acrux-yueyao/Mycelium/design/portfolio/photos/p8-gallery.webp

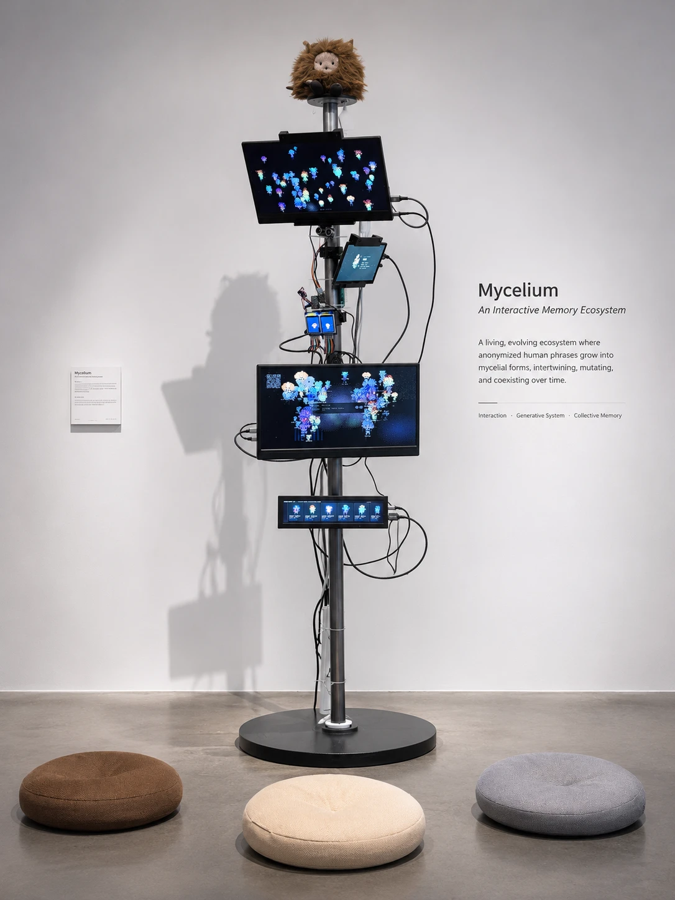
design/portfolio/photos/p8-gallery.webp
