acrux-yueyao/Mycelium/design/portfolio/photos/p7-board.jpg

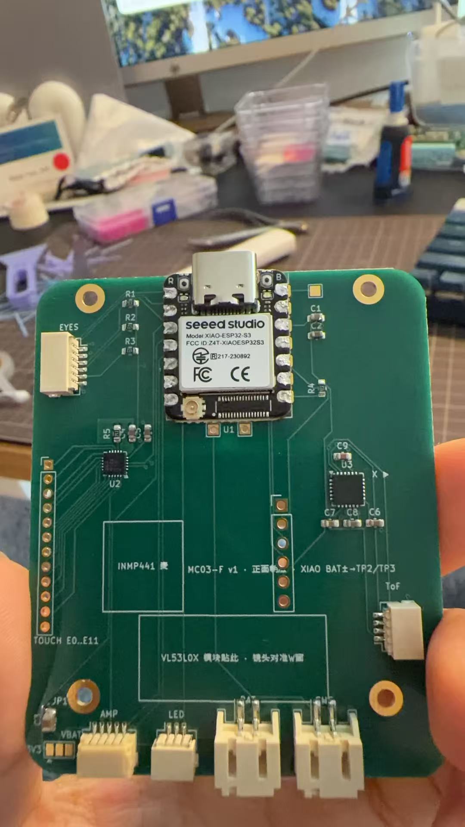
design/portfolio/photos/p7-board.jpg
