acrux-yueyao/Mycelium/hardware/TOUCH.md

# 触摸方块 · 怎么做、怎么装

> **实物是网页孢子的镜像。** 方块模型的轴是(x, 前, 上)左手系,打印出来的每颗方块把“前”朝你、“上”朝上时,刻 S 的面在你**左手**边。
> 所以**拼装时站在机器人背后**(脸朝远处),这时刻 S 的面朝你的右手/远处/上,刻 N 朝左手/近处/下,和逐层图一致。
> 从收纳盘拿方块:抬起远离你的那一边,把它向你翻 90° 立起来,左右不变。
> 麦克风孔 M 因此取在舱区第 4 列(网页坐标),实物落在面对机器人时的左边,正对脸板上 x=−12 的麦克风框。

触摸点由 `touch_plan.py` 按身体部位自动选格、自动找隐藏走线;`touch_cubes.py` 把走线经过的
每颗方块出成**两件式**零件。所有零件的磁铁袋、销钉、刻字与原方块相同,拼好后和普通方块一样,
拼装序号也不变——**拿到同序号的位置替换即可**。

## 1 · 三种零件

| 件 | 长什么样 | 做什么 |
|---|---|---|
| **Tlid 触摸盖** | 12×12×1.2 的薄片,外面是触摸面(光面) | 内侧贴铜箔,铜箔就是电极 |
| **Tbody 触摸身** | 10.8 高,中间 6.6×6.6 的腔朝盖那面开口;腔到出线面有 1 mm 宽的槽(侧面出线)或 Ø1.2 的孔(背面出线) | 腔里走线,盖合上后线从槽里出去 |
| **LA / LB 线槽半块** | 一颗方块从中间剖成两半,LA 的剖面上刻一圈 1 mm 槽,槽到每个进出线面有支槽;走剖面方向的线用角上的 Ø1.2 孔 | 线放进槽,两半合上 |

线用 **0.3 mm 漆包线**(QA 自粘漆包线更好,烙铁一烫就通),一条槽能并排放三根。

## 2 · 装一颗触摸块

1. 剪一块约 6×6 mm 的铜箔(自带胶的),贴在**盖的内侧**正中。
2. 漆包线一头烫掉漆皮,焊在铜箔上(或用导电胶/压在铜箔胶下),留 2 mm 焊点别凸起。
3. 线从腔里顺着槽走出出线面;出线面在 `fix_manifest.txt` 每行都写了(例:`出线-z/后`)。
4. 盖的四边涂一圈薄 CA 胶,合到身上,对齐边缘按 10 秒。盖是哪一面:`fix_manifest.txt` 写了“盖=触摸面 +z/前”这种。
5. 磁铁按盘面图照常装(盖上没有磁铁袋,袋都在身上)。

## 3 · 装一颗线槽块

1. 看 `fix_manifest.txt`:`线进出 -x/左/+x/右` = 线从左面进、右面出;`剖面垂直于上轴` = 两半是上下叠。
2. 线沿着 LA 剖面上的槽从进线面走到出线面;要经过角上的孔时,从孔穿到另一面。
3. 剖面涂 CA 胶(避开槽),LB 合上,对齐四边。
4. 侧面的磁铁袋是被剖成两个半圆的,**合上以后再装磁铁**。极性照盘面图,两个半块的图上都标了同一颗袋。

## 4 · 走线顺序(moony)

`touch_plan.png` 是全图,`fix_manifest.txt` 是清单。要点:
- 拼身体时按正常序号拼,遇到线槽块/触摸块先把线穿好、胶合、装磁铁,再放到位。
- 线的另一头一路走到机身空腔,接到脸板 J7 的对应焊盘(E0–E11 = 触摸点编号顺序,见 `touch_plan.json`)。
- 头部的线(头顶、伞盖左右缘、额头)共用一条主干进空腔,线上贴个纸标签写编号。
- 背后(触摸点 10)不用方块:铜箔贴在背板内侧上半部,线直接到 J7。

## 5 · 重打清单(moony v6)

`fix_manifest.txt` 列了全部 38 件,按耗材分盘:9 颗触摸块(18 件)、8 颗线槽块(16 件)、
4 颗 ToF/麦克风换位置的方块。盘面图 `fix_<色号>_<色名>_1_sheet.png` 和以前一样读:粗体序号、
右上件名、圆和边块是**这一件上**的磁铁袋极性。

打印:全部平放,剖面/盖面朝下,不需要支撑。槽和孔都在贴床那一面,象腿补偿照旧 0.1。

## 6 · 固件侧

MPR121 的 12 路在脸板 J7 上;IRQ 没接,固件按 50 Hz 轮询 `0x00/0x01` 触摸状态寄存器。
每个电极隔着 1.2 mm PLA,灵敏度用寄存器 `0x41–0x5A` 的触发/释放阈值调(先试 12/6)。
