acrux-yueyao/Mycelium/design/portfolio/Mycelium_Portfolio_EN.pdf

M Y C E L I U M · P O R T F O L I O · 2 0 2 4 — ∞

Try it | Research ▸ (https://mycelium.yueyao.design/research) | Case study ▸ (https://mycelium.yueyao.design/case) | Design system ▸ (https://mycelium.yueyao.design/board)

A L I V I N G A R C H I V E O F A N O N Y M O U S F E E L I N G · 低 语 菌 网

# Mycelium

## whisper a sentence — a creature grows from how it feels

An anonymous whisper is read by a language model and grown
into a one-of-a-kind pixel spore, then let loose in a shared colony where everyone's feelings meet and slowly rub off on each other. The same sentence always grows the same spore.

ember drift
TENDER

calm bell
CALM

sunny crumb
CURIOUS

moony moth
DREAMY

mint pip
COMPANION

quiet wisp
LONELY

P R O B L E M
Young adults in
transition are easy to
reach online but often
feel disconnected.
Platforms surface
content, not how a
group actually feels.

A P P R O A C H
Turn anonymous
disclosure into a
living ecology: input →
AI reading → morphology
→ social simulation →
shared field.

C O N T R I B U T I O N
A way to feel present
with others without
talking — connection
shown as colour
exchange, care built in
as an ecological rule,
identity fixed as
deterministic form.

R O L E & S T A T U S
Concept, design & full-stack build · deployed
web prototype ·
formative evaluation in
progress.

# ✳ Why “Mycelium”

The whole thing borrows from mycorrhizal networks — the underground web of fungal threads (the mycelium) that links the trees of a forest, sometimes called the “wood-wide web.” Through it, trees quietly trade sugar and nutrients, pass chemical signals, and older mother trees keep seedlings alive. It's connection that is slow, shared, and out of sight — the opposite of a feed. Below is the real network it's named after — every claim cited:

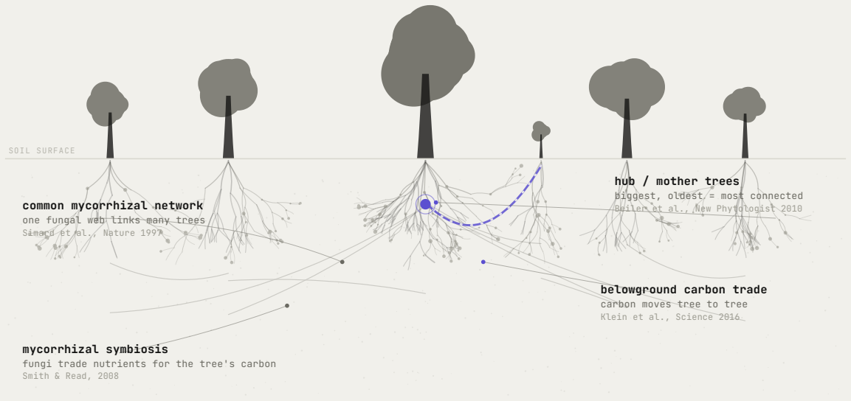
[picture p10: figure]
SOIL SURFACE; common mycorrhizal network one fungal web links many trees Simard et al., Nature 1997; hub / mother trees biggest, oldest = most connected Beiler et al., New Phytologist 2010; belowground carbon trade carbon moves tree to tree Klein et al., Science 2016; mycorrhizal symbiosis; Smith & Read, 2008

fungi trade nutrients for the tree's carbon

Real mycorrhizal science, cited: Simard et al., Nature 388:579 (1997) (https://www.nature.com/articles/41557) · Klein, Siegwolf & Körner, Science 352:342 (2016) (https://www.science.org/doi/10.1126/science.aad6188) · Beiler et al., New Phytologist 185:543 (2010) (https://nph.onlinelibrary.wiley.com/doi/10.1111/j.1469-8137.2009.03069.x) · Smith & Read, Mycorrhizal Symbiosis (2008).

MYCELIUM The Whisper Network · Portfolio · Yue Yao | 1 / 7

Read the forest as a community and the biology stops being about trees. A community is a place where what you have is quietly shared — the surplus of one becomes another's survival, the oldest hold up the youngest, and none of it has to be announced to count.

I N A F O R E S T | I N A C O M M U N I T Y
fungi trade nutrients for the tree's carbon | members sustain each other — no score kept
carbon flows from surplus to deficit | the ones who have more carry the ones who don't
mother trees keep the seedlings alive | you're held by the ones who came before
slow, shared, out of sight | belonging is felt, never performed

That feeling — being quietly held by a group you never had to perform for — is exactly what loneliness is the absence of. It's what Mycelium tries to hand back: a place to be present with others without a single word of explanation.

01 Try it — grow a spore right here | 02 What it is
| It isn't a mood diary, an AI companion, or a feed. It's a small shared world where private feelings stick around as living creatures. Everything here is procedural — no drawn sprites, no image model. The reading of a sentence seeds a deterministic random stream, and that stream decides the creature's outline, palette, sharpness and behaviour. So an anonymous feeling turns into something you can name, claim, share and come back to, without ever attaching who you are. whisper one sentence anonymous · text or voice

read

AI interprets

emotion labels ·
intensity ·
morphology

grow

a pixel spore

deterministic ·
unique

meet

the colony

bonds shown as
colour exchange

stay

it accumulates

a cross-visitor
emotional ecology

M Y C E L I U M · T R E E H O L E 树 洞 — T Y P E A N Y T H I N G , I N A N Y L A N G U A G E

today, my heart feels like a quiet lake after rain grow ▸

# Misty Pudding

S P E C I M E N

emotion | calm · 平静
intensity | 0.79
hue | H 220°
determinism | same sentence → same spore

This preview reads your sentence into one of the six families with a lightweight offline heuristic (keyword + hash) and shows that family's real specimen — the same pixels the live colony grows. In the deployed product, Claude reads the sentence into 18 emotion labels, intensity and six morphology parameters, and grows the exact, unique creature. Grow your own on the live site ▸ (https://yueyao.design/)

# 03 The deployed experience

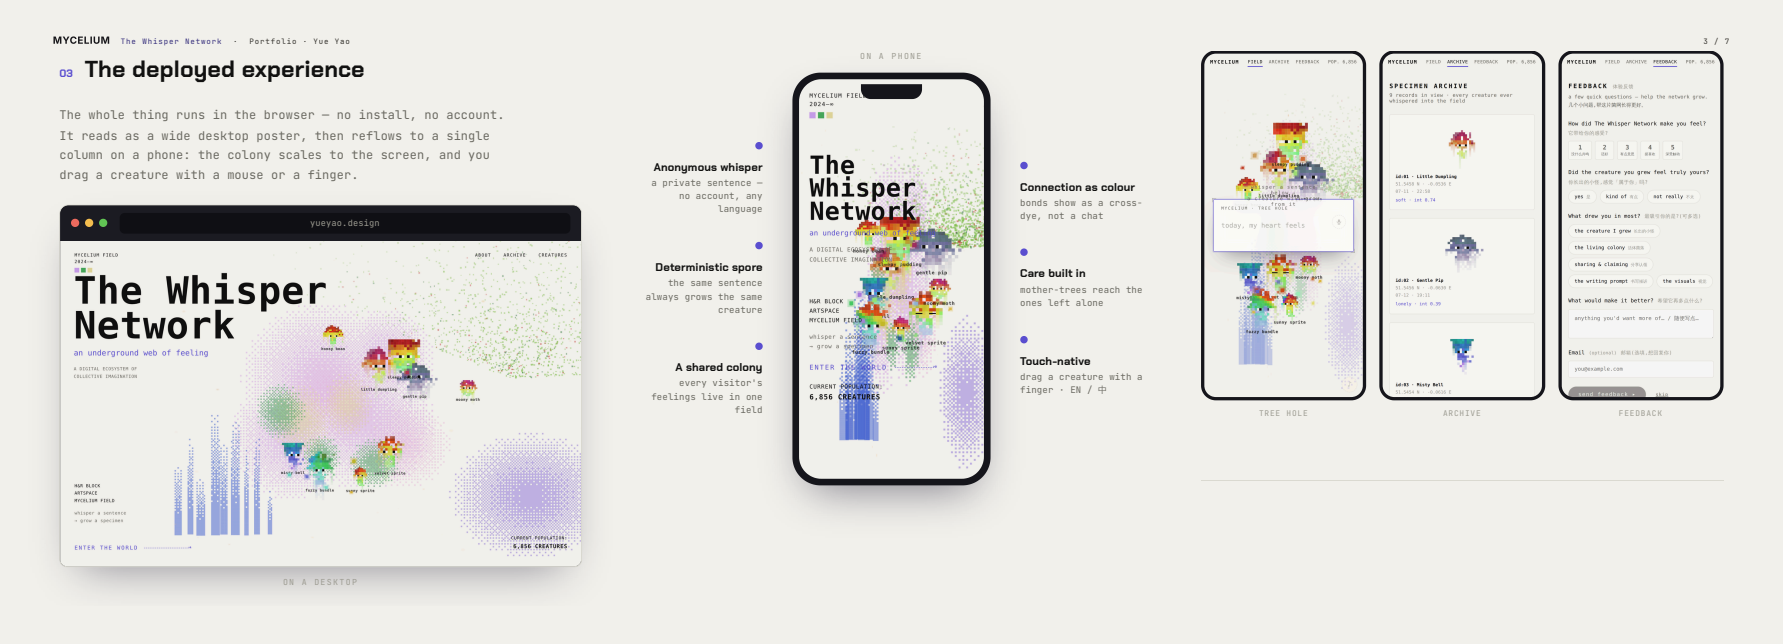
[picture p11: page 3]
yueyao.design; Anonymous whisper; a private sentence —; no account,; any; language; creature; A shared colony; every visitor's; feelings live in; one; field; TREE HOLE; ARCHIVE; FEEDBACK

The whole thing runs in the browser — no install, no account.
It reads as a wide desktop poster, then reflows to a single
column on a phone: the colony scales to the screen, and you
drag a creature with a mouse or a finger.

Connection as colour
bonds show as a cross-
dye, not a chat

Deterministic spore
the same sentence
always grows the same

Care built in
mother-trees reach the
ones left alone

Touch-native
drag a creature with a
finger · EN / 中

# 04 Emotion becomes form

Every whisper is read into one of six emotion families, each with its own base hue. Then the reading bends the form: intensity widens the palette from near-monochrome to rainbow, density sets how solid it is, agitation sets the jitter, and a second emotion blends in one accent. Same sentence, same creature — but no two feelings land the same.

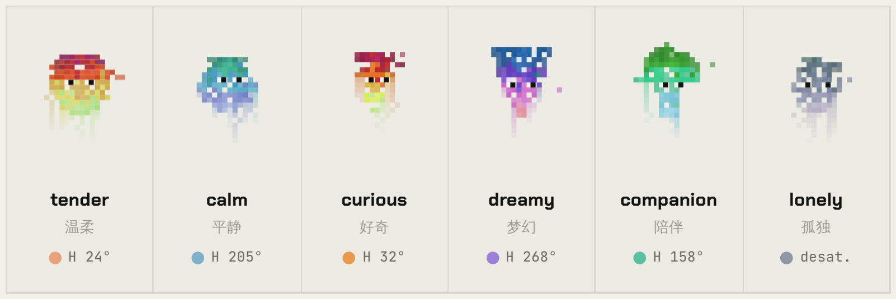
[picture p12: figure]
tender; calm; curious; dreamy; companion; lonely; desat.
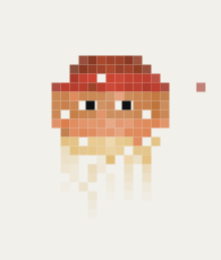
[picture p13: figure]

low
near-monochrome

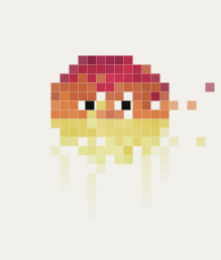
[picture p14: figure]

mid
a few accents

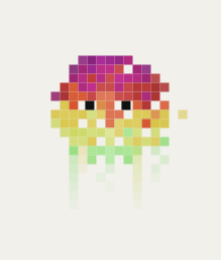
[picture p15: figure]

high
full rainbow
intensity → palette width | density → solid vs. wispy | agitation → jitter & drift

2nd emotion → one accent hue

# 05 How the creatures evolved

They didn't start as pixels. The first build shipped six illustrated species — soft watercolour fungi — plus fifteen hand-drawn hybrid forms. It was lovely, and it read wrong: with a fixed image library, two very different sentences could wear the same body. Emotion had become a label that picks a sticker.

radial
v1 ·
illustration

fixed sprite

bubble
v1 ·
illustration

fixed sprite

mushroom
v1 ·
illustration

fixed sprite

glitter
v1 ·
illustration

fixed sprite

cups
v1 ·
illustration

fixed sprite

shrub
v1 ·
illustration

fixed sprite

hybrid A×B
one of 15, drawn by
hand

hybrid C×E
every pair pre-decided

hybrid D×F
finite by construction

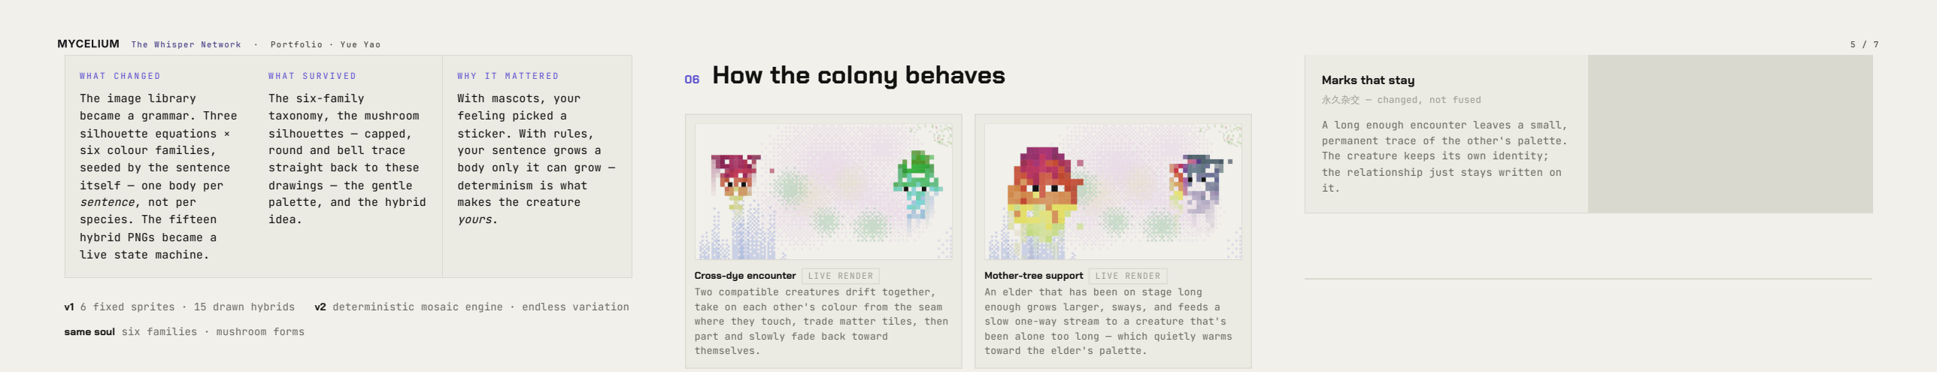
[picture p16: figure]
The image library became a grammar. Three silhouette equations × six colour families, seeded by the sentence itself — one body per sentence, not per species. The fifteen hybrid PNGs became a live state machine.; The six-family taxonomy, the mushroom silhouettes — capped, round and bell trace straight back to these drawings — the gentle palette, and the hybrid idea.; With mascots, your feeling picked a sticker. With rules, your sentence grows a body only it can grow — determinism is what makes the creature yours.; same soul six families · mushroom forms; 06 How the colony behaves; Cross-dye encounter; LIVE RENDER; part and slowly fade back toward themselves.; Mother-tree support; An elder that has been on stage long enough grows larger, sways, and feeds a; toward the elder's palette.; Marks that stay; 永久杂交 — changed, not fused; A long enough encounter leaves a small, permanent trace of the other's palette. The creature keeps its own identity; the relationship just stays written on it.

v1 6 fixed sprites · 15 drawn hybrids v2 deterministic mosaic engine · endless variation

Two compatible creatures drift together, take on each other's colour from the seam where they touch, trade matter tiles, then

slow one-way stream to a creature that's been alone too long — which quietly warms

Connection as colour

逐格染色 — a tendril in colour, not a line

When two compatible creatures meet, they dye each other starting from where they touch — strongest at the contact seam — and pass small matter tiles back and forth while bonded, breathing in sync.

Mother trees

母树 — care as an ecological rule

A creature that has been around long enough starts supporting an isolated one: it grows visibly larger, sways, flickers, and feeds it a slow one-way stream of matter. Nothing you press sets this off.

# 07 The research behind it

RQ·main — how might anonymous emotional input become a perceivable, evolving collective emotional environment?

RQ2 — expression without public performance

RQ3 — AI as rule generator, not companion

RQ4 — emotion mapped to form, behaviour, relation

It draws on loneliness research (U.S. Surgeon General 2023; Baek et al. 2023), a critique of affective computing, and care-oriented design research (Hirsch). The full framing, methods, ethics and the sourced data sit in the research essay and case study — linked below.

# 08 From screen to substrate

The whisper doesn't have to stop at the screen. In the gallery installation, the colony's pooled emotion drives a living fungus, so the same anonymous sentence sets the growing conditions for a real culture. The software bridge is built
and live; the physical cultivation is specced and staged.
whisper feeds the culture each sentence → one visible feeding pulse: mist + a light pulse in its emotion's hue | /api/pulse aggregate climate dominant mood → grow-light hue · intensity → mist · growth → cadence | chamber a living fungus sealed, HEPA-filtered · food-safe low-spore species | /api/bio the loop closes the fungus's biosignal feeds back — the projected colony breathes with it
D A T A , N O T D E C O R A T I O N population, intensity, dominant family, agitation, loneliness — real aggregates from the live colony set real environment targets. (https://mycelium.yueyao.design/mycelium-poster.pdf) | | H O N E S T & S A F E the projection shows only the emotion reading, never the sentence; biosafety is designed in for a weeks-long gallery run. (https://mycelium.yueyao.design/mycelium-poster.pdf)

# 09 Read the full record

This page is the short version. The deeper documents carry the rest — the research it grew from, the full design-research write-up, the visual system that holds it together, and two printable artifacts.

01 · RESEARCH

### Research & background

前期调研 · 背景故事
The loneliness
research, the platform
critique, and the
sourced data behind the
project — as a
scrollable visual
essay.

open the essay ▸ (https://mycelium.yueyao.design/research)

02 · CASE STUDY

### Design-research case study

完整案例研究 · EN / 中
The full framing,
method, decisions,
ethics, and evaluation
— the long-form account
of how it was made and
why.

open the case study ▸ (https://mycelium.yueyao.design/case)

03 · DESIGN SYSTEM

### The visual language

设计系统板
Colour families, type,
the deterministic spore
grammar, and the motion
rules — the board that
keeps every screen
consistent.

open the board ▸ (https://mycelium.yueyao.design/board)

04 · POSTER

### Research poster, 7 sheets

横版研究海报 · PDF
The whole project on
seven 2160×780
landscape sheets —
background, evidence, (https://mycelium.yueyao.design/mycelium-poster.pdf)

05 · INSTALLATION

### Installation design manuscript

装置设计手稿 · PDF
Five drawing sheets for
the gallery build —
site plan, elevations,
axon cutaway, and the (https://mycelium.yueyao.design/installation-manuscript.pdf)

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
▸ (https://mycelium.yueyao.design/mycelium-poster.pdf)

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
▸ (https://mycelium.yueyao.design/installation-manuscript.pdf)

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
o (https://mycelium.yueyao.design/mycelium-poster.pdf)

r

k (https://mycelium.yueyao.design/installation-manuscript.pdf)

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
b (https://mycelium.yueyao.design/mycelium-poster.pdf)

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
u (https://mycelium.yueyao.design/installation-manuscript.pdf)

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
s (https://mycelium.yueyao.design/mycelium-poster.pdf)

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
. (https://mycelium.yueyao.design/installation-manuscript.pdf)
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
