acrux-yueyao/Mycelium/design/portfolio/Mycelium_Portfolio_ZH.pdf

# ✳ 为什么叫「Mycelium」

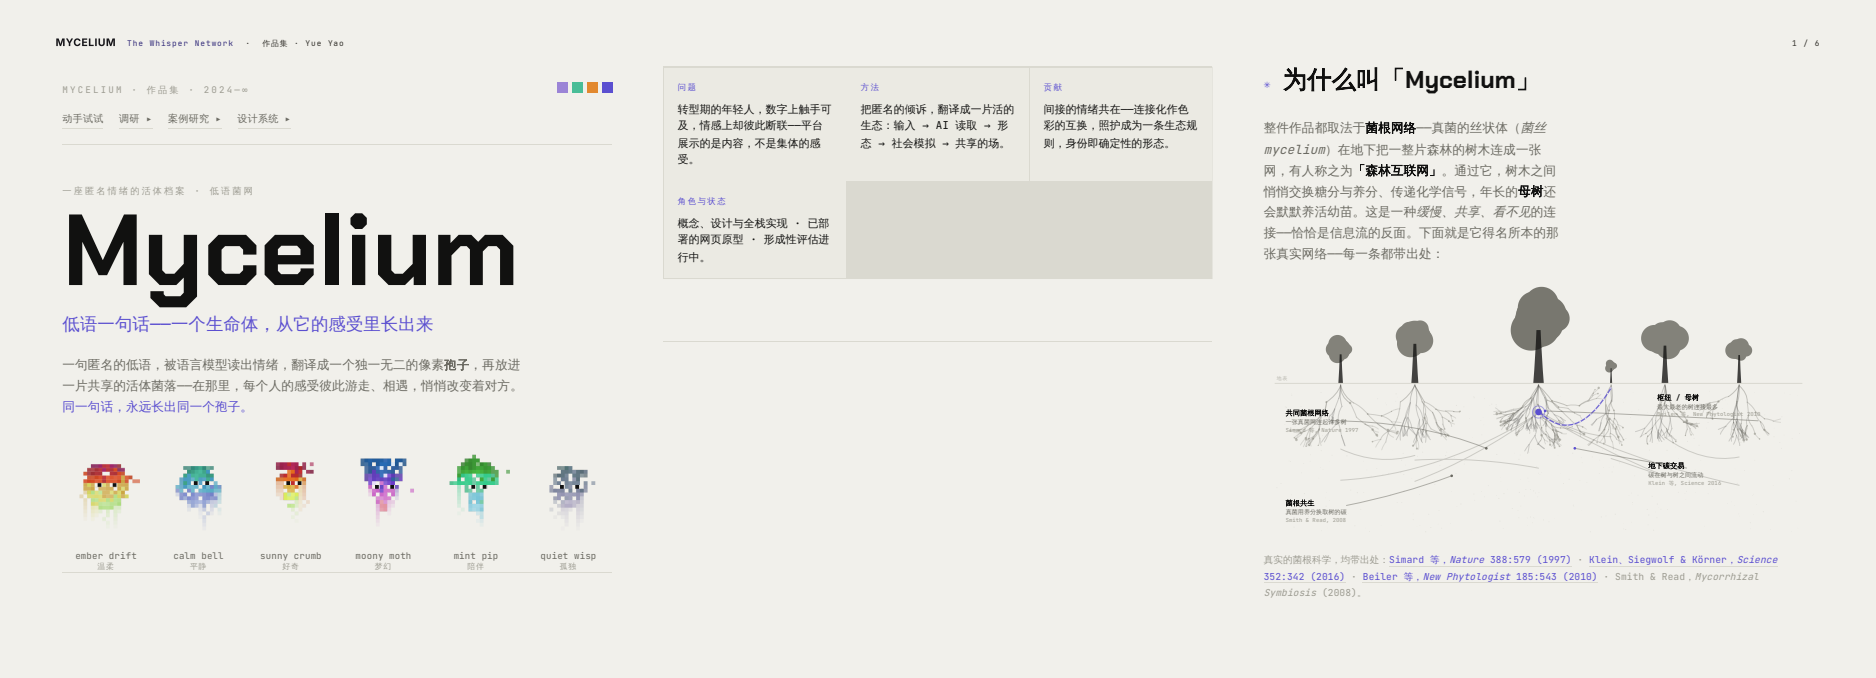
[picture p17: page 1]
动手试试; 案例研究 ▸; 设计系统 ▸; 一 座 匿 名 情 绪 的 活 体 档 案 · 低 语 菌 网 Mycelium; ember drift 温柔; calm bell 平静; sunny crumb 好奇; moony moth 梦幻; mint pip 陪伴; quiet wisp 孤独; 问 题 转型期的年轻人，数字上触手可 及，情感上却彼此断联——平台 展示的是内容，不是集体的感 受。; 贡 献 间接的情绪共在——连接化作色 彩的互换，照护成为一条生态规 则，身份即确定性的形态。; 共同菌根网络 一张真菌网连起许多树 Simard 等, Nature 1997; 地下碳交易 碳在树与树之间流动 Klein 等, Science 2016; 菌根共生 真菌用养分换取树的碳 Smith & Read, 2008; MYCELIUM The Whisper Network · 作品集 · Yue Yao

把匿名的倾诉，翻译成一片活的
态 → 社会模拟 → 共享的场。

整件作品都取法于菌根网络——真菌的丝状体（菌丝
mycelium）在地下把一整片森林的树木连成一张
网，有人称之为「森林互联网」。通过它，树木之间
悄悄交换糖分与养分、传递化学信号，年长的母树还
会默默养活幼苗。这是一种缓慢、共享、看不见的连
接——恰恰是信息流的反面。下面就是它得名所本的那
张真实网络——每一条都带出处：

概念、设计与全栈实现 · 已部
署的网页原型 · 形成性评估进

低语一句话——一个生命体，从它的感受里长出来

一句匿名的低语，被语言模型读出情绪，翻译成一个独一无二的像素孢子，再放进
一片共享的活体菌落——在那里，每个人的感受彼此游走、相遇，悄悄改变着对方。
同一句话，永远长出同一个孢子。

最大最老的树连接最多
Beiler 等, New Phytologist 2010

真实的菌根科学，均带出处：Simard 等，Nature 388:579 (1997) (https://www.nature.com/articles/41557) · Klein、Siegwolf & Körner，Science
352:342 (2016) (https://www.science.org/doi/10.1126/science.aad6188) · Beiler 等，New Phytologist 185:543 (2010) (https://nph.onlinelibrary.wiley.com/doi/10.1111/j.1469-8137.2009.03069.x) · Smith & Read，Mycorrhizal
Symbiosis (2008)。

把森林当作一个共同体来读，这套生物学就不再只是
关于树。共同体，是一个你所拥有的会被悄悄分出去
的地方——一个的盈余，成为另一个的存活；最年长
的，托住最年幼的；而这一切都不必被宣告，才算
数。
在森林里 | 在一个共同体里
真菌用养分交换树的碳 | 成员彼此供养——不计得失
碳从盈余流向匮乏 | 有余的人，托住匮乏的人
母树养活幼苗 | 你被先来的人托住
缓慢、共享、看不见 | 归属是被感到的，从不表演

这种感觉——被一个你从不需要表演的群体悄悄托住——
恰恰是孤独所缺席的。这也正是 Mycelium 想还给 人的：一个不必解释一句，也能与他人同在的地方。
01 试试——在这里长出一个孢子 | 02 它是什么
| 不是心情日记，不是 AI 陪伴，也不是信息流——是一个小小的共享世 界，私人的感受在这里以活的生命体留存下来。
| 你看到的一切都是程序生成的：没有手绘素材，没有图像模型。一句话的读数，播下一 条确定性的随机流，长出轮廓、配色、清晰度和行为——于是一份匿名的感受，变成你 可以命名、认领、分享、回访的东西，却从不需要附上你是谁。

低语
一句话

匿名 · 文字或语音

读取
AI 解读

情绪标签 · 强度 · 形
态

生长
一个像素孢子

确定性 · 独一无二

相遇
遇见菌落

结伴以色彩互换呈现

留存
不断累积

一片跨访客的情绪生态

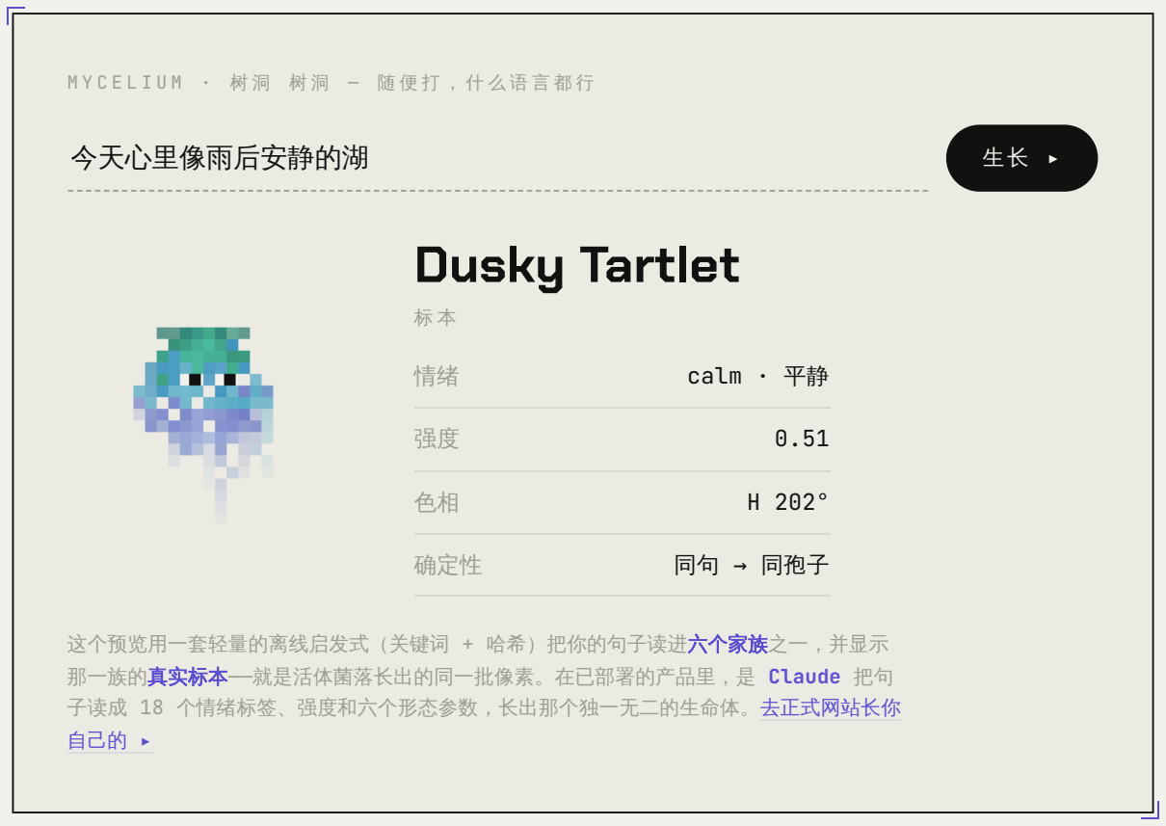
[picture p18: figure]
今天心里像雨后安静的湖; Dusky Tartlet; calm · 平静; 确定性; 同句 → 同孢子; 这个预览用一套轻量的离线启发式（关键词 + 哈希）把你的句子读进六个家族之一，并显示 那一族的真实标本——就是活体菌落长出的同一批像素。在已部署的产品里，是 Claude 把句 子读成 18 个情绪标签、强度和六个形态参数，长出那个独一无二的生命体。去正式网站长你 自己的 ▸

M Y C E L I U M · 树 洞 树 洞 — 随 便 打 ， 什 么 语 言 都 行

## 03 已部署的体验

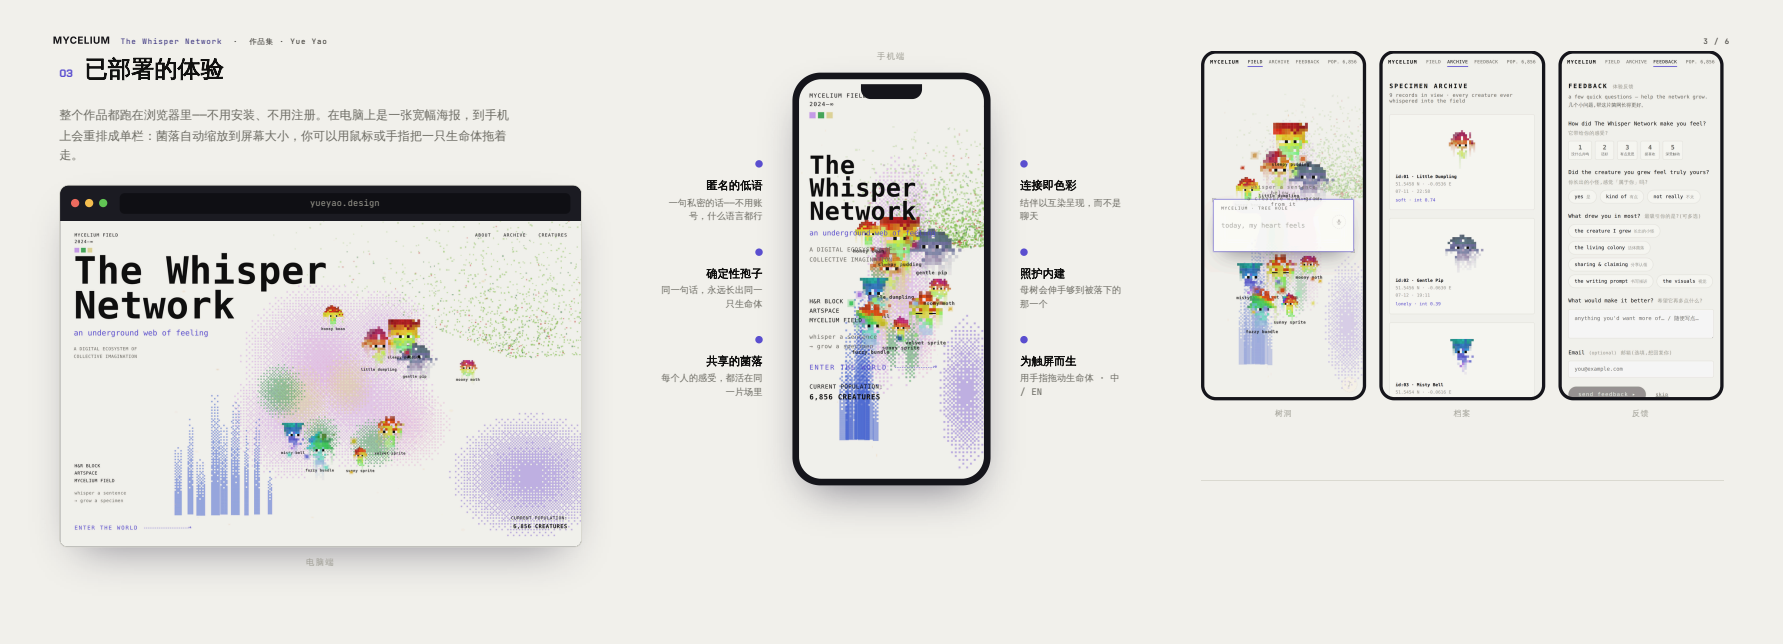
[picture p19: page 3]
yueyao.design; 电脑端; 手机端; 匿名的低语 一句私密的话——不用账 号，什么语言都行; 确定性孢子 同一句话，永远长出同一 只生命体; 共享的菌落; 每个人的感受，都活在同 一片场里; 连接即色彩; 结伴以互染呈现，而不是 聊天; 照护内建 母树会伸手够到被落下的 那一个; 为触屏而生 用手指拖动生命体 · 中 / EN

整个作品都跑在浏览器里——不用安装、不用注册。在电脑上是一张宽幅海报，到手机
上会重排成单栏：菌落自动缩放到屏幕大小，你可以用鼠标或手指把一只生命体拖着

## 04 情绪化作形态

每一句低语，都被读进六个情绪家族之一，各有自己
的基准色相。随后读数再去掰弯形态：强度把配色从
近乎单色拉宽到彩虹，密度决定它有多实，躁动决定

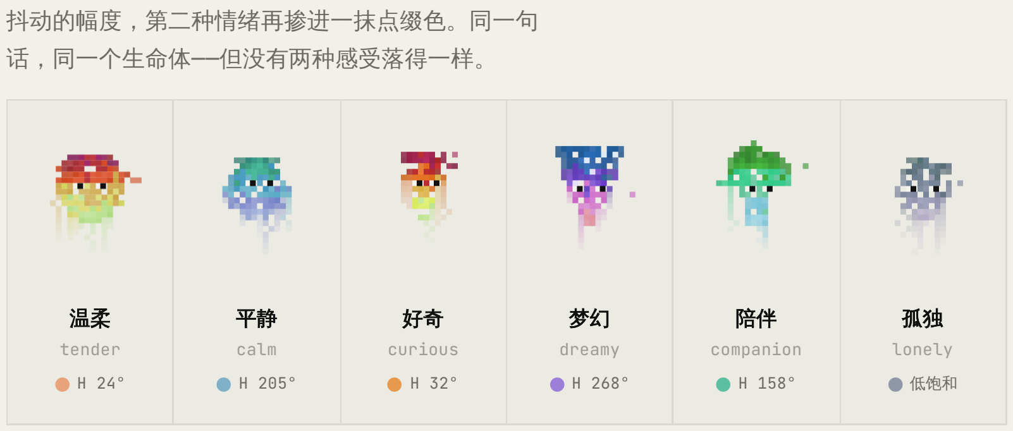
[picture p20: figure]
抖动的幅度，第二种情绪再掺进一抹点缀色。同一句 话，同一个生命体——但没有两种感受落得一样。; tender; calm; curious; dreamy; companion; lonely; 低饱和
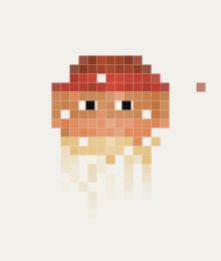
[picture p21: figure]

低
近乎单色

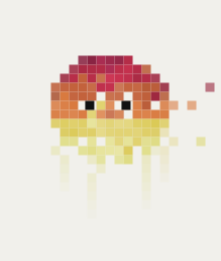
[picture p22: figure]

中
几笔点缀

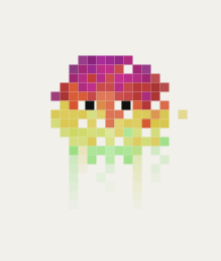
[picture p23: figure]

高
整片彩虹
强度 → 配色宽度 | 密度 → 实心 / 稀薄 | 躁动 → 抖动与游走 | 第二情绪 → 一抹点缀色

### 05 生命体的演化

它们并不是一开始就长成像素的。第一版上线的是六
个手绘物种——柔软的水彩真菌——外加十五张预先画好
的杂交形态。它很好看，但读起来是错的：素材库是
固定的，两句完全不同的话可能穿着同一副身体。情
绪变成了一个用来挑贴纸的标签。

radial
v1 · 手绘
固定素材

bubble
v1 · 手绘
固定素材

mushroom
v1 · 手绘
固定素材

glitter
v1 · 手绘
固定素材

cups
v1 · 手绘
固定素材

shrub
v1 · 手绘
固定素材

杂交 A×B
十五张之一，逐张手绘

杂交 C×E
每一对都预先决定

杂交 D×F
数量天生有限

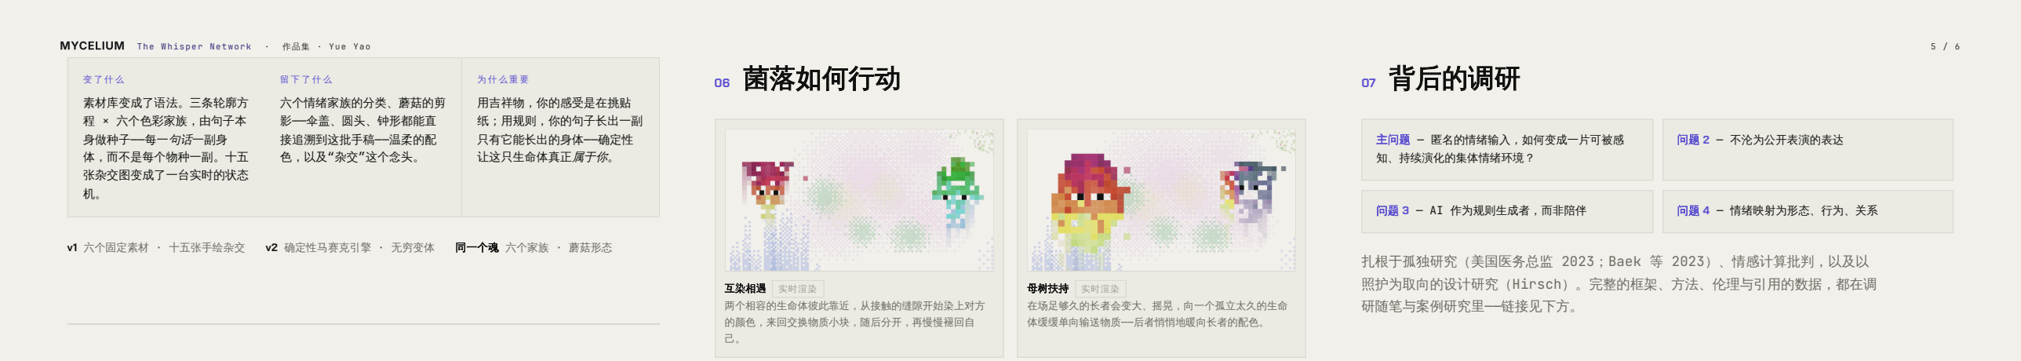
[picture p24: figure]
变 了 什 么 素材库变成了语法。三条轮廓方 程 × 六个色彩家族，由句子本 身做种子——每一句话一副身 体，而不是每个物种一副。十五 张杂交图变成了一台实时的状态 机。; 留 下 了 什 么 六个情绪家族的分类、蘑菇的剪 影——伞盖、圆头、钟形都能直 接追溯到这批手稿——温柔的配 色，以及“杂交”这个念头。; 为 什 么 重 要 用吉祥物，你的感受是在挑贴 纸；用规则，你的句子长出一副 只有它能长出的身体——确定性 让这只生命体真正属于你。; 06 菌落如何行动; 互染相遇; 实时渲染; 两个相容的生命体彼此靠近，从接触的缝隙开始染上对方 的颜色，来回交换物质小块，随后分开，再慢慢褪回自 己。; 母树扶持; 在场足够久的长者会变大、摇晃，向一个孤立太久的生命 体缓缓单向输送物质——后者悄悄地暖向长者的配色。; 07 背后的调研; 主问题 — 匿名的情绪输入，如何变成一片可被感 知、持续演化的集体情绪环境？; 问题 2 — 不沦为公开表演的表达; 研随笔与案例研究里——链接见下方。

v1 六个固定素材 · 十五张手绘杂交 | v2 确定性马赛克引擎 · 无穷变体 | 同一个魂 六个家族 · 蘑菇形态
连接即色彩 逐格染色 ——用颜色长出的触手，不是一根线 相容的生命体相遇，从接触缝开始彼此染色——触点处 最浓——结伴时来回交换小块物质，还同步呼吸。 | 母树 母树 ——照护作为一条生态规则 一个正在扶持孤立者的长者，会明显变大、摇晃、闪 烁——并向它单向地缓缓输送物质。没有哪个按钮能触 发照护。

留下的痕迹 永久杂交 ——被改变，而非被融合 一场长久的相遇，留下对方配色的一小块永久痕迹。 身份始终存续；关系被记在身上。

问题 3 — AI 作为规则生成者，而非陪伴 | 问题 4 — 情绪映射为形态、行为、关系

扎根于孤独研究（美国医务总监 2023；Baek 等 2023）、情感计算批判，以及以 照护为取向的设计研究（Hirsch）。完整的框架、方法、伦理与引用的数据，都在调

## 08 从屏幕，到基质

低语不必止于屏幕。在画廊装置里，菌落聚合出的情绪，驱动一团活的真菌——同一句 匿名的话，成为一团真实培养的生长条件。软件桥已构建并上线；实体培养已规格化、 分阶段推进。

低语 喂养培养 每句话 → 一次可见的投 喂脉冲：一口雾 + 一道 该情绪色相的灯光 | /api/pulse 聚合气候 主导情绪 → 生长灯色相 · 强度 → 雾化 · 增长 → 节律 | 培养舱 一团活真菌 密封、HEPA 过滤 · 食 品级低孢子菌种 | /api/bio 回路闭合 真菌的生物信号回传——投 影的菌落随它一起呼吸
是 数 据 ， 不 是 装 饰 人口、强度、主导家族、躁动、孤独——来自活体菌 落的真实聚合，设定真实的环境目标。 | | 诚 实 且 安 全 投影只显示情绪读数，绝不显示原句；生物安全为 数周展期从头设计。

## 09 读完整的记录

这一页是精简版。剩下的都在更深的文档里——它生长自的调研、完整的设计研究记 述、把一切串起来的视觉系统，以及两份可打印的成品。

01 · 调研
前期调研与背景

Research & background
孤独研究、平台批判，以及项
目背后引用的真实数据——做成
一篇可滚动的视觉随笔。

打开随笔 ▸ (https://mycelium.yueyao.design/research-zh)

02 · 案例研究
设计研究案例
完整案例 · EN / 中
完整的框架、方法、决策、伦
理与评估——它如何被做出来、
为什么这样做的长篇记述。

打开案例研究 ▸ (https://mycelium.yueyao.design/case-zh)

03 · 设计系统
视觉语言
设计系统板
配色家族、字体、确定性的孢
子语法，以及动效规则——让每
一屏都保持一致的那块板。

打开设计板 ▸ (https://mycelium.yueyao.design/board-zh)

04 · 海报
横版研究海报 · 七页

Research poster · PDF
整个项目排在七张 2160×780
的横版页上——背景、数据、系
统、生命体、评估——用的就是
网站自己的视觉语言。

下载 PDF ▸ (https://mycelium.yueyao.design/mycelium-poster.pdf)

05 · 装置
装置设计手稿

Installation manuscript ·
PDF
画给展场搭建的五张图纸——平
面、立面、轴测剖切，以及那
间与菌落一同呼吸的活体培养
舱。

下载 PDF ▸ (https://mycelium.yueyao.design/installation-manuscript.pdf)

MYCELIUM · 低语菌网

概念 · 设计 · 全栈实现 — React · canvas 2D · Claude · Edge · Redis。 同一句话，永远长出同一个孢子。
本页每一个标本，都由产品自己的引擎渲染——就是活体菌落长出的同一批像素。
