acrux-yueyao/Mycelium/design/market/Mycelium_纸质问卷.pdf

留下这段经历 LEAVE AN ACCOUNT | 表号 No.

如果你此刻很难受——这张问卷不是求助渠道。请联系你所在地的心理支持热线或校园咨询服务；有紧急危险请拨打当地急救电话。 你写下的内容不会被用来判断你。 美国：拨打或短信 988（危机热线）· 紧急情况：911 · 其他地区：findahelpline.com
If you are struggling right now — this form is not a help channel. Please contact a local support line or campus counseling service; in an emergency, call your local emergency number. Nothing you write here will be used to judge you. In the US: call or text 988 · emergency: 911 · elsewhere: findahelpline.com

这件作品，在你身上留下了什么？ What did this work leave with you?

不用总结好不好——写下它让你想起什么、感到什么、动摇了什么，或者你带走了什么。慢慢写，写一半也没关系。
No need to judge whether it was good. Write what it brought to mind, what you felt, what it unsettled, or what you took away. Take your time; a half-written entry is fine.

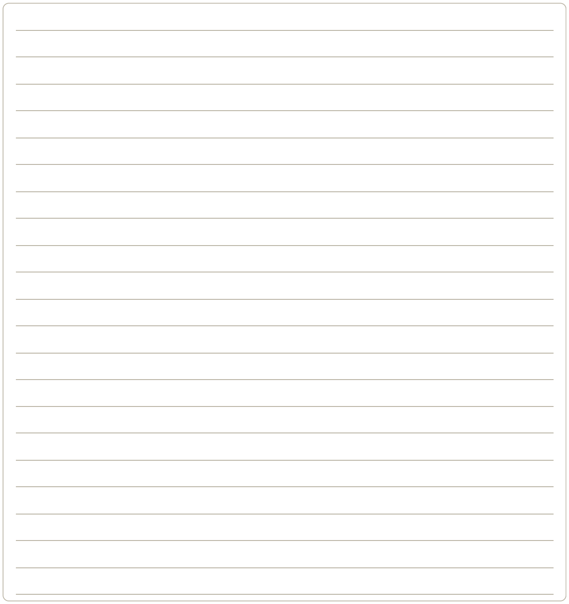
[picture p27: figure]

背面还有几个小问题 · please turn over ▸

写完这一刻，感觉怎么样？ How do you feel right now? 表号 No.

不是评价作品——是此刻你自己的状态。凭直觉圈一个数字。
Not a rating of the work — your own state at this moment. Go with your first instinct: circle one number.

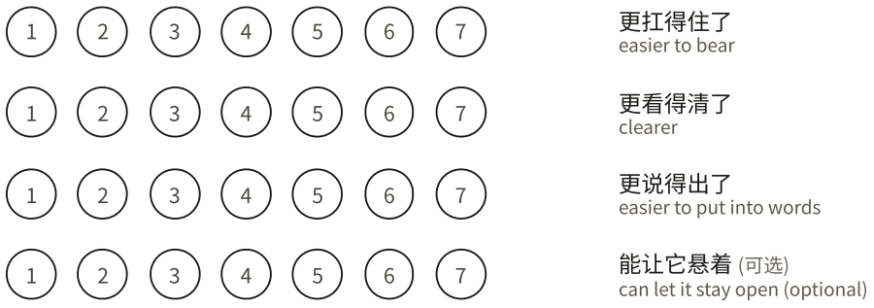
[picture p28: figure]
更扛得住了; easier to bear; 更看得清了; clearer; 更说得出了; easier to put into words; 能让它悬着 (可选); can let it stay open (optional)

更难受了
harder to bear

更糊涂了
more confused

更说不出
harder to put into words

想把它推开
want to push it away

昵称（可选） Nickname (optional)

年龄段（可选） Your age (optional) | 18–29 | 30 及以上 30+ | 不想说 prefer not to say
你正处在一段人生过渡中吗？（可选） In a life transition? (optional) | 是 yes | 否 no | 说不清 hard to say

我已年满 18 岁。
I am 18 or older.

我同意把这段经历作为匿名研究语料使用。纸质问卷不需要写名字；我可以凭下面剪下的小票上的表号，随时写信至 nikkiyao814@gmail.com 要求删除这份记录。参与完全自愿，且须年满 18 岁。这段文字可能被研究者阅读与编码，用于 理解交互作品如何承接观众。
I agree that this account may be used as anonymous research material. No name is needed on this paper form; I can ask for it to be deleted at any time by writing to nikkiyao814@gmail.com with the form number on the slip below. Participation is voluntary and open to those 18 or over. The text may be read and coded by researchers to understand how interactive works accompany their audiences.

两个方框都勾上，这份问卷才会被收录。写完请交给摊位的工作人员，或投进问卷箱。
Both boxes need a tick for the form to be kept. Hand it to the booth or drop it in the box.

### 你的小票 · keep this slip

想删除这份问卷，写信到 nikkiyao814@gmail.com，附上右边的表号就行。
To have your form deleted, write to nikkiyao814@gmail.com with the number on the right.

工作人员：发问卷前在两页的「表号」和小票上写同一个编号。· staff: write the same number on both pages and here.

表号 No.

✂
