acrux-yueyao/Mycelium/design/market/ACRUX-Intermedia-Brochure.pdf

S E R V I C E S — C O N C E P T T O O P E N I N G N I G H T

# Commissions

We take on a small number of commissions at a time and build them end-to-end. If it needs to exist and doesn't yet, that's our department.

A Interactive Installation — sensors, screens, projection, sound, custom software, built to survive an exhibition run.

B Exhibition Design — layout, wayfinding, lighting logic, and the interactive layer that ties a room together.

C Generative & Real-time Visuals — particle systems, simulations, data-driven scenes at 60fps.

D Creative Technology Consulting — feasibility studies, prototyping sprints, honest answers about what can be built.

01 — INQUIRY
The occasion, space,
timeline, budget. A
paragraph is enough.

02 — SCOPING
A call, then a concept +
feasibility doc with a
fixed quote.

03 — BUILD
Prototype first, always.
You see it running early
and often.

04 — INSTALL
On-site install,
calibration,
documentation. We stay
through opening night.

S I G N A L — W E A N S W E R

# Contact

For commissions, exhibitions, press, or anything between media —

## hello@acruxintermedia.com

WORKS · STUDIO
acruxintermedia.com

ELSEWHERE
principal yueyao.design
instagram @acrux.yue
github github.com/acrux-yueyao

ACRUX INTERMEDIA STUDIO LLC BOSTON, MASSACHUSETTS — EST. 2026 α CRUCIS — RA 12h 26m 35s · DEC −63° 05′ 56″

# ACRUX

# INTERMEDIA

### A studio for works that fall between

media.

We build strange, functional artifacts — deities you can summon, bureaucracies run by machines, rooms that whisper — and navigate by them.

EST. 2026 — BOSTON, MA
