acrux-yueyao/Mycelium/design/market/Hyphal-Column-Poster-EN.pdf

BU ART MARKET
YUE YAO · 2026
SKY | MICRO | FIELD | ARCHIVE

# Hyphal

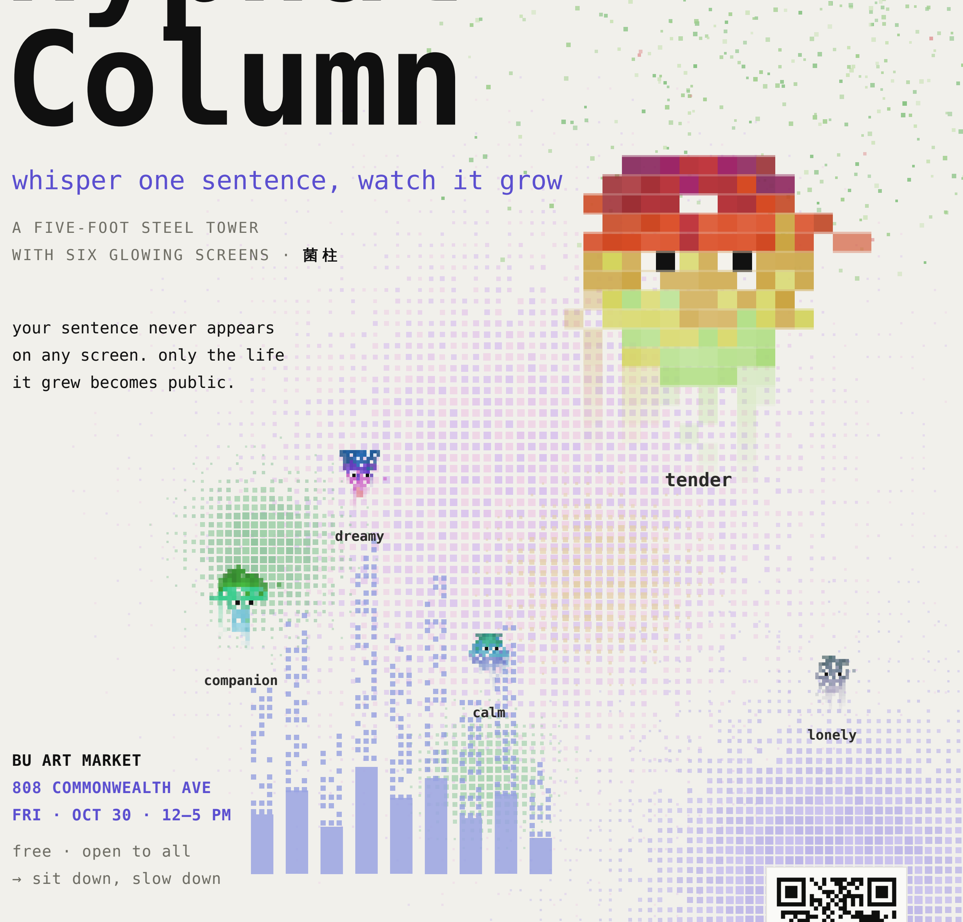
[picture p29: figure]
Column; whisper one sentence, watch it grow; A FIVE-FOOT STEEL TOWER; WITH SIX GLOWING SCREENS · 菌 柱; tender; your sentence never appears on any screen. only the life it grew becomes public.; companion; dreamy; calm; lonely; BU ART MARKET; 808 COMMONWEALTH AVE; FRI · OCT 30 · 12–5 PM; free · open to all; → sit down, slow down

S C A N T O E N T E R T H E W O R L D | →

GROW ONE NOW:
mycelium.yueyao.design
