acrux-yueyao/Mycelium/design/portfolio/source/feedback-2026-10-30.csv

no | time_boston | language | nickname | text | bearable | comprehensible | expressible | acceptance | age | transition | participant | research
1 | 2026/09/09 19:27 |  |  |  |  |  |  |  |  |  |  | no
2 | 2026/10/30 13:11 | en | Dr Kabil | I liked the way you can create a character based on how you feel and it can interact with other mycelium. I would like to see other ways to interact with mycelium. It’s a very creative idea and I love the software super easy to use and very beautiful. | 7 | 7 | 7 | 7 | 18-29 | no |  | no
3 | 2026/10/30 15:29 | en |  | The colors and animations drew me in. I thought that this was such a such a cool concept and the idea of people influencing each other being depicted as "exchanging colors" is very sweet and touching. | 3 | 3 | 4 | 3 | 18-29 | yes |  | no
4 | 2026/10/30 17:04 | en | bogus | 人们之间的互动，but why things get so digitalized nowadays | 5 | 4 | 3 | 6 | 18-29 | yes |  | no
