acrux-yueyao/Mycelium/design/market/halloween/field_candy.png

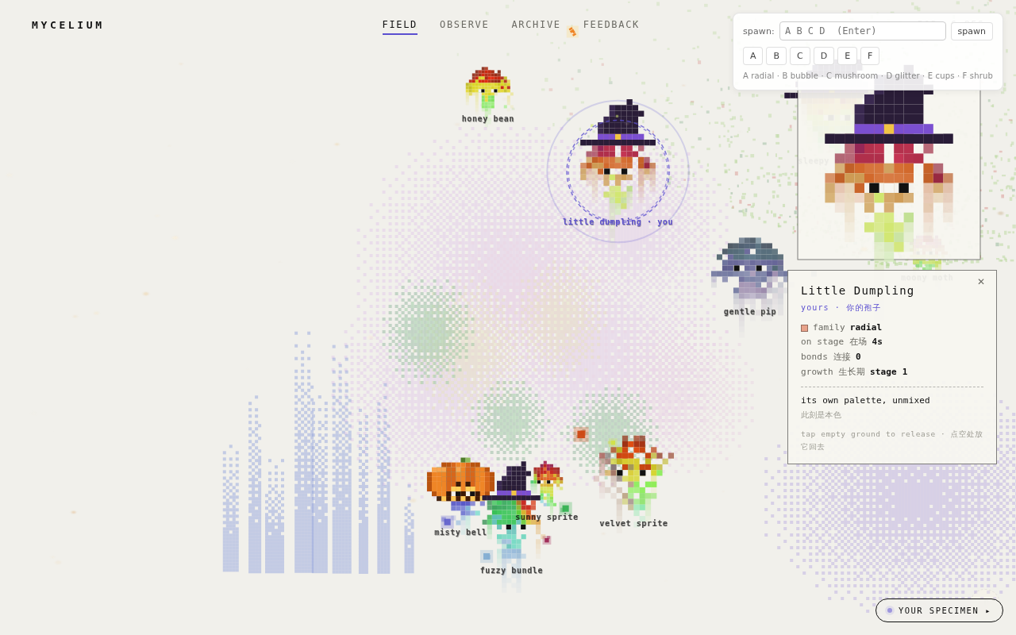
design/market/halloween/field_candy.png
