acrux-yueyao/Mycelium/design/market/halloween/landing.png

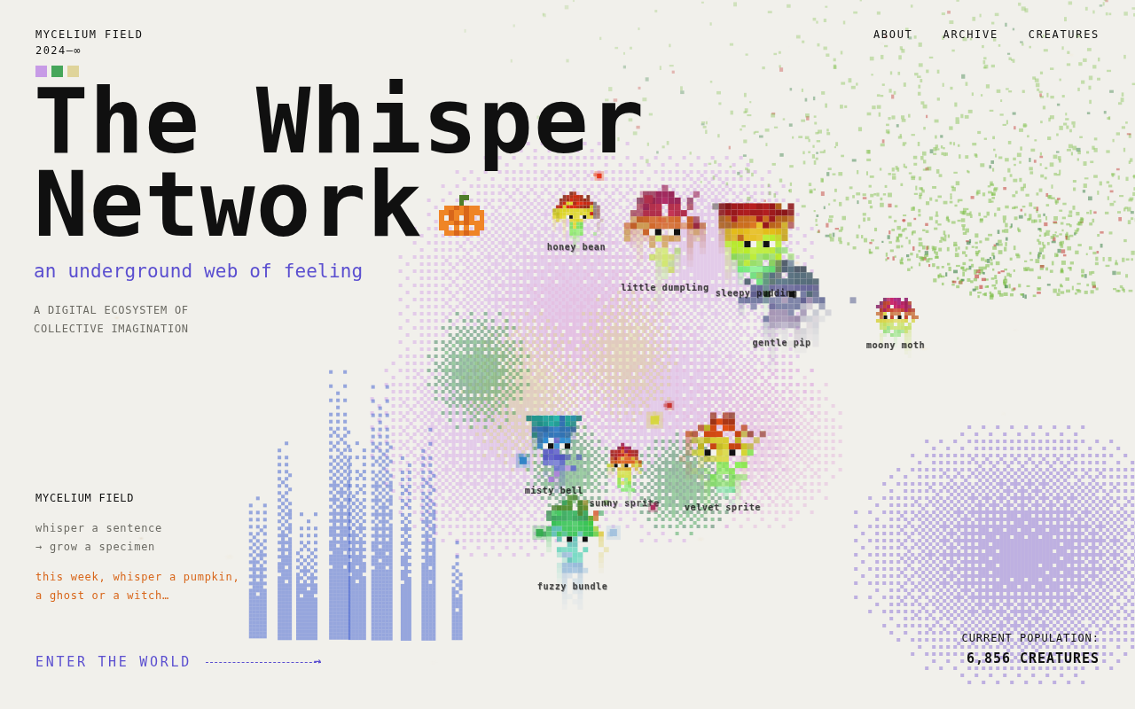
design/market/halloween/landing.png
