acrux-yueyao/Mycelium/design/market/halloween/share_card.png

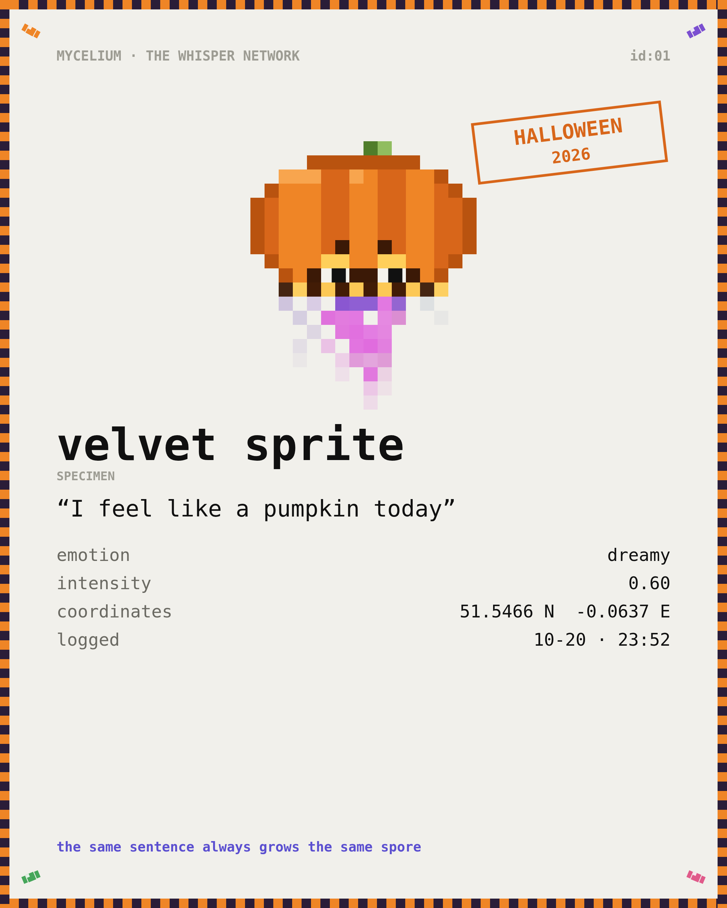
design/market/halloween/share_card.png
