acrux-yueyao/Mycelium/design/market/halloween_costumes.png

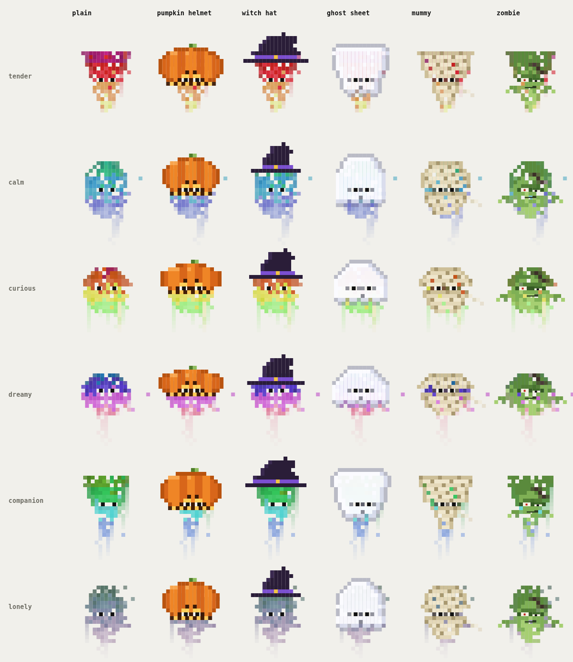
design/market/halloween_costumes.png
