acrux-yueyao/Mycelium/design/market/halloween_field_density.png

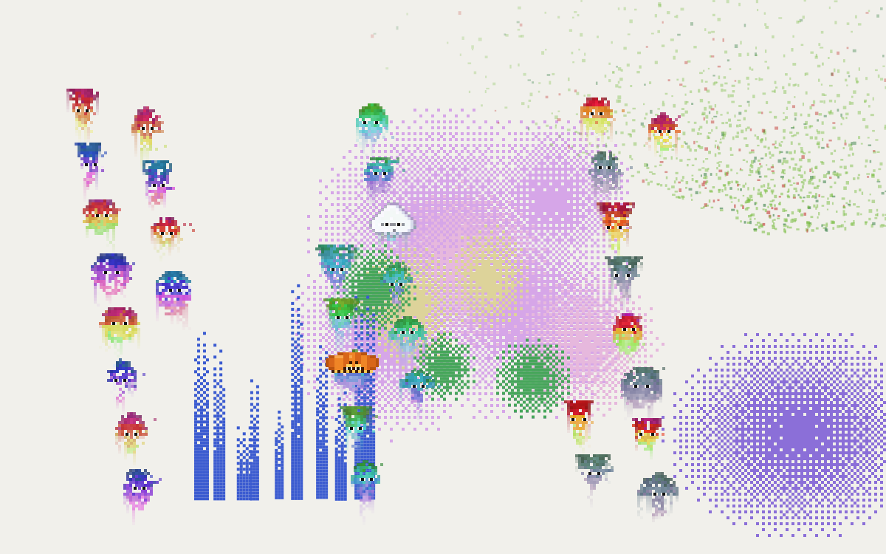
design/market/halloween_field_density.png
