acrux-yueyao/Mycelium/design/portfolio/photos/p3-charms.jpg

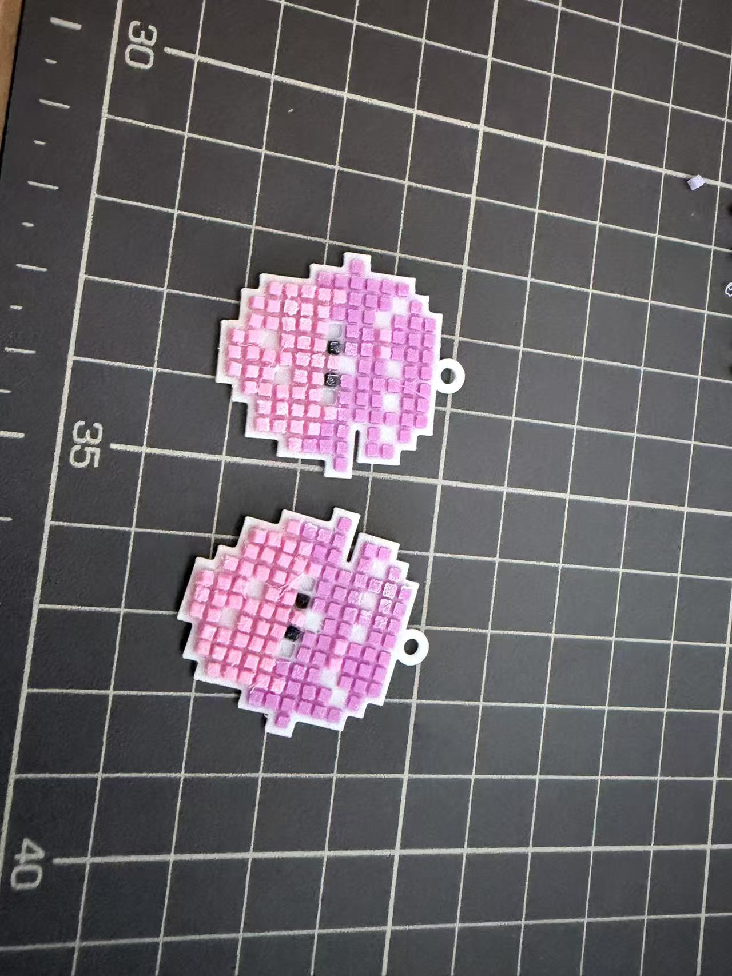
design/portfolio/photos/p3-charms.jpg
