acrux-yueyao/Mycelium/design/portfolio/photos/p4-figure.jpg

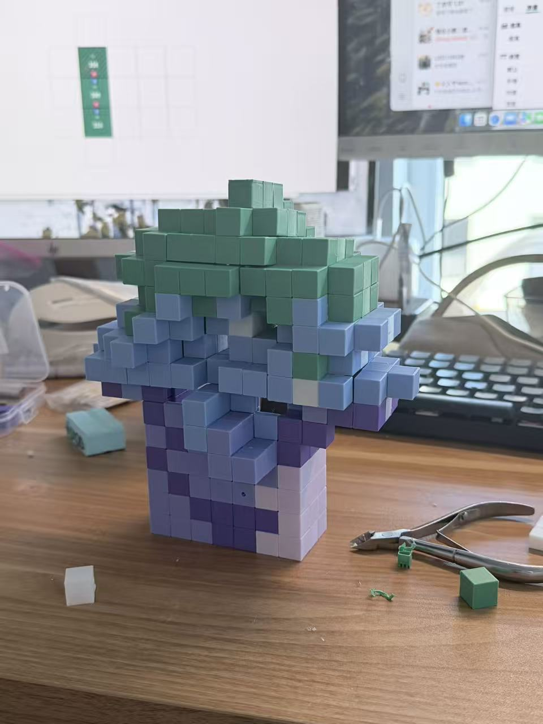
design/portfolio/photos/p4-figure.jpg
