acrux-yueyao/Mycelium/design/portfolio/photos/p5-tray.jpg

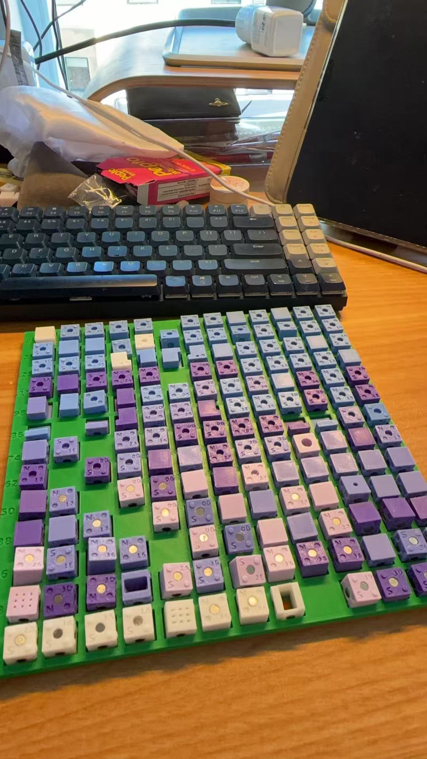
design/portfolio/photos/p5-tray.jpg
