acrux-yueyao/Mycelium/design/portfolio/photos/p6-chart.png

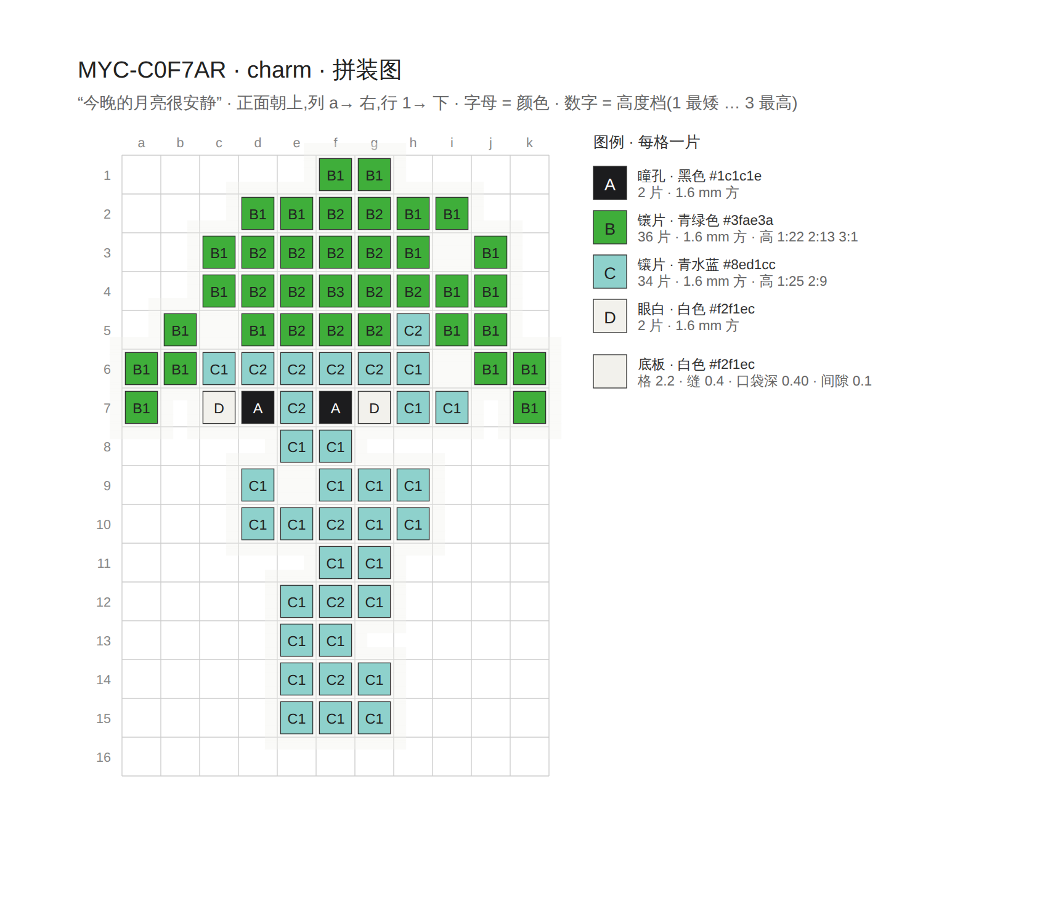
design/portfolio/photos/p6-chart.png
