acrux-yueyao/Mycelium/design/portfolio/photos/p9-details.webp

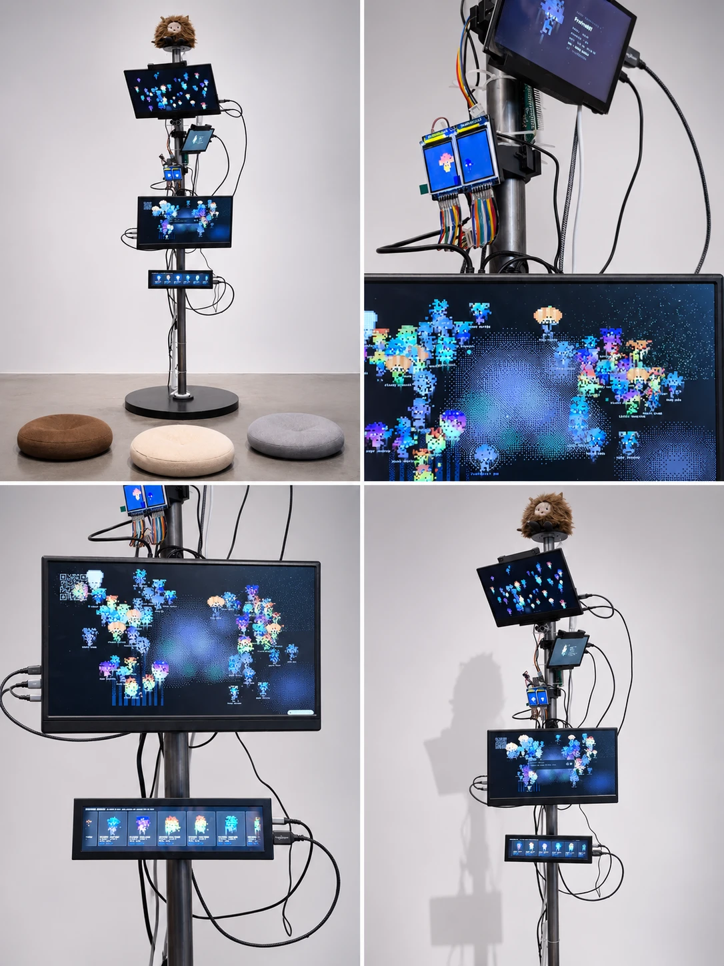
design/portfolio/photos/p9-details.webp
