acrux-yueyao/Mycelium/hardware/bench_circuit.png

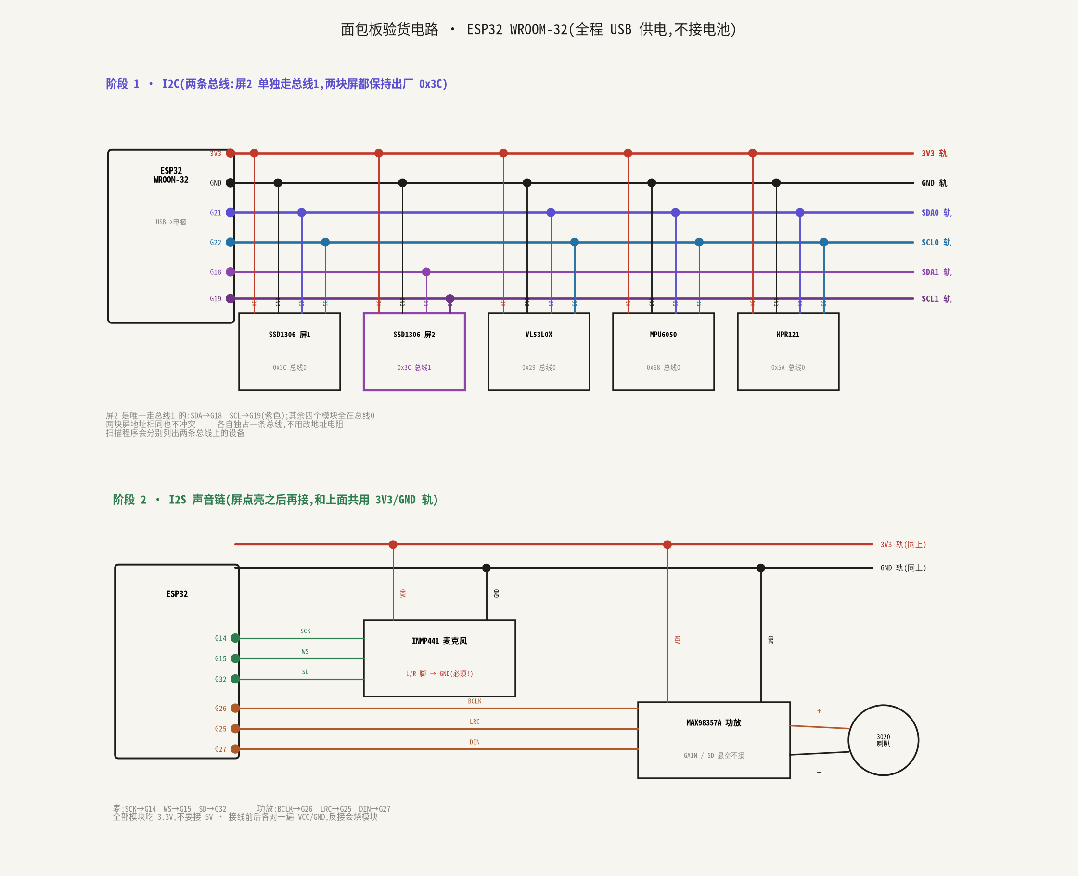
hardware/bench_circuit.png
