acrux-yueyao/Mycelium/hardware/pcb/out/facebrd_bottom.png

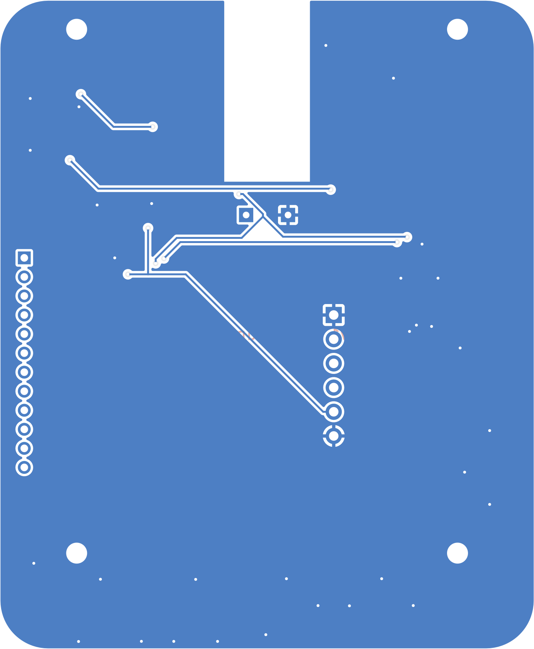
hardware/pcb/out/facebrd_bottom.png
