acrux-yueyao/Mycelium/hardware/pcb/out/facebrd_top.png

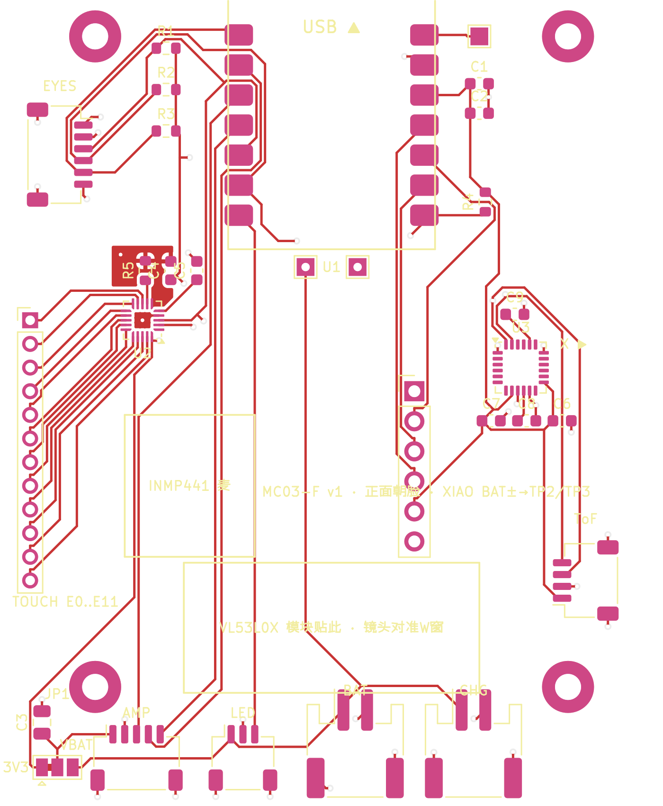
hardware/pcb/out/facebrd_top.png
