acrux-yueyao/Mycelium/hardware/ports_55_62.png

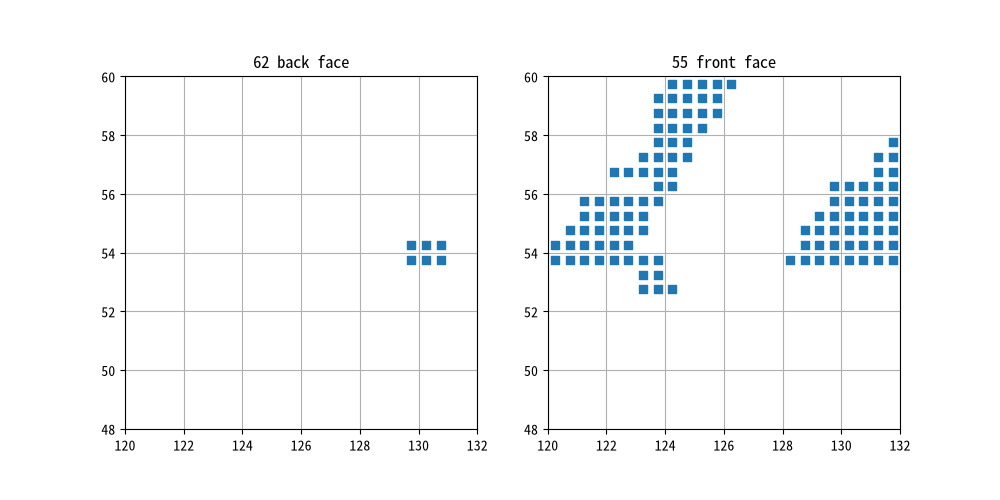
hardware/ports_55_62.png
