acrux-yueyao/Mycelium/hardware/schematic_v1.png

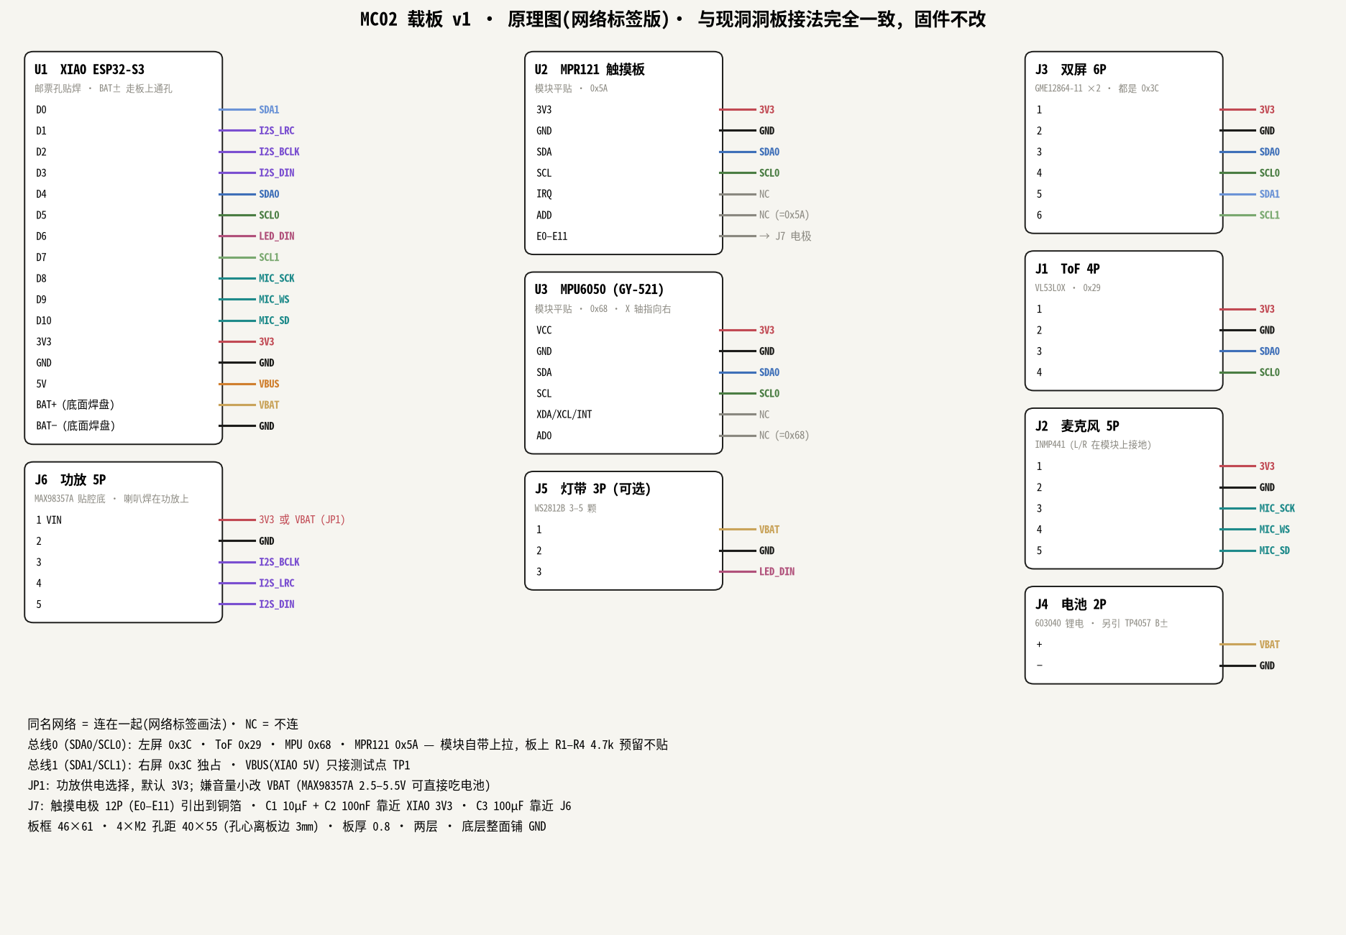
hardware/schematic_v1.png
