acrux-yueyao/Mycelium/public/case-anatomy.png

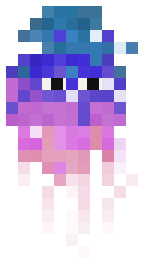
public/case-anatomy.png
