acrux-yueyao/Mycelium/public/case-arch-bell.png

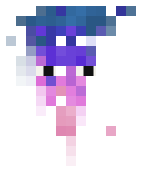
public/case-arch-bell.png
