acrux-yueyao/Mycelium/public/case-arch-round.png

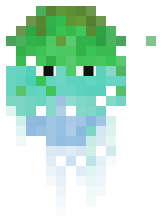
public/case-arch-round.png
