acrux-yueyao/Mycelium/public/case-arch-wide.png

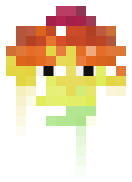
public/case-arch-wide.png
