acrux-yueyao/Mycelium/public/desktop-field.png

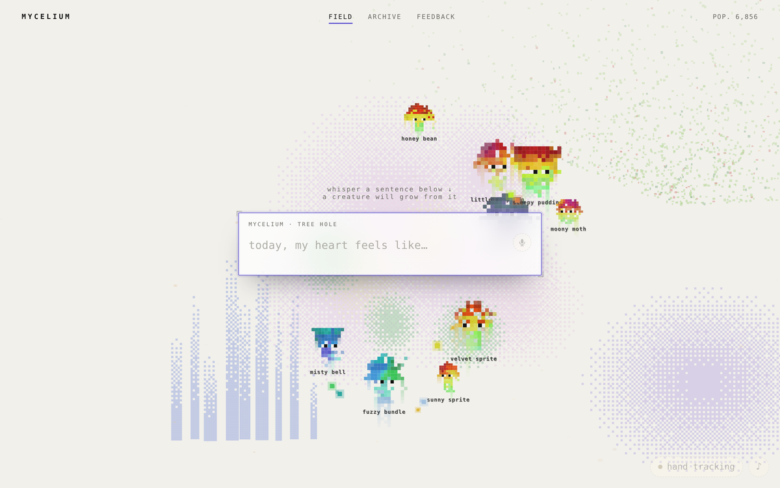
public/desktop-field.png
