acrux-yueyao/Mycelium/public/desktop-landing.png

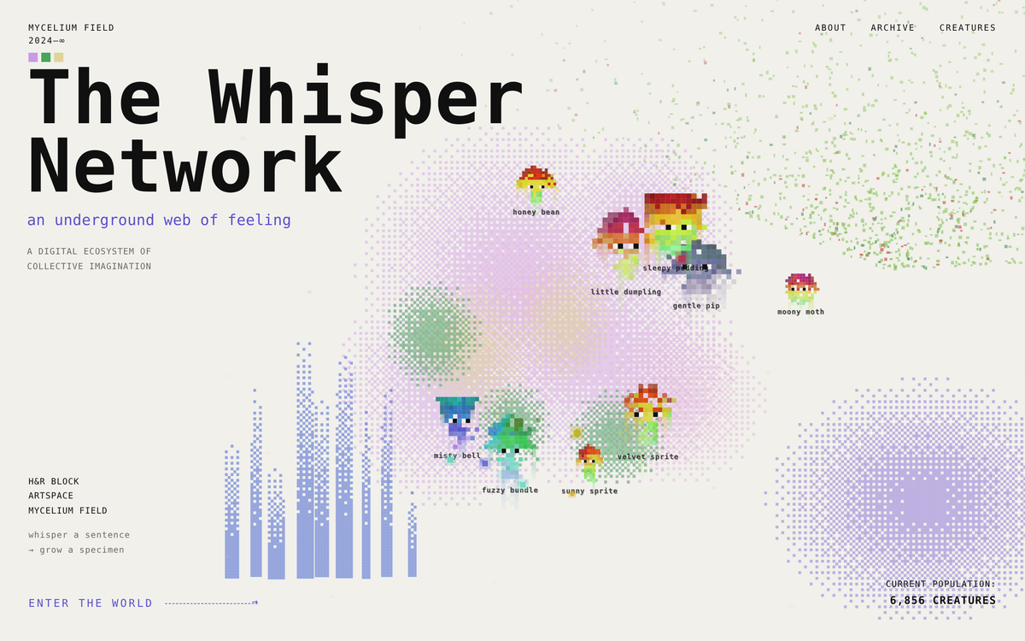
public/desktop-landing.png
