acrux-yueyao/Mycelium/public/mech-bond.gif

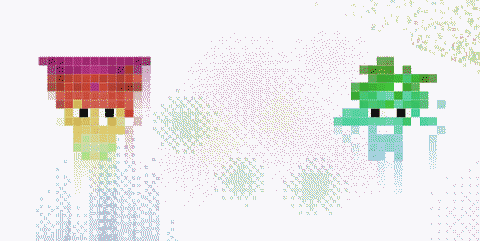
public/mech-bond.gif
