acrux-yueyao/Mycelium/public/mech-dye.gif

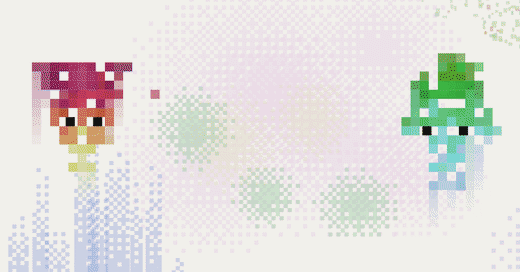
public/mech-dye.gif
