acrux-yueyao/Mycelium/public/mech-dye.jpg

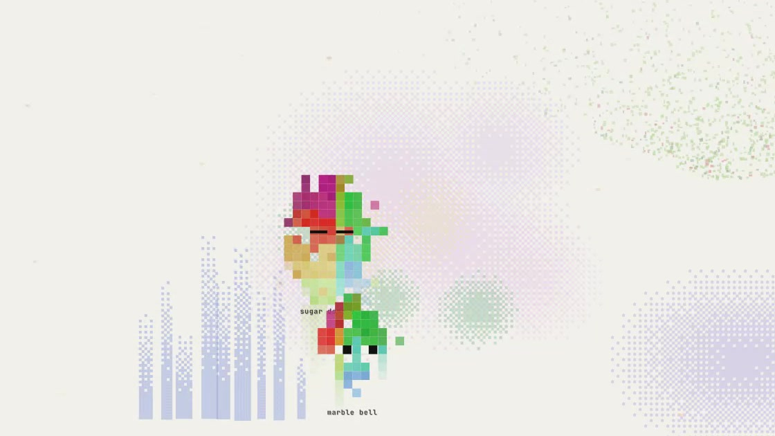
public/mech-dye.jpg
