acrux-yueyao/Mycelium/public/mech-elders.jpg

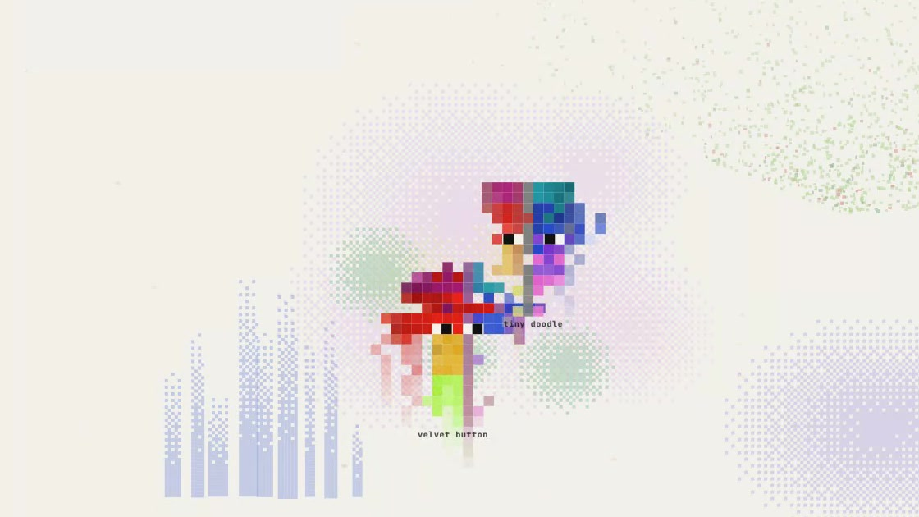
public/mech-elders.jpg
