acrux-yueyao/Mycelium/public/mech-gaze.gif

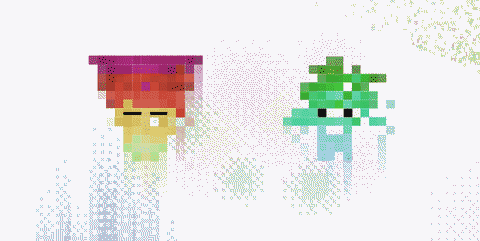
public/mech-gaze.gif
