acrux-yueyao/Mycelium/public/mech-mother.gif

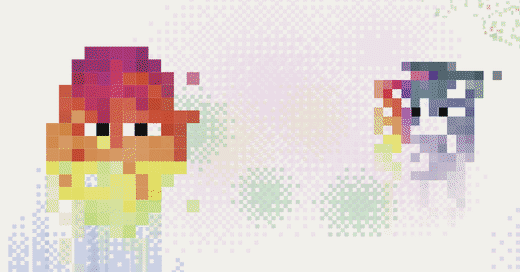
public/mech-mother.gif
