acrux-yueyao/Mycelium/public/mob-field.png

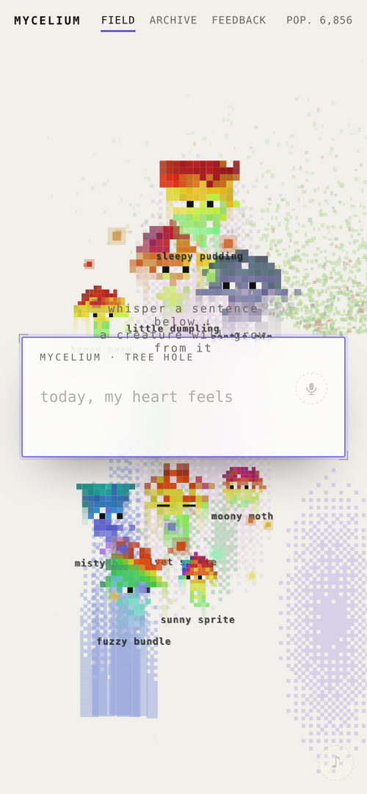
public/mob-field.png
