acrux-yueyao/Mycelium/public/mob-landing.png

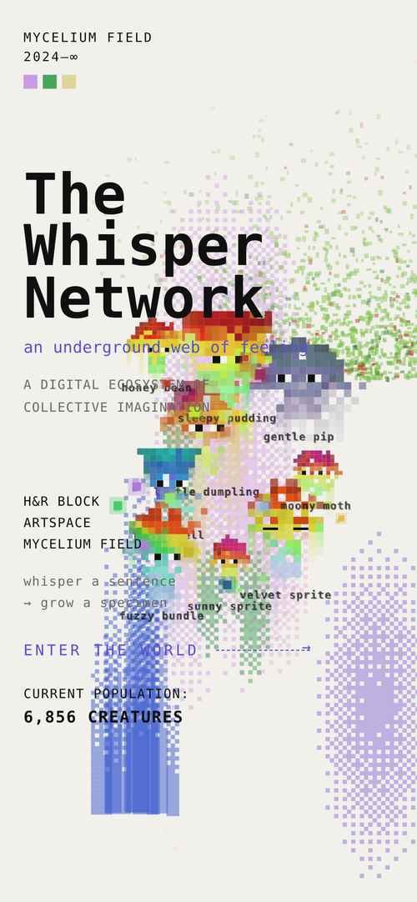
public/mob-landing.png
