acrux-yueyao/Mycelium/public/mob-survey.png

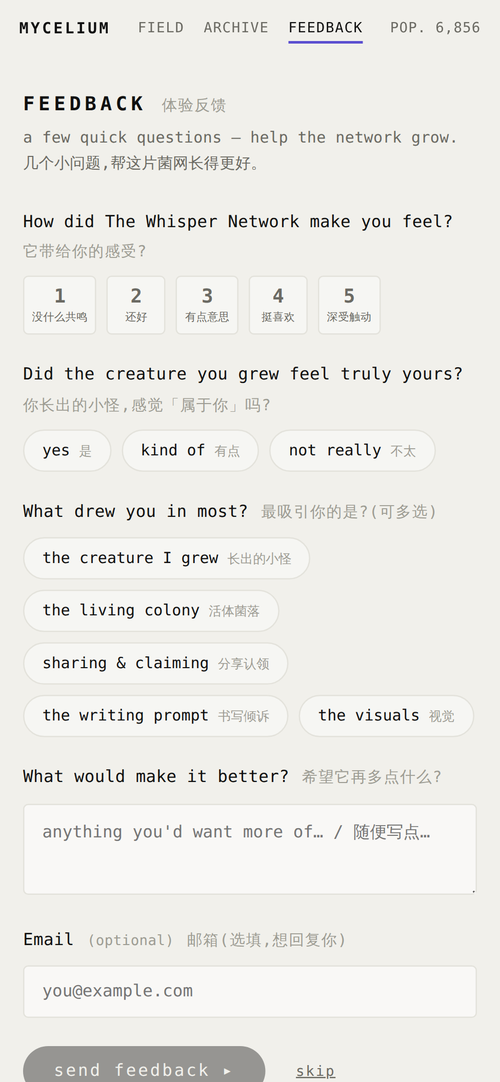
public/mob-survey.png
