acrux-yueyao/Mycelium/public/spore-fam-calm.png

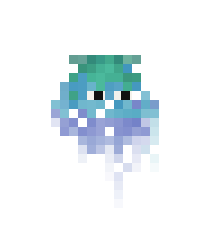
public/spore-fam-calm.png
