acrux-yueyao/Mycelium/public/spore-fam-companion.png

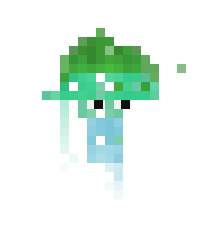
public/spore-fam-companion.png
