acrux-yueyao/Mycelium/public/spore-fam-curious.png

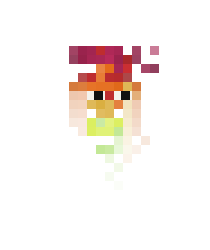
public/spore-fam-curious.png
