acrux-yueyao/Mycelium/public/spore-fam-dreamy.png

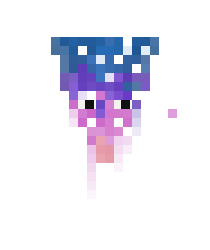
public/spore-fam-dreamy.png
