acrux-yueyao/Mycelium/public/spore-fam-lonely.png

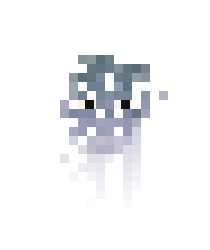
public/spore-fam-lonely.png
