acrux-yueyao/Mycelium/public/spore-fam-tender.png

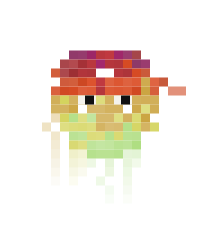
public/spore-fam-tender.png
