acrux-yueyao/Mycelium/hardware/ORDER_LOG.md

# 下单记录

## JLCPCB
- 账号 **13732724A**
- 2026-10-05 · MC03-F 脸板 v1 · 裸板 5 片(0.8 mm 沉金,绿)· 贴片 4 片(顶面,Standard)
  - 自焊:U1 XIAO ESP32-S3
  - U3 MPU-6050 用闲置料(My Parts),共买 4 颗
  - 运输 UPS Express Saver(DDP)
  - **已付款 2026-10-05 13:10** · 订单号 **W2026100601092804**(裸板 Y2-13732724A · 贴片 SMT026100563712)
  - 实付 213.43 美元 = 货 113.65 + 运费 31.65 + 关税 58.48 + 销售税 9.65(闲置料另付约 40)
  - **审核未过,订单取消(2026-10-05 18:50)**:Gerber 里缺板框层(导出脚本图层名写错 Edge_Cuts→Edge.Cuts,已修)。款项退回嘉立创账户余额,闲置料 4 颗 MPU-6050 仍在 My Parts
- 2026-10-05 19:16 · **重新下单 W2026100607165253**(修正版 Gerber,含板框)· 裸板 5(0.8 沉金)· 贴片 4
  - 实付 213.18 = 货 113.48 + 运费 31.64 + 关税 58.42 + 销售税 9.64 · UPS DDP
  - J4/J8 换成 PH2.0mm-2P-WT(C53055418);U3 用 My Parts 闲置料;U1 XIAO 自焊
  - **2026-10-06 审核:U2 封装与料不符**(我选了 Silicon Labs 角脚版 QFN-20)。回复 C 取消重下
  - 复查时又发现并改正:U2 引脚接法(7 REXT / 8–19 ELE / 20 VDD)、U3 的 22 脚改悬空、U2 中间焊盘不印锡膏
- 待第三次下单:facebrd_gerber.zip(2026-10-06 版)

- 2026-10-07 发现打印件为网页镜像(方块轴左手系)。方块不改;拼装图改为“站在背后”视角;M 格改到 (tx+4, ty+3) 以配合脸板(板子不改)。重打包 v7。
- 2026-10-07 背板 MC02-P 作废,改门板 MC04-D(door_gen.py)。重打包 v8:46 件 + 门板本体 1 + 嵌片 3 色。
- 2026-10-07 第三单 U2 仍不匹配:MPR121 实为 0.4 mm 间距 UQFN、无中间焊盘(我用了 0.5 mm)。改用 KiCad 官方封装,线宽 0.2/间距 0.13 重布。待取消重下(第四单)。
