acrux-yueyao/Mycelium/hardware/pcb/out/facebrd_bom.csv

Comment | Designator | Footprint | LCSC Part #
MPR121QR2 | U2 | UQFN-20_3x3mm_P0.4mm | C91322
MPU-6050 | U3 | InvenSense_QFN-24_4x4mm_P0.5mm | C24112
10uF | C1 | C_0603_1608Metric | C19702
100nF | C2,C4,C5,C6,C8 | C_0603_1608Metric | C14663
22uF | C3 | C_0805_2012Metric | C45783
75k | R5 | R_0603_1608Metric | C18671
10nF | C7 | C_0603_1608Metric | C57112
2.2nF | C9 | C_0603_1608Metric | C1604
4.7k | R1,R2,R3,R4 | R_0603_1608Metric | C23162
ToF 4P | J1 | JST_SH_SM04B-SRSS-TB_1x04-1MP_P1.00mm_Horizontal | C51940130
EYES 6P | J3 | JST_SH_SM06B-SRSS-TB_1x06-1MP_P1.00mm_Horizontal | C56123098
AMP 5P | J6 | JST_SH_SM05B-SRSS-TB_1x05-1MP_P1.00mm_Horizontal | C136657
LED 3P | J5 | JST_SH_SM03B-SRSS-TB_1x03-1MP_P1.00mm_Horizontal | C53055319
BAT | J4 | JST_PH_S2B-PH-SM4-TB_1x02-1MP_P2.00mm_Horizontal | C54582899
CHG | J8 | JST_PH_S2B-PH-SM4-TB_1x02-1MP_P2.00mm_Horizontal | C54582899
