acrux-yueyao/Mycelium/hardware/COST.md

# 单只桌面机器人 · 配件成本

样本机型:示例句子生成的 **284 颗方块**(13×14×3 格,约 156×168×36 mm)+ MC-01 核心舱。
方块数随句子长度浮动,成本按每颗方块折算即可。

价格分两栏:**已知**=购物记录上的实价;**估**=同类多件装的常见价,下单后替换成实价。

---

## 一、打印耗材(算出来的,不是估的)

用 trimesh 量实际网格体积,PLA 密度 1.24 g/cm³,按 3 层壁近实心(92%)折算:

| 件 | 单重 | 数量 | 小计 |
|---|---|---|---|
| 标准方块 | 1.75 g | 275 | 481 g |
| 眼部拼件(9 件套) | 9.15 g | 1 套 | 9 g |
| 核心舱 框+盖 | 47.8 g | 1 | 48 g |
| **合计** | | | **538 g** |

PLA 按 $22/kg → **$11.8**。($18/kg 时 $9.7,$26/kg 时 $14.0)

---

## 二、磁铁(最大的单项,容易低估)

双磁铁方案 = 每条相邻缝**两颗**,不是一颗。

| 缝的方向 | 对数 | 磁铁 |
|---|---|---|
| 左右 | 210 | 420 |
| 上下 | 206 | 412 |
| 前后 | 119 | 238 |
| **合计** | **535** | **1070 颗** |

Ø4×2 按 400 颗 $9.99 折算 → **$26.7**,眼部内缝 24 颗 Ø2×1 → $0.5。

**可省的地方**:身体只有 3 格厚,前后缝受力最小,只靠榫卯定位、不装磁铁,
省 238 颗(**$5.9**),手感几乎无差别。是否省等第一只拼出来再定。

⚠️ 深层内部对只有 6 对(占 1%)——身体太薄,"只给外壳装磁铁"这条路省不到钱。

---

## 三、电子件(按多件装折算到单只)

| 件 | 包装 | 包价 | 单只用 | 折算 |
|---|---|---|---|---|
| XIAO ESP32-S3 主控 | 单件 | ~$9 估 | 1 | $9.0 |
| SSD1306 0.96" 屏 | 2 片装 | ~$11 估 | 2 | $11.0 |
| VL53L0X 测距 | 2 片装 | ~$10 估 | 1 | $5.0 |
| MPU6050 姿态 | 3 片装 | ~$7.5 估 | 1 | $2.5 |
| MPR121 触摸 | 2 片装 | ~$8 估 | 1 | $4.0 |
| INMP441 麦 | 5 片装 | ~$11 估 | 1 | $2.2 |
| MAX98357A 功放 | 2 片装 | ~$10 估 | 1 | $5.0 |
| JESSINIE 3020 喇叭 | 3 只装 | ~$8 估 | 1 | $2.7 |
| TP4057 充电板 | 6 片装 | ~$8 估 | 1 | $1.3 |
| 603040 800mAh 电池 | 2 只装 | ~$9 估 | 1 | $4.5 |
| WS2812B 灯带 | 整条 | ~$10 估 | 约 1/10 | $1.0 |
| 洞洞板 55×48 | 多片装 | ~$8 估 | 2 | $1.0 |
| 排针/JST/线材 | 套装 | ~$25 估 | 少量 | $3.0 |
| **小计** | | | | **≈ $52** |

---

## 四、耗材(整包买、单只用一点点)

| 件 | 包价 | 单只折算 |
|---|---|---|
| M2 螺丝 1000 颗 | $9.99 已知 | ~$0.15 |
| Loctite 啫喱胶 | $3.82 已知 | ~$0.60 |
| EVA 泡棉 2mm 卷 | $8.69 已知 | ~$0.30 |
| Art3d 魔术贴 16 组 | $4.19 已知 | ~$0.30 |
| **小计** | | **≈ $1.4** |

---

## 五、汇总

| 分类 | 单只成本 | 占比 |
|---|---|---|
| 电子件 | $52 | 55% |
| 磁铁 | $27 | 29% |
| 打印耗材 | $12 | 13% |
| 耗材 | $1.4 | 2% |
| **单只合计** | **≈ $93** | |

**省法版**(前后缝不装磁铁 + PLA 按 $18/kg):**≈ $85**

### 首台 vs 第二台

第一台的实际掏钱数远高于 $93 —— 磁铁、螺丝、胶、泡棉、传感器全是整包买的。
但那些包能覆盖好几台:

- 螺丝 1000 颗、胶、泡棉、魔术贴:够 5-10 台
- 传感器多件装:够 2-5 台
- 磁铁:一台就吃掉 2.7 包,**这项每台都要重新买**

所以**第二台起的边际成本约 $70-75**(主要是主控、屏、磁铁、耗材),
再往后趋近 $93 这个稳态值 —— 因为磁铁和主控没法摊薄。

### 如果要压成本

1. **磁铁是最肥的一刀**:前后缝改纯榫卯 −$6;若改成"磁铁+铁片"(铁片比磁铁便宜一半)
   还能再省 $8-10,代价是要保证磁极方向、装配更繁琐。
2. **屏幕**:两块 0.96" 换成一块 1.3" 双眼共屏,省约 $5 且少一条 I2C 总线。
3. **方块数**:成本几乎线性跟着方块数走(耗材 + 磁铁 ≈ $0.14/颗)。
   短句子生成的小体型天然更便宜。
4. **传感器可选**:MPR121 触摸和 WS2812 灯带都是加分项不是必需,砍掉省 $5。

---

*数据来源:打印重量由 hardware/brick_lib.py 的实际网格体积算出;磁铁数由
kit_cubes.py 的邻接统计得出;标"估"的价格待实际下单后更新。*
