acrux-yueyao/Mycelium/hardware/COST_SCALE.md

# 铺开大货 · 成本测算

接 COST.md(单只 $93)。大货不是"单只 × N"——结构会变三次:
模块换贴片板、磁铁走批发、外壳从打印转注塑。每一次都有门槛和代价。

样本仍是 284 颗方块的机型。

---

## 一、四个量级的落地价

| 量级 | 电子 | 磁铁 | 外壳 | 耗材 | **单只** |
|---|---|---|---|---|---|
| 10 只(现在这样做) | $52 | $26.7 | $29.4 | $1.4 | **$110** |
| 100 只 | $29 | $12.8 | $29.4 | $1.0 | **$72** |
| 1,000 只 | $21.5 | $9.6 | $17.5 | $0.7 | **$49** |
| 10,000 只 | $18.7 | $6.4 | $9.4 | $0.5 | **$35** |

注意 10 只那行的 $110 比 COST.md 的 $93 高——因为那里按"包价折算"算料,
这里把打印工时和分拣人工也算进去了。**自己做不发工资时看 $93,要卖就看 $110。**

---

## 二、电子件:$52 → $18.7

现在每个功能买一块现成模块,模块商赚的是"把芯片焊到小板上"的钱。
量起来之后自己出一块 PCB,芯片直接贴上去:

| 件 | 1k 单价 |
|---|---|
| ESP32-S3-WROOM-1 模组 | $2.80 |
| 0.96" OLED 裸屏 ×2 | $3.60 |
| VL53L0X | $2.20 |
| MPU6050 / MPR121 / MAX98357A / INMP441 | $3.60 |
| 3020 喇叭 + TP4057 + 800mAh 电芯 | $2.55 |
| PCB 双层 ×2 + SMT 贴装 + 连接器 | $3.90 |
| **合计** | **$18.7** |

门槛:一次性 NRE(打样、钢网、调试)约 **$1,500-3,000**,300 只以上才划算。

---

## 三、磁铁:$26.7 → $6.4

1070 颗/只这个量,零售和批发差 4 倍:

| 渠道 | 单价 | 单只 |
|---|---|---|
| 亚马逊 400 颗装 | $0.025 | $26.7 |
| 批发 1 万颗 | $0.009 | $9.6 |
| 批发 10 万颗 | $0.006 | $6.4 |

一只吃 1070 颗,所以 **100 只就要 10 万颗**——直接够到最低档价。
这是所有项目里最容易降的一刀,只要肯一次性压货。

---

## 四、外壳:这里有个结构性矛盾

### 打印农场

| | |
|---|---|
| 料(538g,大宗 PLA $16/kg) | $8.6 |
| 机时(约 28h × $0.26 折旧电耗) | $7.3 |
| **人工(分拣 284 颗 + 装袋质检 ~45min)** | **$13.5** |
| **合计** | **$29.4** |

**料只占三成,人工才是大头。** 284 颗小方块要分色、清废料、点数装袋,
这个动作没法靠加机器解决。

> 28 小时是估的。你有打印机,**切一版满盘方块看真实时间**,
> 这个数一确认,整张表就落地了。

### 注塑

| 量 | 件费 | 摊模具($9k) | 合计 |
|---|---|---|---|
| 500 | $8.5 | $18.0 | $26.5 |
| 1,000 | $8.5 | $9.0 | $17.5 |
| 5,000 | $8.5 | $1.8 | $10.3 |
| 20,000 | $8.5 | $0.45 | $9.0 |

**打印 vs 注塑的交叉点在 800-1000 只左右。**

### ⚠️ 但注塑和这个产品的内核冲突

方块是**按句子生成**的:每句话的方块朝向组合都不一样,40 种变体的配比每只都不同。
开模开的是"变体",可变体本身不固定 —— **没法为一个生成式外形开模。**

三条出路:

1. **通用方块 + 盲塞**(推荐):方块六面全带耦合特征,只开**一副方块模 + 一副小盲塞模**。
   拼装时朝外的面塞一颗盲塞(平的小圆片),外表面照样是平的。
   一套模具通吃所有句子,而且"塞盲塞"这个动作本身可以变成拼装仪式的一部分。
   代价:多一个零件、用户多一道工序。
2. **接受外露特征**:六面通用、不塞盲塞,把榫卯点当成表面纹理(乐高的凸点就是这么变成标志的)。
   零成本,但违反你定的"朝外不能有凹凸"。
3. **只注塑核心舱,方块继续打印**:核心舱本来就是冻结件、一个 SKU、天生适合开模
   (模具约 $3-5k,省 48g 打印和 2 小时机时)。方块保持打印,保住生成式的纯粹。
   **这是 500 只以下最合理的选择。**

---

## 五、表里没算的钱(卖之前必须过一遍)

| 项 | 量级 | 说明 |
|---|---|---|
| **无线认证 FCC/CE** | $3,000-8,000 一次性 | 用预认证的 WROOM 模组能省一大截,但整机仍要测非预期辐射。**跑不掉。** |
| **锂电池 UN38.3 + MSDS** | $1,500-3,000 一次性 | 带电池发货的硬门槛,空运尤其严 |
| 包装 + 说明书 | $3-6/只 | 284 颗方块要分格盒,不是塑料袋能糊弄的 |
| 不良与返修 | 售价 3-5% | 屏幕和电池是重灾区 |
| 物流 | $8-15/只 | 整机约 1.2kg,带电池运费溢价 |
| 客服/退货 | 售价 5-8% | 用户自己拼装 = 拼错求助率高 |

**一次性投入合计约 $6k-14k**(NRE + 认证 + 模具),这笔钱决定了最小起订规模。

---

## 六、结论

- **50 只以内**:维持现状,单只 $110,不用改任何设计。适合小批量发售或展览。
- **100-500 只**:先做两件事——磁铁走批发(省 $14)、核心舱开模(省几小时机时)。
  外壳继续打印,单只落到 **$60-70**。这是最舒服的区间:不用改设计,不用碰认证以外的大钱。
- **1,000 只以上**:必须出 PCB、必须解决外壳的生成式矛盾(通用方块+盲塞),
  单只 **$49**,但要先掏 $6k-14k 一次性,并且**要重新设计一次方块**。
- **定价参考**:硬件类众筹通常按落地成本 2.5-3.5 倍定零售价。
  $49 的成本对应 **$130-170** 零售——考虑到这是个"一句话生成一只、全世界只有一只"的产品,
  这个价位站得住。

**最大的单点风险不是成本,是那 28 小时打印工时。** 先把它测准,别的都好说。
