acrux-yueyao/Mycelium/hardware/cartridge_lid.stl

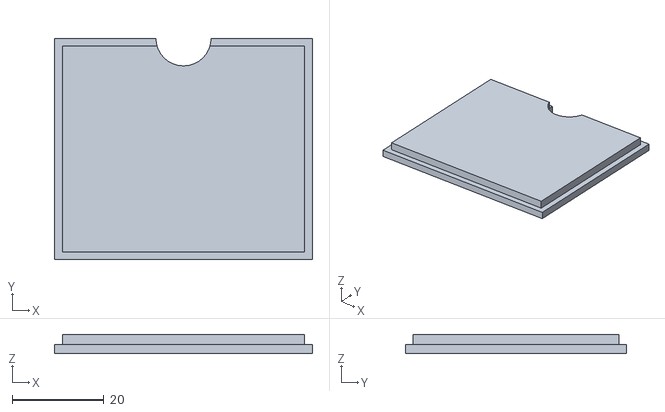
[picture p66: CAD file, 2026-08-14]
hardware/cartridge_lid.stl
56.2 x 48.2 x 4.20
