acrux-yueyao/Mycelium/hardware/print/door/门板_无柱打孔_薰衣草紫.stl

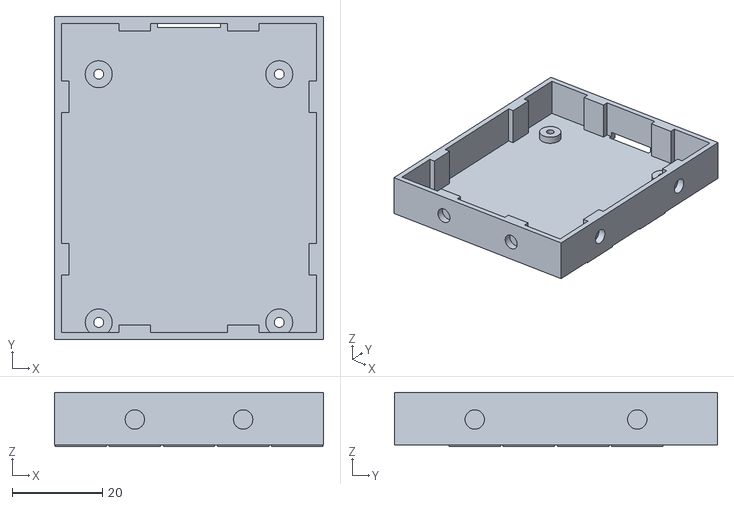
[picture p67: CAD file, 2026-10-28]
hardware/print/door/门板_无柱打孔_薰衣草紫.stl
59.6 x 71.6 x 12.0
