acrux-yueyao/Mycelium/hardware/print/moony_touch_v9/补打_深绿_11.stl

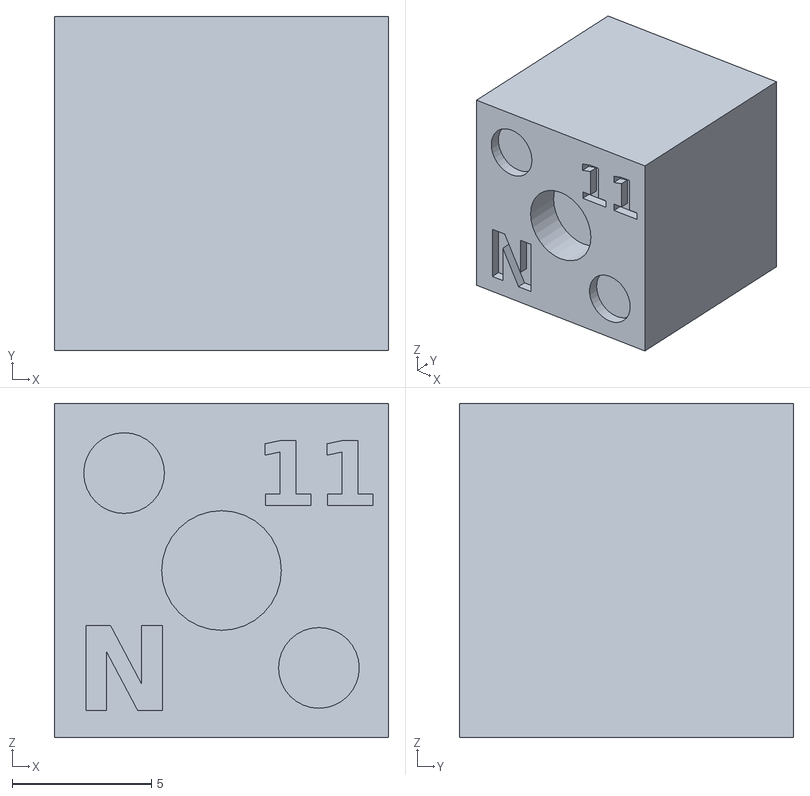
[picture p68: CAD file, 2026-10-29]
hardware/print/moony_touch_v9/补打_深绿_11.stl
12.0 x 12.0 x 12.0
