acrux-yueyao/Mycelium/hardware/print/pod/背仓+底座_一体_薰衣草紫.stl

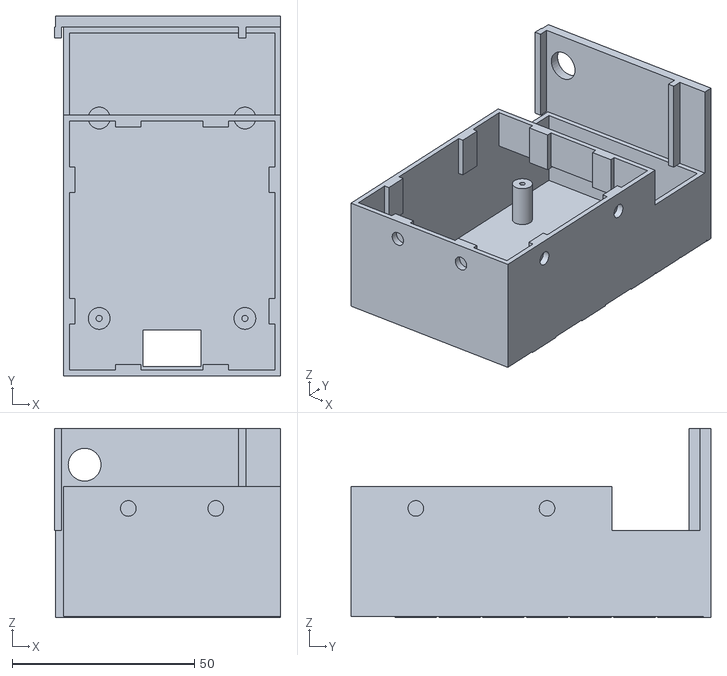
[picture p69: CAD file, 2026-10-28]
hardware/print/pod/背仓+底座_一体_薰衣草紫.stl
62.1 x 98.8 x 52.0
