acrux-yueyao/Mycelium/hardware/print/station/休息站_背板_珍珠白.stl

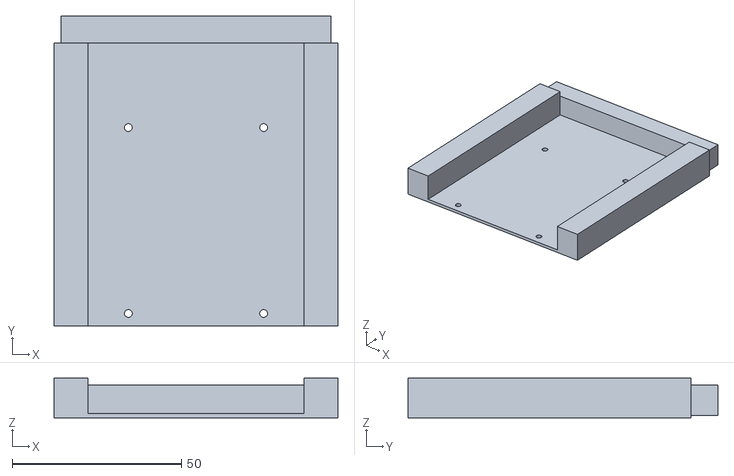
[picture p70: CAD file, 2026-10-29]
hardware/print/station/休息站_背板_珍珠白.stl
84.0 x 91.7 x 11.7
