acrux-yueyao/Mycelium/hardware/cartridge_frame.stl

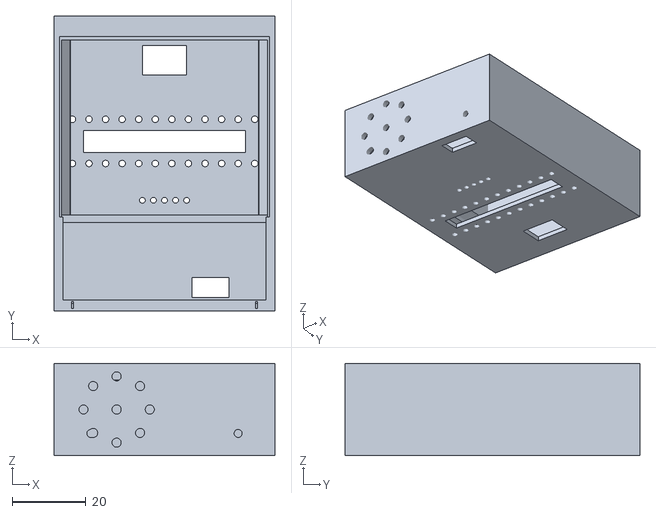
[picture p71: CAD file, 2026-08-14]
hardware/cartridge_frame.stl
60.0 x 80.0 x 25.0
