acrux-yueyao/Mycelium/hardware/print/door/门板嵌片_rouge-snow.stl

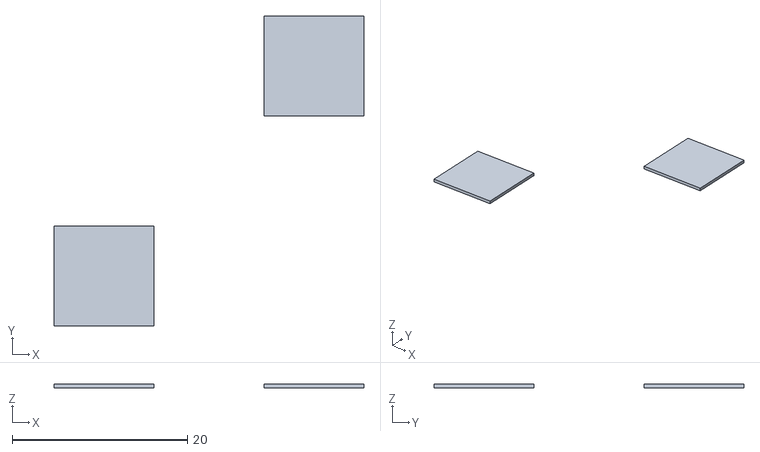
[picture p72: CAD file, 2026-10-28]
hardware/print/door/门板嵌片_rouge-snow.stl
35.4 x 35.4 x 0.5
