acrux-yueyao/Mycelium/hardware/print/pod/底座.stl

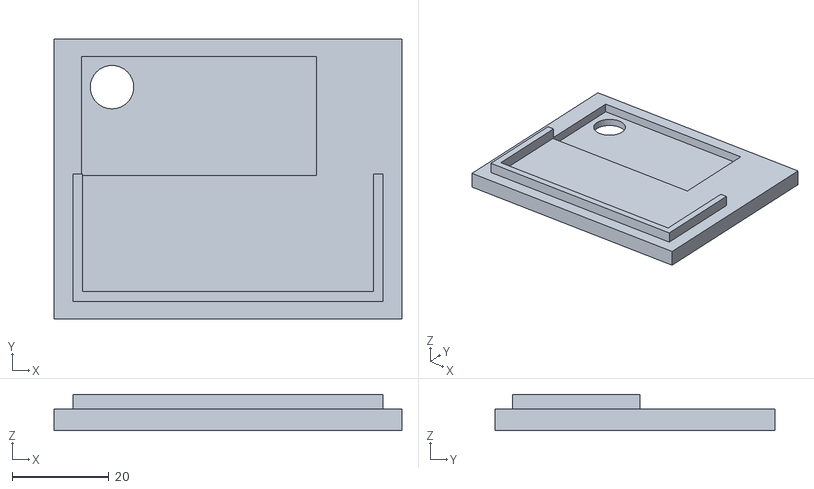
[picture p74: CAD file, 2026-10-28]
hardware/print/pod/底座.stl
72.0 x 58.0 x 7.50
