acrux-yueyao/Mycelium/hardware/print/station/休息站_底座_珍珠白.stl

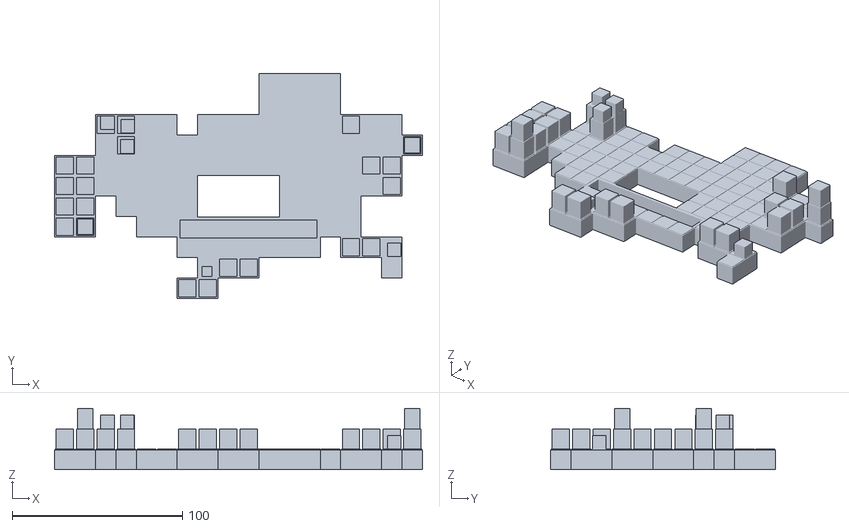
[picture p75: CAD file, 2026-10-29]
hardware/print/station/休息站_底座_珍珠白.stl
216.0 x 132.0 x 36.0
