acrux-yueyao/Mycelium/hardware/print/door/门板嵌片_薰衣草紫_盖螺丝3片.stl

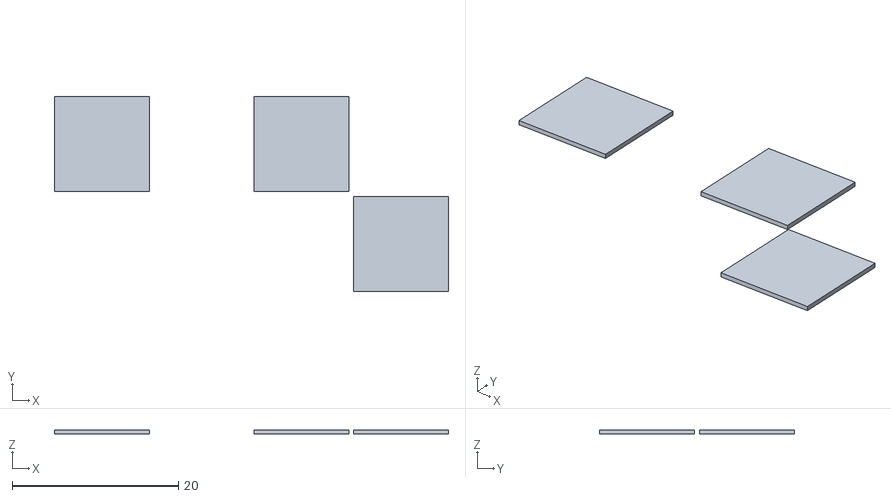
[picture p76: CAD file, 2026-10-28]
hardware/print/door/门板嵌片_薰衣草紫_盖螺丝3片.stl
47.4 x 23.4 x 0.5
