acrux-yueyao/Mycelium/hardware/print/moony_touch_v9/补打_深绿_14.stl

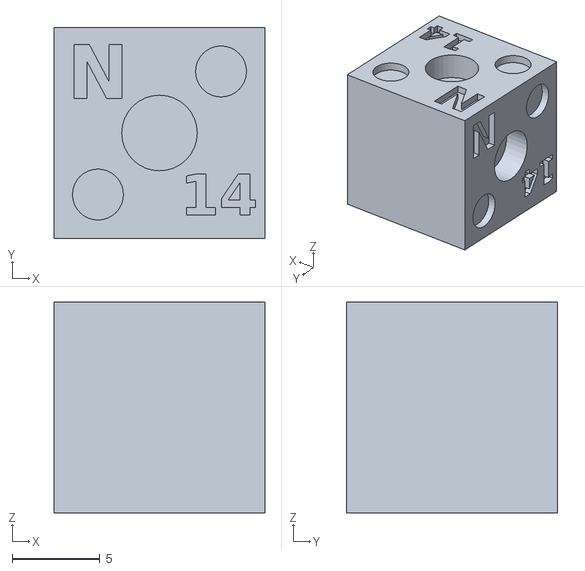
[picture p77: CAD file, 2026-10-29]
hardware/print/moony_touch_v9/补打_深绿_14.stl
12.0 x 12.0 x 12.0
