acrux-yueyao/Mycelium/hardware/print/pod/背仓嵌片_serene.stl

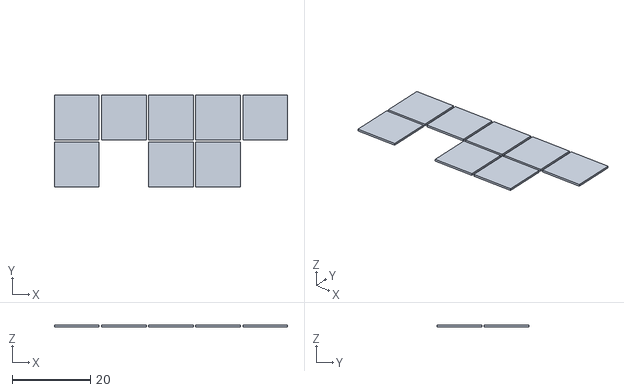
[picture p78: CAD file, 2026-10-28]
hardware/print/pod/背仓嵌片_serene.stl
59.4 x 23.4 x 0.5
