acrux-yueyao/Mycelium/hardware/print/station/休息站_珍珠白.stl

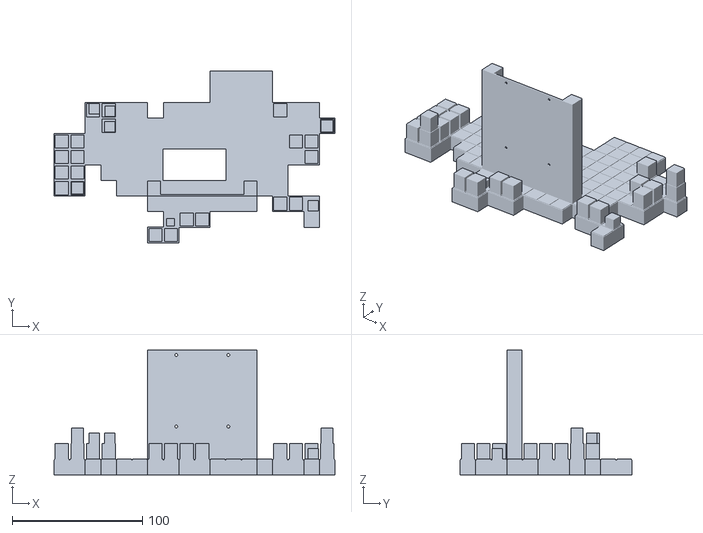
[picture p79: CAD file, 2026-10-29]
hardware/print/station/休息站_珍珠白.stl
216.0 x 132.0 x 95.7
