acrux-yueyao/Mycelium/hardware/print/moony_touch_v9/补打_深绿_31.stl

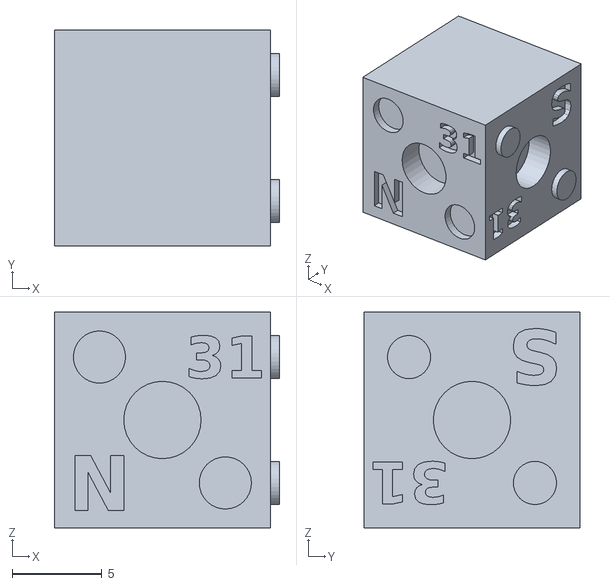
[picture p81: CAD file, 2026-10-29]
hardware/print/moony_touch_v9/补打_深绿_31.stl
12.5 x 12.0 x 12.0
