acrux-yueyao/Mycelium/hardware/print/pod/背仓_薰衣草紫.stl

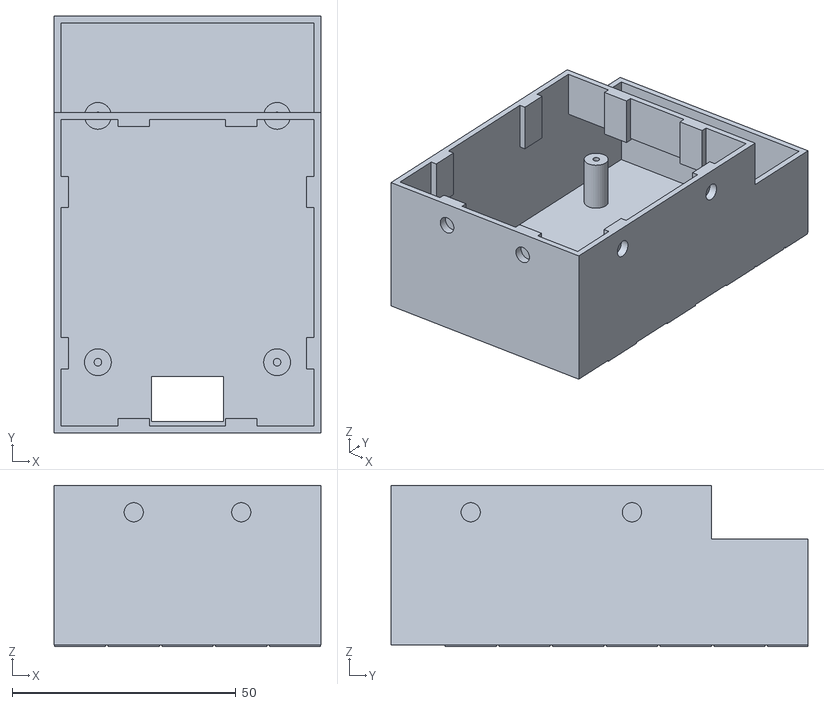
[picture p82: CAD file, 2026-10-28]
hardware/print/pod/背仓_薰衣草紫.stl
59.6 x 93.1 x 36.0
