acrux-yueyao/Mycelium/hardware/print/door/门板_柱子短5mm_薰衣草紫.stl

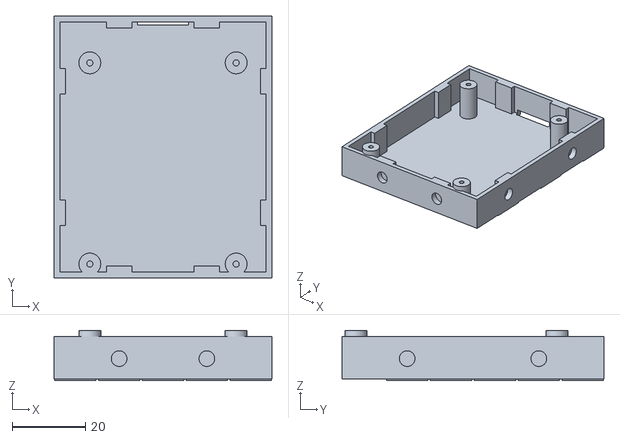
[picture p83: CAD file, 2026-10-28]
hardware/print/door/门板_柱子短5mm_薰衣草紫.stl
59.6 x 71.6 x 13.7
