acrux-yueyao/Mycelium/hardware/print/pod/背仓嵌片_purple.stl

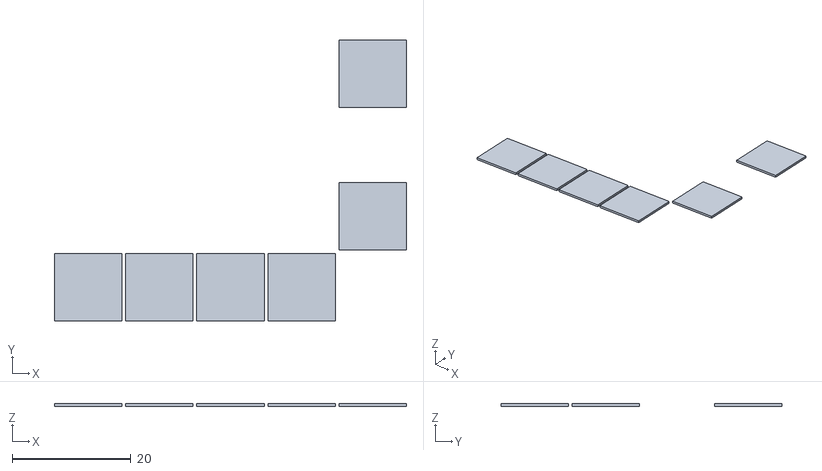
[picture p84: CAD file, 2026-10-28]
hardware/print/pod/背仓嵌片_purple.stl
59.4 x 47.4 x 0.5
