acrux-yueyao/Mycelium/hardware/print/moony_touch_v9/补打_宁静蓝_L31.stl

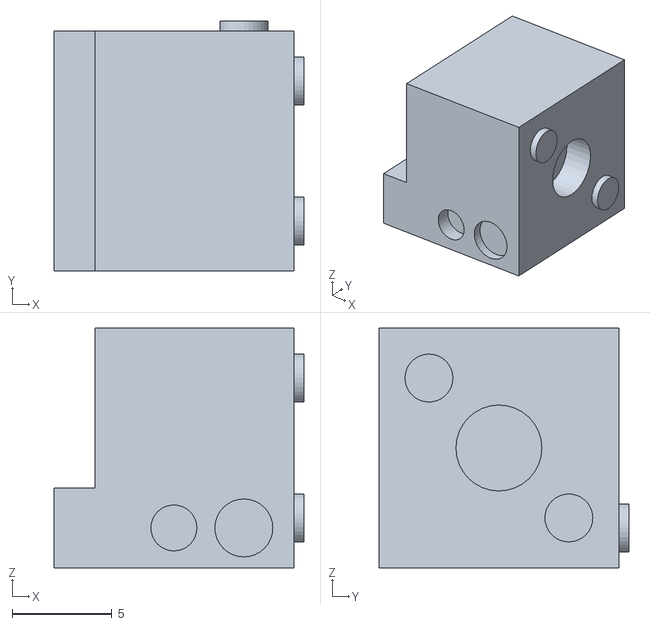
[picture p85: CAD file, 2026-10-28]
hardware/print/moony_touch_v9/补打_宁静蓝_L31.stl
12.5 x 12.5 x 12.0
