acrux-yueyao/Mycelium/hardware/print/moony_touch_v9/补打_宁静蓝_R00.stl

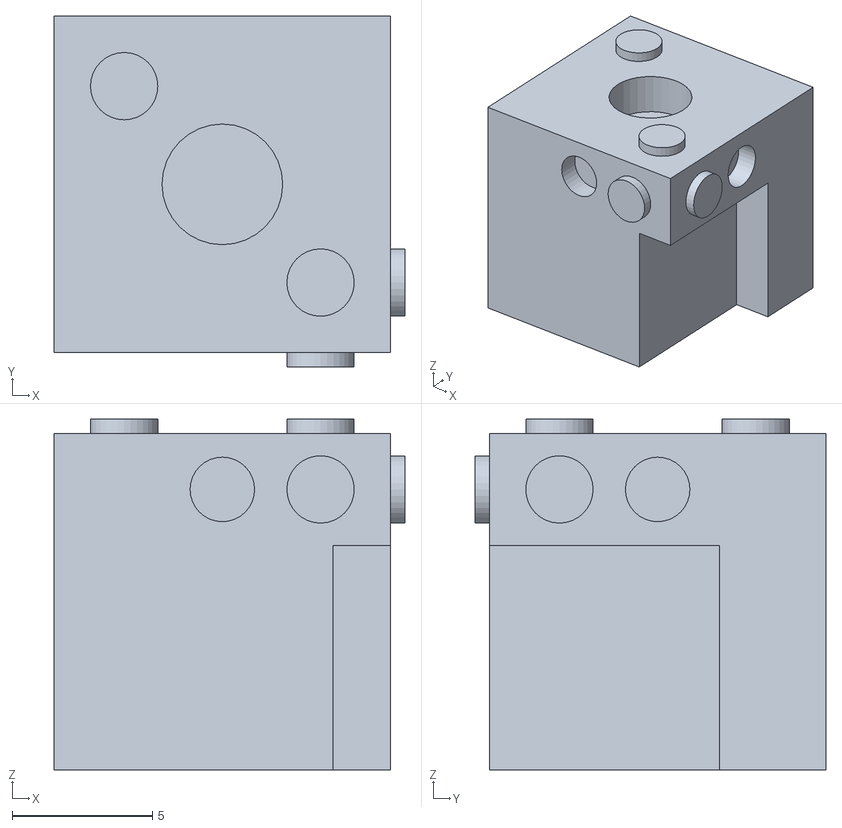
[picture p87: CAD file, 2026-10-28]
hardware/print/moony_touch_v9/补打_宁静蓝_R00.stl
12.5 x 12.5 x 12.5
