acrux-yueyao/Mycelium/hardware/print/moony_touch_v9/补打_宁静蓝_18.stl

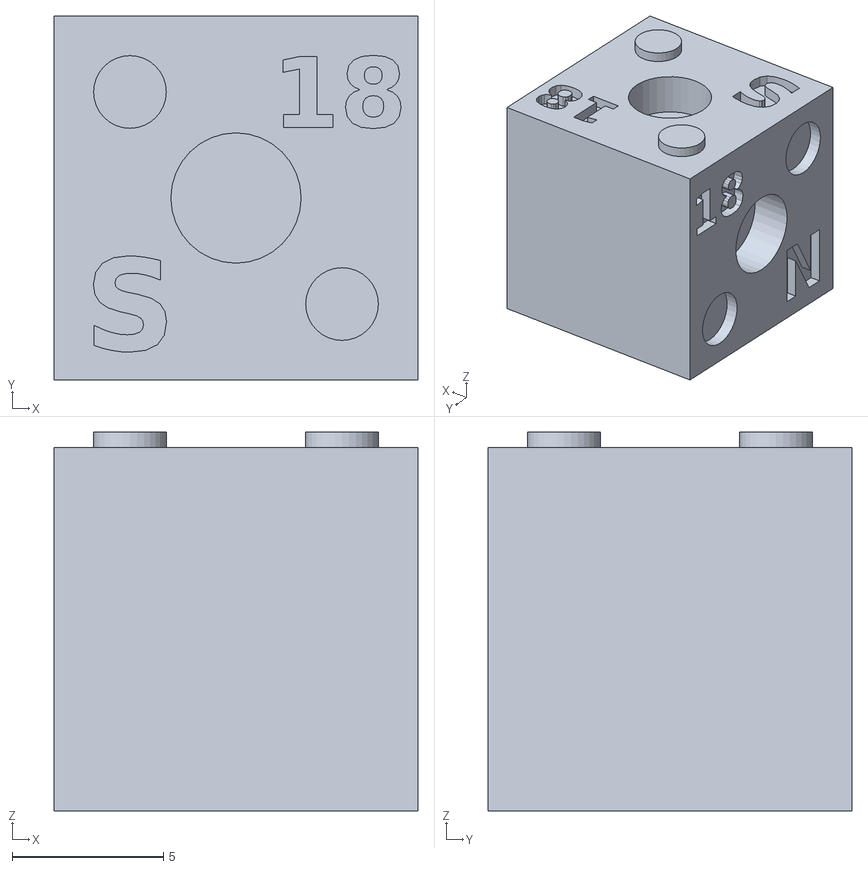
[picture p89: CAD file, 2026-10-28]
hardware/print/moony_touch_v9/补打_宁静蓝_18.stl
12.0 x 12.0 x 12.5
