acrux-yueyao/Mycelium/hardware/print/moony_touch_v9/重打_深绿_308.stl

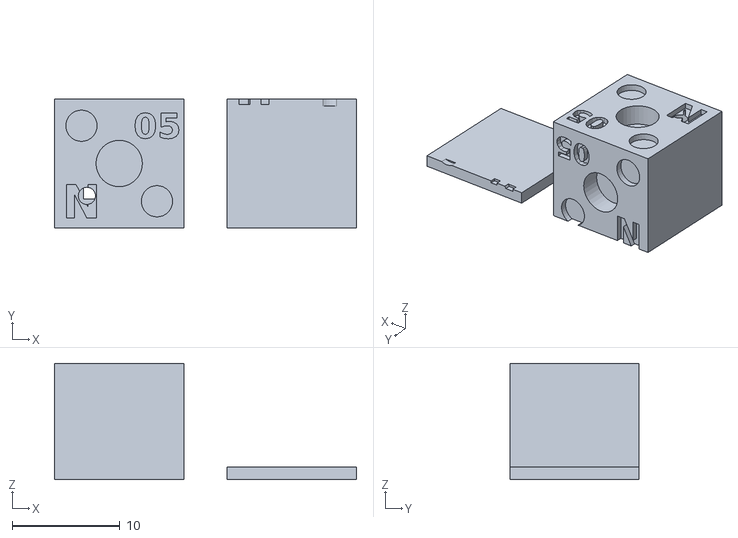
[picture p90: CAD file, 2026-10-27]
hardware/print/moony_touch_v9/重打_深绿_308.stl
28.0 x 12.0 x 10.8
