acrux-yueyao/Mycelium/hardware/print/moony_touch_v9/重打_胭脂雪_触摸_56+70.stl

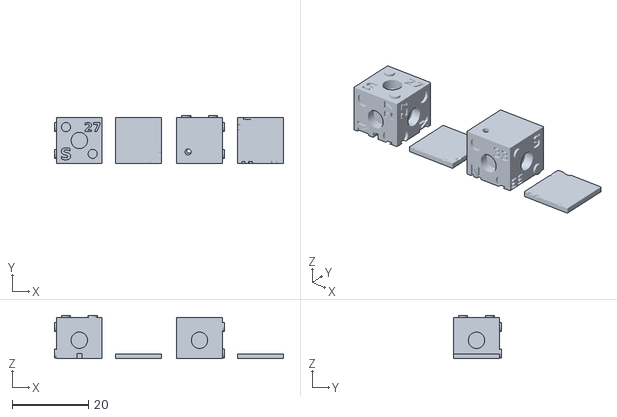
[picture p91: CAD file, 2026-10-27]
hardware/print/moony_touch_v9/重打_胭脂雪_触摸_56+70.stl
60.0 x 12.5 x 11.3
