acrux-yueyao/Mycelium/hardware/print/moony_touch_v9/重做_E6_54+56_rouge-snow.stl

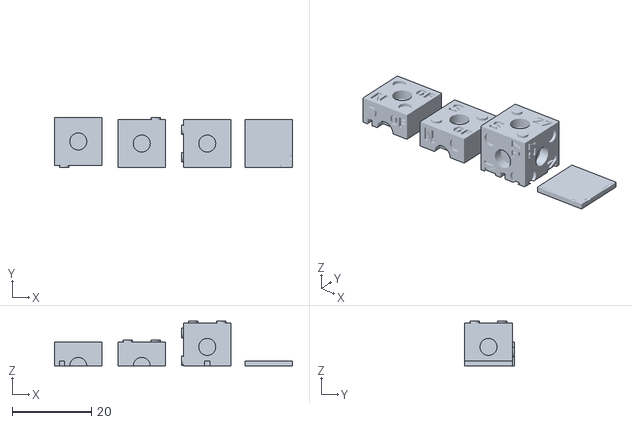
[picture p92: CAD file, 2026-10-27]
hardware/print/moony_touch_v9/重做_E6_54+56_rouge-snow.stl
60.0 x 12.5 x 11.3
