acrux-yueyao/Mycelium/hardware/print/moony_touch_v9/重打_非触摸_12_lavender.stl

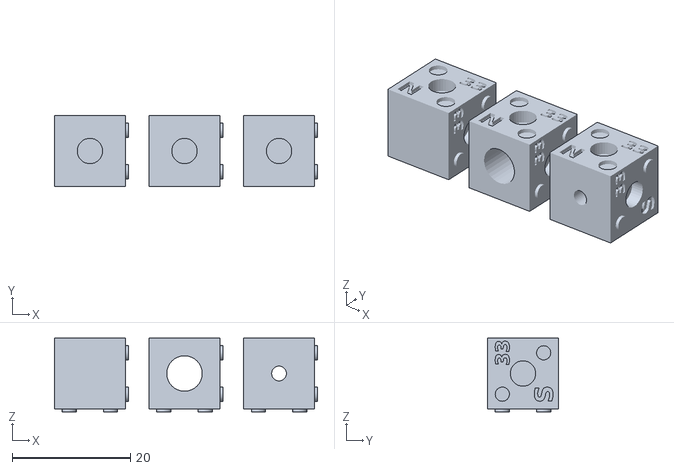
[picture p93: CAD file, 2026-10-26]
hardware/print/moony_touch_v9/重打_非触摸_12_lavender.stl
44.5 x 12.0 x 12.5
