acrux-yueyao/Mycelium/hardware/print/moony_touch_v9/重打_非触摸_13_purple.stl

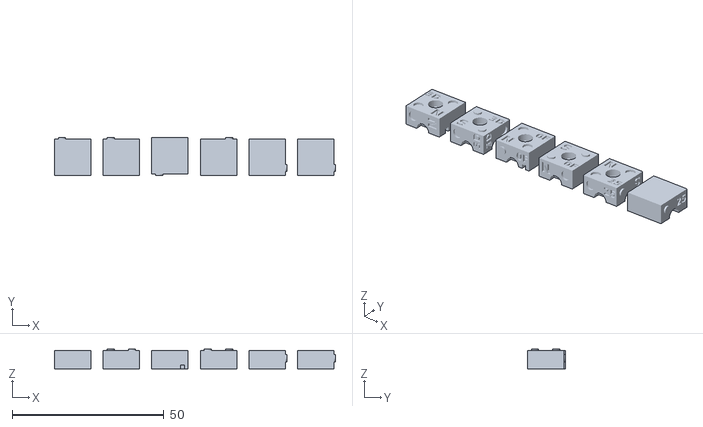
[picture p94: CAD file, 2026-10-26]
hardware/print/moony_touch_v9/重打_非触摸_13_purple.stl
92.5 x 12.5 x 6.51
