acrux-yueyao/Mycelium/hardware/print/moony_touch_v9/重打_非触摸_09_serene-blue.stl

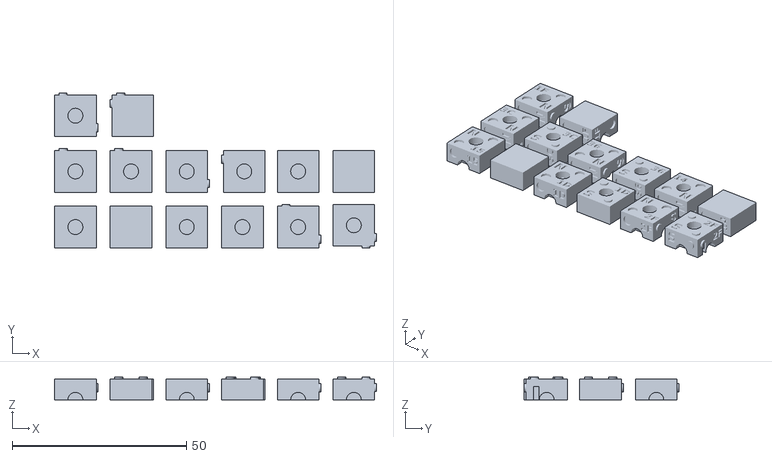
[picture p95: CAD file, 2026-10-26]
hardware/print/moony_touch_v9/重打_非触摸_09_serene-blue.stl
92.5 x 44.5 x 6.51
