acrux-yueyao/Mycelium/hardware/print/moony_touch_v9/重打_非触摸_06_deep-green.stl

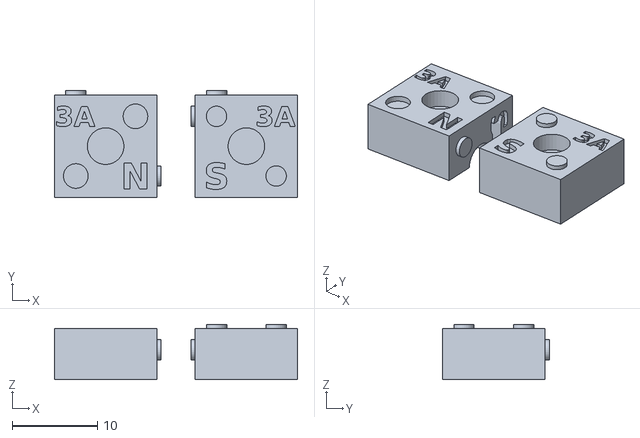
[picture p96: CAD file, 2026-10-26]
hardware/print/moony_touch_v9/重打_非触摸_06_deep-green.stl
28.5 x 12.5 x 6.51
