acrux-yueyao/Mycelium/hardware/print/moony_touch_v9/补打_对齐_13_purple.stl

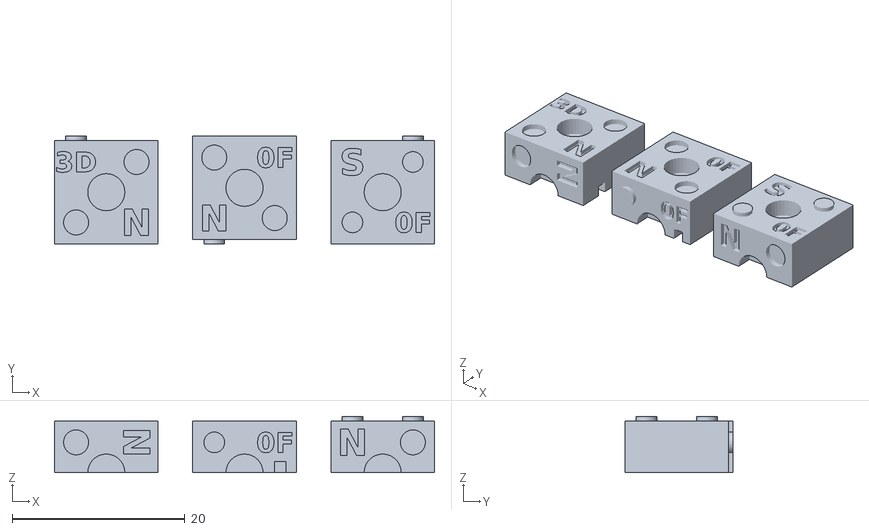
[picture p97: CAD file, 2026-10-26]
hardware/print/moony_touch_v9/补打_对齐_13_purple.stl
44.0 x 12.5 x 6.51
