acrux-yueyao/Mycelium/hardware/print/moony_touch_v9/补打_对齐_09_serene-blue.stl

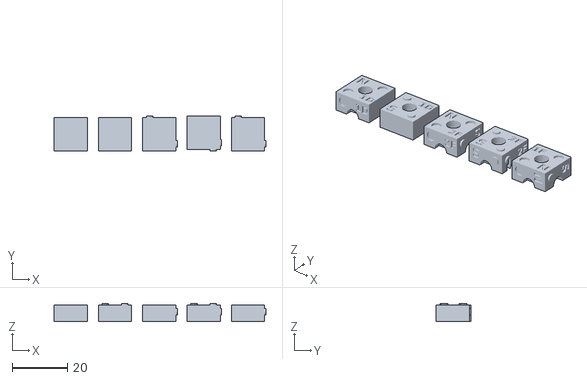
[picture p98: CAD file, 2026-10-26]
hardware/print/moony_touch_v9/补打_对齐_09_serene-blue.stl
76.5 x 12.5 x 6.51
