acrux-yueyao/Mycelium/hardware/print/moony_touch_v9/补打_对齐_06_deep-green.stl

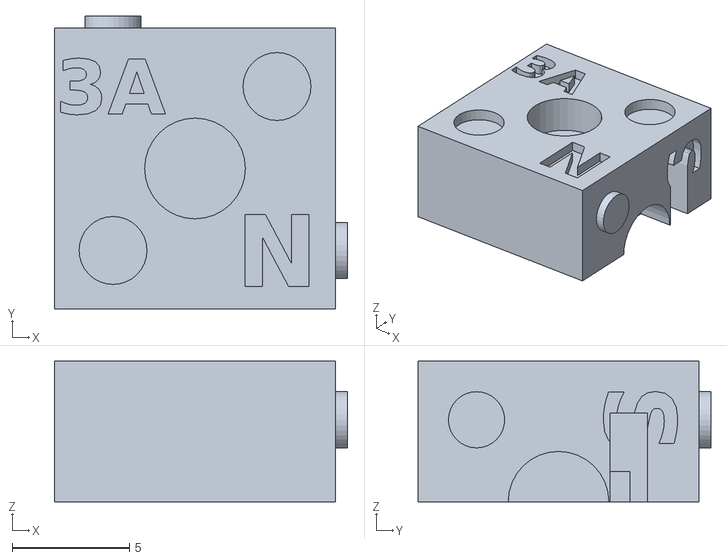
[picture p99: CAD file, 2026-10-26]
hardware/print/moony_touch_v9/补打_对齐_06_deep-green.stl
12.5 x 12.5 x 6.00
