acrux-yueyao/Mycelium/hardware/print/moony_touch_v9/fix_11_rouge-snow_1.stl

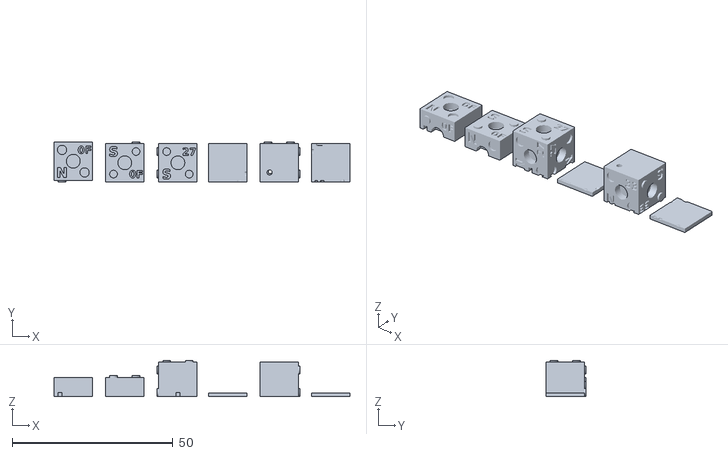
[picture p100: CAD file, 2026-10-26]
hardware/print/moony_touch_v9/fix_11_rouge-snow_1.stl
92.0 x 12.5 x 11.3
