acrux-yueyao/Mycelium/hardware/print/moony_touch_v9/fix_09_serene-blue_1.stl

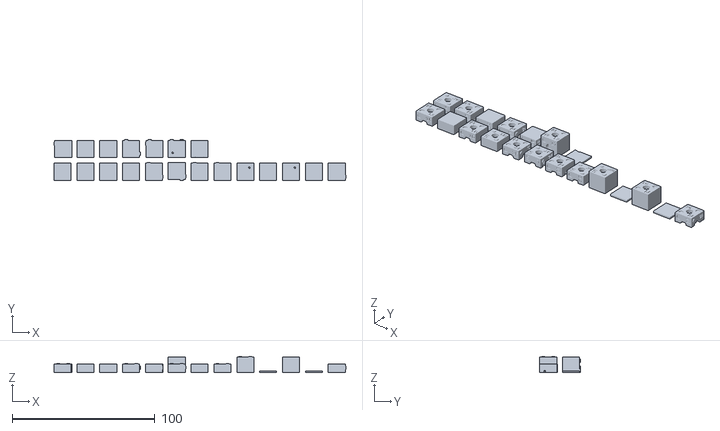
[picture p101: CAD file, 2026-10-26]
hardware/print/moony_touch_v9/fix_09_serene-blue_1.stl
204.5 x 28.5 x 11.3
