acrux-yueyao/Mycelium/hardware/print/moony_touch_v9/补打_对齐_11_rouge-snow.stl

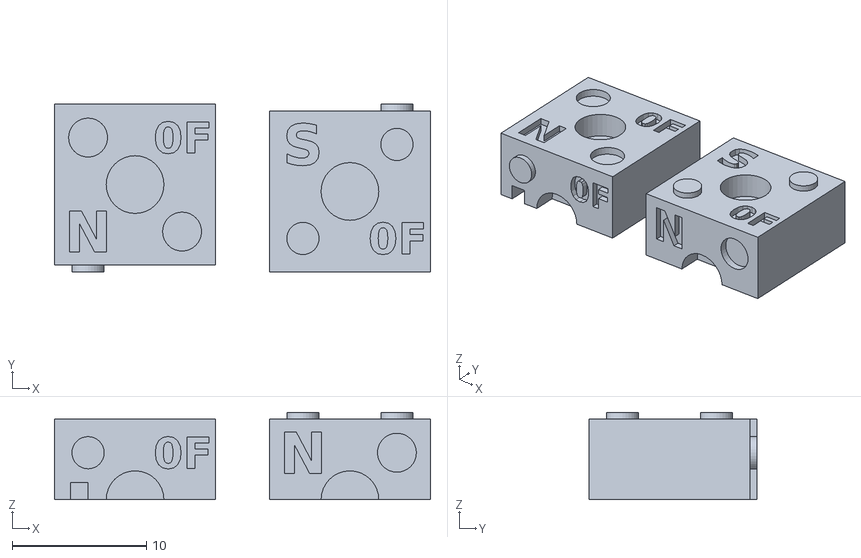
[picture p102: CAD file, 2026-10-26]
hardware/print/moony_touch_v9/补打_对齐_11_rouge-snow.stl
28.0 x 12.5 x 6.51
