acrux-yueyao/Mycelium/hardware/print/moony_touch_v9/fix_13_purple_1.stl

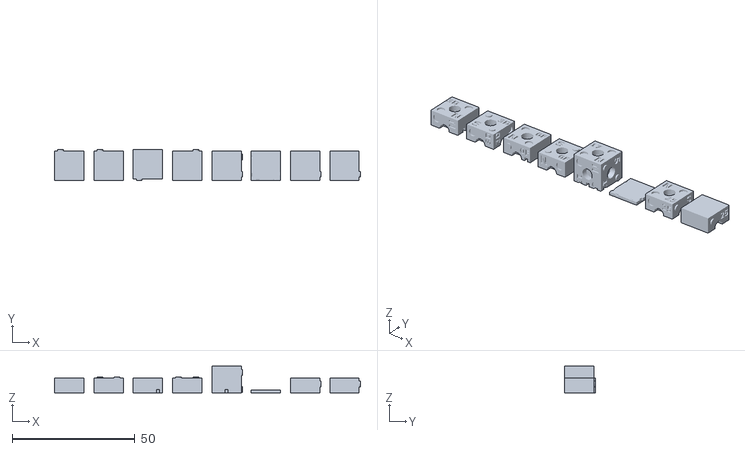
[picture p103: CAD file, 2026-10-26]
hardware/print/moony_touch_v9/fix_13_purple_1.stl
124.5 x 12.5 x 10.8
