acrux-yueyao/Mycelium/hardware/print/moony_touch_v9/fix_06_deep-green_1.stl

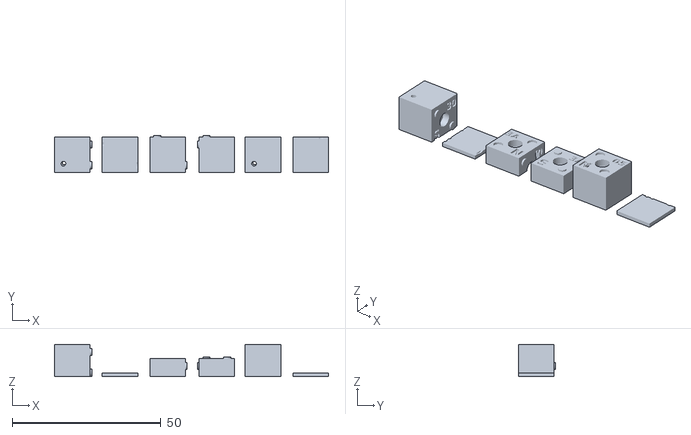
[picture p104: CAD file, 2026-10-26]
hardware/print/moony_touch_v9/fix_06_deep-green_1.stl
92.0 x 12.5 x 10.8
