acrux-yueyao/Mycelium/hardware/print/moony_touch_v9/fix_12_lavender_1.stl

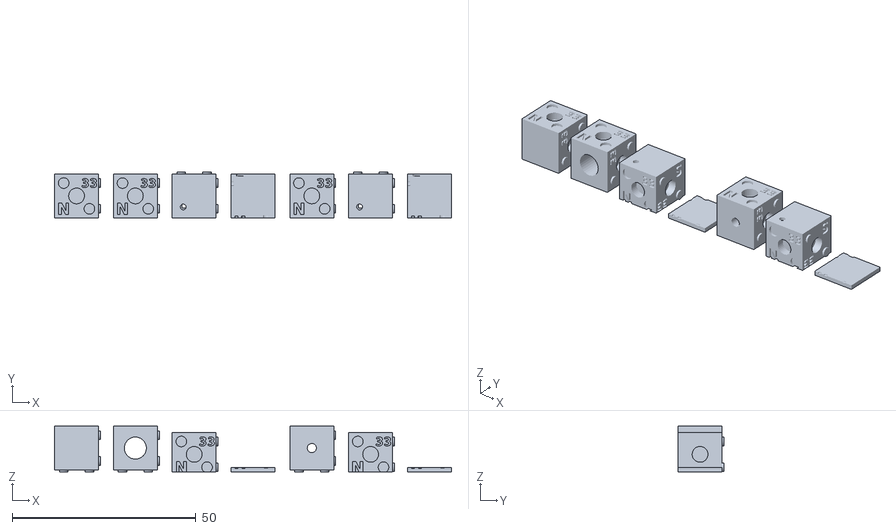
[picture p105: CAD file, 2026-10-22]
hardware/print/moony_touch_v9/fix_12_lavender_1.stl
108.0 x 12.5 x 12.5
