acrux-yueyao/Mycelium/hardware/print/moony_touch_v9/fix_white_1.stl

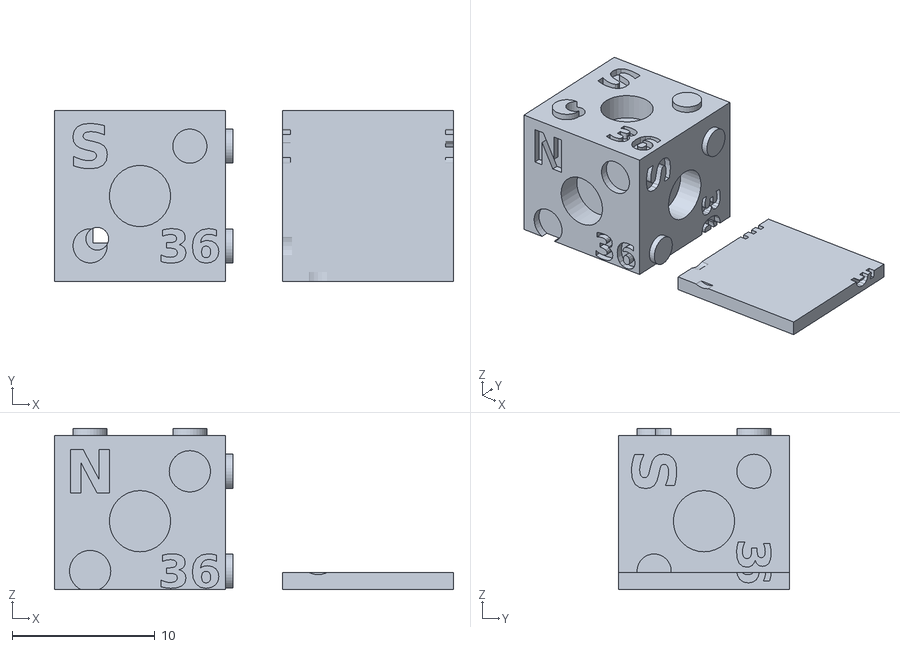
[picture p106: CAD file, 2026-10-22]
hardware/print/moony_touch_v9/fix_white_1.stl
28.0 x 12.0 x 11.3
