acrux-yueyao/Mycelium/(list of files, cad)

Other CAD files:
hardware/print/moony_touch_v9/补打_深绿_25.stl
hardware/print/moony_touch_v9/补打_薰衣草紫_34.stl
hardware/print/moony_touch_v9/add_06_deep-green_236.stl
