acrux-yueyao/Mycelium/hardware/print/moony_touch_v9/穿线步骤.md

# 触摸线 · 一路一路穿线步骤

主板（带 12 根线）放在机身旁边。每一路都**从主板那头往外**：先线槽块，最后触摸块。
方向（上/下/左/右/前/后）= 方块自己的方向，和 `fix_manifest.txt`、盘面图一致。

## 两个通用动作

**【合线槽块】**
1. 线放进 LA 半块剖面上的槽，从「进」那面的口走到「出」那面的口；路上遇到角上的小孔就从孔穿过去。
2. 剖面涂薄薄一层 CA 胶，**避开槽**（线要还能前后滑）。
3. 合上 LB，四边对齐，按 10 秒。
4. 被剖成两半的磁铁袋合好了，再装磁铁（极性看盘面图）。

**【做触摸块】**
1. 线从 Tbody 的出线口（槽或孔）穿进腔里，从腔口拉出 2–3 cm。
2. 线头剥 2 mm，在瓷砖上焊到 6×6 mm 铜箔的小尾巴上。
3. 铜箔贴在 Tlid（薄盖）内侧正中。
4. 插 USB，串口按 `t`，隔着盖子摸一下，对应的 E 要跳。记下数字，拔 USB。
5. 把多余的线推回腔里，Tlid 四边涂一圈薄胶，合到 Tbody 上，按 10 秒。

## 顺序：先短的，后长的

| 步 | 线 | 依次做 | 颜色 |
|---|---|---|---|
| 1 | E3 绿 · 左脸颊 | 触摸块 **57**（出线口在后，盖在前） | 薰衣草紫 |
| 2 | E4 红 · 右脸颊 | 触摸块 **61**（出线口在后，盖在前） | 薰衣草紫 |
| 3 | E10 白+2道 · 鼻尖 | 触摸块 **70**（出线口在后，盖在前） | 胭脂雪 |
| 4 | E6 蓝+1道 · 左侧身 | 线槽块 **54**（右进 → 前出）→ 触摸块 **56**（出线口在后，盖在左） | 胭脂雪 → 胭脂雪 |
| 5 | E7 黄+1道 · 右侧身 | 线槽块 **55**（左进 → 前出）→ 触摸块 **62**（出线口在后，盖在右） | 紫 → 紫 |
| 6 | E9 绿+1道 · 底座边缘 | 线槽块 **15**（上进 → 下出）→ 触摸块 **7**（出线口在上，盖在下） | 紫 → 白 |
| 7 | E5 黑 · 额头 | 线槽块 **143**（下进 → 上出）→ 线槽块 **180**（下进 → 前出）→ 触摸块 **184**（出线口在后，盖在前） | 宁静蓝 ×3 |
| 8 | E1 蓝 · 伞盖左缘 | 线槽块 **96**（右进 → 上出）→ 线槽块 **123**（右进 → 左出）→ 触摸块 **137**（出线口在右，盖在左） | 宁静蓝 ×3 |
| 9 | E2 黄 · 伞盖右缘 | 线槽块 **97**（左进 → 上出）→ 线槽块 **124**（左进 → 右出）→ 触摸块 **138**（出线口在左，盖在右） | 紫 → 宁静蓝 → 宁静蓝 |
| 10 | E0 白 · 头顶 | 线槽块 **154**（下进 → 上出）→〔头里空腔，留够线〕→ 线槽块 **296**（下进 → 上出）→ 触摸块 **308**（出线口在下，盖在上） | 宁静蓝 → 深绿 → 深绿 |
| 11 | E11 红+1道 · 后脑勺 | 线槽块 **134**（下进 → 上出）→〔头里空腔，留够线〕→ 触摸块 **236**（出线口在前，盖在后） | 宁静蓝 → 深绿 |
| 12 | E8 白+1道 · 背后 | 不经过方块：铜箔卡片 + 魔术贴，贴门板内侧 | — |

另外 3 颗薰衣草紫 **47、48、60** 没有线，拼到时直接换掉旧的同序号方块。

## 注意

- 两颗方块之间别把线拉紧，每段留 1–2 cm 松量。拼身体时方块要能放进自己的位置，多余的线最后从主板那头收回去。
- 第 10、11 步中间那段线要穿过头里的空腔。两颗方块之间先多留 5 cm，拼到头部时再调整。
- 每做完一路，就在 `touch_routes.png` 上把那一格打个勾。
