acrux-yueyao/Mycelium/hardware/print/moony_touch_v9/J7_wiring.txt

J7 接线表(E 编号 = 触摸点顺序,12 路全用)
线:SCHDRA 30AWG PVC(外径 1.1 mm),每颗线槽块只走 1 根
长度已含拉出门板的约 10 cm 余量;颜色重复的线两头缠纸胶带,并写上 E 编号

E0   ← 触摸点  1 头顶      方块 C-05 @ (6, 15, 7)   白            30 cm
E1   ← 触摸点  2 伞盖左缘  方块 C-20 @ (0, 8, 6)    蓝            30 cm
E2   ← 触摸点  3 伞盖右缘  方块 C-10 @ (13, 8, 6)   黄            25 cm
E3   ← 触摸点  4 左脸颊    方块 C-33 @ (5, 4, 7)    绿            20 cm
E4   ← 触摸点  5 右脸颊    方块 C-33 @ (9, 4, 7)    红            15 cm
E5   ← 触摸点  6 额头      方块 C-17 @ (6, 9, 7)    黑            25 cm
E6   ← 触摸点  8 左侧身    方块 C-27 @ (4, 4, 7)    蓝 + 1 道胶带  20 cm
E7   ← 触摸点  9 右侧身    方块 C-17 @ (10, 4, 7)   黄 + 1 道胶带  15 cm
E8   ← 触摸点 10 背后      门板内侧铜箔(可拆卡片)  白 + 1 道胶带  20 cm
E9   ← 触摸点 11 底座边缘  方块 C-36 @ (7, 0, 6)    绿 + 1 道胶带  20 cm
E10  ← 触摸点  7 鼻尖      方块 C-33 @ (7, 5, 7)    白 + 2 道胶带  20 cm
E11  ← 触摸点 12 后脑勺    方块 C-30 @ (7, 11, 4)   红 + 1 道胶带  30 cm

注意:154 号原来是"可拆外饰",现在有线穿过,拼的时候要和骨架一起粘死。
注意:70 号(鼻尖)原来是改型块,现在改成两件式触摸块,用这套里的 70Tbody/70Tlid。
