acrux-yueyao/Mycelium/public/installation-manuscript.pdf

M Y C E L I U M · T H E W H I S P E R N E T W O R K

# The Living Installation 活体装置 — design manuscript

### Concept sheets for the gallery build, where the digital

colony's aggregated emotion drives a real fungal culture.

### Plan, elevations, a cutaway, and a coloured perspective —

marker-concept drawings, not photographs.

tender · h24 | calm · h205 | curious · h32 | dreamy · h268 | companion · h158 | lonely · h222

Leader labels · dimension lines in metres · N.T.S. · six family hues double as the chamber's grow-light colour.

# MYCELIUM

# The Living Installation

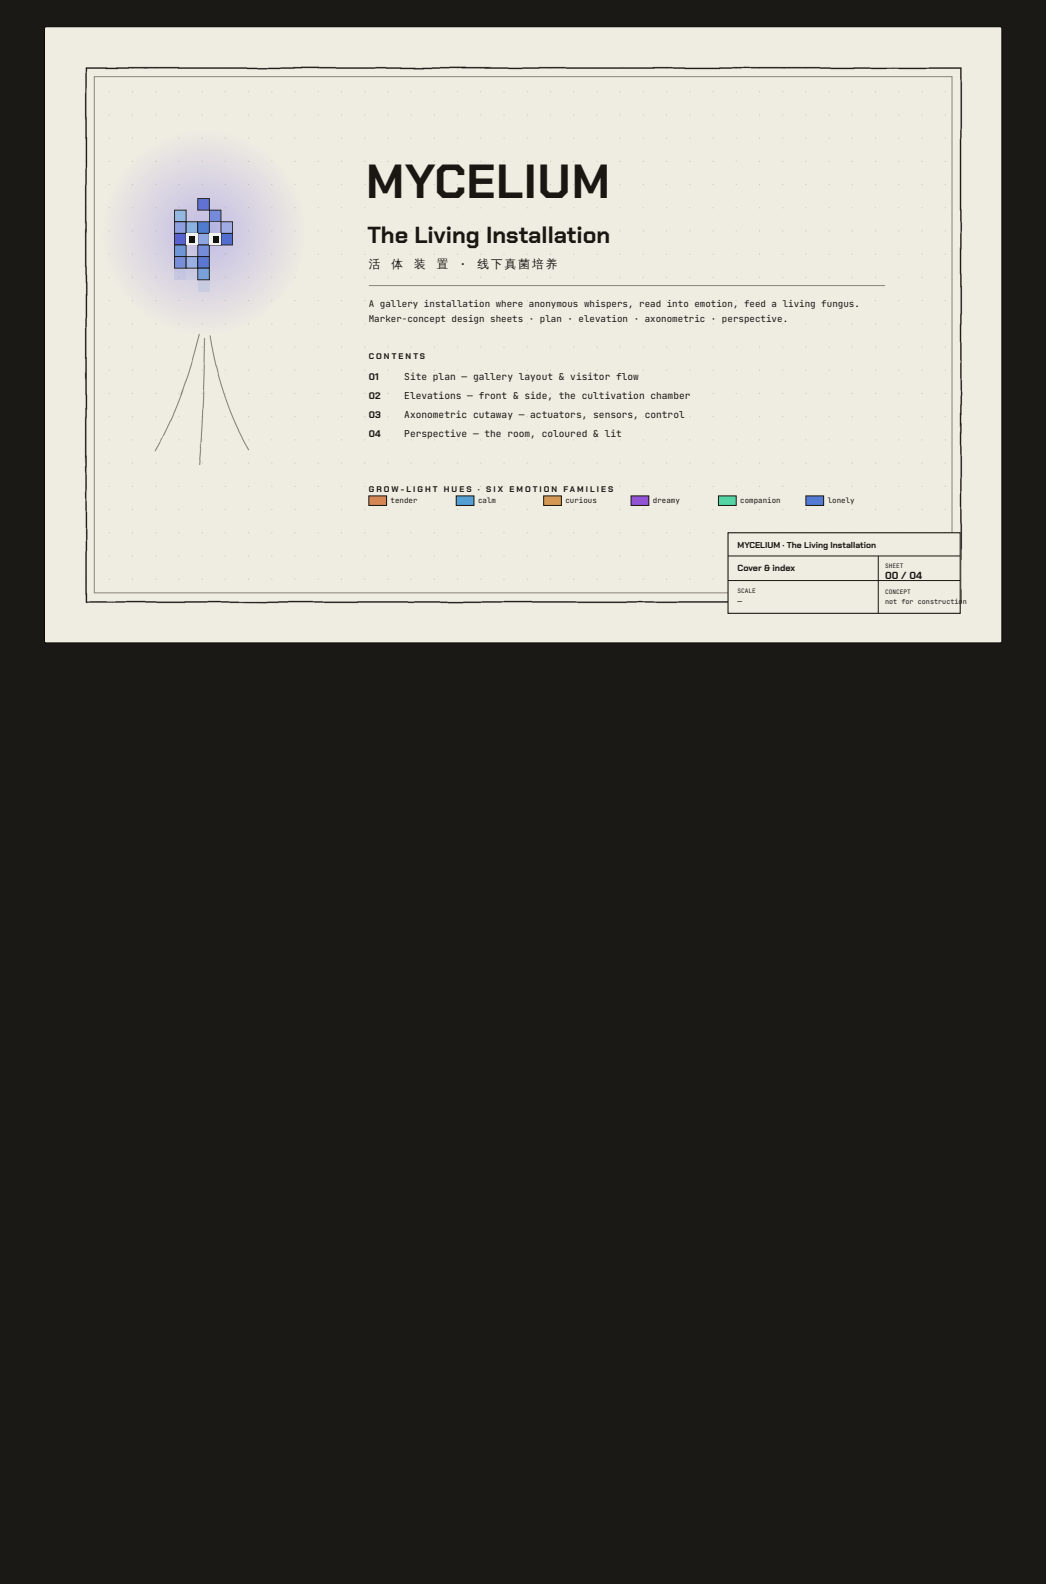
[picture p107: page 2]
tender; calm; curious; dreamy; companion; lonely

A gallery installation where anonymous whispers, read into emotion, feed a living fungus.
Marker-concept design sheets · plan · elevation · axonometric · perspective.

01 Site plan — gallery layout & visitor flow
02 Elevations — front & side, the cultivation chamber
03 Axonometric cutaway — actuators, sensors, control
04 Perspective — the room, coloured & lit

MYCELIUM · The Living Installation

Cover & index | SHEET 00 / 04

SCALE

CONCEPT
not for construction

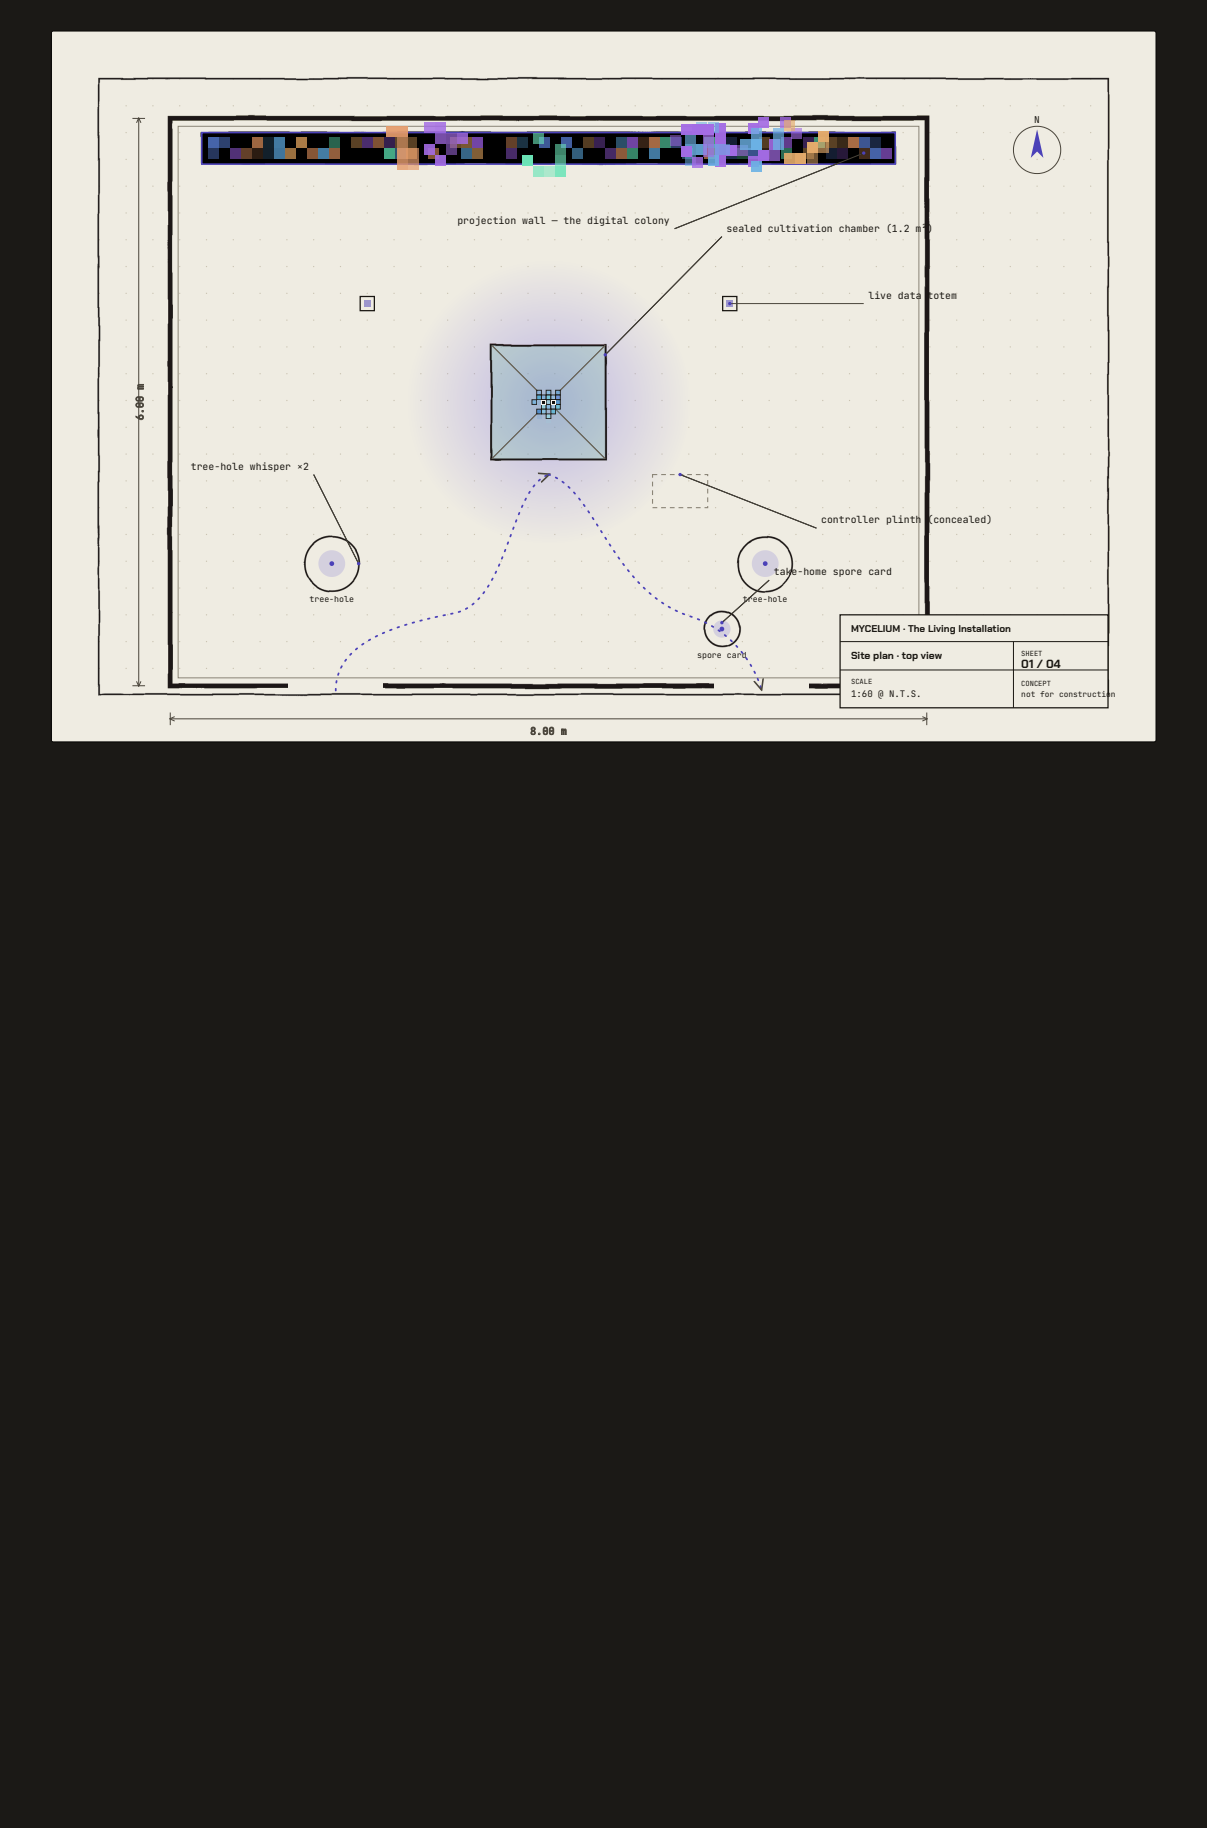
[picture p108: page 3]
tree-hole; spore card; SCALE 1:60 @ N.T.S.

projection wall — the digital colony

sealed cultivation chamber (1.2 m²)

live data totem

tree-hole whisper ×2

controller plinth (concealed)

take-home spore card

MYCELIUM · The Living Installation

Site plan · top view | SHEET 01 / 04

CONCEPT not for construction

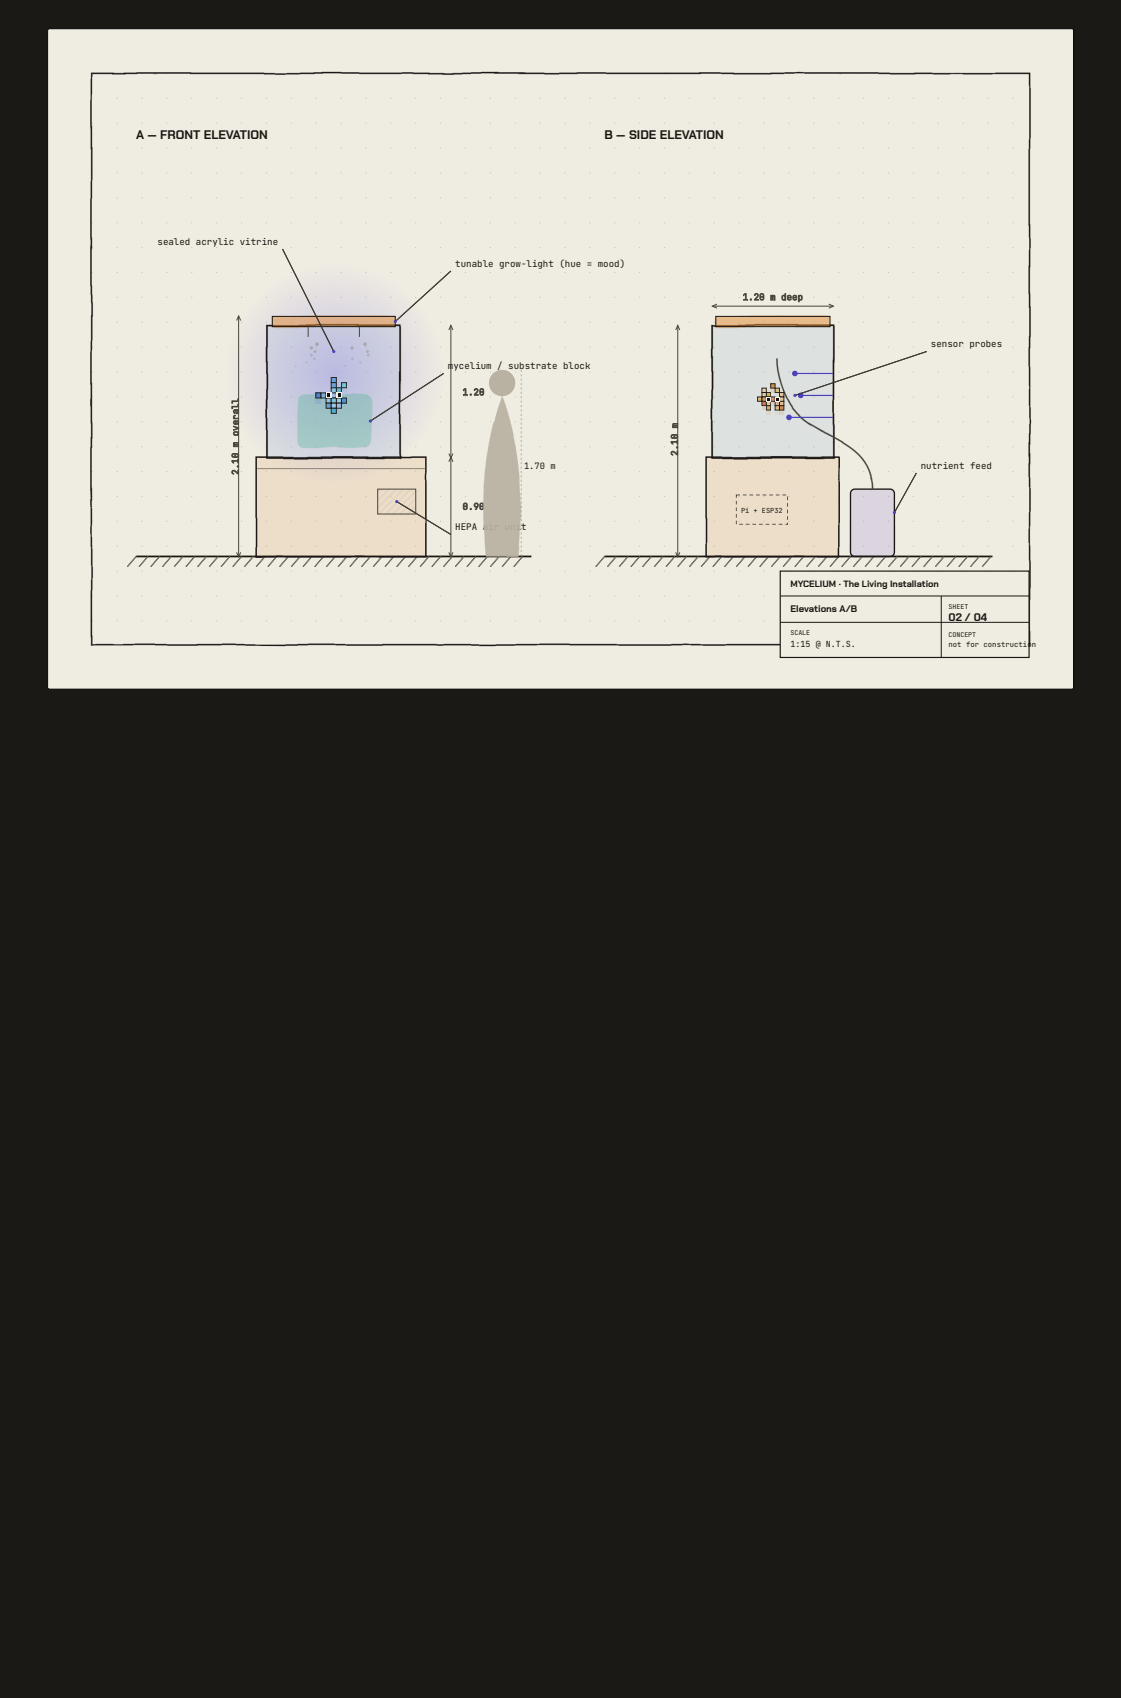
[picture p109: page 4]
A — FRONT ELEVATION; 2.10 m overall 2.10 m overall; B — SIDE ELEVATION; Pi + ESP32; 11..2200 mm ddeeeepp; nutrient feed; sensor probes; Elevations A/B; SCALE 1:15 @ N.T.S.; SHEET 02 / 04

sealed acrylic vitrine

tunable grow-light (hue = mood)

mycelium / substrate block

HEPA air unit

MYCELIUM · The Living Installation

CONCEPT
not for construction

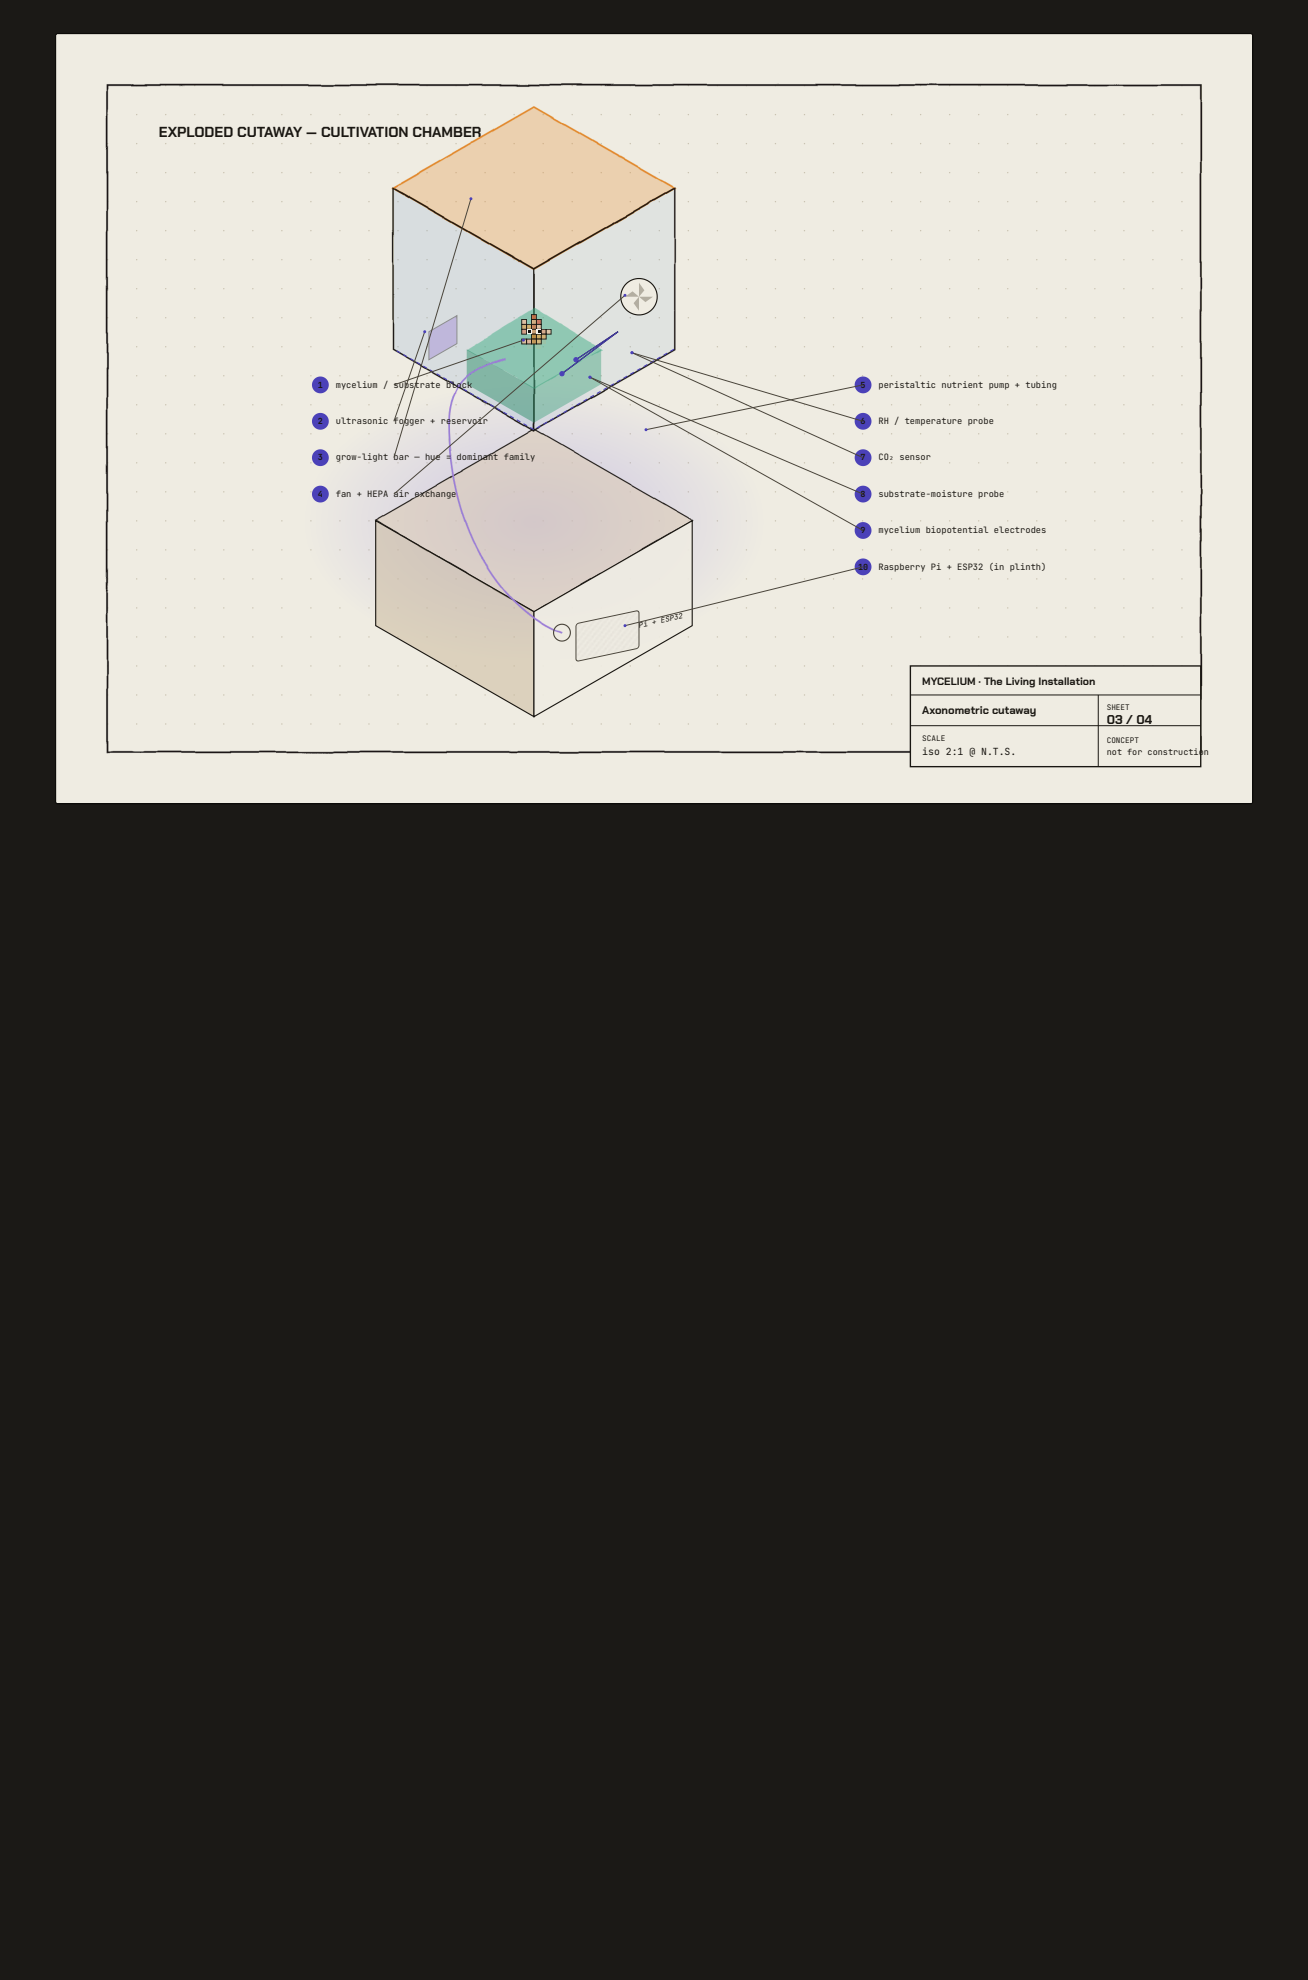
[picture p110: page 5]
Pi + ESP32; 7 CO₂ sensor

EXPLODED CUTAWAY — CULTIVATION CHAMBER

1 mycelium / substrate block

5 peristaltic nutrient pump + tubing

2 ultrasonic fogger + reservoir

6 RH / temperature probe

3 grow-light bar — hue = dominant family

4 fan + HEPA air exchange

8 substrate-moisture probe

9 mycelium biopotential electrodes

10 Raspberry Pi + ESP32 (in plinth)

MYCELIUM · The Living Installation

Axonometric cutaway | SHEET 03 / 04

SCALE iso 2:1 @ N.T.S. | CONCEPT not for construction

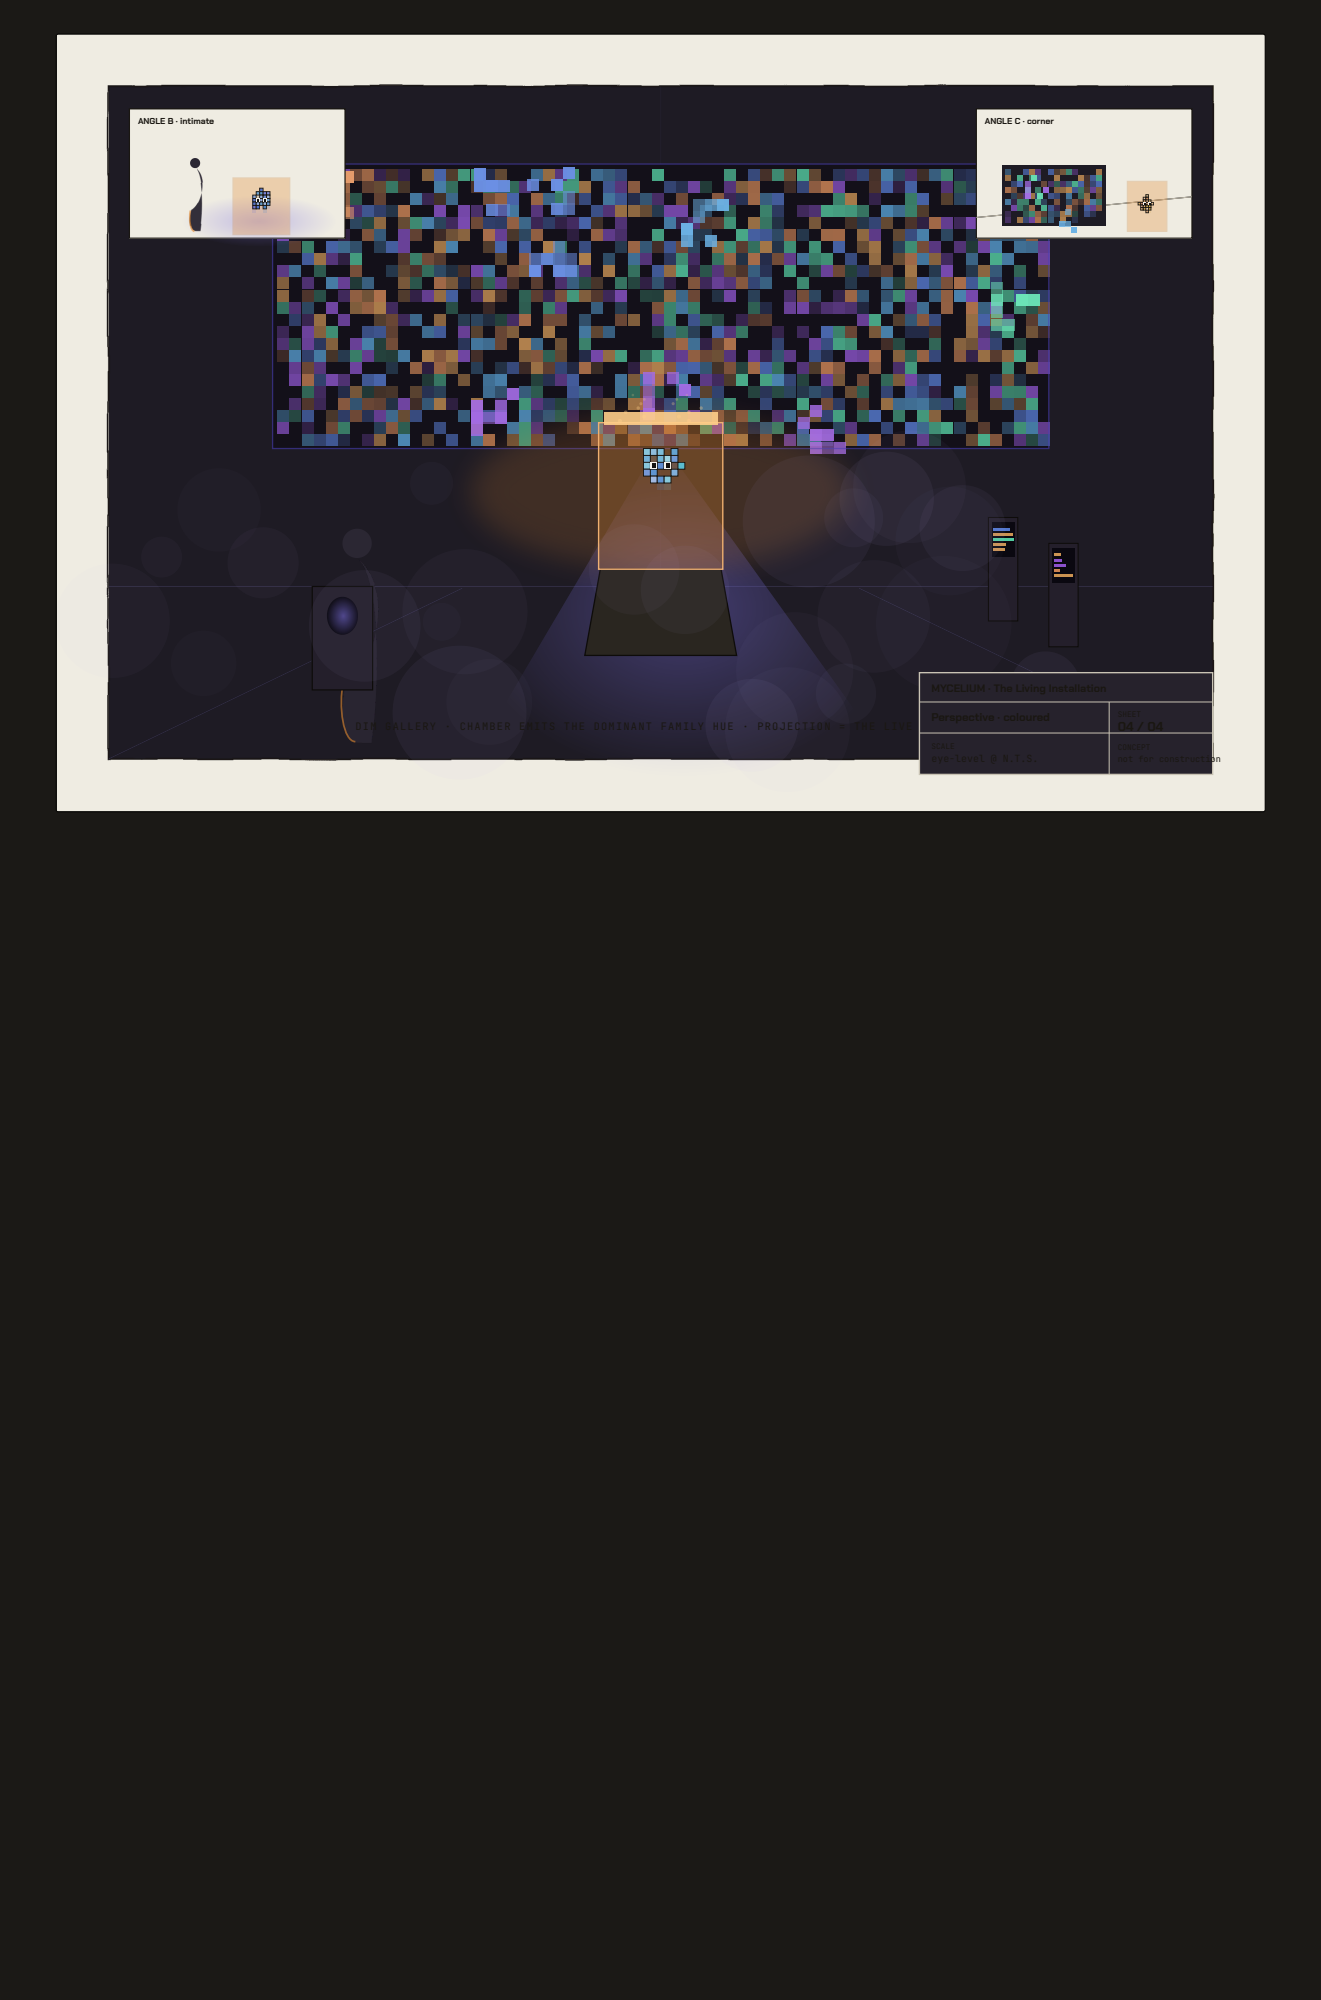
[picture p111: page 6]
ANGLE B · intimate; ANGLE C · corner; DIM GALLERY · CHAMBER EMITS THE DOMINANT FAMILY HUE · PROJECTION = THE LIVE; COLONY

MYCELIUM · The Living Installation

Perspective · coloured | SHEET 04 / 04

SCALE eye-level @ N.T.S. | CONCEPT not for construction

Marker-concept design manuscript — not photographs and not construction drawings. Dimensions are indicative; the software data bridge (/api/pulse, /api/bio) is built, the physical build is staged. Biosafety (sealed HEPA chamber, autoclaved substrate, food-safe low-spore species) and privacy (projection shows only the emotion reading, never the sentence) are designed in.
