acrux-yueyao/Mycelium/hardware/print/moony_touch_v9/线路卡/拼装图_每条线.pdf

76 | 77
74 | 75
67 | 68 | 69 | 70 | 71 | 72 | 73
65 | →主板 主板空腔 ▼ 背面(靠近你) | | | | | 66
63 | | | | | | 64

## 70:触摸块(Tbody+Tlid),线从【后】进腔,盖子朝【前】

← 你的左手 | ▲ 正面(远离你) | 你的右手 →

# 第 6 层(从下往上)

# E10 · 鼻尖 · 线 白 + 2 道胶带 · 20 cm

## 从主板往外:70。按拼装顺序从下往上,每张是这条线经过的一层;粗框 = 这条线的方块,粗线 = 走线,↑↓ = 线在这里竖着去上/下一层。站在机器人背后拼。

# 第 5 层(从下往上)

# E6 · 左侧身 · 线 蓝 + 1 道胶带 · 20 cm

## 从主板往外:54 → 56。按拼装顺序从下往上,每张是这条线经过的一层;粗框 = 这条线的方块,粗线 = 走线,↑↓ = 线在这里竖着去上/下一层。站在机器人背后拼。

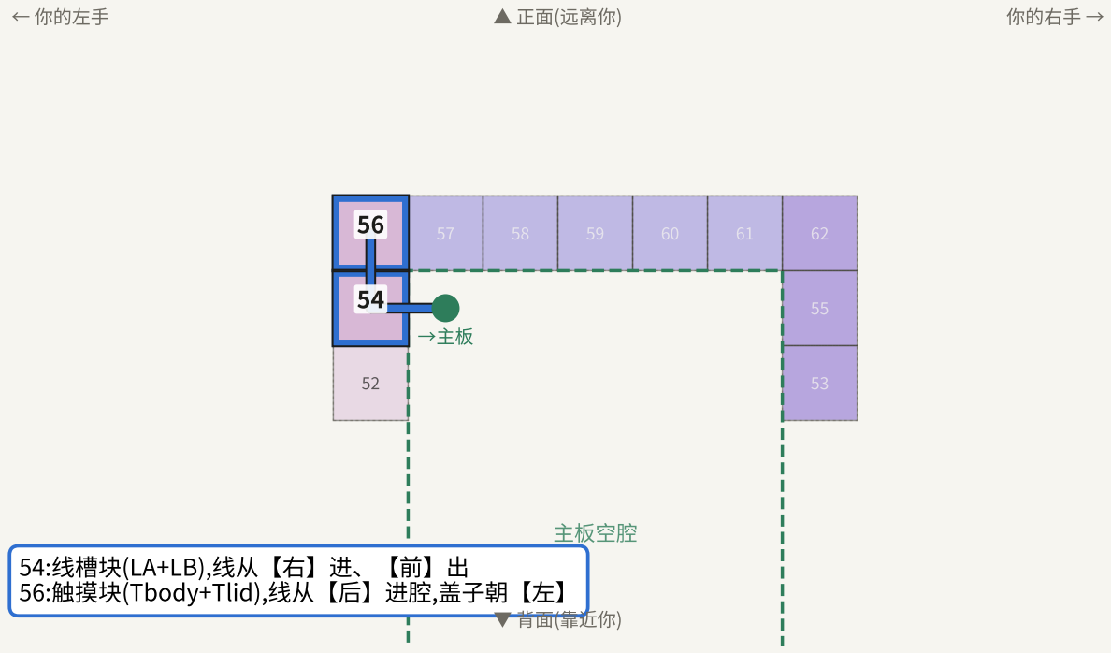
[picture p112: figure]
→主板 主板空腔 ▼ 背面(靠近你); 54:线槽块(LA+LB),线从【右】进、【前】出 56:触摸块(Tbody+Tlid),线从【后】进腔,盖子朝【左】; ← 你的左手; ▲ 正面(远离你); 你的右手 →

# 第 5 层(从下往上)

# E7 · 右侧身 · 线 黄 + 1 道胶带 · 15 cm

## 从主板往外:55 → 62。按拼装顺序从下往上,每张是这条线经过的一层;粗框 = 这条线的方块,粗线 = 走线,↑↓ = 线在这里竖着去上/下一层。站在机器人背后拼。

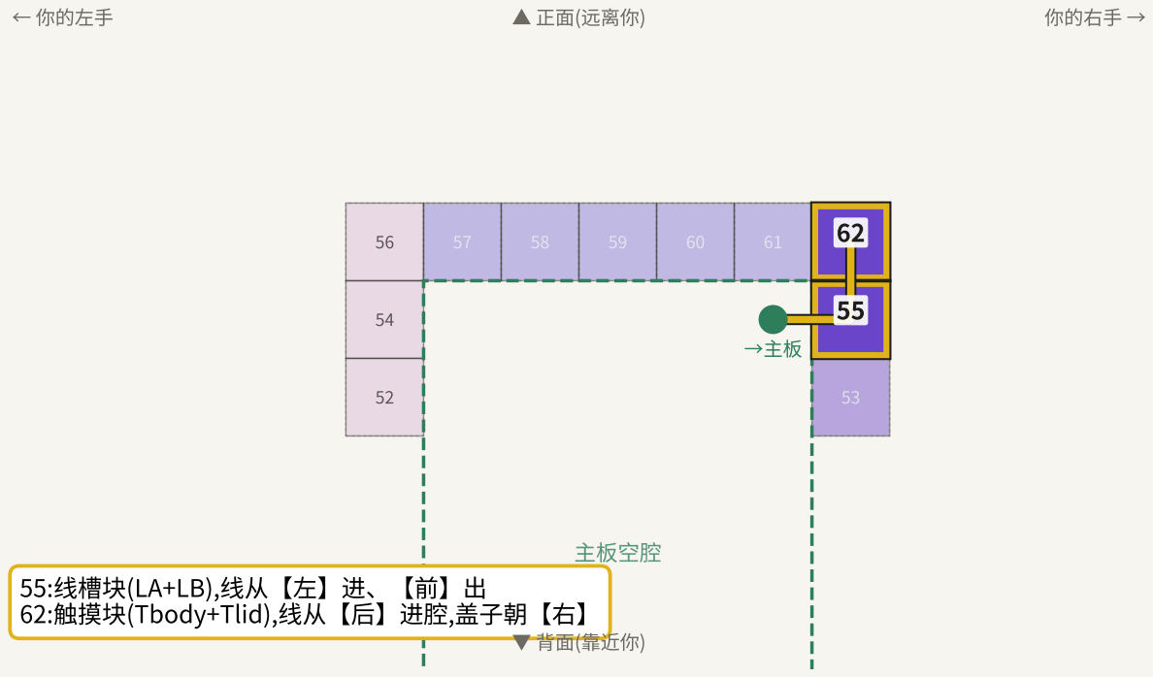
[picture p113: figure]
主板空腔 ▼ 背面(靠近你); 55:线槽块(LA+LB),线从【左】进、【前】出 62:触摸块(Tbody+Tlid),线从【后】进腔,盖子朝【右】; ← 你的左手; ▲ 正面(远离你); 你的右手 →

# 第 1 层(从下往上)

# 第 2 层(从下往上)

# E9 · 底座边缘 · 线 绿 + 1 道胶带 · 20 cm

## 从主板往外:15 → 7。按拼装顺序从下往上,每张是这条线经过的一层;粗框 = 这条线的方块,粗线 = 走线,↑↓ = 线在这里竖着去上/下一层。站在机器人背后拼。

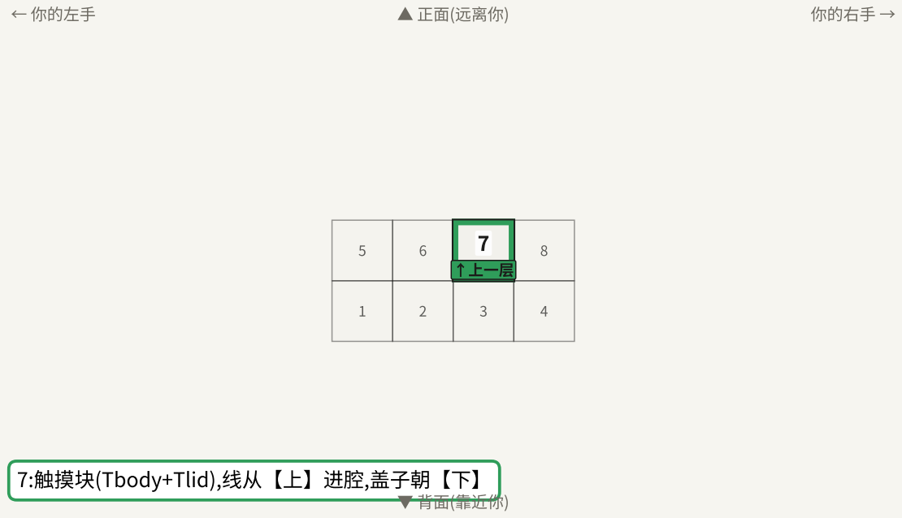
[picture p114: figure]
7:触摸块(Tbody+Tlid),线从【上】进腔,盖子朝【下】; ← 你的左手; ▲ 正面(远离你); 你的右手 →; ▼ 背面(靠近你); 7 ↑上一层
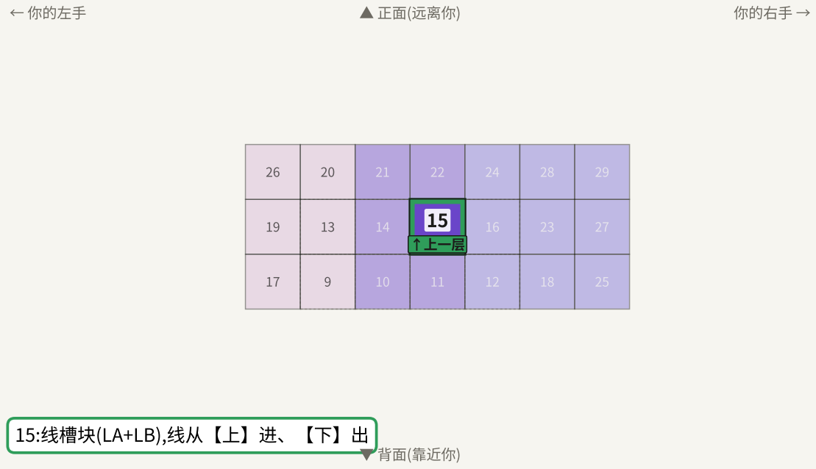
[picture p115: figure]
15:线槽块(LA+LB),线从【上】进、【下】出; ← 你的左手; ▲ 正面(远离你); 你的右手 →; ▼ 背面(靠近你); 15 ↓下一层 ↑上

# 第 9 层(从下往上)

# 第 10 层(从下往上)

# E5 · 额头 · 线 黑 · 25 cm

从主板往外:143 → 180 → 184。按拼装顺序从下往上,每张是这条线经过的一层;粗框 = 这条线的方块,粗线 = 走线,↑↓ = 线在这里竖着去上/下一层。站在机器人背后拼。

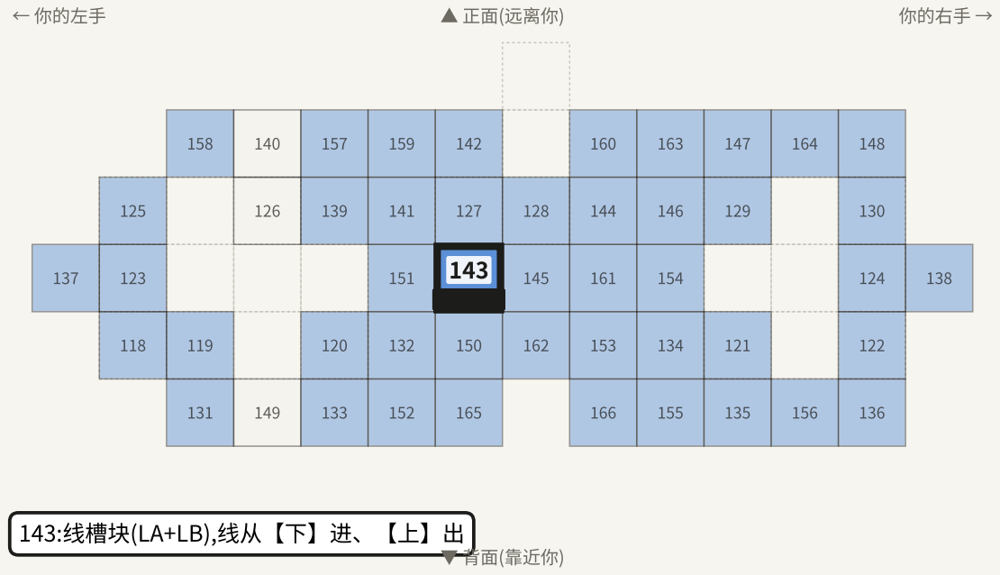
[picture p116: figure]
143:线槽块(LA+LB),线从【下】进、【上】出; ← 你的左手; ▲ 正面(远离你); 你的右手 →; ▼ 背面(靠近你); 143 ↑上一层 ↓下
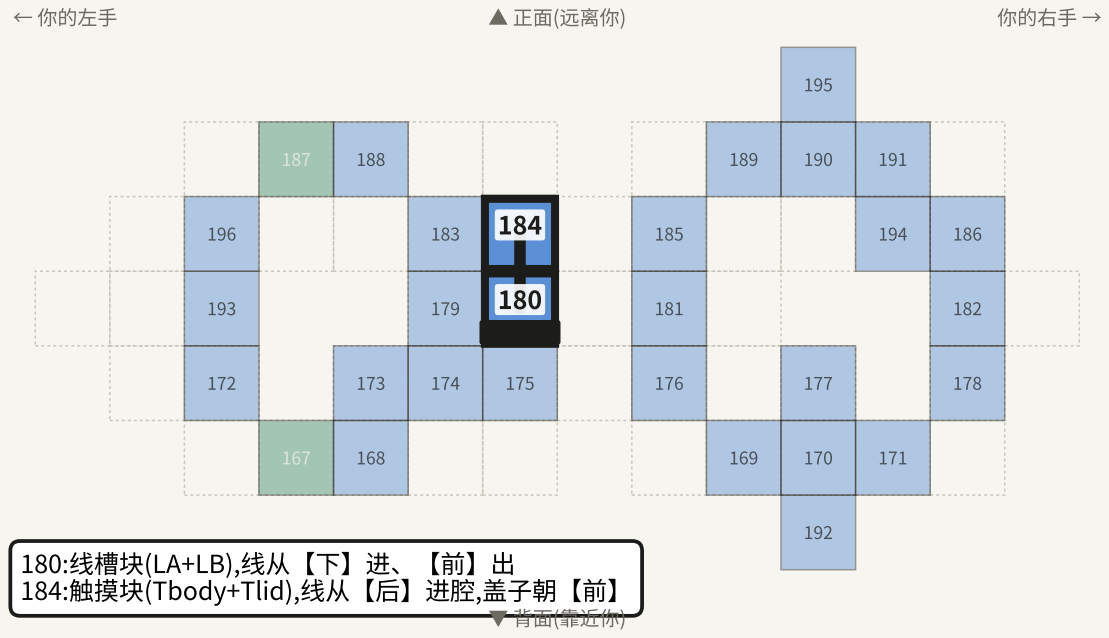
[picture p117: figure]
180:线槽块(LA+LB),线从【下】进、【前】出 184:触摸块(Tbody+Tlid),线从【后】进腔,盖子朝【前】; ← 你的左手; ▲ 正面(远离你); 你的右手 →; ▼ 背面(靠近你); ↓下一层

# 第 8 层(从下往上)

# 第 9 层(从下往上)

# E1 · 伞盖左缘 · 线 蓝 · 30 cm

从主板往外:96 → 123 → 137。按拼装顺序从下往上,每张是这条线经过的一层;粗框 = 这条线的方块,粗线 = 走线,↑↓ = 线在这里竖着去上/下一层。站在机器人背后拼。

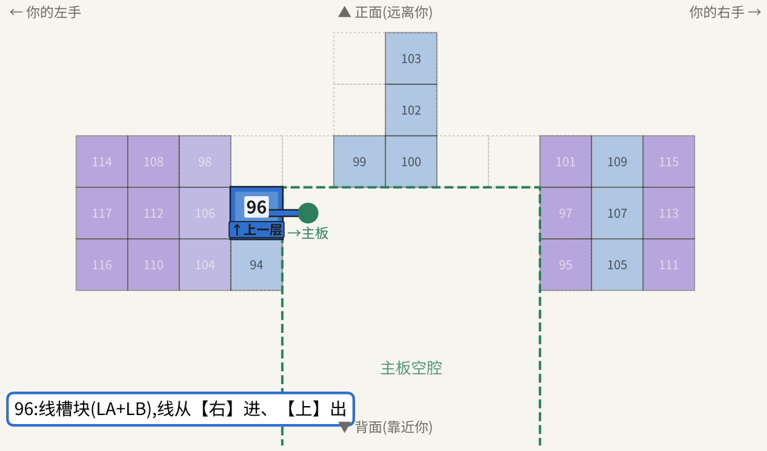
[picture p118: figure]
主板空腔; 96:线槽块(LA+LB),线从【右】进、【上】出; ← 你的左手; ▲ 正面(远离你); 你的右手 →; ▼ 背面(靠近你); 96 ↑上一层
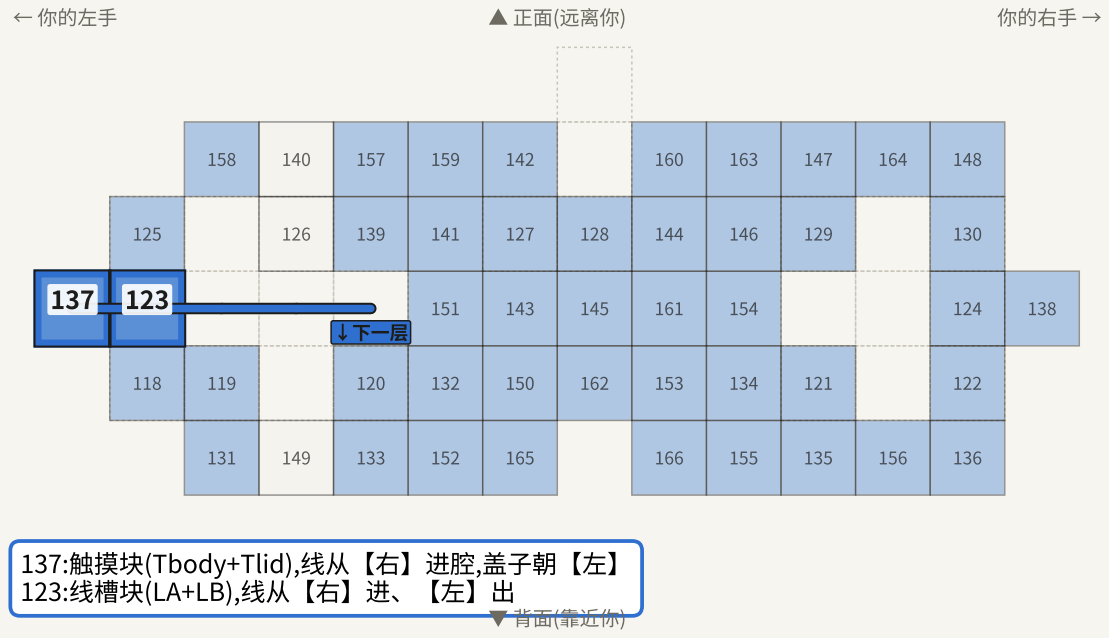
[picture p119: figure]
137:触摸块(Tbody+Tlid),线从【右】进腔,盖子朝【左】 123:线槽块(LA+LB),线从【右】进、【左】出; ← 你的左手; ▲ 正面(远离你); 你的右手 →; ▼ 背面(靠近你); ↓下一层

# 第 8 层(从下往上)

# 第 9 层(从下往上)

# E2 · 伞盖右缘 · 线 黄 · 25 cm

从主板往外:97 → 124 → 138。按拼装顺序从下往上,每张是这条线经过的一层;粗框 = 这条线的方块,粗线 = 走线,↑↓ = 线在这里竖着去上/下一层。站在机器人背后拼。

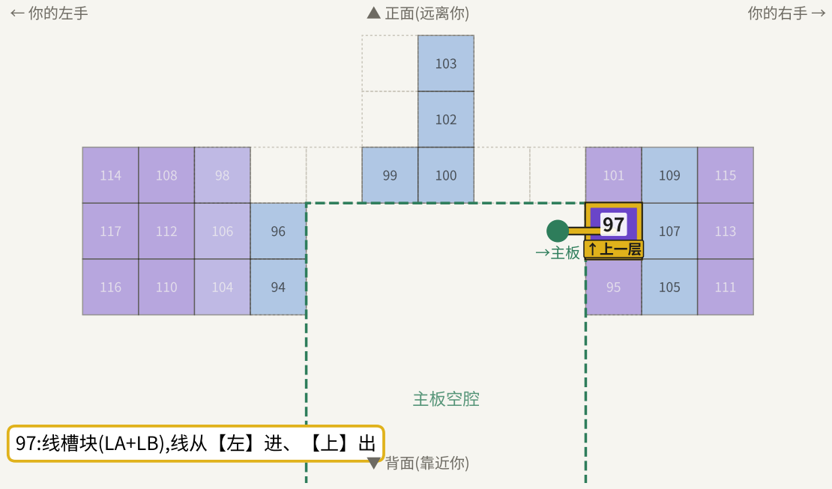
[picture p120: figure]
主板空腔; 97:线槽块(LA+LB),线从【左】进、【上】出; ← 你的左手; ▲ 正面(远离你); 你的右手 →; ▼ 背面(靠近你); 97 ↑上一层
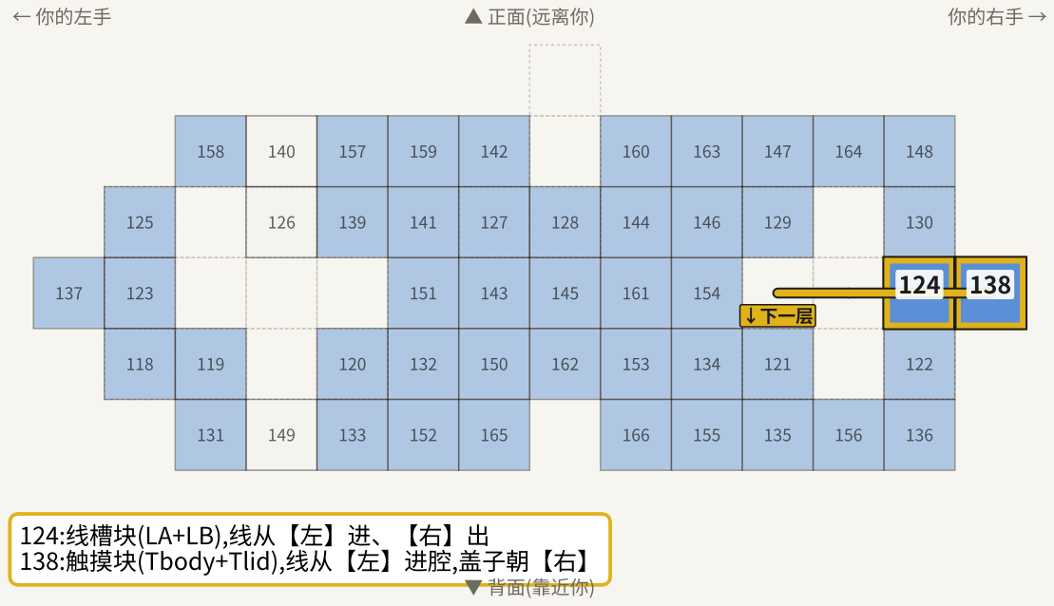
[picture p121: figure]
124:线槽块(LA+LB),线从【左】进、【右】出 138:触摸块(Tbody+Tlid),线从【左】进腔,盖子朝【右】; ← 你的左手; ▲ 正面(远离你); 你的右手 →; ▼ 背面(靠近你); ↓下一层

# 第 9 层(从下往上)

# 第 15 层(从下往上)

# 第 16 层(从下往上)

# E0 · 头顶 · 线 白 · 30 cm

从主板往外:154 → 296 → 308。按拼装顺序从下往上,每张是这条线经过的一层;粗框 = 这条线的方块,粗线 = 走线,↑↓ = 线在这里竖着去上/下一层。站在机器人背后拼。

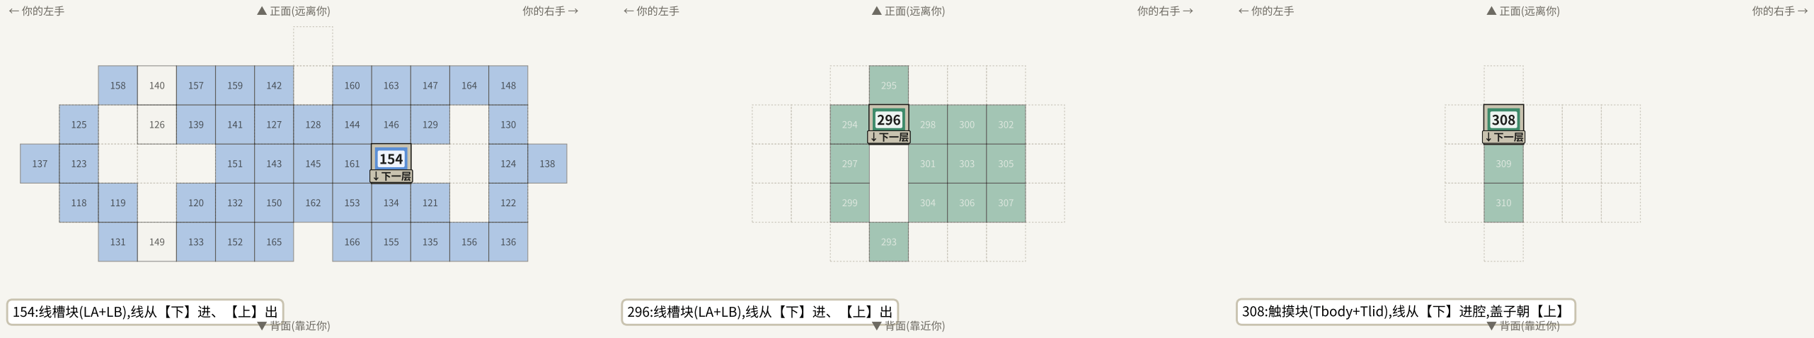
[picture p122: figure]
154:线槽块(LA+LB),线从【下】进、【上】出; ← 你的左手; ▲ 正面(远离你); 你的右手 →; ▼ 背面(靠近你); 154 ↑上一层 ↓下; 296:线槽块(LA+LB),线从【下】进、【上】出; 296 ↑上一层 ↓下; 308:触摸块(Tbody+Tlid),线从【下】进腔,盖子朝【上】; 308 ↓下一层

# 第 9 层(从下往上)

# 第 12 层(从下往上)

# E11 · 后脑勺 · 线 红 + 1 道胶带 · 30 cm

## 从主板往外:134 → 236。按拼装顺序从下往上,每张是这条线经过的一层;粗框 = 这条线的方块,粗线 = 走线,↑↓ = 线在这里竖着去上/下一层。站在机器人背后拼。

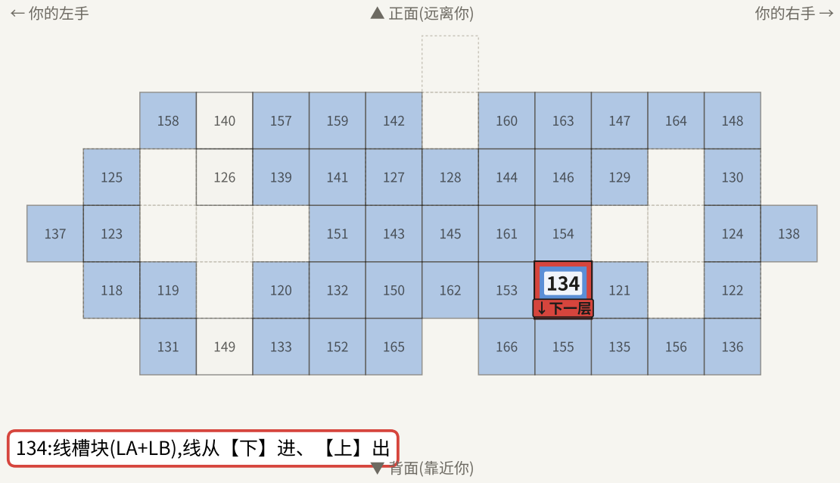
[picture p123: figure]
134:线槽块(LA+LB),线从【下】进、【上】出; ← 你的左手; ▲ 正面(远离你); 你的右手 →; ▼ 背面(靠近你); 134 ↑上一层 ↓下
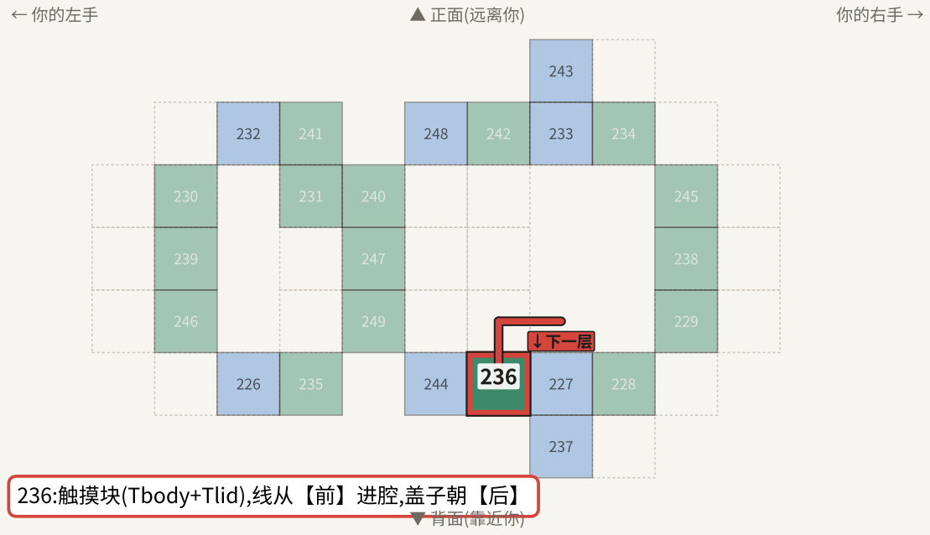
[picture p124: figure]
236:触摸块(Tbody+Tlid),线从【前】进腔,盖子朝【后】; ← 你的左手; ▲ 正面(远离你); 你的右手 →; ▼ 背面(靠近你); ↓下一层
