acrux-yueyao/Mycelium/hardware/print/moony_touch_v9/线路卡/线路卡_全部.pdf

# 主板 J7

# E10 孔(从上往下第 11 个)

### 70 胭脂雪

# 触摸块 · 2 件 70Tbody + 70Tlid

刻字 33 · 线从【后】进腔 · 盖子(摸的面)在【前】

Tbody 方腔那面

## Tlid 薄盖 1.2 mm

铜箔贴在这面

70

在身体上的位置(正面投影,以序号为准)

# E10 · 鼻尖

线:白 + 2 道胶带 · 剪 20 cm · 从主板往外穿,最后一站是触摸块

→

步骤(先把线从主板这头往外穿,一站一站来)

1. 70(触摸块,胭脂雪):线从【后】的出线口进腔,拉出 2–3 cm 焊铜箔,铜箔贴在 70Tlid 内侧,按 e 测过再粘盖。
2. 插 USB,按 e 选到 E10,隔着盖子按住:信号 10 以上、显示「摸到」→ 粘盖。

站与站之间的线别拉紧,留 1–2 cm;拼身体时多余的线从主板那头收回去。

# 主板 J7

E6 孔(从上往下第 7 个)

### 54 胭脂雪

# 线槽块 · 2 件 54LA + 54LB

刻字 0F · 主板那头从【右】进,从【前】出

LA 剖面(有槽,线放这里) LB 剖面(平的,盖上去)

### 56 胭脂雪

# 触摸块 · 2 件 56Tbody + 56Tlid

刻字 27 · 线从【后】进腔 · 盖子(摸的面)在【左】

Tbody 方腔那面

## Tlid 薄盖 1.2 mm

铜箔贴在这面

564

在身体上的位置(正面投影,以序号为准)

# E6 · 左侧身

线:蓝 + 1 道胶带 · 剪 20 cm · 从主板往外穿,最后一站是触摸块

→ | →

步骤(先把线从主板这头往外穿,一站一站来)

1. 54(线槽块,胭脂雪):线放进 54LA 的槽,从【右】面进、【前】面出;剖面涂胶避开槽,合上 54LB,装磁铁。
2. 56(触摸块,胭脂雪):线从【后】的出线口进腔,拉出 2–3 cm 焊铜箔,铜箔贴在 56Tlid 内侧,按 e 测过再粘盖。
3. 插 USB,按 e 选到 E6,隔着盖子按住:信号 10 以上、显示「摸到」→ 粘盖。

站与站之间的线别拉紧,留 1–2 cm;拼身体时多余的线从主板那头收回去。

# 主板 J7

E7 孔(从上往下第 8 个)

# 55 紫

# 线槽块 · 2 件 55LA + 55LB

刻字 0F · 主板那头从【左】进,从【前】出

LA 剖面(有槽,线放这里) LB 剖面(平的,盖上去)

# 62 紫

# 触摸块 · 2 件 62Tbody + 62Tlid

刻字 17 · 线从【后】进腔 · 盖子(摸的面)在【右】

Tbody 方腔那面

## Tlid 薄盖 1.2 mm

铜箔贴在这面

6255

在身体上的位置(正面投影,以序号为准)

# E7 · 右侧身

线:黄 + 1 道胶带 · 剪 15 cm · 从主板往外穿,最后一站是触摸块

→ | →

步骤(先把线从主板这头往外穿,一站一站来)

1. 55(线槽块,紫):线放进 55LA 的槽,从【左】面进、【前】面出;剖面涂胶避开槽,合上 55LB,装磁铁。
2. 62(触摸块,紫):线从【后】的出线口进腔,拉出 2–3 cm 焊铜箔,铜箔贴在 62Tlid 内侧,按 e 测过再粘盖。
3. 插 USB,按 e 选到 E7,隔着盖子按住:信号 10 以上、显示「摸到」→ 粘盖。

站与站之间的线别拉紧,留 1–2 cm;拼身体时多余的线从主板那头收回去。

# 主板 J7

E9 孔(从上往下第 10 个)

# 15 紫

# 线槽块 · 2 件 15LA + 15LB

刻字 3D · 主板那头从【上】进,从【下】出

LA 剖面(有槽,线放这里) LB 剖面(平的,盖上去)

# 7 白

# 触摸块 · 2 件 7Tbody + 7Tlid

刻字 36 · 线从【上】进腔 · 盖子(摸的面)在【下】

Tbody 方腔那面

## Tlid 薄盖 1.2 mm

铜箔贴在这面

15
| 7

在身体上的位置(正面投影,以序号为准)

# E9 · 底座边缘

线:绿 + 1 道胶带 · 剪 20 cm · 从主板往外穿,最后一站是触摸块

→ | →

步骤(先把线从主板这头往外穿,一站一站来)

1. 15(线槽块,紫):线放进 15LA 的槽,从【上】面进、【下】面出;剖面涂胶避开槽,合上 15LB,装磁铁。
2. 7(触摸块,白):线从【上】的出线口进腔,拉出 2–3 cm 焊铜箔,铜箔贴在 7Tlid 内侧,按 e 测过再粘盖。
3. 插 USB,按 e 选到 E9,隔着盖子按住:信号 10 以上、显示「摸到」→ 粘盖。

站与站之间的线别拉紧,留 1–2 cm;拼身体时多余的线从主板那头收回去。

# 主板 J7

E5 孔(从上往下第 6 个)

# 143 宁静蓝

# 线槽块 · 2 件 143LA + 143LB

刻字 36 · 主板那头从【下】进,从【上】出

LA 剖面(有槽,线放这里) LB 剖面(平的,盖上去)

# 180 宁静蓝

# 线槽块 · 2 件 180LA + 180LB

刻字 1F · 主板那头从【下】进,从【前】出

LA 剖面(有槽,线放这里) LB 剖面(平的,盖上去)

# 184 宁静蓝

# 触摸块 · 2 件 184Tbody + 184Tlid

刻字 17 · 线从【后】进腔 · 盖子(摸的面)在【前】

Tbody 方腔那面

## Tlid 薄盖 1.2 mm

铜箔贴在这面

184 180
143

在身体上的位置(正面投影,以序号为准)

# E5 · 额头

线:黑 · 剪 25 cm · 从主板往外穿,最后一站是触摸块

→ | → | →

步骤(先把线从主板这头往外穿,一站一站来)

1. 143(线槽块,宁静蓝):线放进 143LA 的槽,从【下】面进、【上】面出;剖面涂胶避开槽,合上 143LB,装磁铁。
2. 180(线槽块,宁静蓝):线放进 180LA 的槽,从【下】面进、【前】面出;剖面涂胶避开槽,合上 180LB,装磁铁。
3. 184(触摸块,宁静蓝):线从【后】的出线口进腔,拉出 2–3 cm 焊铜箔,铜箔贴在 184Tlid 内侧,按 e 测过再粘盖。
4. 插 USB,按 e 选到 E5,隔着盖子按住:信号 10 以上、显示「摸到」→ 粘盖。

站与站之间的线别拉紧,留 1–2 cm;拼身体时多余的线从主板那头收回去。

# 主板 J7

E1 孔(从上往下第 2 个)

### 96 宁静蓝

# 线槽块 · 2 件 96LA + 96LB

刻字 15 · 主板那头从【右】进,从【上】出

LA 剖面(有槽,线放这里) LB 剖面(平的,盖上去)

# 123 宁静蓝

# 线槽块 · 2 件 123LA + 123LB

刻字 1D · 主板那头从【右】进,从【左】出

LA 剖面(有槽,线放这里) LB 剖面(平的,盖上去)

# 137 宁静蓝

# 触摸块 · 2 件 137Tbody + 137Tlid

刻字 20 · 线从【右】进腔 · 盖子(摸的面)在【左】

Tbody 方腔那面

## Tlid 薄盖 1.2 mm

铜箔贴在这面

123
96

137

在身体上的位置(正面投影,以序号为准)

# E1 · 伞盖左缘

线:蓝 · 剪 30 cm · 从主板往外穿,最后一站是触摸块

→ | → | →

步骤(先把线从主板这头往外穿,一站一站来)

1. 96(线槽块,宁静蓝):线放进 96LA 的槽,从【右】面进、【上】面出;剖面涂胶避开槽,合上 96LB,装磁铁。
2. 123(线槽块,宁静蓝):线放进 123LA 的槽,从【右】面进、【左】面出;剖面涂胶避开槽,合上 123LB,装磁铁。
3. 137(触摸块,宁静蓝):线从【右】的出线口进腔,拉出 2–3 cm 焊铜箔,铜箔贴在 137Tlid 内侧,按 e 测过再粘盖。
4. 插 USB,按 e 选到 E1,隔着盖子按住:信号 10 以上、显示「摸到」→ 粘盖。

站与站之间的线别拉紧,留 1–2 cm;拼身体时多余的线从主板那头收回去。

# 主板 J7

E2 孔(从上往下第 3 个)

# 97 紫

# 线槽块 · 2 件 97LA + 97LB

刻字 25 · 主板那头从【左】进,从【上】出

LA 剖面(有槽,线放这里) LB 剖面(平的,盖上去)

# 124 宁静蓝

# 线槽块 · 2 件 124LA + 124LB

刻字 2F · 主板那头从【左】进,从【右】出

LA 剖面(有槽,线放这里) LB 剖面(平的,盖上去)

# 138 宁静蓝

# 触摸块 · 2 件 138Tbody + 138Tlid

刻字 10 · 线从【左】进腔 · 盖子(摸的面)在【右】

Tbody 方腔那面

## Tlid 薄盖 1.2 mm

铜箔贴在这面

124
97

138

在身体上的位置(正面投影,以序号为准)

# E2 · 伞盖右缘

线:黄 · 剪 25 cm · 从主板往外穿,最后一站是触摸块

→ | → | →

步骤(先把线从主板这头往外穿,一站一站来)

1. 97(线槽块,紫):线放进 97LA 的槽,从【左】面进、【上】面出;剖面涂胶避开槽,合上 97LB,装磁铁。
2. 124(线槽块,宁静蓝):线放进 124LA 的槽,从【左】面进、【右】面出;剖面涂胶避开槽,合上 124LB,装磁铁。
3. 138(触摸块,宁静蓝):线从【左】的出线口进腔,拉出 2–3 cm 焊铜箔,铜箔贴在 138Tlid 内侧,按 e 测过再粘盖。
4. 插 USB,按 e 选到 E2,隔着盖子按住:信号 10 以上、显示「摸到」→ 粘盖。

站与站之间的线别拉紧,留 1–2 cm;拼身体时多余的线从主板那头收回去。

# 主板 J7

E0 孔(从上往下第 1 个)

# 154 宁静蓝

# 线槽块 · 2 件 154LA + 154LB

刻字 14 · 主板那头从【下】进,从【上】出

LA 剖面(有槽,线放这里) LB 剖面(平的,盖上去)

头里的空腔
线自由穿过,多留 5 cm

296 深绿

# 线槽块 · 2 件 296LA + 296LB

刻字 3A · 主板那头从【下】进,从【上】出

LA 剖面(有槽,线放这里) LB 剖面(平的,盖上去)

308 深绿

# 触摸块 · 2 件 308Tbody + 308Tlid

刻字 05 · 线从【下】进腔 · 盖子(摸的面)在【上】

Tbody 方腔那面

## Tlid 薄盖 1.2 mm

铜箔贴在这面

296

154

308

在身体上的位置(正面投影,以序号为准)

# E0 · 头顶

线:白 · 剪 30 cm · 从主板往外穿,最后一站是触摸块

→ | → | → | →

步骤(先把线从主板这头往外穿,一站一站来)

1. 154(线槽块,宁静蓝):线放进 154LA 的槽,从【下】面进、【上】面出;剖面涂胶避开槽,合上 154LB,装磁铁。
2. 线穿过头里的空腔(不经过方块),这一段先多留 5 cm。
3. 296(线槽块,深绿):线放进 296LA 的槽,从【下】面进、【上】面出;剖面涂胶避开槽,合上 296LB,装磁铁。
4. 308(触摸块,深绿):线从【下】的出线口进腔,拉出 2–3 cm 焊铜箔,铜箔贴在 308Tlid 内侧,按 e 测过再粘盖。
5. 插 USB,按 e 选到 E0,隔着盖子按住:信号 10 以上、显示「摸到」→ 粘盖。

站与站之间的线别拉紧,留 1–2 cm;拼身体时多余的线从主板那头收回去。

# 主板 J7

# E11 孔(从上往下第 12 个)

# 134 宁静蓝

# 线槽块 · 2 件 134LA + 134LB

刻字 3C · 主板那头从【下】进,从【上】出

LA 剖面(有槽,线放这里) LB 剖面(平的,盖上去)

头里的空腔
线自由穿过,多留 5 cm

236 深绿

# 触摸块 · 2 件 236Tbody + 236Tlid

刻字 30 · 线从【前】进腔 · 盖子(摸的面)在【后】

Tbody 方腔那面

## Tlid 薄盖 1.2 mm

铜箔贴在这面

134

236

在身体上的位置(正面投影,以序号为准)

# E11 · 后脑勺

线:红 + 1 道胶带 · 剪 30 cm · 从主板往外穿,最后一站是触摸块

→ | → | →

步骤(先把线从主板这头往外穿,一站一站来)

1. 134(线槽块,宁静蓝):线放进 134LA 的槽,从【下】面进、【上】面出;剖面涂胶避开槽,合上 134LB,装磁铁。
2. 线穿过头里的空腔(不经过方块),这一段先多留 5 cm。
3. 236(触摸块,深绿):线从【前】的出线口进腔,拉出 2–3 cm 焊铜箔,铜箔贴在 236Tlid 内侧,按 e 测过再粘盖。
4. 插 USB,按 e 选到 E11,隔着盖子按住:信号 10 以上、显示「摸到」→ 粘盖。

站与站之间的线别拉紧,留 1–2 cm;拼身体时多余的线从主板那头收回去。
