acrux-yueyao/Mycelium/design/market/booth-guide-ipad.html

Mycelium

# The Whisper Network

an underground web of feeling一张地下的情绪之网

Scan to plant a spore扫码,种下一颗孢子mycelium.yueyao.design

1. 1
  Have a seat.请坐。
  Take a breath. There is no right way to do this.深呼吸一下。这里没有标准答案。
2. 2
  Type a whisper — or scan the code.输入一句悄悄话,或扫码。
  A few words about how you feel right now. A spore is born from it.写几句此刻的感受,它会长成一颗孢子。
3. 3
  Watch your spore meet the others.看你的孢子和别人相遇。
  It drifts into the field, finds kindred feelings, and grows with them.它漂进田野,找到相似的情绪,一起生长。
4. 4
  Notice what shifts inside you.感受一下内心的变化。
  Lighter? Heavier? Clearer? Leave a few words if you like.轻了?重了?清楚了一点?愿意的话留几句。
5. 5
  Take a small gift with you.带走一份小礼物。
  Thank you for sharing a moment. · Moony likes gentle pats on the head.谢谢你分享这一刻。小蘑菇 Moony 喜欢被轻轻摸头。
