acrux-yueyao/Mycelium/hardware/print/moony_touch_v9/Moony_搭建穿线说明书.pdf

# 12 路线一览

E0 头顶 | 154 → 296 → 308 | 第 9、15、16 层
E1 伞盖左缘 | 96 → 123 → 137 | 第 8、9 层
E2 伞盖右缘 | 97 → 124 → 138 | 第 8、9 层
E3 左脸颊 | 57 | 第 5 层
E4 右脸颊 | 61 | 第 5 层
E5 额头 | 143 → 180 → 184 | 第 9、10 层
E6 左侧身 | 54 → 56 | 第 5 层
E7 右侧身 | 55 → 62 | 第 5 层
E8 背后 | 门板铜箔卡片 | 最后装
E9 底座边缘 | 15 → 7 | 第 1、2 层
E10 鼻尖 | 70 | 第 6 层
E11 后脑勺 | 134 → 236 | 第 9、12 层

# Moony 搭建 + 穿线说明书

16 层,从下往上,一层一页 · 共 310 颗方块 · 12 路触摸线

【开始前】

1. 主板放在机器人背后的桌上,插着 USB。12 根触摸线从主板 J7 伸出来:背面焊点打热熔胶,线束扎在板柱上。
2. 带线的方块已经挂在各自的线上(触摸块在线的末端)。拼到它们时,把方块放进位置,多的线往主板方向收。
3. 主板空腔(第 2–7 层中间那个空的大方框)先空着,所有线都从这里往后、从背面的门洞拉出去接主板。

【方向规则 · 每一页都一样】

- 站在机器人背后拼。页面上方 = 机器人正面(离你远),左右 = 你的左右手。
- 磁铁:刻 S 的面朝 右手 / 远处 / 上;刻 N 的面朝 左手 / 近处 / 下。方块吸不住、往外推 = 转错了。
- 每格的大字 = 方块上刻的两个字符(刻字),小字 #数字 = 拼装序号。颜色 + 刻字对上就是这一颗,同颜色同刻字的可以互换。灰色虚线 = 下面一层的轮廓。

【线的画法】

- 粗彩线 = 这一层里走的线(颜色 = 线的颜色);彩色粗框 = 这条线的方块;↑↓ = 线在这里竖着去上 / 下一层。
- 线槽块(LA+LB 两半):线放进 LA 剖面的槽,从「进」面进、「出」面出;剖面涂胶避开槽,合 LB,再装磁铁。
- 触摸块(Tbody+Tlid):铜箔贴在薄盖内侧,薄盖(光面朝外)就是被摸的那一面。
- 线不能夹在两颗方块中间:磁铁面要贴平。悬空穿过头里的线拉直,别绷紧。

【每层拼完】

- 这一层有触摸块的,马上测:串口按 e 选到那一路(按 e 的次数 = E 编号 + 1),隔着盖子摸,显示「摸到」再往上拼。

【这一层要拿的方块(颜色:刻字×数量)】

白色:14(充电槽) 1A 24(喇叭网) 2A
36 3A×2

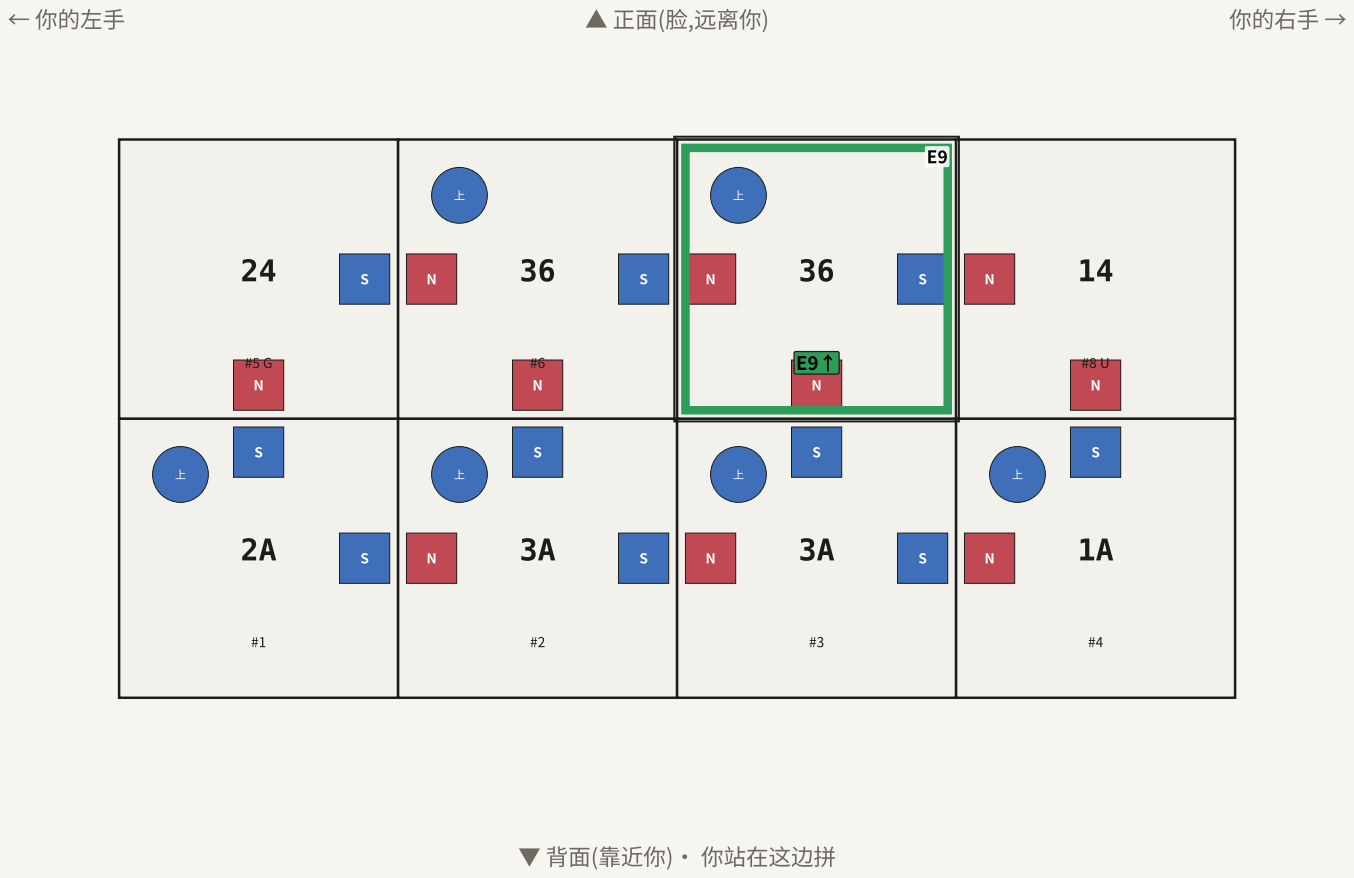
[picture p125: figure]
← 你的左手; ▲ 正面(脸,远离你); 你的右手 →; ▼ 背面(靠近你)· 你站在这边拼

① 每格大字 = 方块上的刻字,小字
#序号。按序号从小到大放(#1 → #8),颜色和刻字对 上就行,同颜色同刻字的可以互换。每颗对准下面一层,磁铁吸 住、面贴平。

② 序号 7 = E9 绿+1道·底座边缘
的触摸块:线从【上】进腔,薄盖(摸的面)朝【下】

③ 带线的方块放好后,把多出来的线往主板空腔收,从门洞拉 出去。

【这层拼完先测】

E9:按 e 10 次,摸底座边缘 → 显示「摸到」

第 1 / 16 层 本层 8 颗 · 序号 1–8 · 号白色

【这一层要拿的方块(颜色:刻字×数量)】

薰衣草紫:16 1A 1E 36×2 38
3B 3C 3C(充电槽)

# 紫色:36×2 39 3B 3D

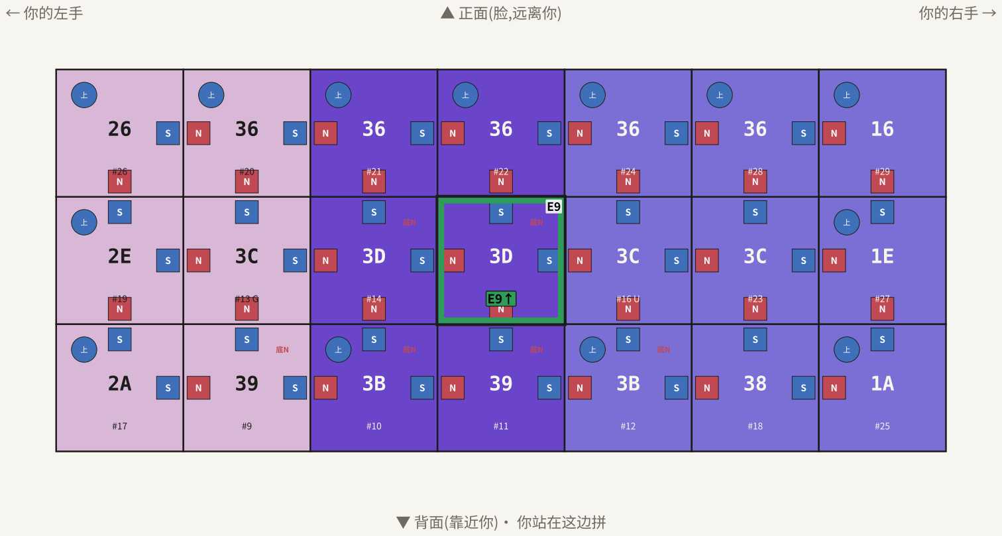
[picture p126: figure]
← 你的左手; ▲ 正面(脸,远离你); 你的右手 →; ▼ 背面(靠近你)· 你站在这边拼

胭脂雪:26 2A 2E 36 39
3C(喇叭网)

① 每格大字 = 方块上的刻字,小字
#序号。按序号从小到大放(#9 → #29),颜色和刻字 对上就行,同颜色同刻字的可以互换。每颗对准下面一层,磁铁 吸住、面贴平。

② 序号 15 = E9 绿+1道·底座边缘
的线槽块:线从【上】进、【下】出;两半合好、磁铁装好再放

③ 带线的方块放好后,把多出来的线往主板空腔收,从门洞拉 出去。

第 2 / 16 层 本层 21 颗 · 序号 9–29 · 12号薰衣草紫 · 13号紫色 · 11号胭脂雪

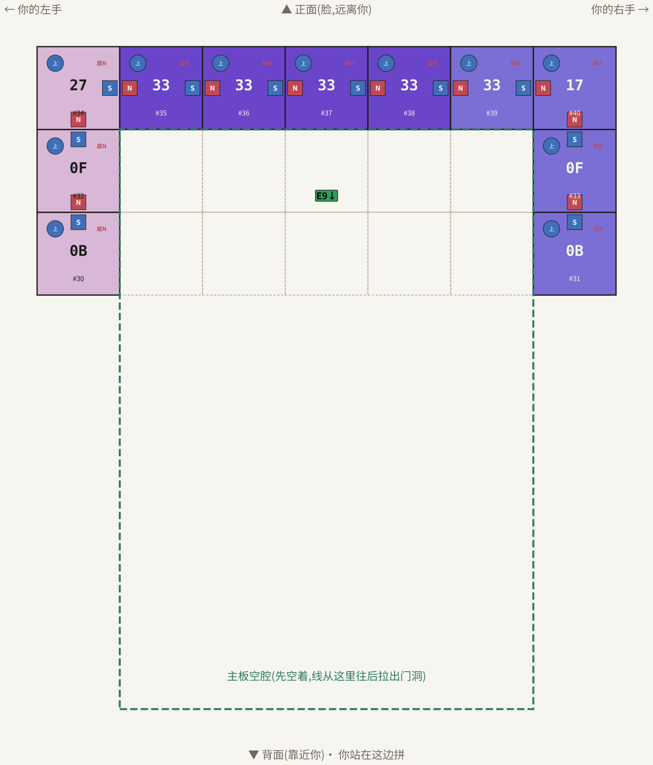
[picture p127: figure]
← 你的左手; ▲ 正面(脸,远离你); 你的右手 →; ▼ 背面(靠近你)· 你站在这边拼; 主板空腔(先空着,线从这里往后拉出门洞)

【这一层要拿的方块(颜色:刻字×数量)】

薰衣草紫:0B 0F 17 33
紫色:33×4

胭脂雪:0B 0F 27

① 每格大字 = 方块上的刻字,小字
#序号。按序号从小到大放(#30 → #40),颜色和刻 字对上就行,同颜色同刻字的可以互换。每颗对准下面一层,磁 铁吸住、面贴平。

② E9(底座边缘)的线竖着/悬空穿过这一层,拉直别绷紧

第 3 / 16 层 本层 11 颗 · 序号 30–40 · 12号薰衣草紫 · 13号紫色 · 11号胭脂雪

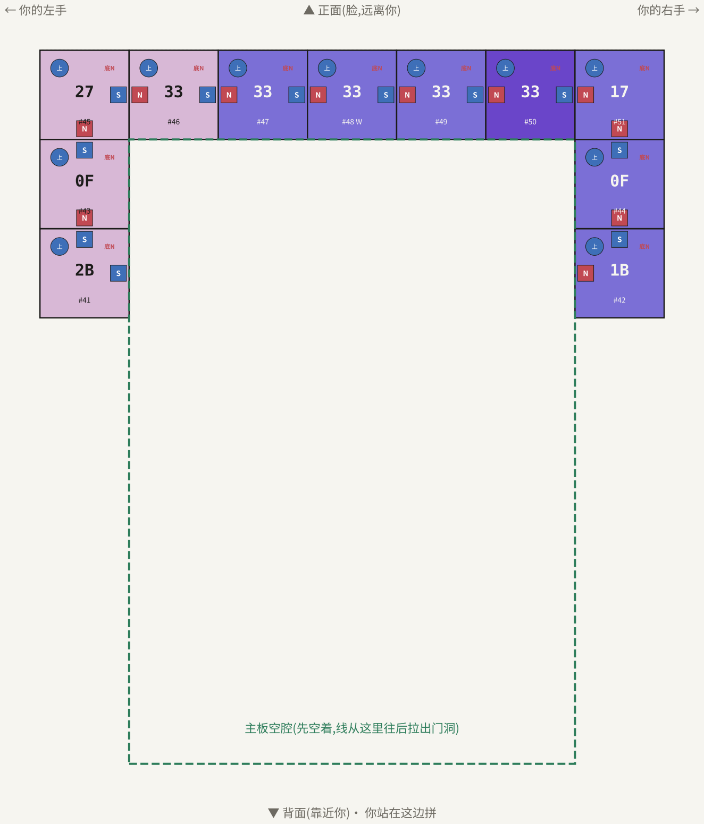
[picture p128: figure]
← 你的左手; ▲ 正面(脸,远离你); 你的右手 →; ▼ 背面(靠近你)· 你站在这边拼; 主板空腔(先空着,线从这里往后拉出门洞)

【这一层要拿的方块(颜色:刻字×数量)】

薰衣草紫:0F 17 1B 33×2
33(ToF窗)
紫色:33

胭脂雪:0F 27 2B 33

① 每格大字 = 方块上的刻字,小字
#序号。按序号从小到大放(#41 → #51),颜色和刻 字对上就行,同颜色同刻字的可以互换。每颗对准下面一层,磁 铁吸住、面贴平。

这一层没有线,正常拼。

第 4 / 16 层 本层 11 颗 · 序号 41–51 · 12号薰衣草紫 · 13号紫色 · 11号胭脂雪

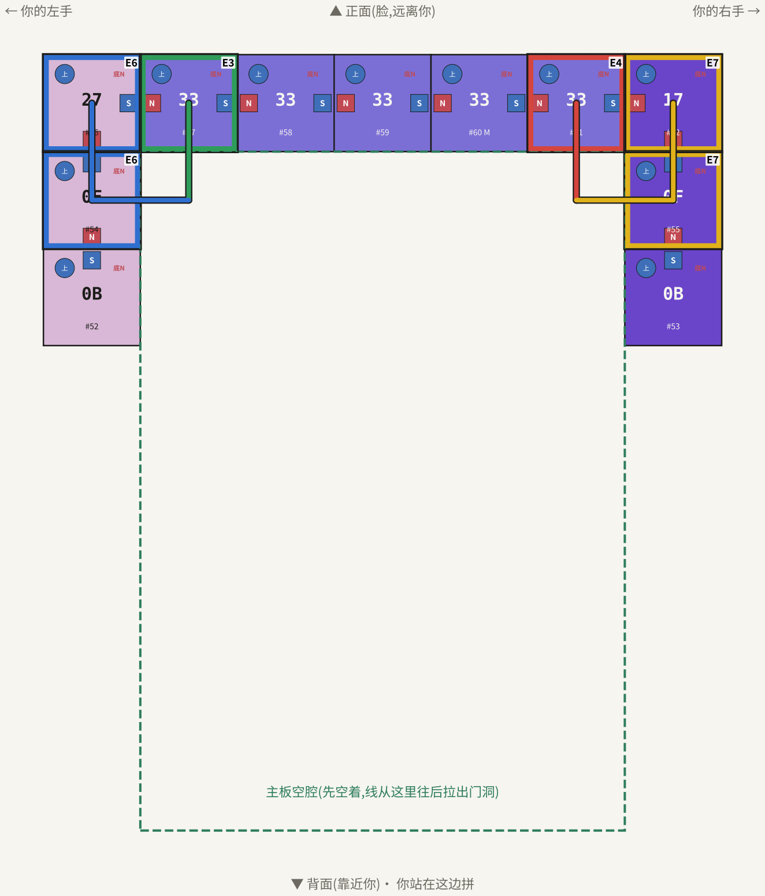
[picture p129: figure]
← 你的左手; ▲ 正面(脸,远离你); 你的右手 →; ▼ 背面(靠近你)· 你站在这边拼; 主板空腔(先空着,线从这里往后拉出门洞)

【这一层要拿的方块(颜色:刻字×数量)】

薰衣草紫:33×2 33(麦克风孔)

# 紫色:0B

胭脂雪:0B

① 每格大字 = 方块上的刻字,小字
#序号。按序号从小到大放(#52 → #62),颜色和刻 字对上就行,同颜色同刻字的可以互换。每颗对准下面一层,磁 铁吸住、面贴平。

② 序号 54 = E6 蓝+1道·左侧身
的线槽块:线从【右】进、【前】出;两半合好、磁铁装好再放

③ 序号 55 = E7 黄+1道·右侧身
的线槽块:线从【左】进、【前】出;两半合好、磁铁装好再放

④ 序号 56 = E6 蓝+1道·左侧身
的触摸块:线从【后】进腔,薄盖(摸的面)朝【左】

⑤ 序号 57 = E3 绿·左脸颊
的触摸块:线从【后】进腔,薄盖(摸的面)朝【前】

⑥ 序号 61 = E4 红·右脸颊
的触摸块:线从【后】进腔,薄盖(摸的面)朝【前】

⑦ 序号 62 = E7 黄+1道·右侧身
的触摸块:线从【后】进腔,薄盖(摸的面)朝【右】

⑧ 带线的方块放好后,把多出来的线往主板空腔收,从门洞拉 出去。

【这层拼完先测】

E6:按 e 7 次,摸左侧身 → 显示「摸到」

E3:按 e 4 次,摸左脸颊 → 显示「摸到」

第 5 / 16 层 本层 11 颗 · 序号 52–62 · 12号薰衣草紫 · 13号紫色 · 11号胭脂雪

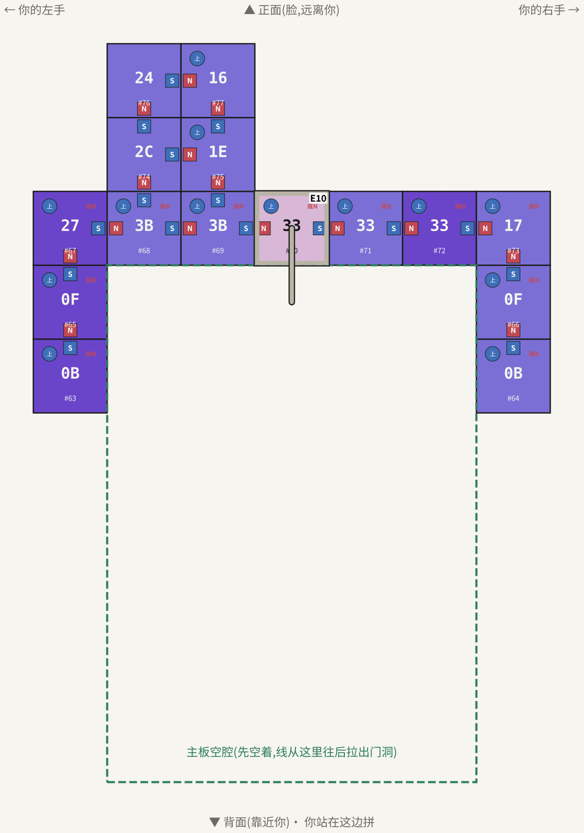
[picture p130: figure]
← 你的左手; ▲ 正面(脸,远离你); 你的右手 →; ▼ 背面(靠近你)· 你站在这边拼; 主板空腔(先空着,线从这里往后拉出门洞)

【这一层要拿的方块(颜色:刻字×数量)】

薰衣草紫:0B 0F 16 17 1E 24
2C 33 3B×2

紫色:0B 0F 27 33

① 每格大字 = 方块上的刻字,小字
#序号。按序号从小到大放(#63 → #77),颜色和刻 字对上就行,同颜色同刻字的可以互换。每颗对准下面一层,磁 铁吸住、面贴平。

② 序号 70 = E10 白+2道·鼻尖

的触摸块:线从【后】进腔,薄盖(摸的面)朝【前】

③ 带线的方块放好后,把多出来的线往主板空腔收,从门洞拉 出去。

【这层拼完先测】

E10:按 e 11 次,摸鼻尖 → 显示「摸到」

第 6 / 16 层 本层 15 颗 · 序号 63–77 · 12号薰衣草紫 · 13号紫色 · 11号胭脂雪

N

S | N

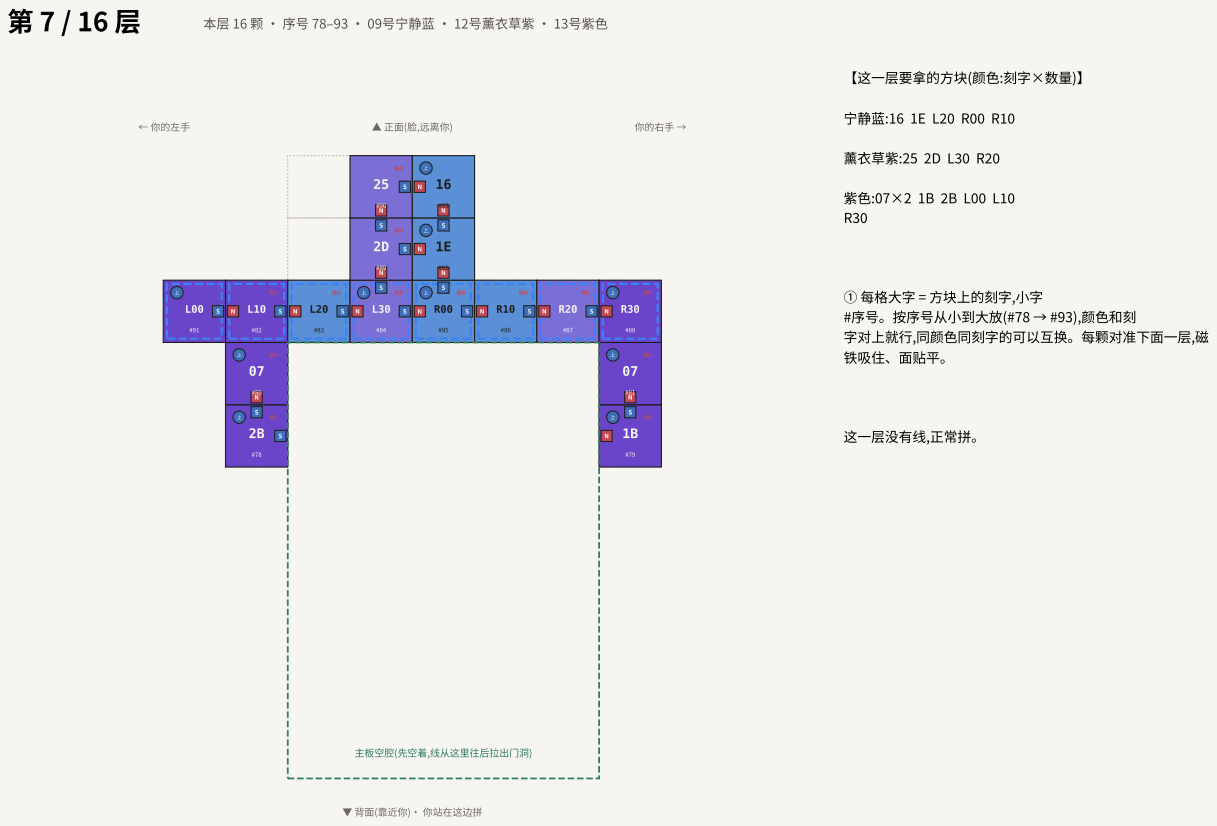
[picture p131: page 8]

【这一层要拿的方块(颜色:刻字×数量)】
宁静蓝:16 1E L20 R00 R10

# 紫色:16 1A 1E 26 2A 2B

# 第 8 / 16 层 本层 24 颗 · 序号 94–117 · 09号宁静蓝 · 12号薰衣草紫 · 13号紫色

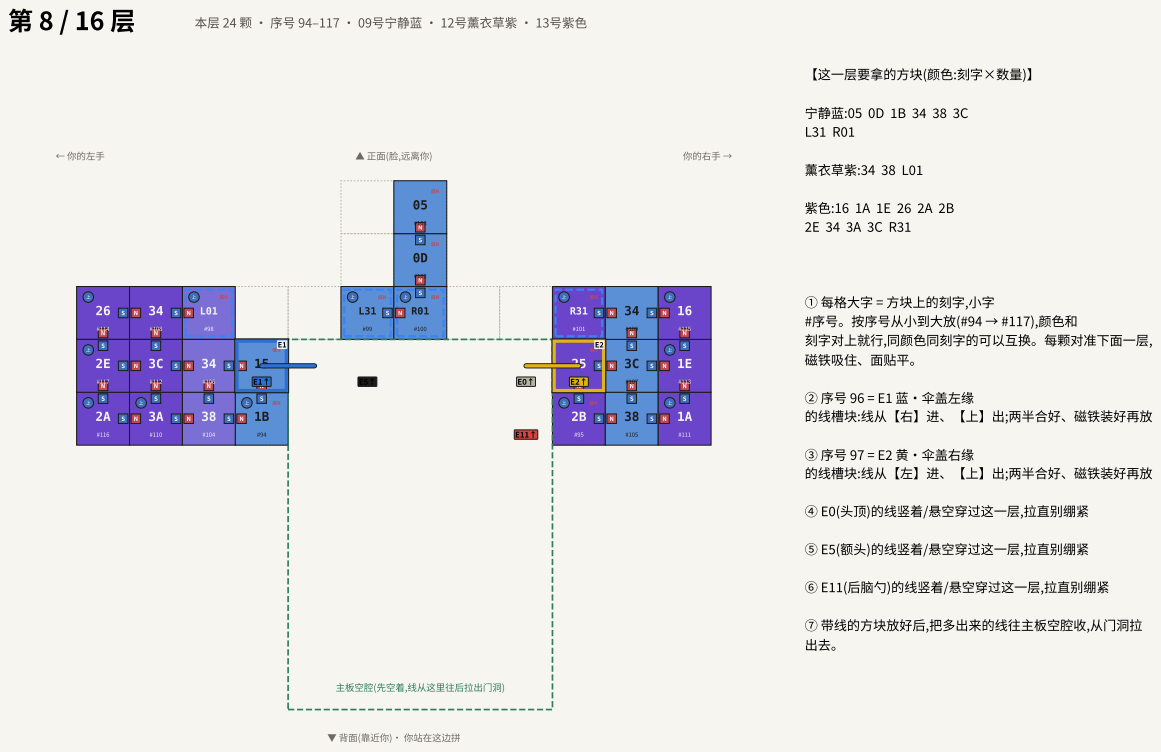
[picture p132: page 9]
← 你的左手; ▲ 正面(脸,远离你); 你的右手 →; 宁静蓝:05 0D 1B 34 38 3C; 薰衣草紫:34 38 L01; ② 序号 96 = E1 蓝·伞盖左缘; ③ 序号 97 = E2 黄·伞盖右缘

【这一层要拿的方块(颜色:刻字×数量)】

① 每格大字 = 方块上的刻字,小字
#序号。按序号从小到大放(#94 → #117),颜色和
刻字对上就行,同颜色同刻字的可以互换。每颗对准下面一层,
磁铁吸住、面贴平。

的线槽块:线从【右】进、【上】出;两半合好、磁铁装好再放

的线槽块:线从【左】进、【上】出;两半合好、磁铁装好再放

④ E0(头顶)的线竖着/悬空穿过这一层,拉直别绷紧

⑤ E5(额头)的线竖着/悬空穿过这一层,拉直别绷紧

⑥ E11(后脑勺)的线竖着/悬空穿过这一层,拉直别绷紧

⑦ 带线的方块放好后,把多出来的线往主板空腔收,从门洞拉

主板空腔(先空着,线从这里往后拉出门洞)

▼ 背面(靠近你)· 你站在这边拼

18×2 20 24 26 27 28×2
29 32×2 34×2 36×4 38×2

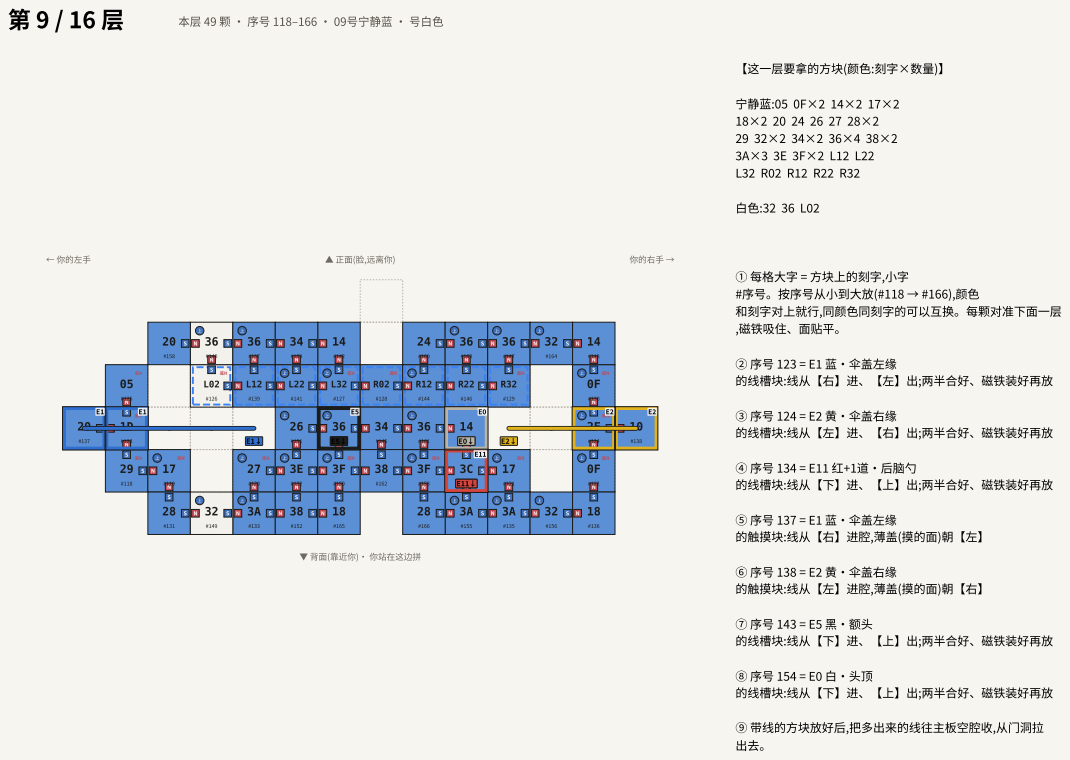
[picture p133: page 10]

【这一层要拿的方块(颜色:刻字×数量)】

的线槽块:线从【右】进、【左】出;两半合好、磁铁装好再放

的线槽块:线从【左】进、【右】出;两半合好、磁铁装好再放

的线槽块:线从【下】进、【上】出;两半合好、磁铁装好再放

的触摸块:线从【右】进腔,薄盖(摸的面)朝【左】

的触摸块:线从【左】进腔,薄盖(摸的面)朝【右】

# 宁静蓝:04 05 06 07 08 09×3

# 深绿色:23×2

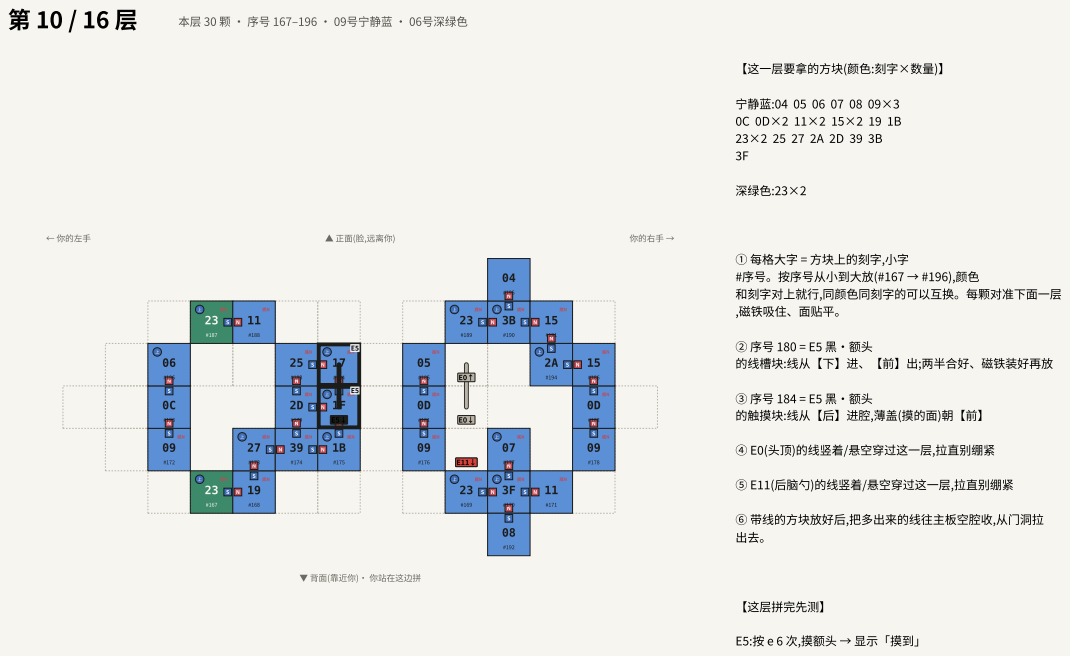
[picture p134: page 11]
← 你的左手; ▲ 正面(脸,远离你); 你的右手 →; 【这层拼完先测】; 第 10 / 16 层 本层 30 颗 · 序号 167–196 · 09号宁静蓝 · 06号深绿色

【这一层要拿的方块(颜色:刻字×数量)】

① 每格大字 = 方块上的刻字,小字
#序号。按序号从小到大放(#167 → #196),颜色
和刻字对上就行,同颜色同刻字的可以互换。每颗对准下面一层
,磁铁吸住、面贴平。

的线槽块:线从【下】进、【前】出;两半合好、磁铁装好再放

的触摸块:线从【后】进腔,薄盖(摸的面)朝【前】

④ E0(头顶)的线竖着/悬空穿过这一层,拉直别绷紧

⑤ E11(后脑勺)的线竖着/悬空穿过这一层,拉直别绷紧

⑥ 带线的方块放好后,把多出来的线往主板空腔收,从门洞拉

▼ 背面(靠近你)· 你站在这边拼

E5:按 e 6 次,摸额头 → 显示「摸到」

【这一层要拿的方块(颜色:刻字×数量)】

# 宁静蓝:04 05 06 08×2 09

0C×3 13×2 14 18×2 1B 1C
20 22×2 24×2 37 3B

# 深绿色:11 19 27

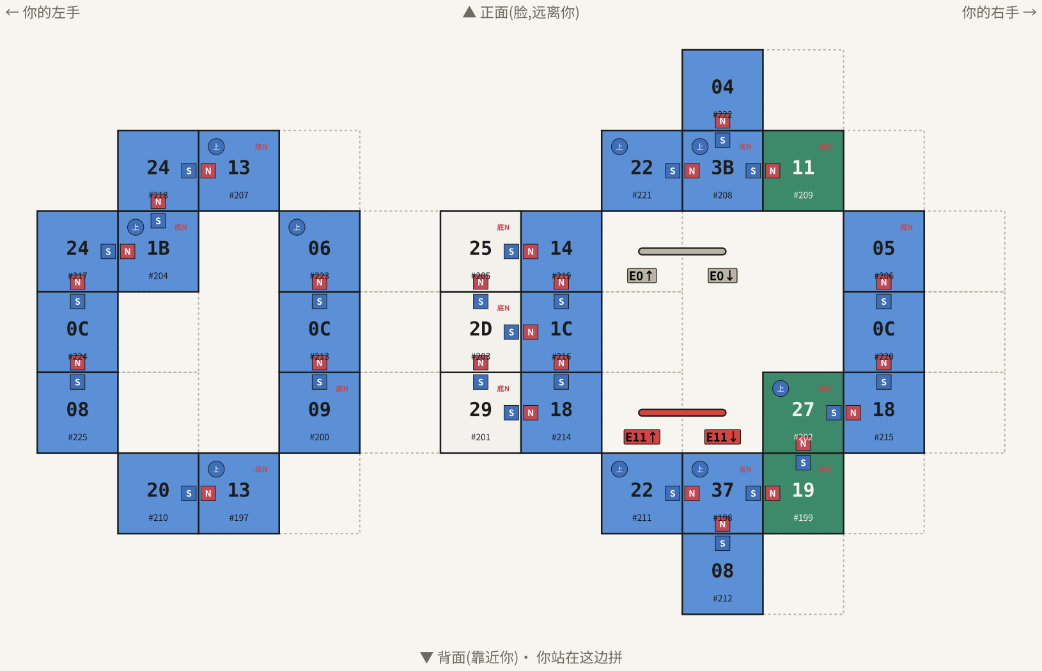
[picture p135: figure]
← 你的左手 ▲ 正面(脸,远离你); 你的右手 →; ▼ 背面(靠近你)· 你站在这边拼

# 白色:25 29 2D

① 每格大字 = 方块上的刻字,小字
#序号。按序号从小到大放(#197 → #225),颜色 和刻字对上就行,同颜色同刻字的可以互换。每颗对准下面一层 ,磁铁吸住、面贴平。

② E0(头顶)的线竖着/悬空穿过这一层,拉直别绷紧

③ E11(后脑勺)的线竖着/悬空穿过这一层,拉直别绷紧

# 第 11 / 16 层 本层 29 颗 · 序号 197–225 · 09号宁静蓝 · 06号深绿色 · 号白色

【这一层要拿的方块(颜色:刻字×数量)】

宁静蓝:06 0A 20×2 23×2 35
39

# 深绿色:06 07 08 09 0A 0C×2

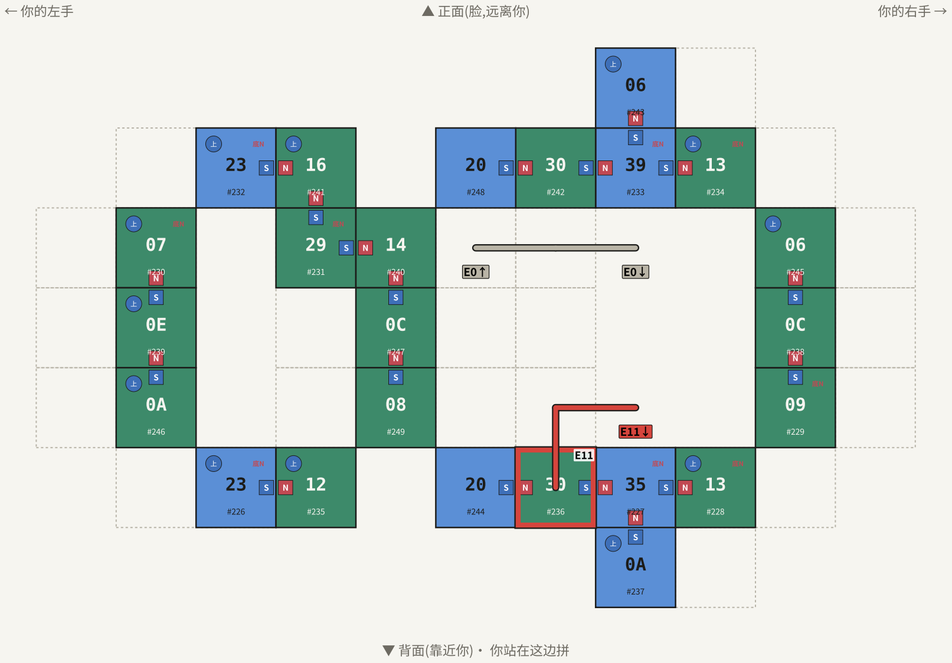
[picture p136: figure]
← 你的左手; ▲ 正面(脸,远离你); 你的右手 →; ▼ 背面(靠近你)· 你站在这边拼

0E 12 13×2 14 16 29 30

① 每格大字 = 方块上的刻字,小字
#序号。按序号从小到大放(#226 → #249),颜色 和刻字对上就行,同颜色同刻字的可以互换。每颗对准下面一层 ,磁铁吸住、面贴平。

② 序号 236 = E11 红+1道·后脑勺

的触摸块:线从【前】进腔,薄盖(摸的面)朝【后】

③ E0(头顶)的线竖着/悬空穿过这一层,拉直别绷紧

④ 带线的方块放好后,把多出来的线往主板空腔收,从门洞拉 出去。

【这层拼完先测】

E11:按 e 12 次,摸后脑勺 → 显示「摸到」

# 第 12 / 16 层 本层 24 颗 · 序号 226–249 · 09号宁静蓝 · 06号深绿色

【这一层要拿的方块(颜色:刻字×数量)】

# 深绿色:05 08 09 0C 0D 10

11×2 12×2 14×2 20×2 21×2
23×2 2B 30×2 31×2

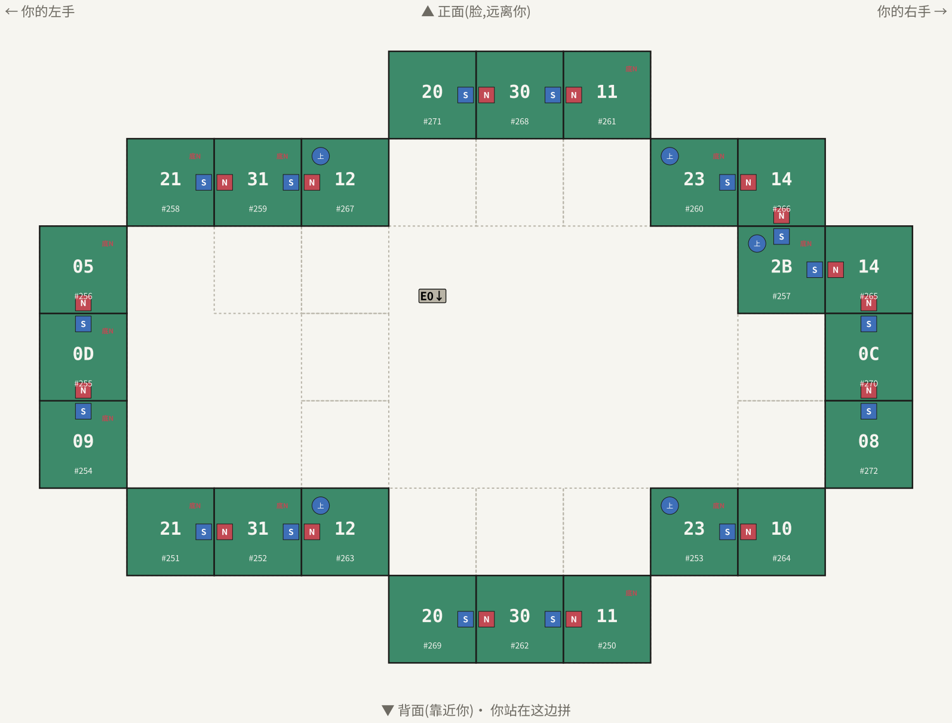
[picture p137: figure]
← 你的左手; ▲ 正面(脸,远离你); 你的右手 →; ▼ 背面(靠近你)· 你站在这边拼

① 每格大字 = 方块上的刻字,小字
#序号。按序号从小到大放(#250 → #272),颜色 和刻字对上就行,同颜色同刻字的可以互换。每颗对准下面一层 ,磁铁吸住、面贴平。

② E0(头顶)的线竖着/悬空穿过这一层,拉直别绷紧

# 第 13 / 16 层 本层 23 颗 · 序号 250–272 · 06号深绿色

【这一层要拿的方块(颜色:刻字×数量)】

# 深绿色:05 08 0C 11×2 18 1A

1C 21 24 25 28 2C 30×4
32×2 34

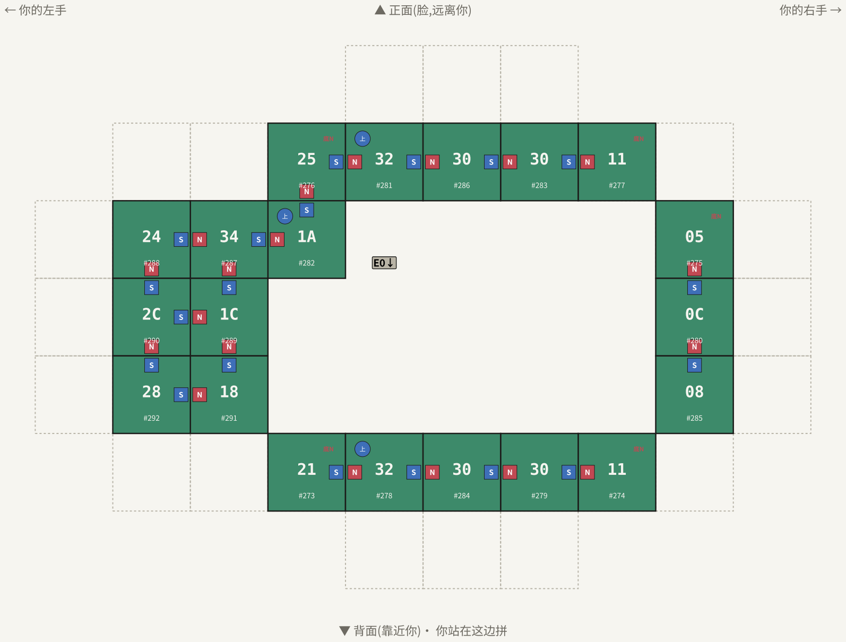
[picture p138: figure]
← 你的左手; ▲ 正面(脸,远离你); 你的右手 →; ▼ 背面(靠近你)· 你站在这边拼

① 每格大字 = 方块上的刻字,小字
#序号。按序号从小到大放(#273 → #292),颜色 和刻字对上就行,同颜色同刻字的可以互换。每颗对准下面一层 ,磁铁吸住、面贴平。

② E0(头顶)的线竖着/悬空穿过这一层,拉直别绷紧

# 第 14 / 16 层 本层 20 颗 · 序号 273–292 · 06号深绿色

【这一层要拿的方块(颜色:刻字×数量)】

# 深绿色:01 05 08 0C 14 18

1C 25 28 2C 34×2 38 3C

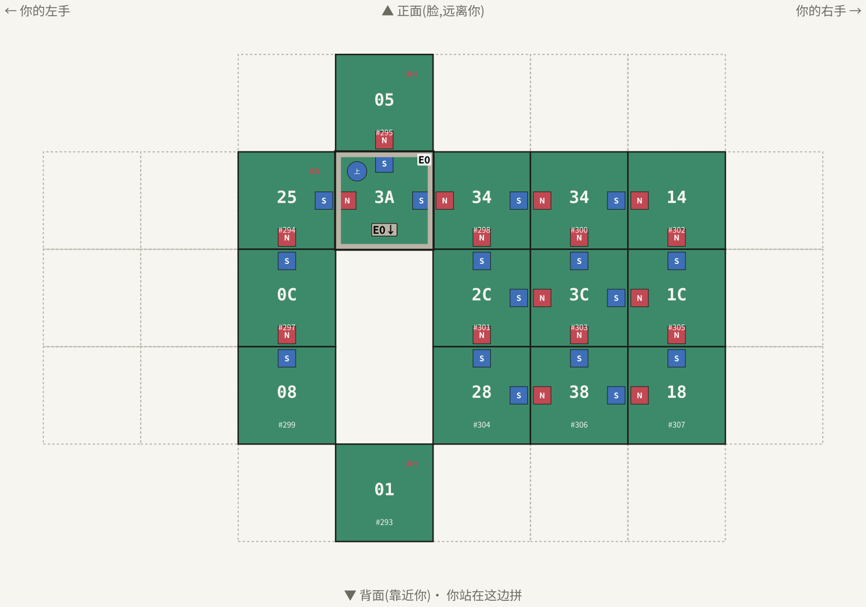
[picture p139: figure]
← 你的左手; ▲ 正面(脸,远离你); 你的右手 →; ▼ 背面(靠近你)· 你站在这边拼

① 每格大字 = 方块上的刻字,小字
#序号。按序号从小到大放(#293 → #307),颜色 和刻字对上就行,同颜色同刻字的可以互换。每颗对准下面一层 ,磁铁吸住、面贴平。

② 序号 296 = E0 白·头顶

的线槽块:线从【下】进、【上】出;两半合好、磁铁装好再放

③ 带线的方块放好后,把多出来的线往主板空腔收,从门洞拉 出去。

# 第 15 / 16 层 本层 15 颗 · 序号 293–307 · 06号深绿色

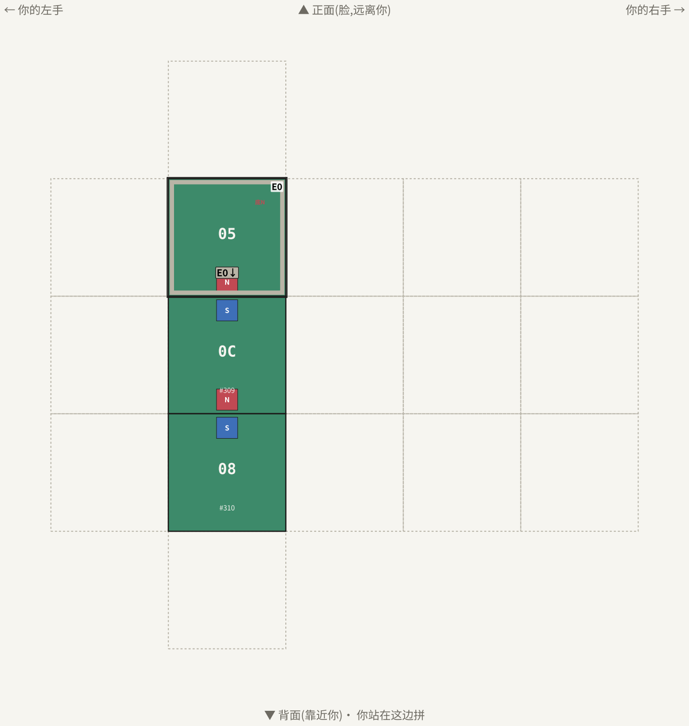
[picture p140: figure]
← 你的左手; ▲ 正面(脸,远离你); 你的右手 →; ▼ 背面(靠近你)· 你站在这边拼

【这一层要拿的方块(颜色:刻字×数量)】

# 深绿色:08 0C

① 每格大字 = 方块上的刻字,小字
#序号。按序号从小到大放(#308 → #310),颜色 和刻字对上就行,同颜色同刻字的可以互换。每颗对准下面一层 ,磁铁吸住、面贴平。

② 序号 308 = E0 白·头顶

的触摸块:线从【下】进腔,薄盖(摸的面)朝【上】

③ 带线的方块放好后,把多出来的线往主板空腔收,从门洞拉 出去。

【这层拼完先测】

E0:按 e 1 次,摸头顶 → 显示「摸到」

# 第 16 / 16 层 本层 3 颗 · 序号 308–310 · 06号深绿色

# 最后:装主板、合门板

1. 所有层拼完,12 路全部再测一遍(串口 e,一路一路按)。都显示「摸到」再往下。
2. E8 背后:铜箔卡片(带魔术贴)贴在门板内侧上半部,焊点朝里;按 e 9 次测。
3. 主板装到门板的四根板柱上:眼睛插座朝上,元件面朝机器人正面。
4. USB:弯头插进 XIAO,线往后(门板方向)弯,顺着主板背面走出来。
5. 把门板连同主板从背后慢慢推进空腔:边推边从门洞里把线束往回理,线不能被板边或门框夹住。
6. 门板四周的磁铁吸住。插 USB 开机,等串口出现「触摸基线已重新校准」,再把 12 个点各摸一次。
7. 多出来的线留在空腔里绕成一圈,别剪:以后拉出门板修东西还要用。

出问题时:某一路不跳 → 按 e 选到它,看信号;直接摸铜箔会跳、隔盖不跳 = 铜箔没贴平;都不跳 = 焊点断了(先查 J7 那头)。
