acrux-yueyao/Mycelium/hardware/print/moony_touch_v9/Moony_分拣表.pdf

刻字 | 数量 | 有磁铁的面 | 说明 | 用在第几层 · 序号
04 | × 2 后 | 10层:195 · 11层:222
05 | × 4 后、下 | 8层:103 · 9层:125 · 10层:185 · 11层:206
06 | × 3 后、上 | 10层:196 · 11层:223 · 12层:243
07 | × 1 后、上、下 | 10层:177
08 | × 3 前 | 10层:192 · 11层:212,225
09 | × 4 前、下 | 10层:172,176,178 · 11层:200
0A | × 1 前、上 | 12层:237
0C | × 4 前、后 | 10层:193 · 11层:213,220,224
0D | × 3 前、后、下 | 8层:102 · 10层:181,182
0F | × 2 前、后、上、下 | 9层:122,130
11 | × 2 左、下 | 10层:171,188
13 | × 2 左、上、下 | 11层:197,207
14 | × 3 左、后 | 9层:142,148 · 11层:219
15 | × 2 左、后、下 | 10层:186,191
16 | × 1 左、后、上 | 7层:93
17 | × 2 左、后、上、下 | 9层:119,121
18 | × 4 左、前 | 9层:136,165 · 11层:214,215
19 | × 1 左、前、下 | 10层:168
1B | × 3 左、前、上、下 | 8层:94 · 10层:175 · 11层:204
1C | × 1 左、前、后 | 11层:216
1E | × 1 左、前、后、上 | 7层:92
20 | × 4 右 | 9层:158 · 11层:210 · 12层:244,248
22 | × 2 右、上 | 11层:211,221
23 | × 4 右、上、下 | 10层:169,189 · 12层:226,232
24 | × 3 右、后 | 9层:160 · 11层:217,218
25 | × 1 右、后、下 | 10层:183

## 分拣表 · 宁静蓝 serene blue

按「颜色 + 方块上刻的两个字符」分堆。同一行的方块完全一样,可以互换;拼的时候说明书每格小字就是刻字。

刻字 | 数量 | 有磁铁的面 | 说明 | 用在第几层 · 序号
26 | × 1 右、后、上 | 9层:151
27 | × 2 右、后、上、下 | 9层:120 · 10层:173
28 | × 2 右、前 | 9层:131,166
29 | × 1 右、前、下 | 9层:118
2A | × 1 右、前、上 | 10层:194
2D | × 1 右、前、后、下 | 10层:179
32 | × 2 右、左、上 | 9层:156,164
34 | × 3 右、左、后 | 8层:109 · 9层:145,159
35 | × 1 右、左、后、下 | 12层:227
36 | × 4 右、左、后、上 | 9层:147,157,161,163
37 | × 1 右、左、后、上、下 | 11层:198
38 | × 3 右、左、前 | 8层:105 · 9层:152,162
39 | × 2 右、左、前、下 | 10层:174 · 12层:233
3A | × 3 右、左、前、上 | 9层:133,135,155
3B | × 2 右、左、前、上、下 | 10层:190 · 11层:208
3C | × 1 右、左、前、后 | 8层:107
3E | × 1 右、左、前、后、上 | 9层:132
3F | × 1 右、左、前、后、上、下 | 10层:170
3F | × 2 右、左、前、后、上、下 | 9层:150,153
10 | × 1 左 | 走线件:看线路卡 | 9层:138
14 | × 1 左、后 | 走线件:看线路卡 | 9层:154
15 | × 1 左、后、下 | 走线件:看线路卡 | 8层:96
17 | × 1 左、后、上、下 | 走线件:看线路卡 | 10层:184
1D | × 1 左、前、后、下 | 走线件:看线路卡 | 9层:123
1F | × 1 左、前、后、上、下 | 走线件:看线路卡 | 10层:180
20 | × 1 右 | 走线件:看线路卡 | 9层:137

## 分拣表 · 宁静蓝 serene blue

刻字 | 数量 | 有磁铁的面 | 说明 | 用在第几层 · 序号
2F | × 1 右、前、后、上、下 | 走线件:看线路卡 | 9层:124
36 | × 1 右、左、后、上 | 走线件:看线路卡 | 9层:143
3C | × 1 右、左、前、后 | 走线件:看线路卡 | 9层:134
L12 | × 1 右、左、前 | 眼框块(带小磁铁) | 9层:139
L20 | × 1 右、左、下 | 眼框块(带小磁铁) | 7层:83
L22 | × 1 右、左、前、上 | 眼框块(带小磁铁) | 9层:141
L31 | × 1 右、上、下 | 眼框块(带小磁铁) | 8层:99
L32 | × 1 右、左、前、上、下 | 眼框块(带小磁铁) | 9层:127
R00 | × 1 右、左、前、上、下 | 眼框块(带小磁铁) | 7层:85
R01 | × 1 左、前、上、下 | 眼框块(带小磁铁) | 8层:100
R02 | × 1 右、左、下 | 眼框块(带小磁铁) | 9层:128
R10 | × 1 右、左、下 | 眼框块(带小磁铁) | 7层:86
R12 | × 1 右、左、前、上 | 眼框块(带小磁铁) | 9层:144
R22 | × 1 右、左、前 | 眼框块(带小磁铁) | 9层:146
R32 | × 1 左、前、下 | 眼框块(带小磁铁) | 9层:129

## 分拣表 · 宁静蓝 serene blue

刻字 | 数量 | 有磁铁的面 | 说明 | 用在第几层 · 序号
01 | × 1 下 | 15层:293
05 | × 3 后、下 | 13层:256 · 14层:275 · 15层:295
06 | × 1 后、上 | 12层:245
07 | × 1 后、上、下 | 12层:230
08 | × 5 前 | 12层:249 · 13层:272 · 14层:285 · 15层:299 · 16层:…
09 | × 2 前、下 | 12层:229 · 13层:254
0A | × 1 前、上 | 12层:246
0C | × 6 前、后 | 12层:238,247 · 13层:270 · 14层:280 · 15层:297 · …
0D | × 1 前、后、下 | 13层:255
0E | × 1 前、后、上 | 12层:239
10 | × 1 左 | 13层:264
11 | × 5 左、下 | 11层:209 · 13层:250,261 · 14层:274,277
12 | × 3 左、上 | 12层:235 · 13层:263,267
13 | × 2 左、上、下 | 12层:228,234
14 | × 4 左、后 | 12层:240 · 13层:265,266 · 15层:302
16 | × 1 左、后、上 | 12层:241
18 | × 2 左、前 | 14层:291 · 15层:307
19 | × 1 左、前、下 | 11层:199
1A | × 1 左、前、上 | 14层:282
1C | × 2 左、前、后 | 14层:289 · 15层:305
20 | × 2 右 | 13层:269,271
21 | × 3 右、下 | 13层:251,258 · 14层:273
23 | × 4 右、上、下 | 10层:167,187 · 13层:253,260
24 | × 1 右、后 | 14层:288
25 | × 2 右、后、下 | 14层:276 · 15层:294
27 | × 1 右、后、上、下 | 11层:202

## 分拣表 · 深绿色 deep green

刻字 | 数量 | 有磁铁的面 | 说明 | 用在第几层 · 序号
28 | × 2 右、前 | 14层:292 · 15层:304
29 | × 1 右、前、下 | 12层:231
2B | × 1 右、前、上、下 | 13层:257
2C | × 2 右、前、后 | 14层:290 · 15层:301
30 | × 7 右、左 | 12层:242 · 13层:262,268 · 14层:279,283,284,286
31 | × 2 右、左、下 | 13层:252,259
32 | × 2 右、左、上 | 14层:278,281
34 | × 3 右、左、后 | 14层:287 · 15层:298,300
38 | × 1 右、左、前 | 15层:306
3C | × 1 右、左、前、后 | 15层:303
05 | × 1 后、下 | 走线件:看线路卡 | 16层:308
30 | × 1 右、左 | 走线件:看线路卡 | 12层:236
3A | × 1 右、左、前、上 | 走线件:看线路卡 | 15层:296

## 分拣表 · 深绿色 deep green

刻字 | 数量 | 有磁铁的面 | 说明 | 用在第几层 · 序号
0B | × 2 前、上、下 | 3层:31 · 6层:64
0F | × 3 前、后、上、下 | 3层:33 · 4层:44 · 6层:66
16 | × 2 左、后、上 | 2层:29 · 6层:77
17 | × 3 左、后、上、下 | 3层:40 · 4层:51 · 6层:73
1A | × 1 左、前、上 | 2层:25
1B | × 1 左、前、上、下 | 4层:42
1E | × 2 左、前、后、上 | 2层:27 · 6层:75
24 | × 1 右、后 | 6层:76
25 | × 1 右、后、下 | 7层:90
2C | × 1 右、前、后 | 6层:74
2D | × 1 右、前、后、下 | 7层:89
33 | × 6 右、左、上、下 | 3层:39 · 4层:47,49 · 5层:58,59 · 6层:71
33 | × 1 右、左、上、下 | 麦克风孔:侧面小圆孔 | 5层:60
33 | × 1 右、左、上、下 | ToF 窗口:侧面大方窗 | 4层:48
34 | × 1 右、左、后 | 8层:106
36 | × 2 右、左、后、上 | 2层:24,28
38 | × 2 右、左、前 | 2层:18 · 8层:104
3B | × 1 右、左、前、上、下 | 2层:12
3B | × 2 右、左、前、上、下 | 6层:68,69
3C | × 1 右、左、前、后 | 2层:23
3C | × 1 右、左、前、后 | 充电口通槽 | 2层:16
33 | × 2 右、左、上、下 | 走线件:看线路卡 | 5层:57,61
L01 | × 1 左、上、下 | 眼框块(带小磁铁) | 8层:98
L30 | × 1 右、左、前、上、下 | 眼框块(带小磁铁) | 7层:84
R20 | × 1 右、左、下 | 眼框块(带小磁铁) | 7层:87

## 分拣表 · 薰衣草紫 lavender

刻字 | 数量 | 有磁铁的面 | 说明 | 用在第几层 · 序号
07 | × 2 后、上、下 | 7层:80,81
0B | × 2 前、上、下 | 5层:53 · 6层:63
0F | × 1 前、后、上、下 | 6层:65
16 | × 1 左、后、上 | 8层:115
1A | × 1 左、前、上 | 8层:111
1B | × 1 左、前、上、下 | 7层:79
1E | × 1 左、前、后、上 | 8层:113
26 | × 1 右、后、上 | 8层:114
27 | × 1 右、后、上、下 | 6层:67
2A | × 1 右、前、上 | 8层:116
2B | × 1 右、前、上、下 | 8层:95
2B | × 1 右、前、上、下 | 7层:78
2E | × 1 右、前、后、上 | 8层:117
33 | × 6 右、左、上、下 | 3层:35,36,37,38 · 4层:50 · 6层:72
34 | × 1 右、左、后 | 8层:108
36 | × 2 右、左、后、上 | 2层:21,22
39 | × 1 右、左、前、下 | 2层:11
3A | × 1 右、左、前、上 | 8层:110
3B | × 1 右、左、前、上、下 | 2层:10
3C | × 1 右、左、前、后 | 8层:112
3D | × 1 右、左、前、后、下 | 2层:14
0F | × 1 前、后、上、下 | 走线件:看线路卡 | 5层:55
17 | × 1 左、后、上、下 | 走线件:看线路卡 | 5层:62
25 | × 1 右、后、下 | 走线件:看线路卡 | 8层:97
3D | × 1 右、左、前、后、下 | 走线件:看线路卡 | 2层:15
L00 | × 1 右、上 | 眼框块(带小磁铁) | 7层:91

## 分拣表 · 紫色 purple

刻字 | 数量 | 有磁铁的面 | 说明 | 用在第几层 · 序号
L10 | × 1 右、左、下 | 眼框块(带小磁铁) | 7层:82
R30 | × 1 左、上、下 | 眼框块(带小磁铁) | 7层:88
R31 | × 1 右、上、下 | 眼框块(带小磁铁) | 8层:101

## 分拣表 · 紫色 purple

刻字 | 数量 | 有磁铁的面 | 说明 | 用在第几层 · 序号
0B | × 2 前、上、下 | 3层:30 · 5层:52
0F | × 2 前、后、上、下 | 3层:32 · 4层:43
26 | × 1 右、后、上 | 2层:26
27 | × 2 右、后、上、下 | 3层:34 · 4层:45
2A | × 1 右、前、上 | 2层:17
2B | × 1 右、前、上、下 | 4层:41
2E | × 1 右、前、后、上 | 2层:19
33 | × 1 右、左、上、下 | 4层:46
36 | × 1 右、左、后、上 | 2层:20
39 | × 1 右、左、前、下 | 2层:9
3C | × 1 右、左、前、后 | 喇叭网孔 | 2层:13
0F | × 1 前、后、上、下 | 走线件:看线路卡 | 5层:54
27 | × 1 右、后、上、下 | 走线件:看线路卡 | 5层:56
33 | × 1 右、左、上、下 | 走线件:看线路卡 | 6层:70

## 分拣表 · 胭脂雪 rouge snow

刻字 | 数量 | 有磁铁的面 | 说明 | 用在第几层 · 序号
14 | × 1 左、后 | 充电口通槽 | 1层:8
1A | × 1 左、前、上 | 1层:4
24 | × 1 右、后 | 喇叭网孔 | 1层:5
25 | × 1 右、后、下 | 11层:205
29 | × 1 右、前、下 | 11层:201
2A | × 1 右、前、上 | 1层:1
2D | × 1 右、前、后、下 | 11层:203
32 | × 1 右、左、上 | 9层:149
36 | × 2 右、左、后、上 | 1层:6 · 9层:140
3A | × 2 右、左、前、上 | 1层:2,3
36 | × 1 右、左、后、上 | 走线件:看线路卡 | 1层:7
L02 | × 1 右、前、下 | 眼框块(带小磁铁) | 9层:126

## 分拣表 · 白色 white
