acrux-yueyao/Mycelium/design/market/Mycelium_booth_guide_iPad.png

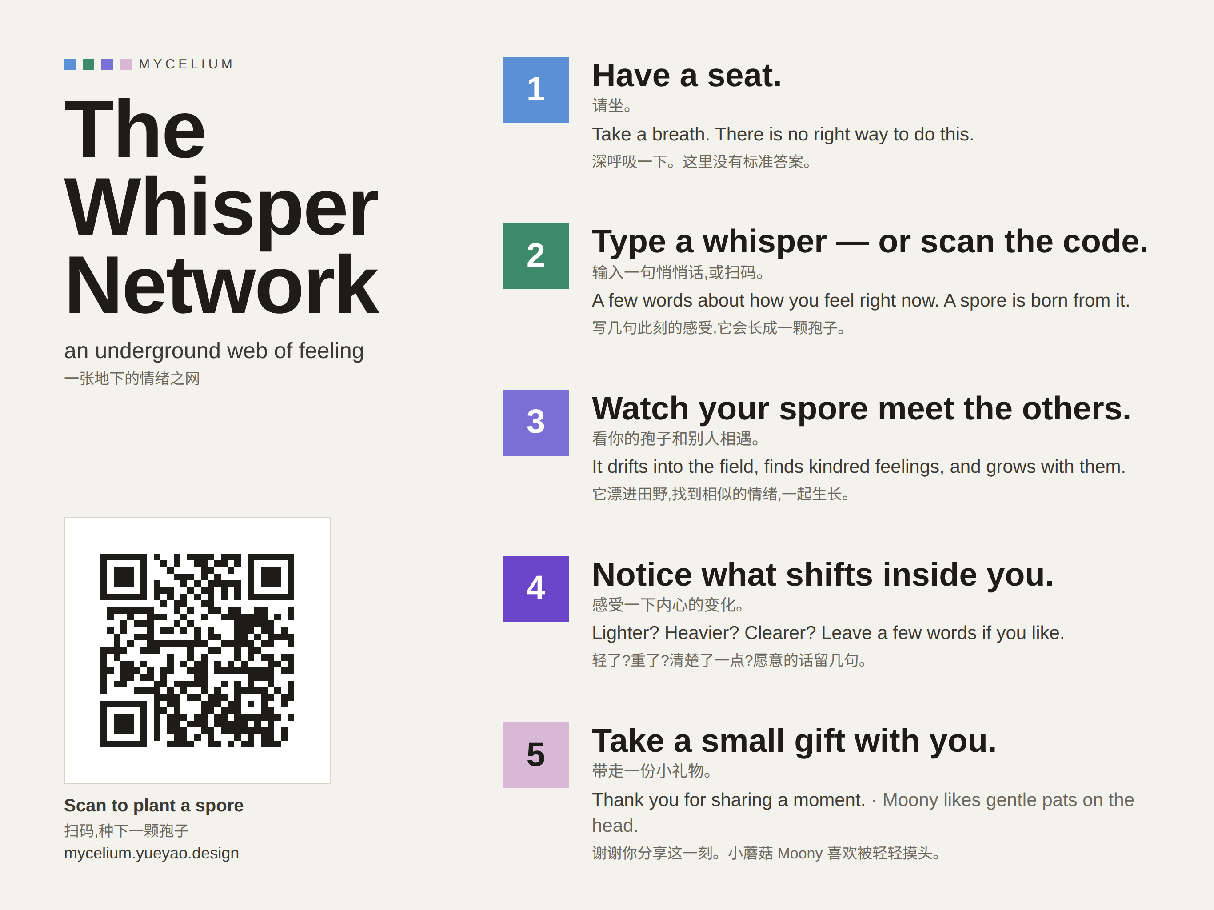
design/market/Mycelium_booth_guide_iPad.png
