acrux-yueyao/Mycelium/hardware/guide/eyes_wiring.png

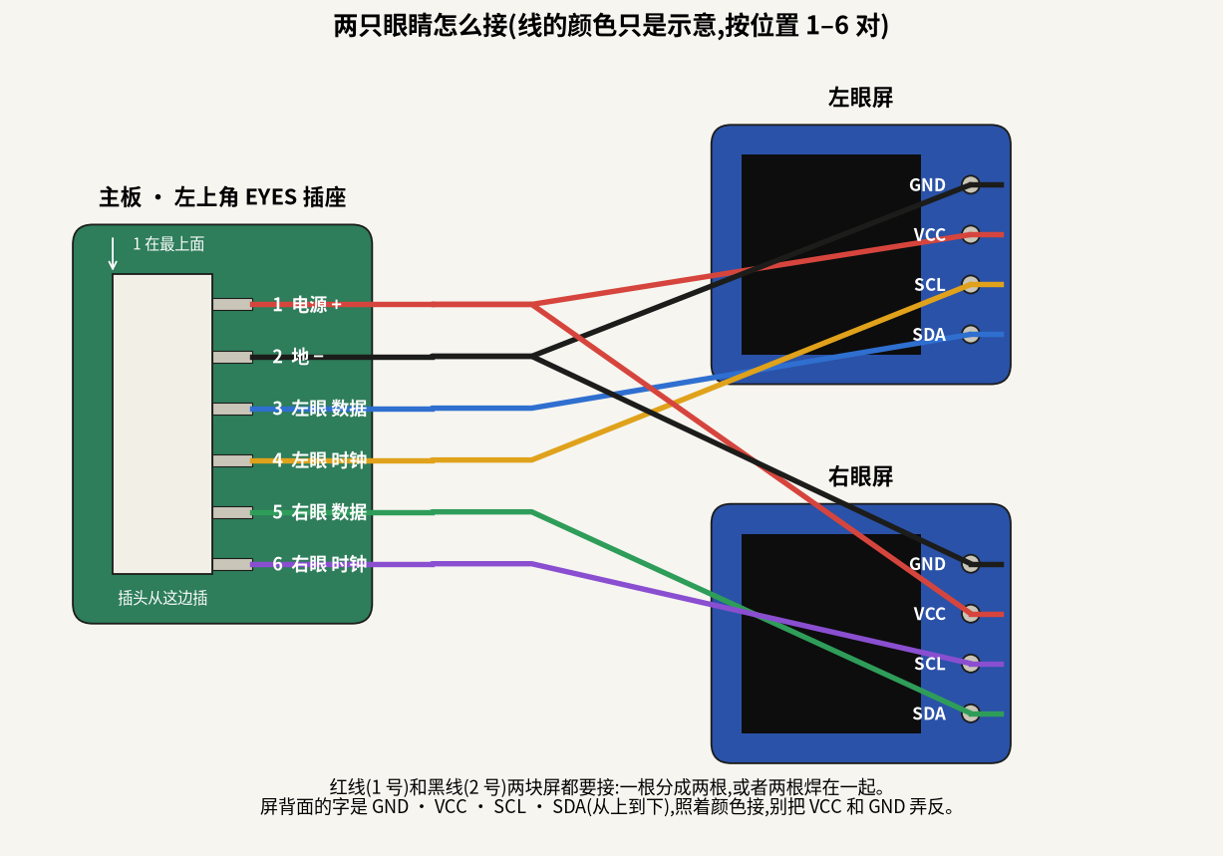
hardware/guide/eyes_wiring.png
