acrux-yueyao/Mycelium/hardware/print/door/门板_柱子短5mm_预览.png

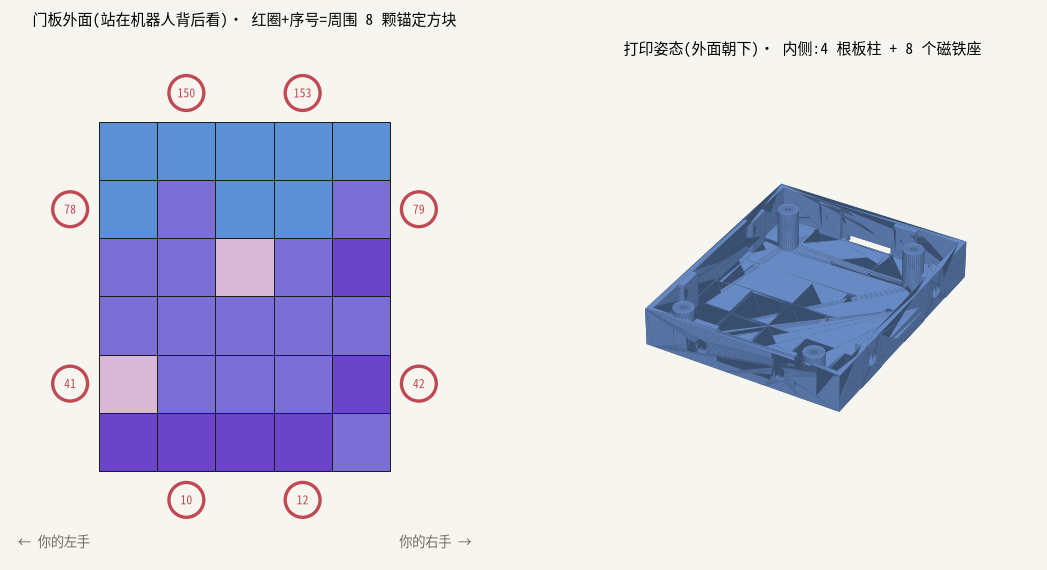
hardware/print/door/门板_柱子短5mm_预览.png
