acrux-yueyao/Mycelium/hardware/print/moony_touch_v9/11_深绿_样子.png

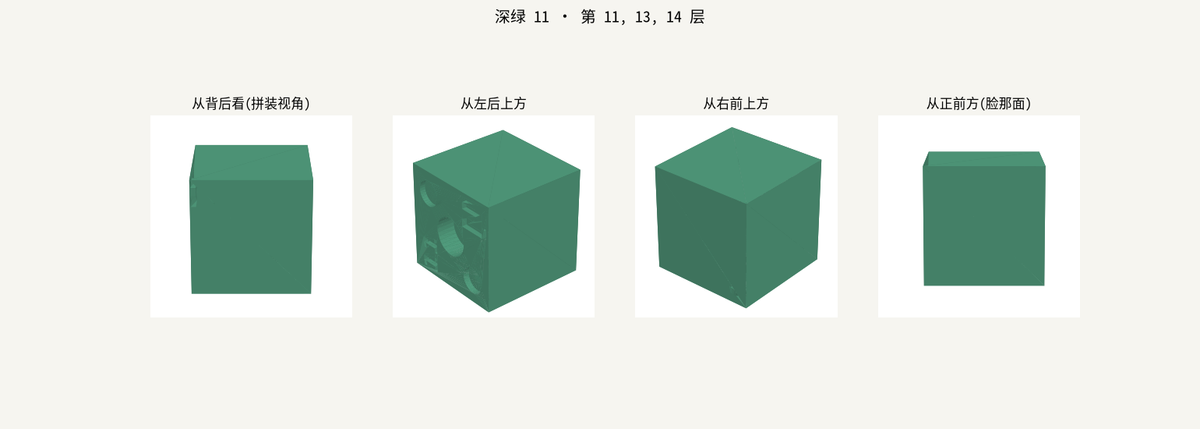
hardware/print/moony_touch_v9/11_深绿_样子.png
