acrux-yueyao/Mycelium/hardware/print/moony_touch_v9/touch_plan.png

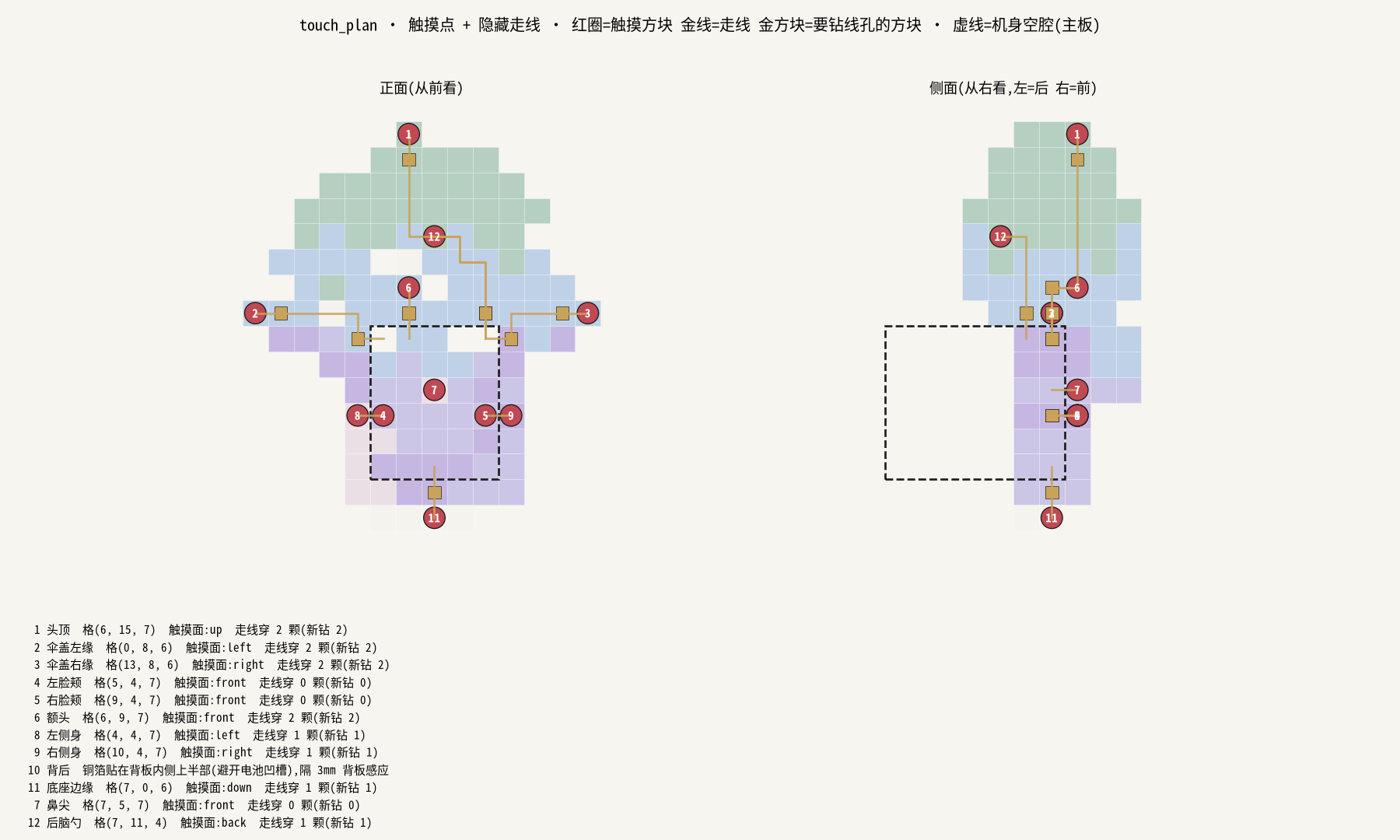
hardware/print/moony_touch_v9/touch_plan.png
