acrux-yueyao/Mycelium/hardware/print/moony_touch_v9/线路卡/三视图_E10_鼻尖.png

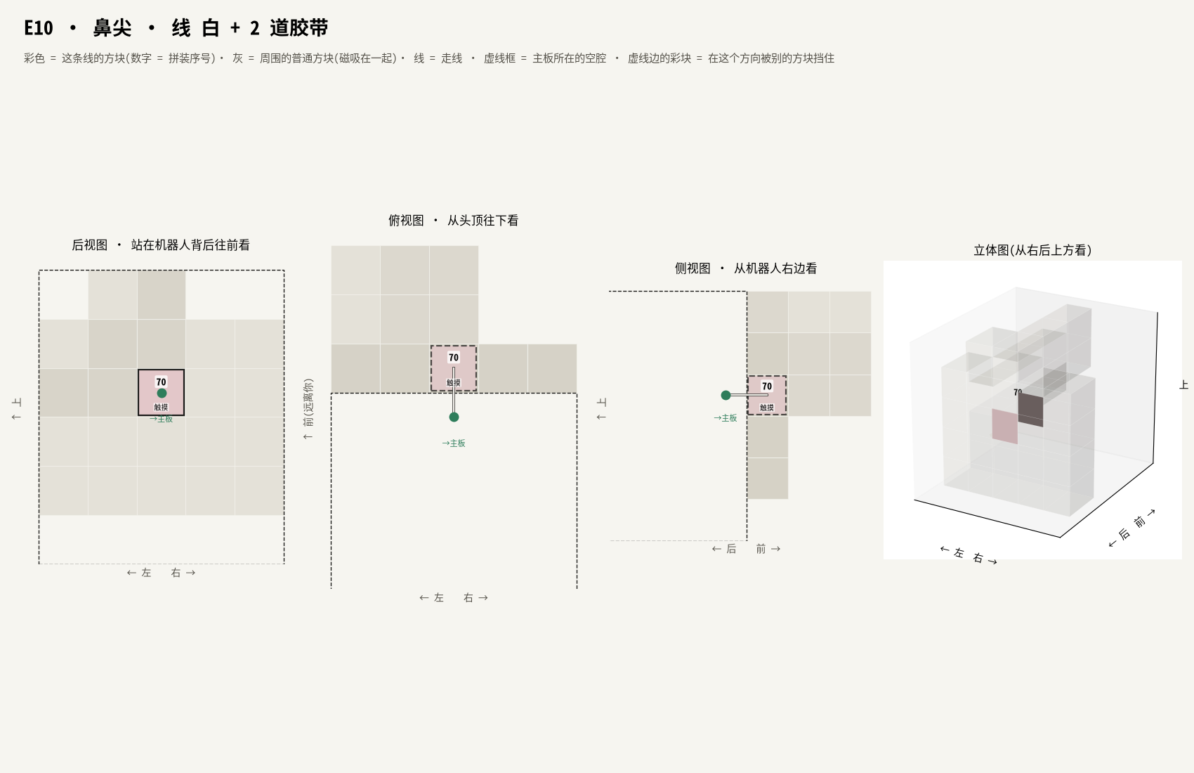
hardware/print/moony_touch_v9/线路卡/三视图_E10_鼻尖.png
