acrux-yueyao/Mycelium/hardware/print/moony_touch_v9/线路卡/拆解_55_62.png

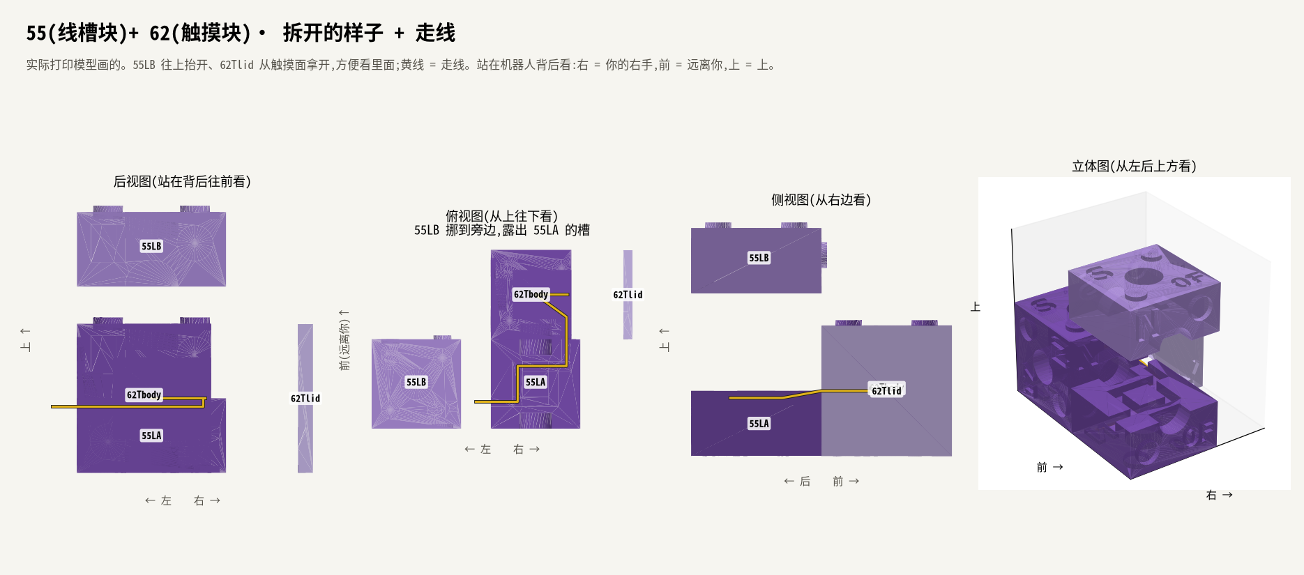
hardware/print/moony_touch_v9/线路卡/拆解_55_62.png
