acrux-yueyao/Mycelium/hardware/print/moony_touch_v9/线路卡/线路_E01_伞盖左缘.png

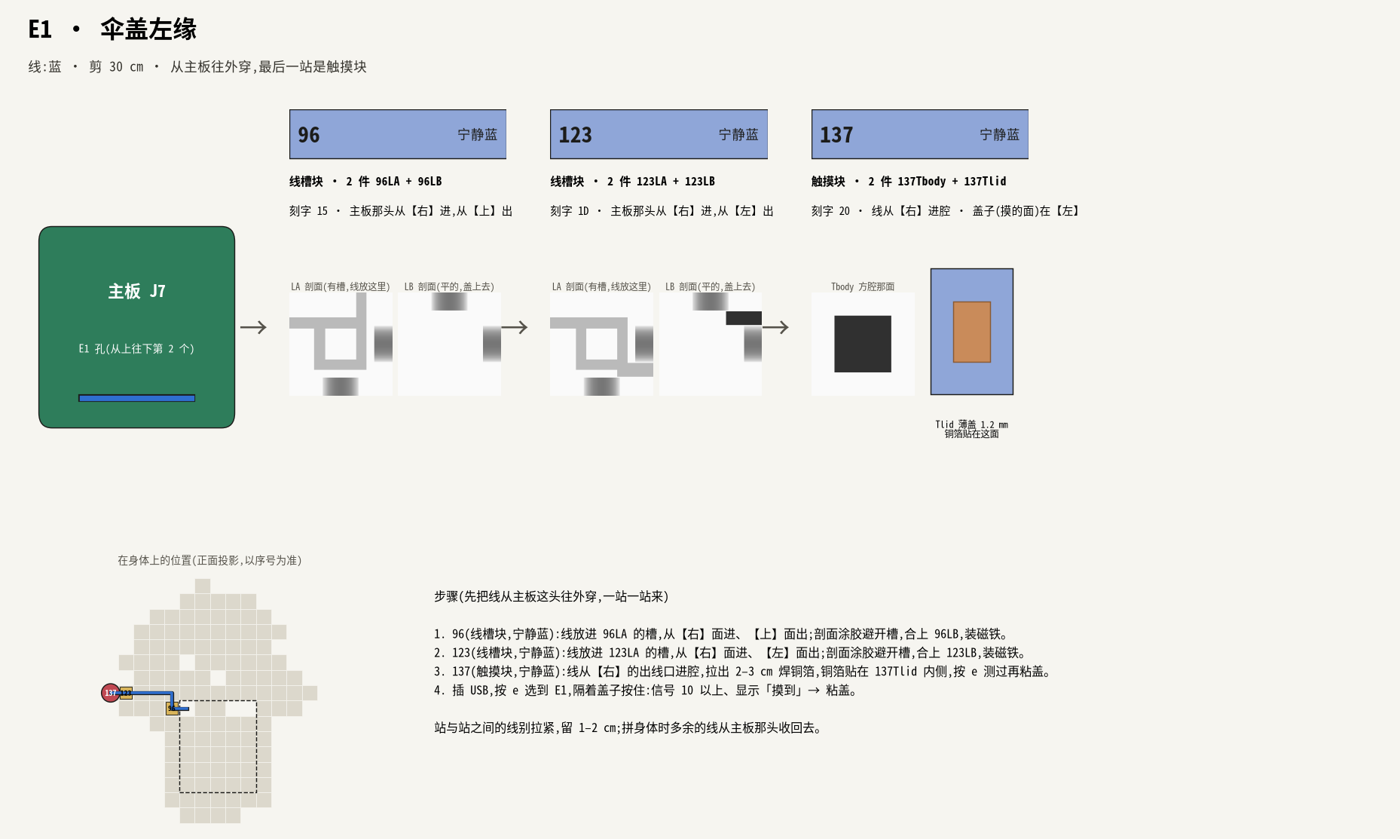
hardware/print/moony_touch_v9/线路卡/线路_E01_伞盖左缘.png
