acrux-yueyao/Mycelium/hardware/print/moony_touch_v9/线路卡/线路_E10_鼻尖.png

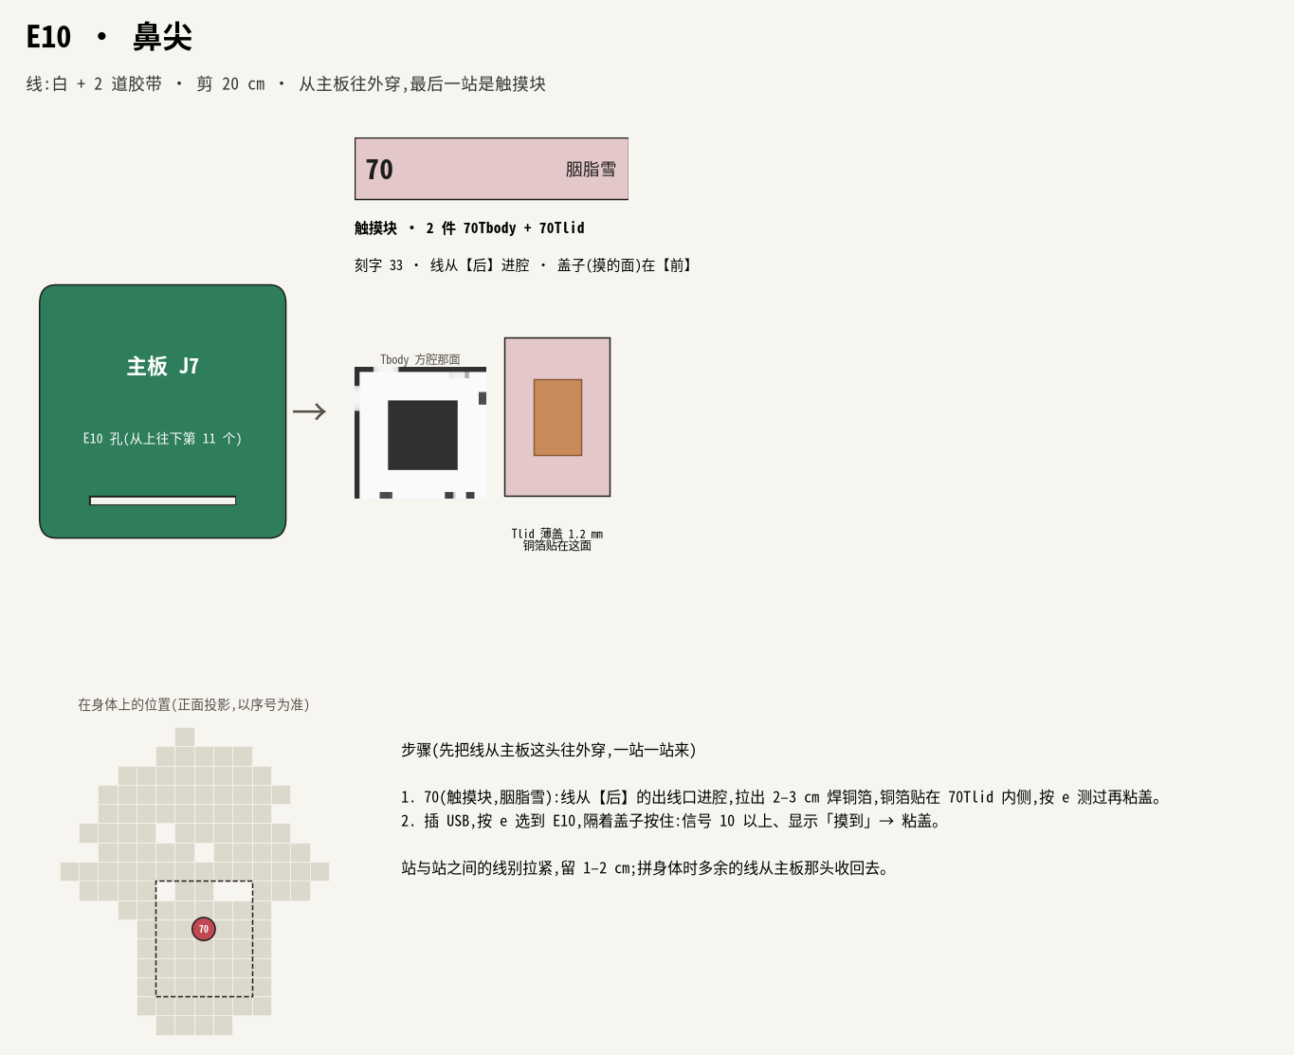
hardware/print/moony_touch_v9/线路卡/线路_E10_鼻尖.png
