acrux-yueyao/Mycelium/hardware/print/moony_touch_v9/线路卡/走线图_E02_伞盖右缘.png

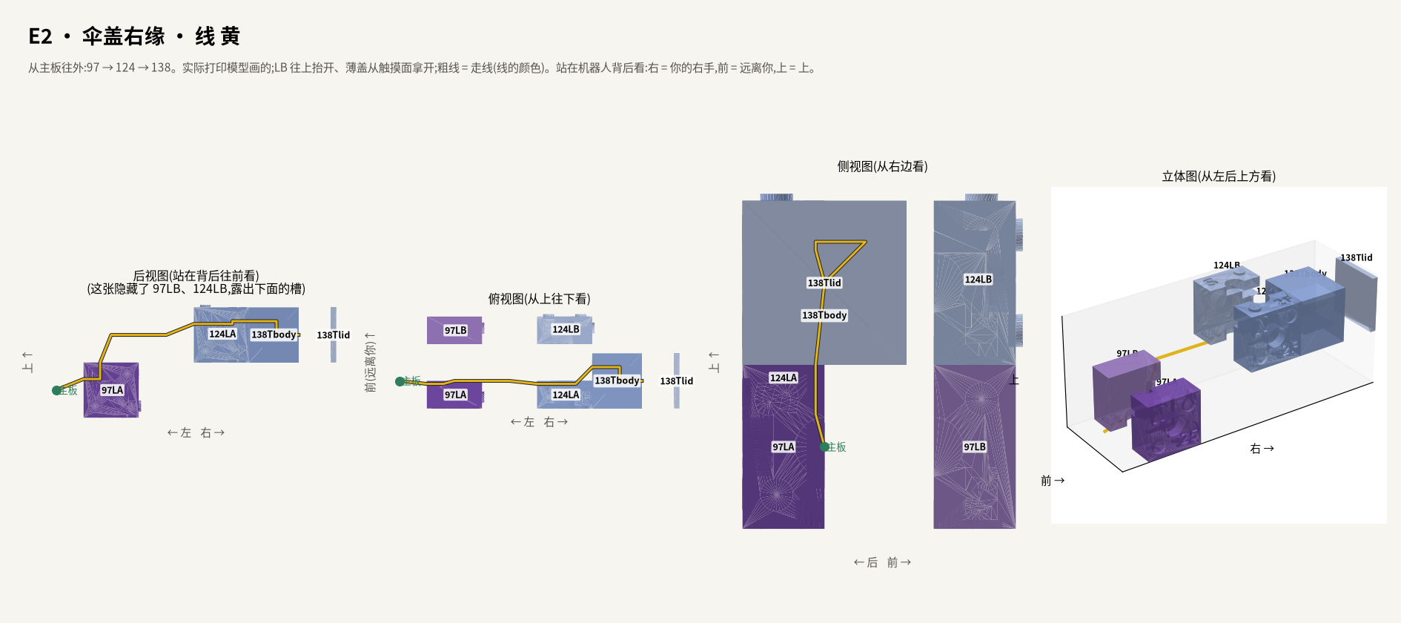
hardware/print/moony_touch_v9/线路卡/走线图_E02_伞盖右缘.png
