acrux-yueyao/Mycelium/hardware/print/moony_touch_v9/线路卡/走线图_E09_底座边缘.png

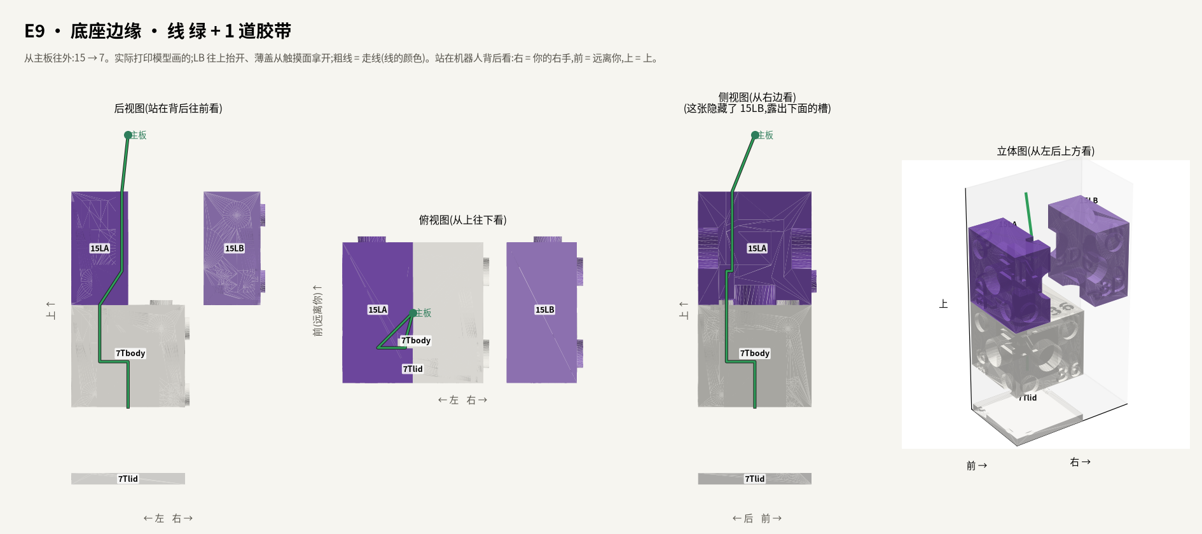
hardware/print/moony_touch_v9/线路卡/走线图_E09_底座边缘.png
