acrux-yueyao/Mycelium/hardware/print/pod/一体预览.png

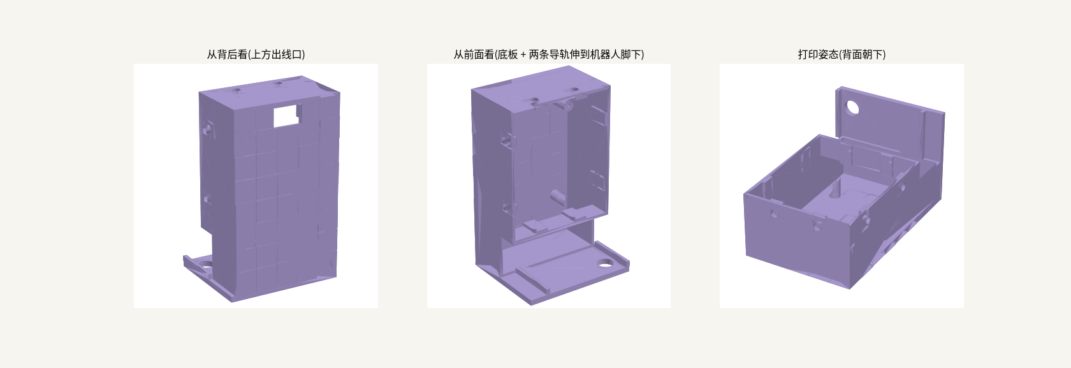
hardware/print/pod/一体预览.png
