acrux-yueyao/Mycelium/hardware/print/station/休息站_分件和槽.png

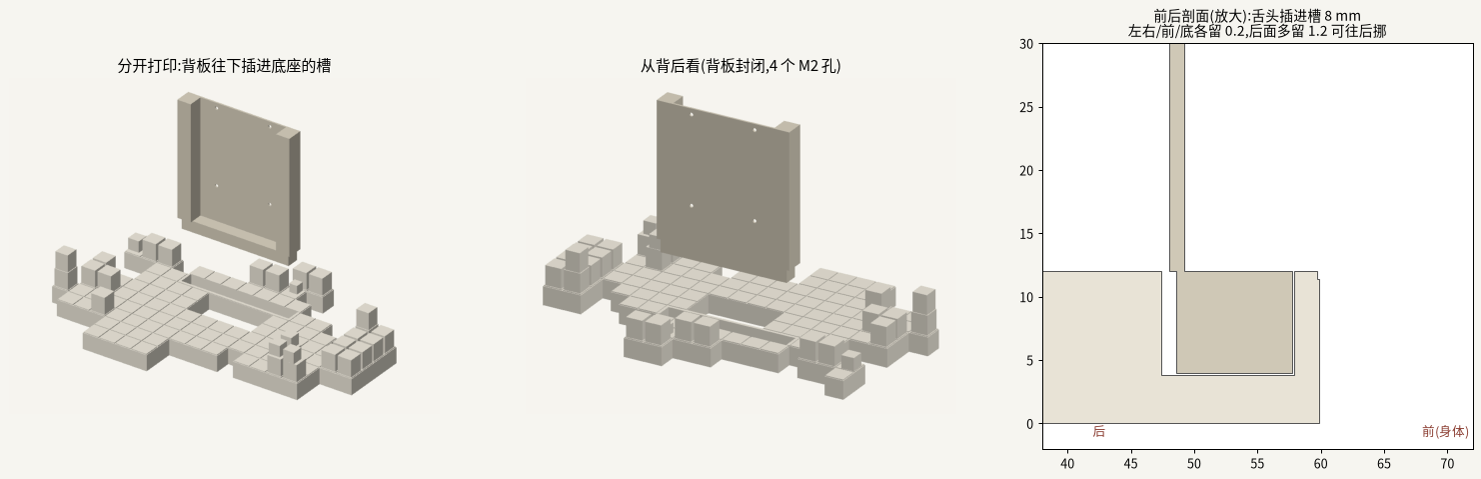
hardware/print/station/休息站_分件和槽.png
