acrux-yueyao/Mycelium/hardware/print/station/休息站_和机器人对比.png

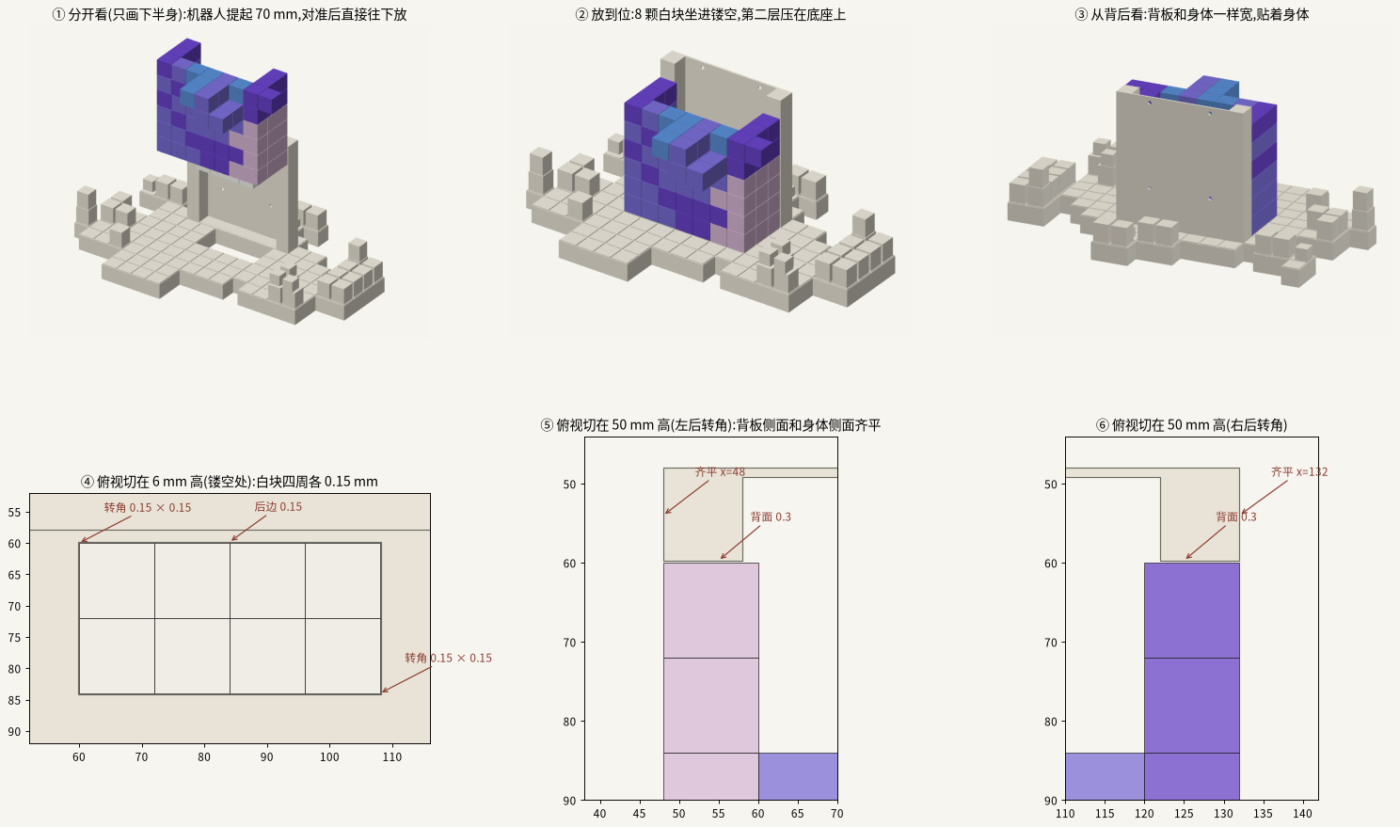
hardware/print/station/休息站_和机器人对比.png
