acrux-yueyao/Mycelium/hardware/print/station/休息站_嵌合剖面.png

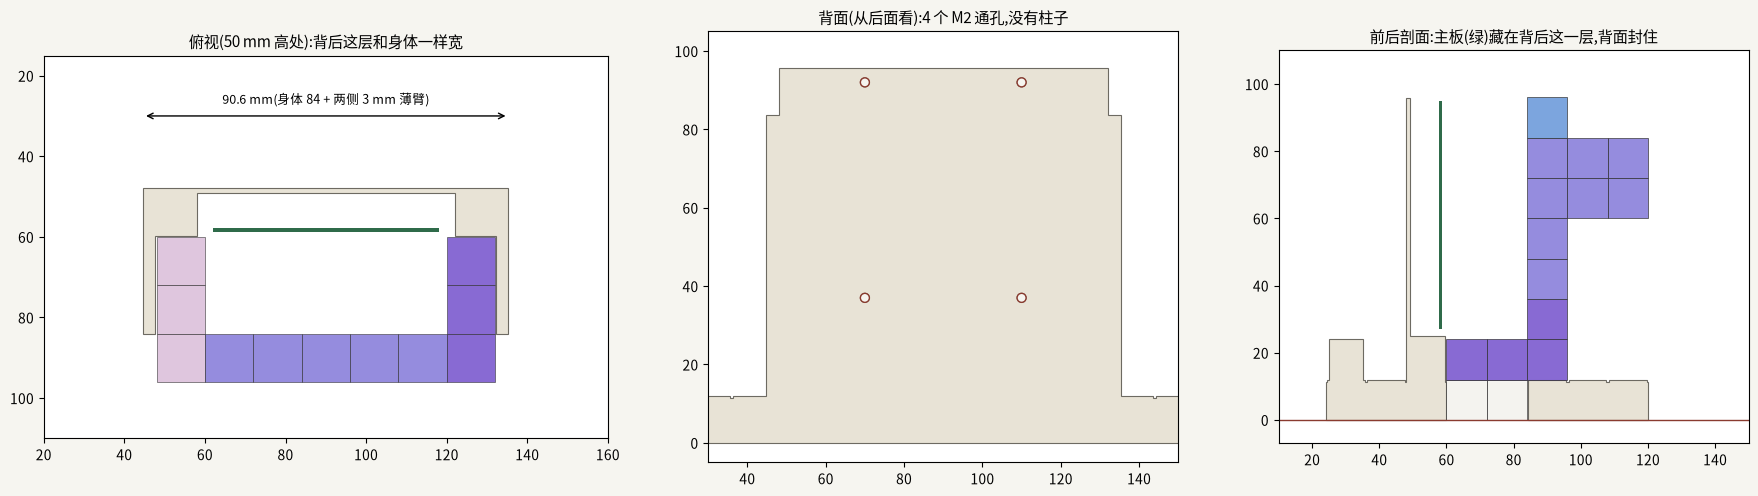
hardware/print/station/休息站_嵌合剖面.png
