acrux-yueyao/Mycelium/hardware/print/station/休息站预览.png

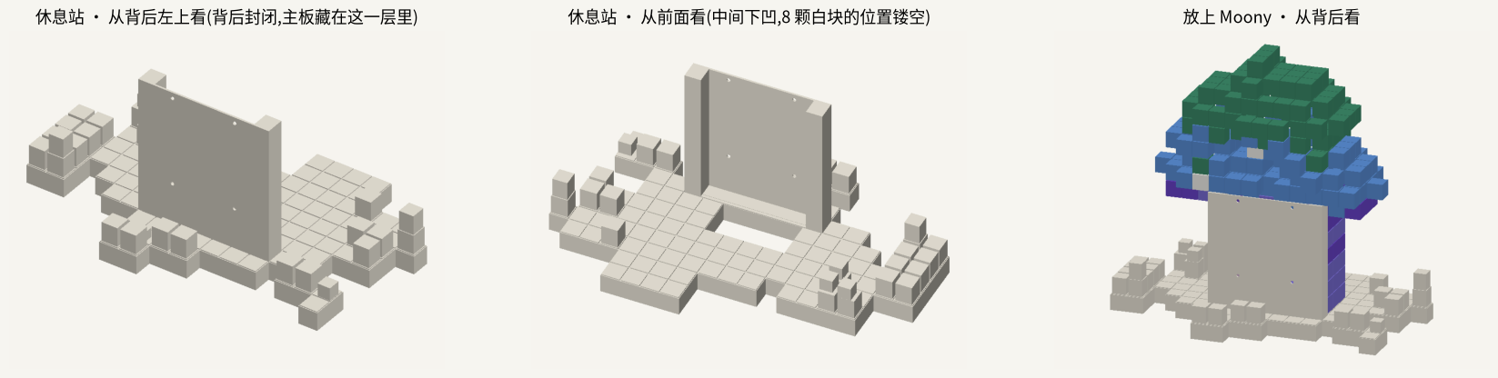
hardware/print/station/休息站预览.png
