acrux-yueyao/Mycelium/hardware/print/moony_touch_v9/fix_06_deep-green_1_sheet.png

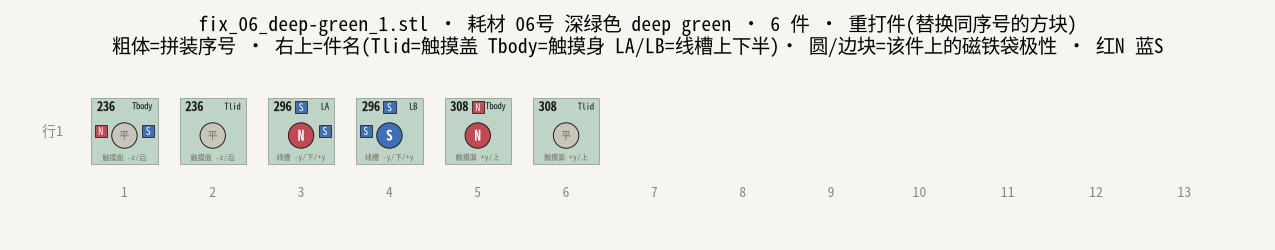
hardware/print/moony_touch_v9/fix_06_deep-green_1_sheet.png
