acrux-yueyao/Mycelium/hardware/print/moony_touch_v9/fix_09_serene-blue_1_sheet.png

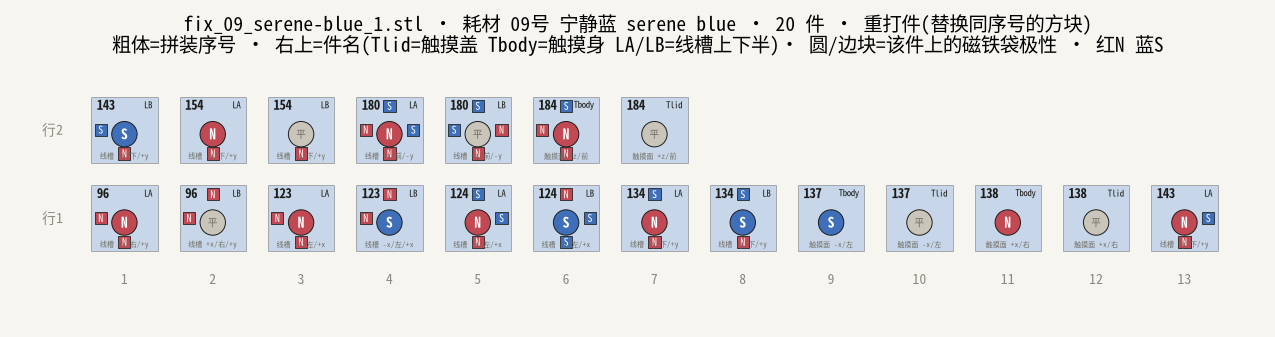
hardware/print/moony_touch_v9/fix_09_serene-blue_1_sheet.png
