acrux-yueyao/Mycelium/hardware/print/moony_touch_v9/fix_13_purple_1_sheet.png

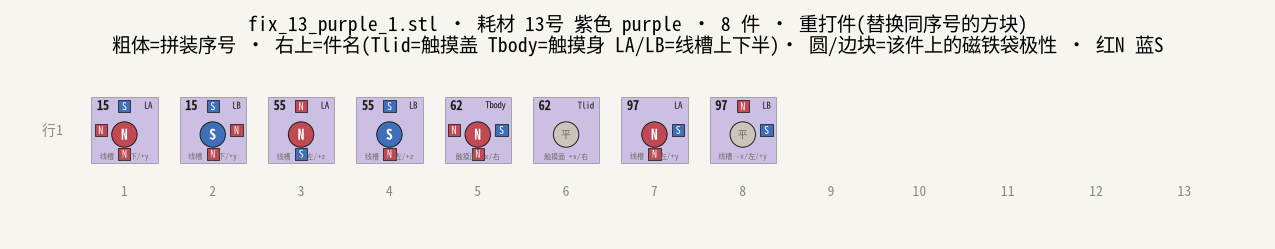
hardware/print/moony_touch_v9/fix_13_purple_1_sheet.png
