acrux-yueyao/Mycelium/hardware/print/moony_touch_v9/认件_fix_06_deep-green_1.png

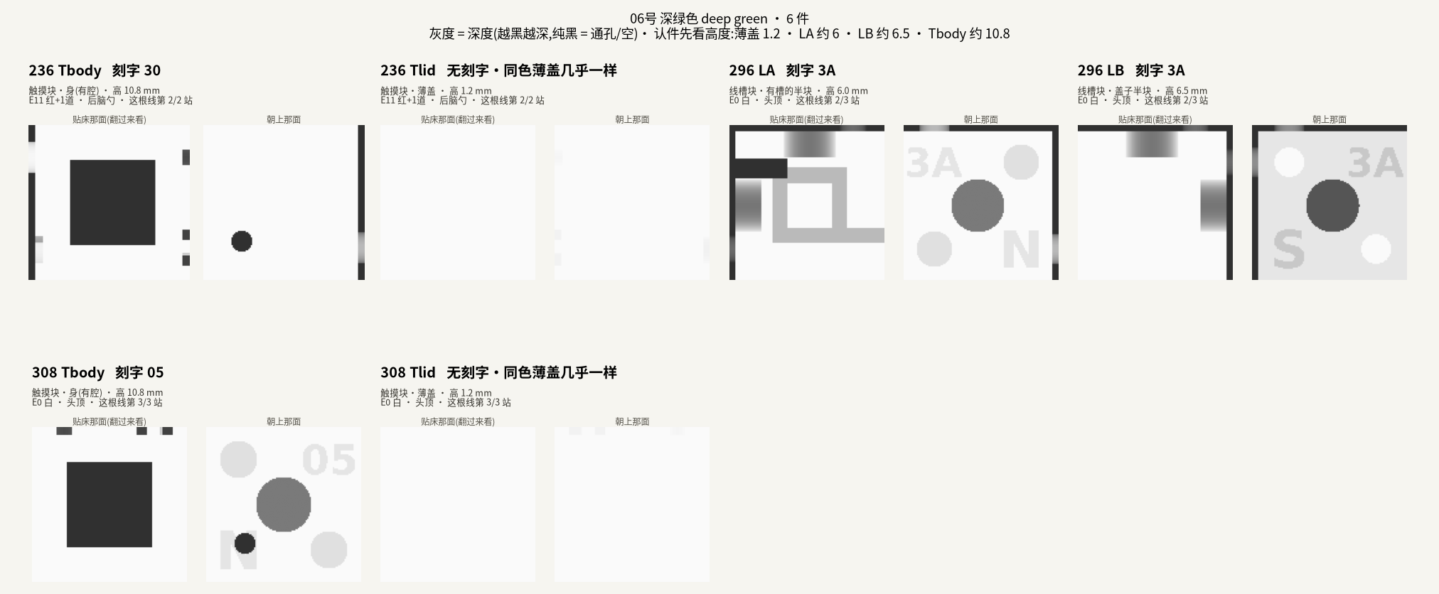
hardware/print/moony_touch_v9/认件_fix_06_deep-green_1.png
