acrux-yueyao/Mycelium/hardware/print/moony_touch_v9/认件_fix_09_serene-blue_1.png

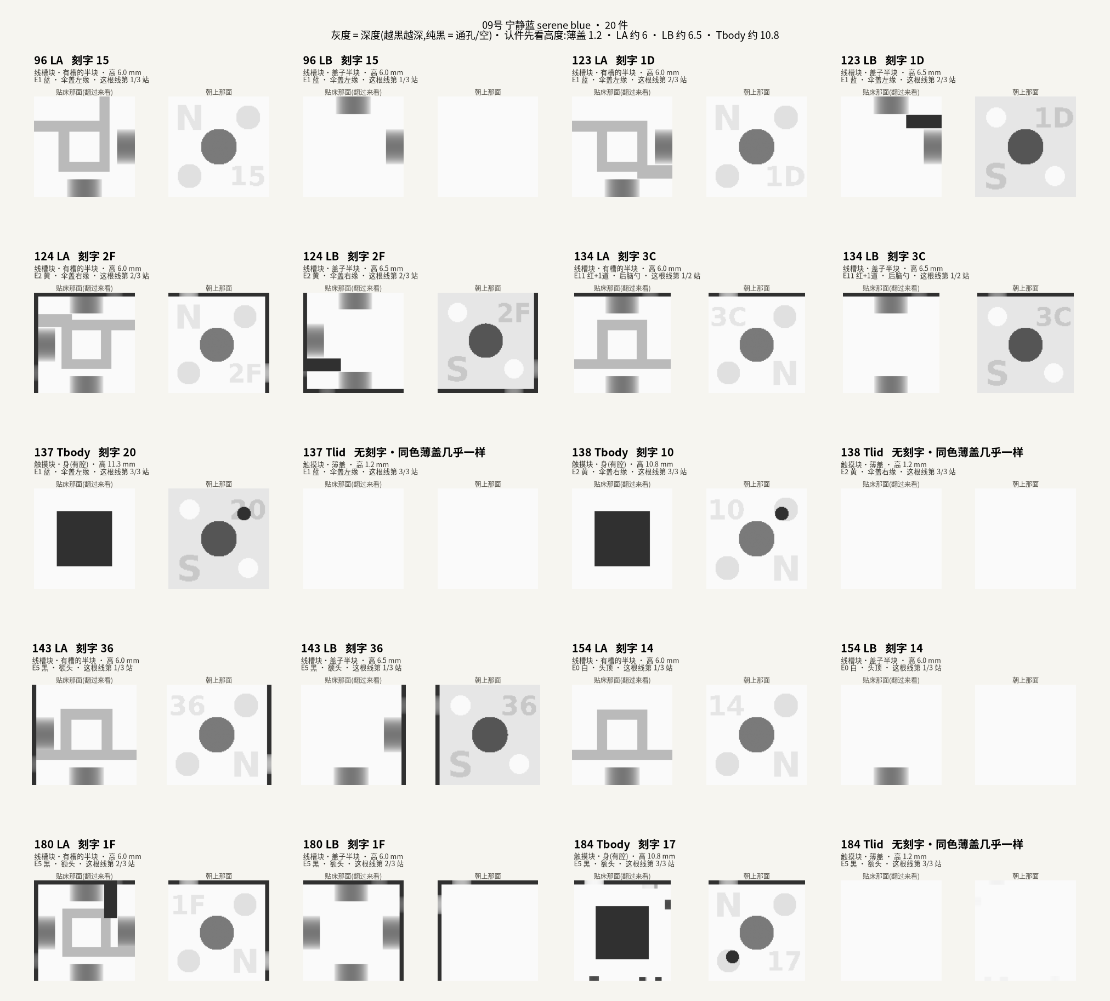
hardware/print/moony_touch_v9/认件_fix_09_serene-blue_1.png
