acrux-yueyao/Mycelium/hardware/print/moony_touch_v9/认件_fix_11_rouge-snow_1.png

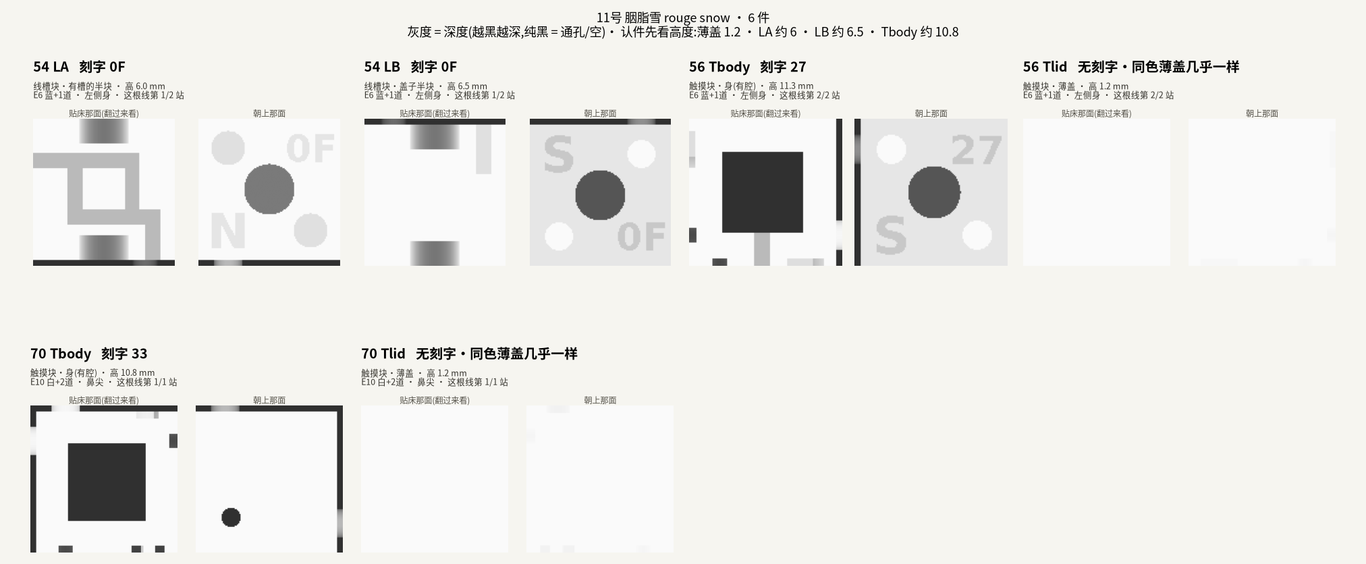
hardware/print/moony_touch_v9/认件_fix_11_rouge-snow_1.png
