acrux-yueyao/Mycelium/hardware/print/moony_touch_v9/认件_fix_13_purple_1.png

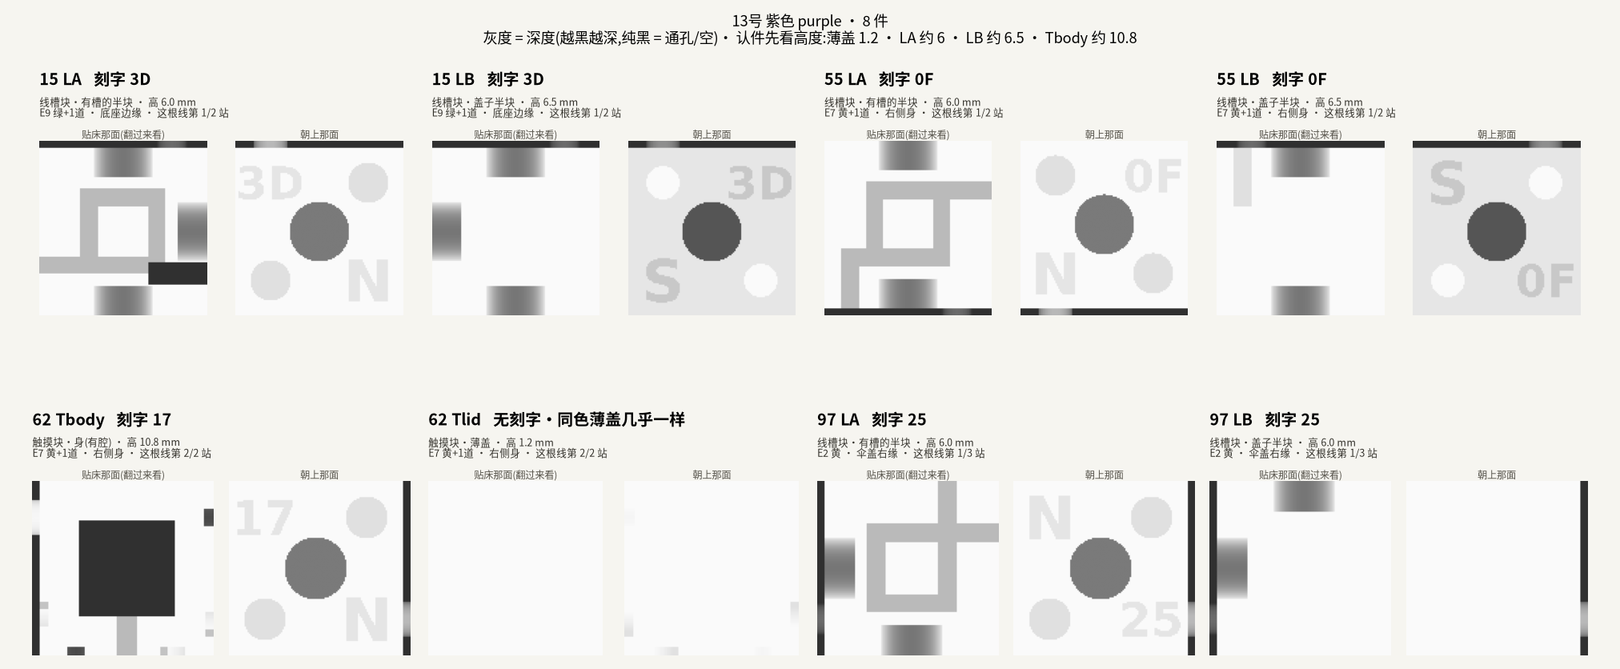
hardware/print/moony_touch_v9/认件_fix_13_purple_1.png
