acrux-yueyao/Mycelium/hardware/mc01_solder_sheet.pdf

## A 感知载板 55×48 · 元件面朝后 B 主控载板 55×48 · 元件面朝后

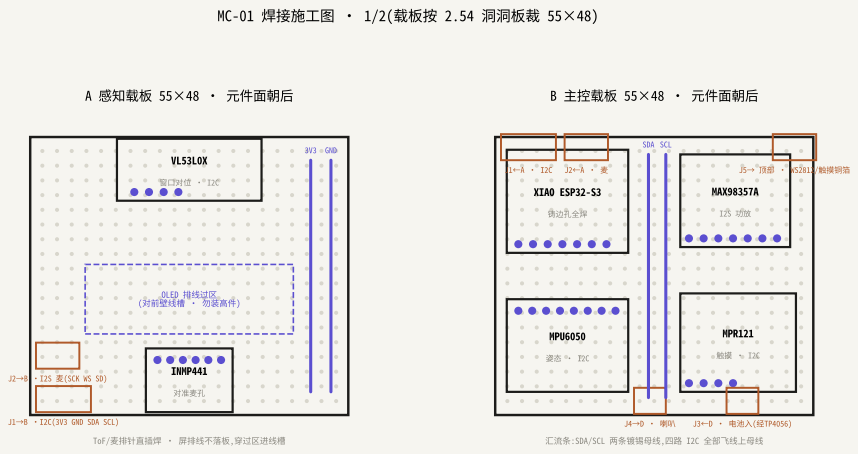
[picture p191: page 1]
窗口对位 · I2C; INMP441; 对准麦孔; OLED 排线过区 (对前壁线槽 · 勿装高件); 3V3 GND; XIAO ESP32-S3; 铸边孔全焊; MAX98357A; MPU6050; MPR121; SDA SCL; J3←D · 电池入(经TP4056); J5→ 顶部 · WS2812/触摸铜箔

MC-01 焊接施工图 · 1/2(载板按 2.54 洞洞板裁 55×48)

J2→B ·I2S 麦(SCK WS SD)

J1→B ·I2C(3V3 GND SDA SCL)

ToF/麦排针直插焊 · 屏排线不落板,穿过区进线槽

汇流条:SDA/SCL 两条镀锡母线,四路 I2C 全部飞线上母线

## C 能量层 55×48(免焊)

## D 底舱平面 56×22

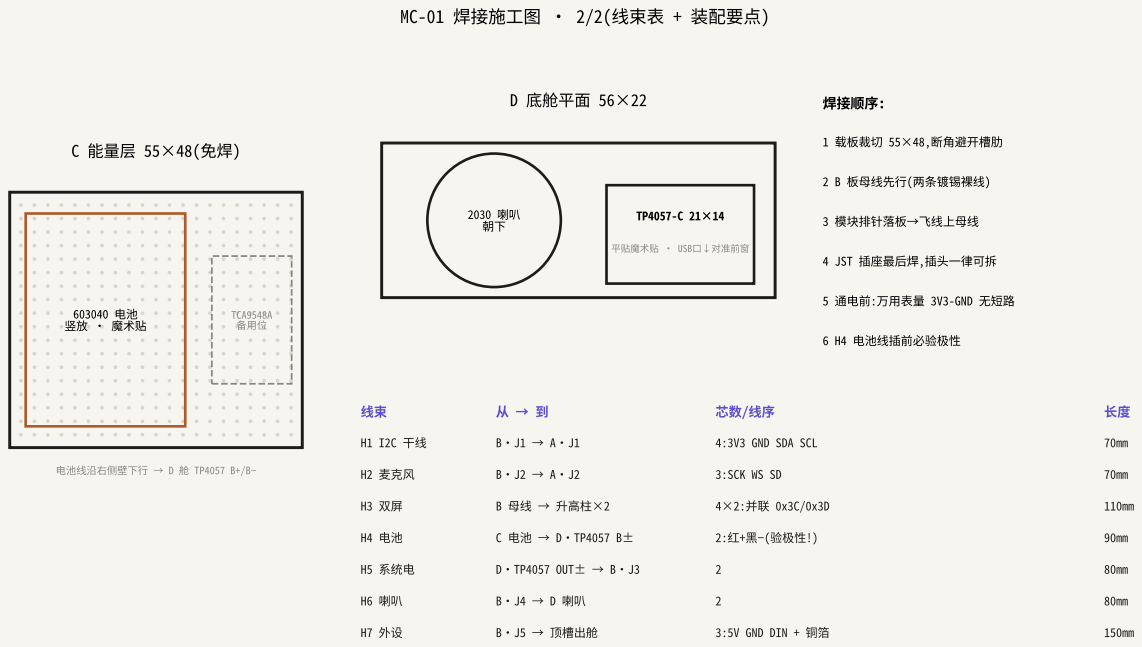
[picture p192: page 2]
603040 电池 竖放 · 魔术贴; TCA9548A 备用位; 电池线沿右侧壁下行 → D 舱 TP4057 B+/B−; 4:3V3 GND SDA SCL; H2 麦克风; 3:SCK WS SD; B 母线 → 升高柱×2; 2:红+黑−(验极性!); H5 系统电; D·TP4057 OUT± → B·J3; B·J5 → 顶槽出舱; 3:5V GND DIN + 铜箔; 焊接顺序:; 1 载板裁切 55×48,断角避开槽肋; 2 B 板母线先行(两条镀锡裸线); 3 模块排针落板→飞线上母线; 6 H4 电池线插前必验极性

MC-01 焊接施工图 · 2/2(线束表 + 装配要点)

平贴魔术贴 · USB口↓对准前窗

4 JST 插座最后焊,插头一律可拆
5 通电前:万用表量 3V3-GND 无短路
