acrux-yueyao/Mycelium/hardware/print/moony_touch_v9/线路卡/走线图_全部.pdf

# E10 · 鼻尖 · 线 白 + 2 道胶带

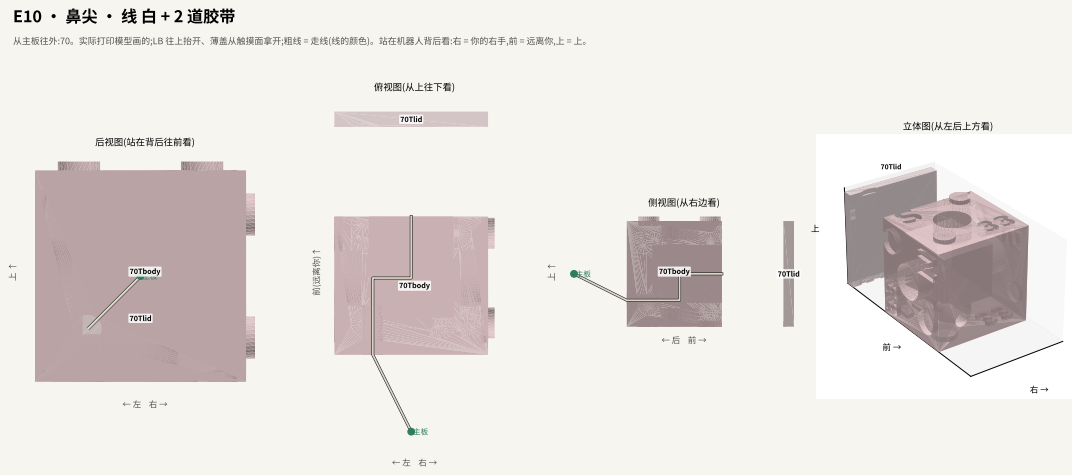
[picture p193: page 1]
后视图(站在背后往前看); 主板 ⁷⁰Tbody; 70Tlid; 前(远离你)↑; 俯视图(从上往下看); 70Tbody; 侧视图(从右边看); 立体图(从左后上方看)

从主板往外:70。实际打印模型画的;LB 往上抬开、薄盖从触摸面拿开;粗线 = 走线(线的颜色)。站在机器人背后看:右 = 你的右手,前 = 远离你,上 = 上。

# E6 · 左侧身 · 线 蓝 + 1 道胶带

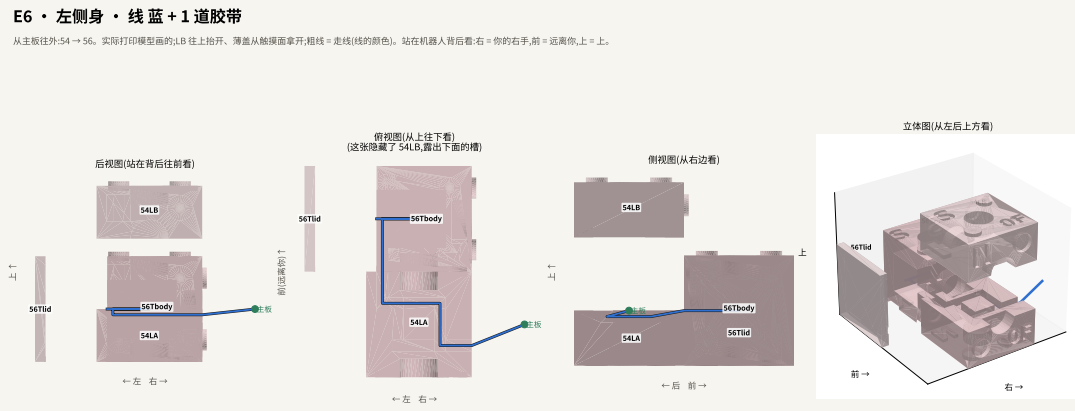
[picture p194: page 2]
后视图(站在背后往前看); 56Tbody 56Tlid; 前(远离你)↑; 俯视图(从上往下看) (这张隐藏了 54LB,露出下面的槽); 56Tlid; 56Tbody; 侧视图(从右边看); 立体图(从左后上方看)

从主板往外:54 → 56。实际打印模型画的;LB 往上抬开、薄盖从触摸面拿开;粗线 = 走线(线的颜色)。站在机器人背后看:右 = 你的右手,前 = 远离你,上 = 上。

# E7 · 右侧身 · 线 黄 + 1 道胶带

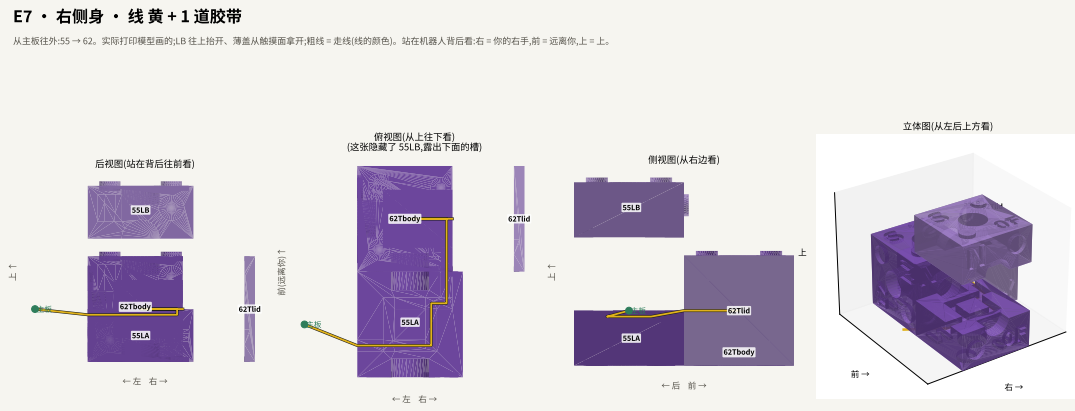
[picture p195: page 3]
后视图(站在背后往前看); 62Tbody; 62Tlid; 前(远离你)↑; 俯视图(从上往下看) (这张隐藏了 55LB,露出下面的槽); 侧视图(从右边看); 立体图(从左后上方看)

从主板往外:55 → 62。实际打印模型画的;LB 往上抬开、薄盖从触摸面拿开;粗线 = 走线(线的颜色)。站在机器人背后看:右 = 你的右手,前 = 远离你,上 = 上。

## (这张隐藏了 15LB,露出下面的槽)

# E9 · 底座边缘 · 线 绿 + 1 道胶带

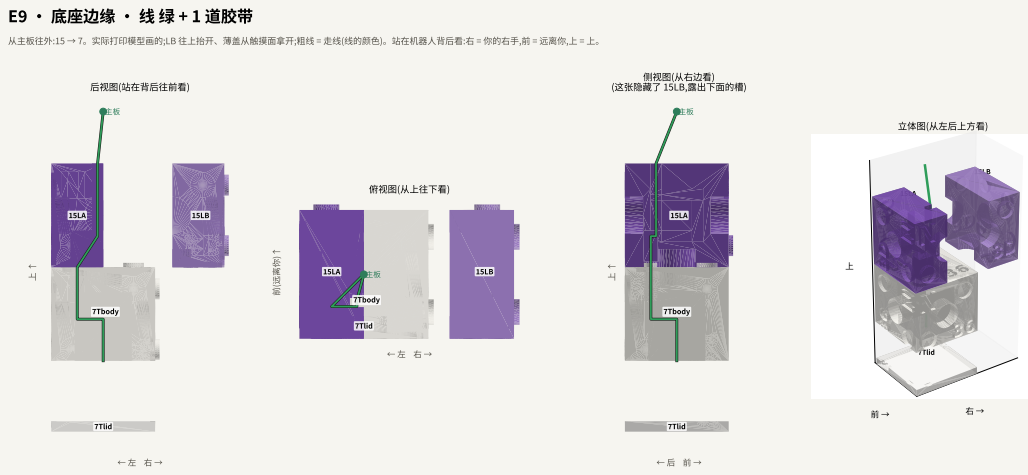
[picture p196: page 4]
后视图(站在背后往前看); 7Tbody; 7Tlid; 前(远离你)↑; 俯视图(从上往下看); 侧视图(从右边看); 立体图(从左后上方看)

从主板往外:15 → 7。实际打印模型画的;LB 往上抬开、薄盖从触摸面拿开;粗线 = 走线(线的颜色)。站在机器人背后看:右 = 你的右手,前 = 远离你,上 = 上。

# E5 · 额头 · 线 黑

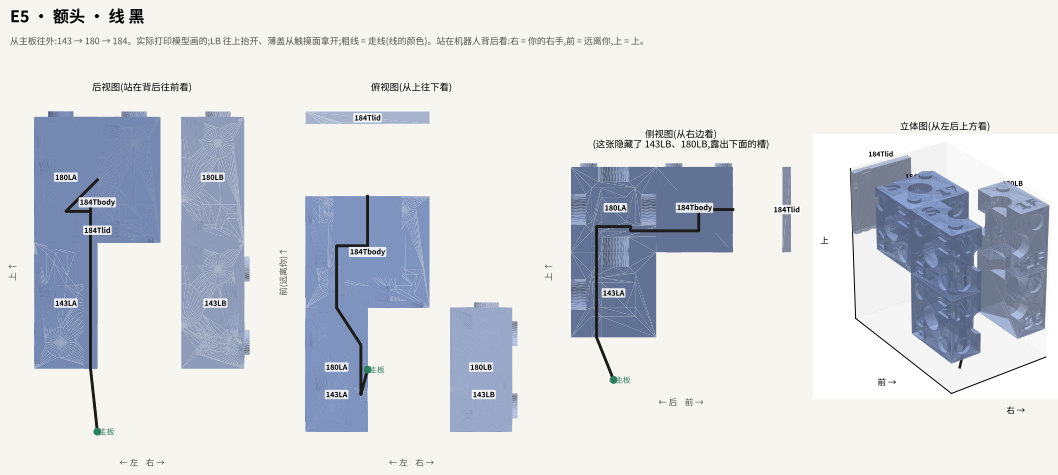
[picture p197: page 5]
后视图(站在背后往前看); 184Tbody; 184Tlid; 前(远离你)↑; 俯视图(从上往下看); 侧视图(从右边看) (这张隐藏了 143LB、180LB,露出下面的槽); 立体图(从左后上方看)

从主板往外:143 → 180 → 184。实际打印模型画的;LB 往上抬开、薄盖从触摸面拿开;粗线 = 走线(线的颜色)。站在机器人背后看:右 = 你的右手,前 = 远离你,上 = 上。

# E1 · 伞盖左缘 · 线 蓝

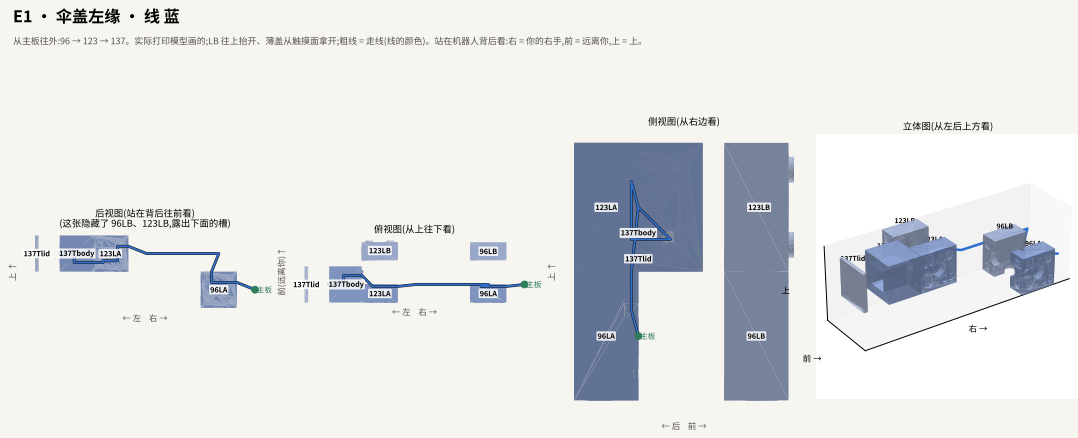
[picture p198: page 6]
后视图(站在背后往前看) (这张隐藏了 96LB、123LB,露出下面的槽); 137Tlid 137Tbody 123LA; 前(远离你)↑; 俯视图(从上往下看); 137Tlid 137Tbody; 侧视图(从右边看); 137Tbody; 137Tlid; 立体图(从左后上方看)

从主板往外:96 → 123 → 137。实际打印模型画的;LB 往上抬开、薄盖从触摸面拿开;粗线 = 走线(线的颜色)。站在机器人背后看:右 = 你的右手,前 = 远离你,上 = 上。

# E2 · 伞盖右缘 · 线 黄

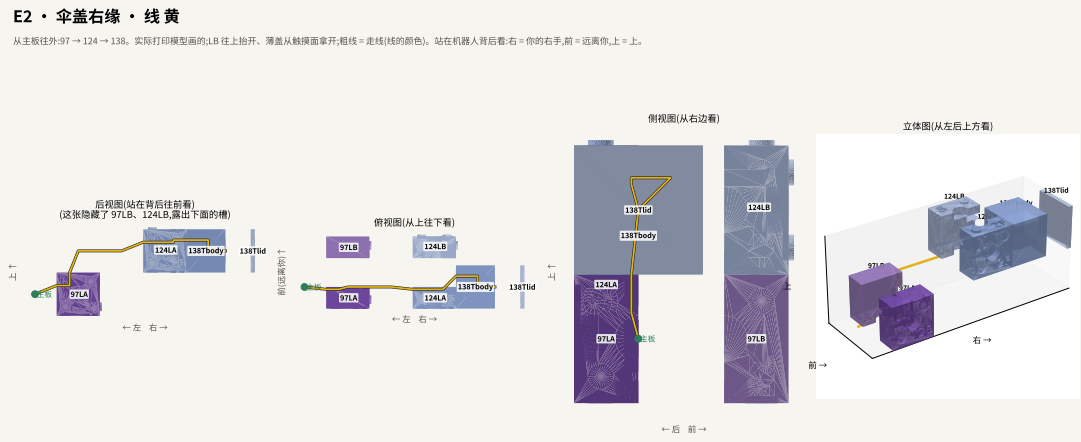
[picture p199: page 7]
后视图(站在背后往前看) (这张隐藏了 97LB、124LB,露出下面的槽); 124LA 138Tbody; 138Tlid; 前(远离你)↑; 俯视图(从上往下看); 138Tbody; 侧视图(从右边看); 立体图(从左后上方看)

从主板往外:97 → 124 → 138。实际打印模型画的;LB 往上抬开、薄盖从触摸面拿开;粗线 = 走线(线的颜色)。站在机器人背后看:右 = 你的右手,前 = 远离你,上 = 上。

## (这张隐藏了 154LB、296LB,露出下面的槽)

# E0 · 头顶 · 线 白

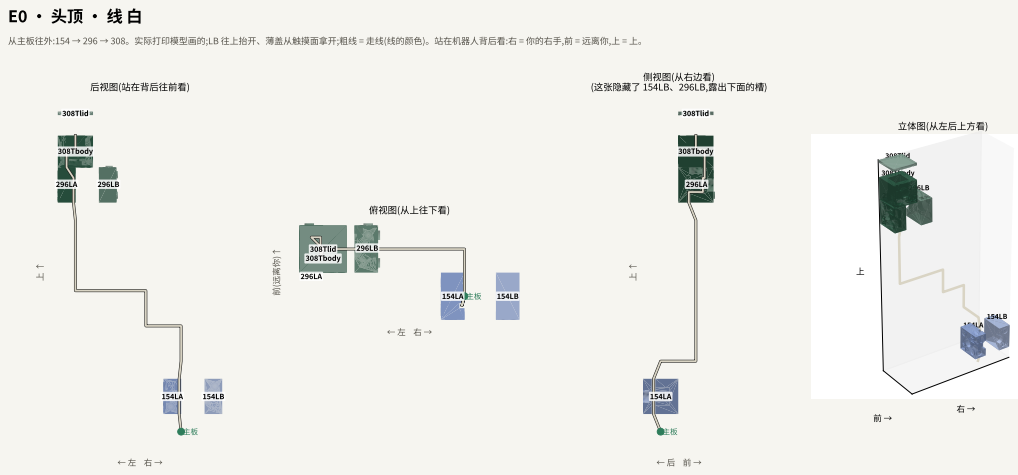
[picture p200: page 8]
后视图(站在背后往前看); 308Tbody; 308Tlid; 前(远离你)↑; 俯视图(从上往下看); 308Tlid 308Tbody 296LA; 侧视图(从右边看); 立体图(从左后上方看)

从主板往外:154 → 296 → 308。实际打印模型画的;LB 往上抬开、薄盖从触摸面拿开;粗线 = 走线(线的颜色)。站在机器人背后看:右 = 你的右手,前 = 远离你,上 = 上。

## (这张隐藏了 134LB,露出下面的槽)

# E11 · 后脑勺 · 线 红 + 1 道胶带

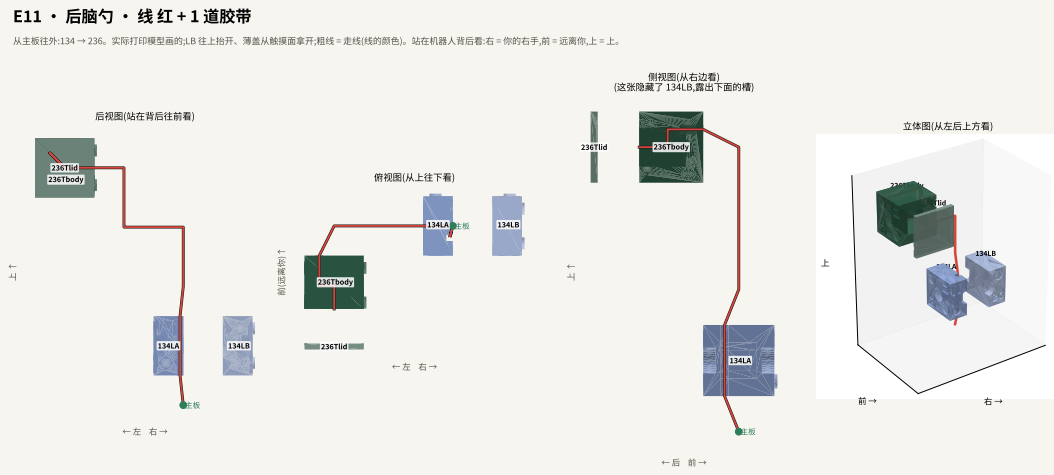
[picture p201: page 9]
后视图(站在背后往前看); 236Tlid 236Tbody; 前(远离你)↑; 俯视图(从上往下看); 236Tbody; 236Tlid; 侧视图(从右边看); 236Tbody 236Tlid; 立体图(从左后上方看)

从主板往外:134 → 236。实际打印模型画的;LB 往上抬开、薄盖从触摸面拿开;粗线 = 走线(线的颜色)。站在机器人背后看:右 = 你的右手,前 = 远离你,上 = 上。
