acrux-yueyao/Mycelium/hardware/print/moony_touch_v9/线路卡/三视图_全部.pdf

# E10 · 鼻尖 · 线 白 + 2 道胶带

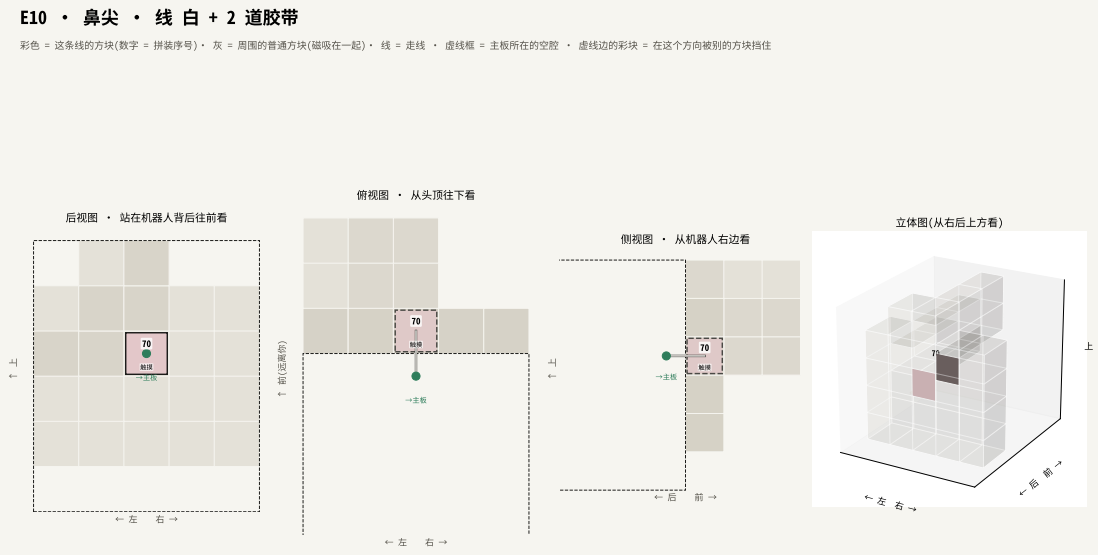
[picture p202: page 1]
后视图 · 站在机器人背后往前看; 前(远离你); 俯视图 · 从头顶往下看; 侧视图 · 从机器人右边看; 立体图(从右后上方看)

彩色 = 这条线的方块(数字 = 拼装序号)· 灰 = 周围的普通方块(磁吸在一起)· 线 = 走线 · 虚线框 = 主板所在的空腔 · 虚线边的彩块 = 在这个方向被别的方块挡住

# E6 · 左侧身 · 线 蓝 + 1 道胶带

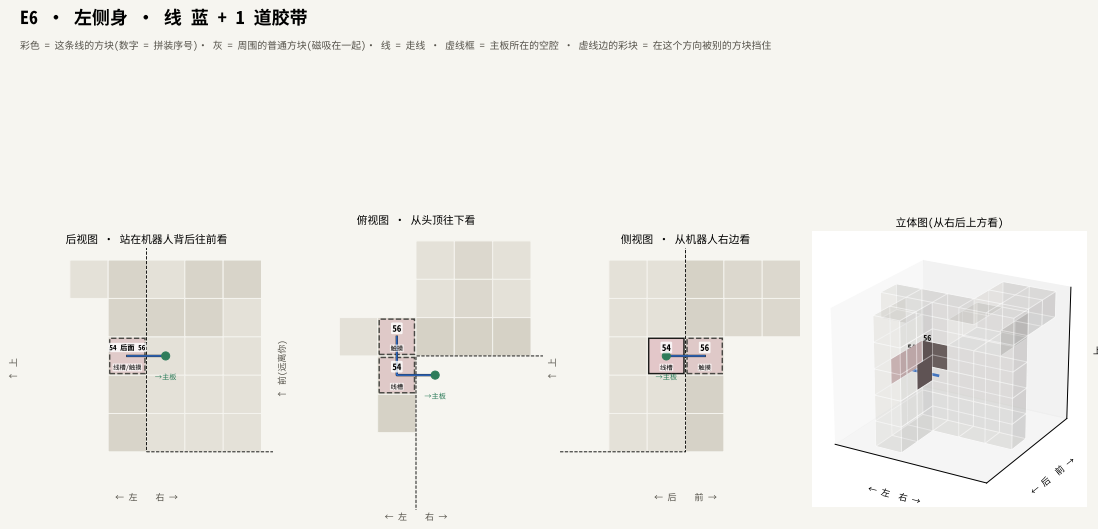
[picture p203: page 2]
后视图 · 站在机器人背后往前看; 前(远离你); 俯视图 · 从头顶往下看; 侧视图 · 从机器人右边看; 立体图(从右后上方看)

彩色 = 这条线的方块(数字 = 拼装序号)· 灰 = 周围的普通方块(磁吸在一起)· 线 = 走线 · 虚线框 = 主板所在的空腔 · 虚线边的彩块 = 在这个方向被别的方块挡住

# E7 · 右侧身 · 线 黄 + 1 道胶带

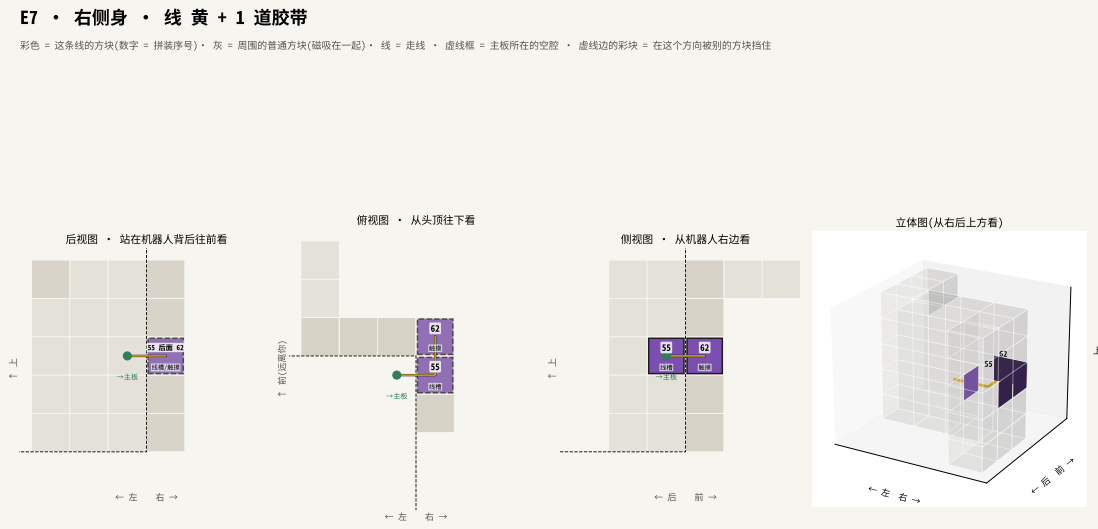
[picture p204: page 3]
后视图 · 站在机器人背后往前看; 前(远离你); 俯视图 · 从头顶往下看; 侧视图 · 从机器人右边看; 立体图(从右后上方看)

彩色 = 这条线的方块(数字 = 拼装序号)· 灰 = 周围的普通方块(磁吸在一起)· 线 = 走线 · 虚线框 = 主板所在的空腔 · 虚线边的彩块 = 在这个方向被别的方块挡住

# E9 · 底座边缘 · 线 绿 + 1 道胶带

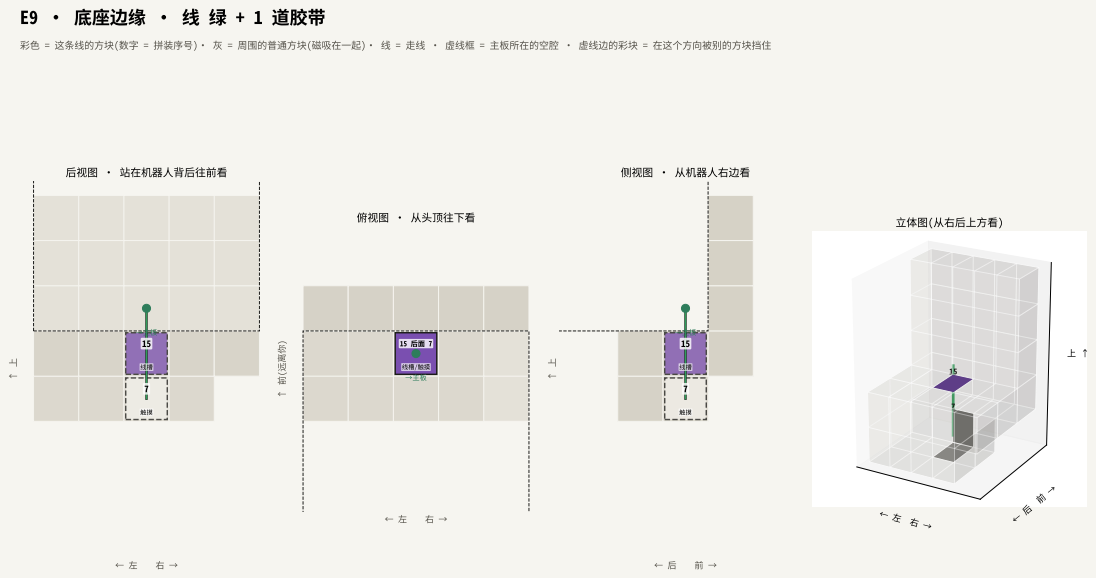
[picture p205: page 4]
后视图 · 站在机器人背后往前看; 前(远离你); 俯视图 · 从头顶往下看; 侧视图 · 从机器人右边看; 立体图(从右后上方看)

彩色 = 这条线的方块(数字 = 拼装序号)· 灰 = 周围的普通方块(磁吸在一起)· 线 = 走线 · 虚线框 = 主板所在的空腔 · 虚线边的彩块 = 在这个方向被别的方块挡住

# E5 · 额头 · 线 黑

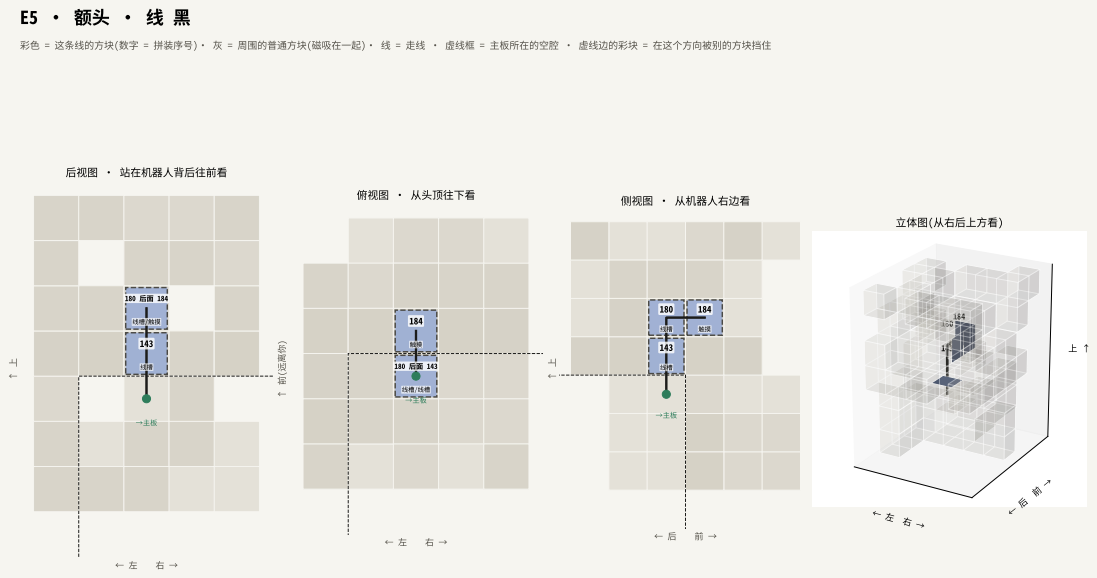
[picture p206: page 5]
后视图 · 站在机器人背后往前看; 前(远离你); 俯视图 · 从头顶往下看; 侧视图 · 从机器人右边看; 立体图(从右后上方看)

彩色 = 这条线的方块(数字 = 拼装序号)· 灰 = 周围的普通方块(磁吸在一起)· 线 = 走线 · 虚线框 = 主板所在的空腔 · 虚线边的彩块 = 在这个方向被别的方块挡住

# E1 · 伞盖左缘 · 线 蓝

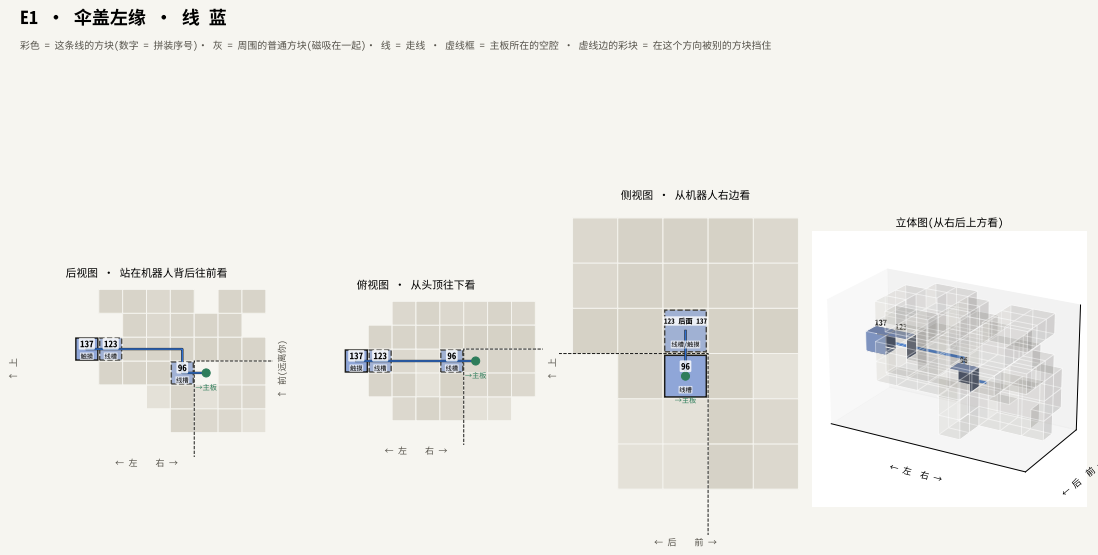
[picture p207: page 6]
后视图 · 站在机器人背后往前看; 前(远离你); 俯视图 · 从头顶往下看; 侧视图 · 从机器人右边看; 立体图(从右后上方看)

彩色 = 这条线的方块(数字 = 拼装序号)· 灰 = 周围的普通方块(磁吸在一起)· 线 = 走线 · 虚线框 = 主板所在的空腔 · 虚线边的彩块 = 在这个方向被别的方块挡住

# E2 · 伞盖右缘 · 线 黄

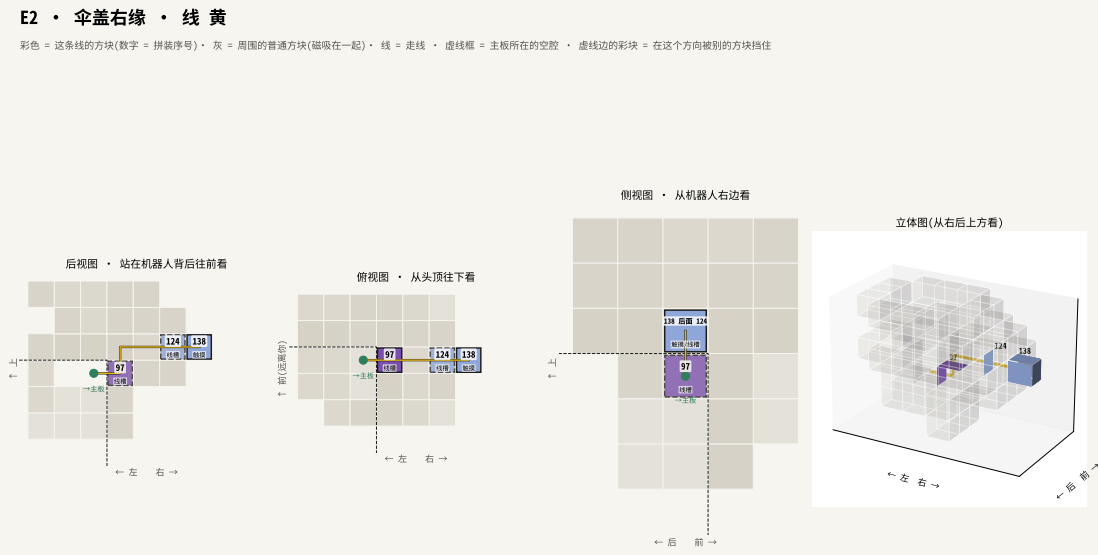
[picture p208: page 7]
后视图 · 站在机器人背后往前看; 前(远离你); 俯视图 · 从头顶往下看; 侧视图 · 从机器人右边看; 立体图(从右后上方看)

彩色 = 这条线的方块(数字 = 拼装序号)· 灰 = 周围的普通方块(磁吸在一起)· 线 = 走线 · 虚线框 = 主板所在的空腔 · 虚线边的彩块 = 在这个方向被别的方块挡住

# E0 · 头顶 · 线 白

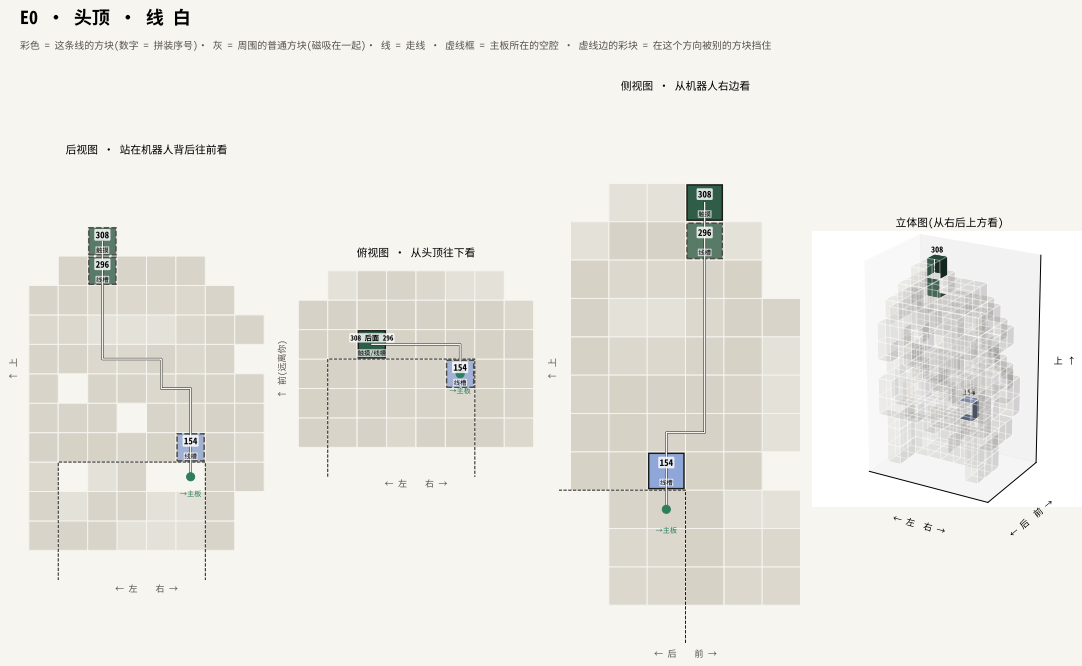
[picture p209: page 8]
后视图 · 站在机器人背后往前看; 前(远离你); 俯视图 · 从头顶往下看; 侧视图 · 从机器人右边看; 立体图(从右后上方看)

彩色 = 这条线的方块(数字 = 拼装序号)· 灰 = 周围的普通方块(磁吸在一起)· 线 = 走线 · 虚线框 = 主板所在的空腔 · 虚线边的彩块 = 在这个方向被别的方块挡住

# E11 · 后脑勺 · 线 红 + 1 道胶带

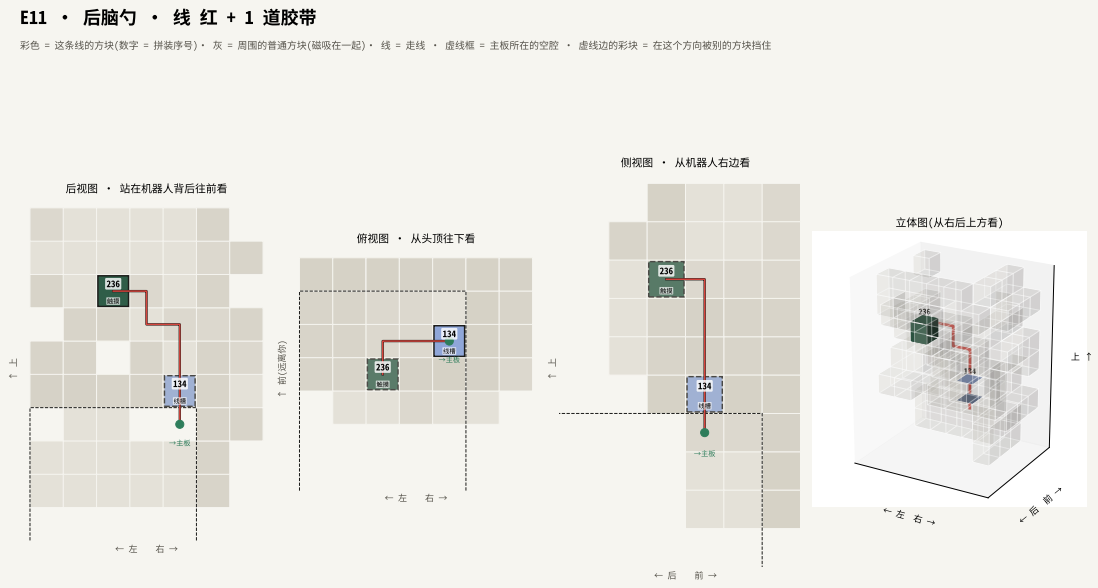
[picture p210: page 9]
后视图 · 站在机器人背后往前看; 前(远离你); 俯视图 · 从头顶往下看; 侧视图 · 从机器人右边看; 立体图(从右后上方看)

彩色 = 这条线的方块(数字 = 拼装序号)· 灰 = 周围的普通方块(磁吸在一起)· 线 = 走线 · 虚线框 = 主板所在的空腔 · 虚线边的彩块 = 在这个方向被别的方块挡住
