acrux-yueyao/Mycelium/hardware/pcb/out/facebrd.kicad_pcb

## KiCad design hardware/pcb/out/facebrd.kicad_pcb (2026-10-07)

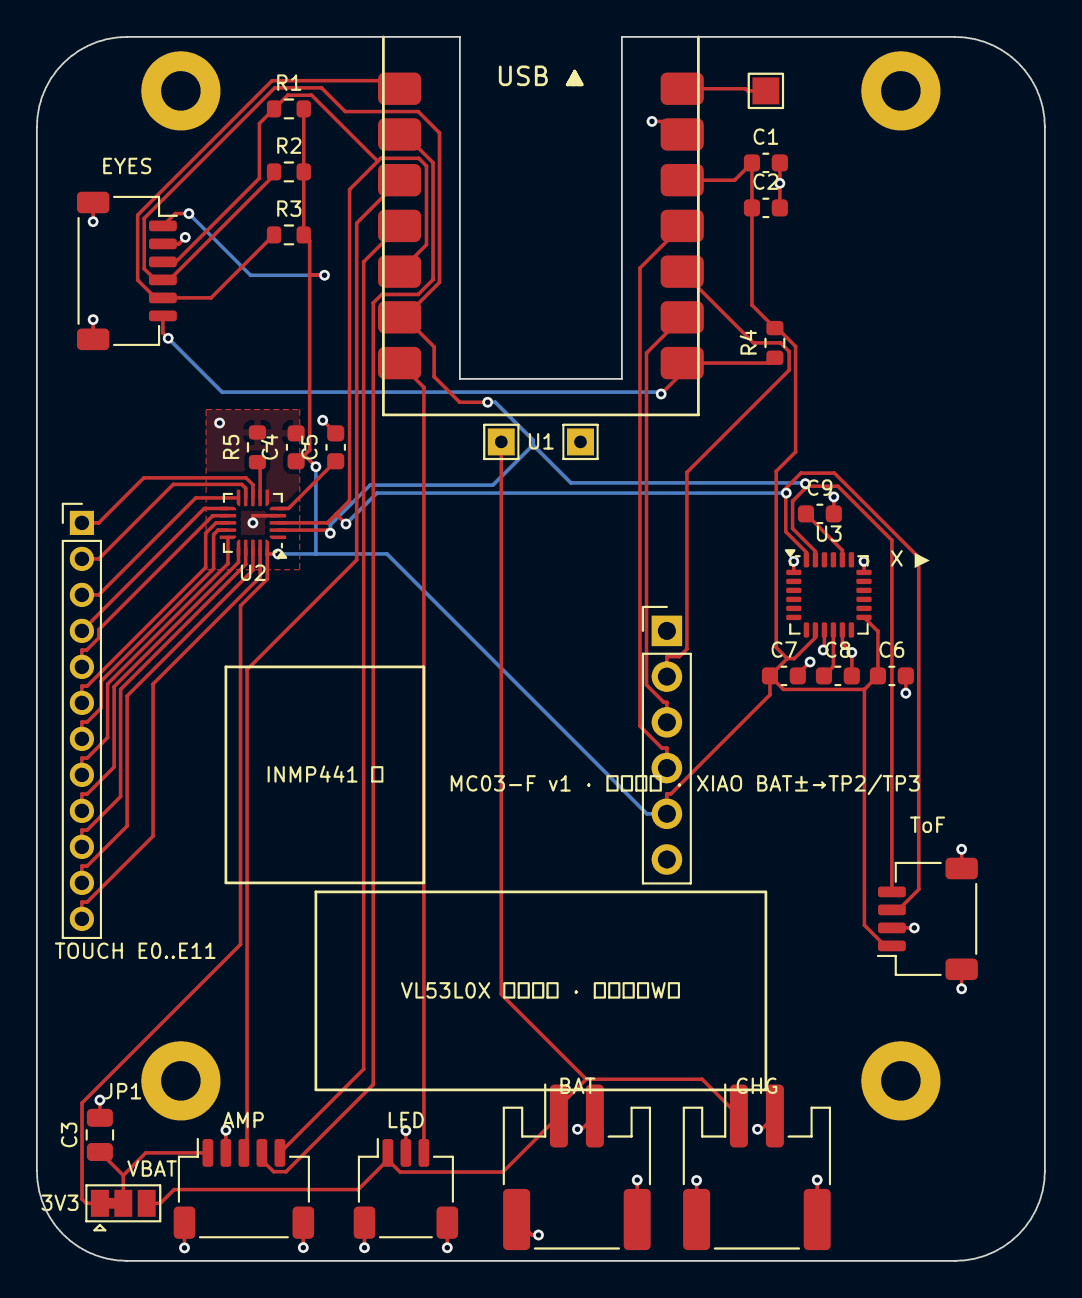
[picture p211: board facebrd.kicad_pcb from above]

Board: 2 copper layers, 56.0 x 68.0 mm, 33 parts (0 on the bottom side), 32 nets.

Parts:
C1: 10uF; C_0603_1608Metric
C2, C4, C5, C6, C8: 100nF; C_0603_1608Metric
C3: 22uF; C_0805_2012Metric
C7: 10nF; C_0603_1608Metric
C9: 2.2nF; C_0603_1608Metric
H1, H2, H3, H4: M2; MountingHole_2.2mm_M2_Pad
J1: ToF 4P; JST_SH_SM04B-SRSS-TB_1x04-1MP_P1.00mm_Horizontal
J2: MIC pads; PinHeader_1x06_P2.54mm_Vertical
J3: EYES 6P; JST_SH_SM06B-SRSS-TB_1x06-1MP_P1.00mm_Horizontal
J4: BAT; JST_PH_S2B-PH-SM4-TB_1x02-1MP_P2.00mm_Horizontal
J5: LED 3P; JST_SH_SM03B-SRSS-TB_1x03-1MP_P1.00mm_Horizontal
J6: AMP 5P; JST_SH_SM05B-SRSS-TB_1x05-1MP_P1.00mm_Horizontal
J7: TOUCH pads; PinHeader_1x12_P2.00mm_Vertical
J8: CHG; JST_PH_S2B-PH-SM4-TB_1x02-1MP_P2.00mm_Horizontal
JP1: AMP_VIN sel; SolderJumper-3_P1.3mm_Bridged12_Pad1.0x1.5mm
R1, R2, R3, R4: 4.7k; R_0603_1608Metric
R5: 75k; R_0603_1608Metric
TP1: VBUS; TestPoint_Pad_1.5x1.5mm
TP2: BAT+; TestPoint_THTPad_1.5x1.5mm_Drill0.7mm
TP3: BAT-; TestPoint_THTPad_1.5x1.5mm_Drill0.7mm
U1: XIAO-ESP32S3; XIAO-ESP32S3_SMD
U2: MPR121QR2; UQFN-20_3x3mm_P0.4mm
U3: MPU-6050; InvenSense_QFN-24_4x4mm_P0.5mm

Connections:
3V3: C1.1, C2.1, C4.1, C6.1, C7.1, J1.1, J2.5, J3.1, JP1.1, R1.2, R2.2, R3.2, R4.2, U1.12, U2.20, U3.8, U3.13
AMP_VIN: C3.1, J6.1, JP1.2
CPOUT: C9.1, U3.20
ELE0: J7.1, U2.8
ELE1: J7.2, U2.9
ELE2: J7.3, U2.10
ELE3: J7.4, U2.11
ELE4: J7.5, U2.12
ELE5: J7.6, U2.13
ELE6: J7.7, U2.14
ELE7: J7.8, U2.15
ELE8: J7.9, U2.16
ELE9: J7.10, U2.17
ELE10: J7.11, U2.18
ELE11: J7.12, U2.19
GND: C1.2, C2.2, C3.2, C4.2, C5.2, C6.2, C7.2, C8.2, C9.2, H1.1, H2.1, H3.1, H4.1, J1.2, J1.MP, J2.1, J2.6, J3.2, J3.MP, J4.2, J4.MP, J5.2, J5.MP, J6.2, J6.MP, J8.2, J8.MP, R5.2, TP3.1, U1.13, U2.4, U2.6, U3.1, U3.9, U3.11, U3.18
I2S_BCLK: J6.3, U1.3
I2S_DIN: J6.5, U1.4
I2S_LRC: J6.4, U1.2
LED_DIN: J5.3, U1.7
MIC_SCK: J2.3, U1.9
MIC_SD: J2.4, U1.11
MIC_WS: J2.2, U1.10
REGOUT: C8.1, U3.10
REXT: R5.1, U2.7
SCL0: J1.4, J3.4, R2.1, U1.6, U2.2, U3.23
SCL1: J3.6, R4.1, U1.8
SDA0: J1.3, J3.3, R1.1, U1.5, U2.3, U3.24
SDA1: J3.5, R3.1, U1.1
VBAT: J4.1, J5.1, J8.1, JP1.3, TP2.1
VBUS: TP1.1, U1.14
VREG: C5.1, U2.5
