acrux-yueyao/Mycelium/(commit log)

2026-04-16 feat: Phase 0 Mycelium prototype — single-specimen Genesis
    Scaffolds the Phase 0 restart per the approved plan: one sentence in,
    one breathing slime-mold specimen out. LLM is a hard dependency;
    failures surface as visible error state, no local fallback.
    Stack:
    - Vite + React + TypeScript + Three.js (no R3F needed; raw WebGL passes)
    - GLSL shaders imported via `?raw`
    Core pipeline (src/render/PhysarumField.tsx):
    - Ping-pong FBOs for agent state (Float RT) and trail (HalfFloat RT)
    - Per-frame passes: agent update → additive deposit → diffuse+decay → display
    - Agent fragment shader samples trail at three sense angles and steers
    (Jeff Jones 2010 Physarum model)
    - Display maps trail t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
2026-04-16 chore: add vercel.json for one-click deployment
    Configures Vite framework detection, build command, and API route
    rewrites so the api/emotion.ts Edge function works alongside the
    SPA frontend.
    https://claude.ai/code/session_01W5X8UbkweUXRYmhWVgREdN
2026-04-16 fix: switch to claude-3-5-haiku, add beta header, improve error display
    - Model: claude-haiku-4-5 -> claude-3-5-haiku-20241022 (more widely available)
    - Add anthropic-beta: prompt-caching-2024-07-31 header (required for cache_control)
    - Frontend now shows full backend error detail in failure state for debugging
    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
2026-04-16 fix: switch model to claude-sonnet-4-5-20250514\n\nhttps://claude.ai/code/session_01W5X8UbkweUXRYmhWVgREdN
2026-04-16 feat: refactor Stage 1 — volumetric spore entities with Physarum interior
    Replaces fullscreen trail display with jewel-like spore creatures.
    Each spore has Physarum-textured interior, 3D sphere shading, surface
    patterns per archetype, membrane rim, stalk, glow halo, particle
    emission, sinusoidal drift, breathing pulse, and separation forces.
    5 archetypes mapped to 6 species:
    A grey-white crystalline, B copper-orange, C iridescent holographic,
    D cyan/turquoise granular, E dark bioluminescent.
    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
2026-04-16 feat: add SporeField.tsx — WebGL spore renderer with Physarum interior
    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
2026-04-16 feat: procedural per-archetype shader — 5 morphologically distinct spore types
    Each archetype draws structure not a sphere:
    - Radiolaria: radial skeleton + latitude grid + asymmetric spikes past rim
    - Cribraria: hollow shell + hex honeycomb lattice + intersection beads
    - Metatrichia: dense curly filaments radiating from dark core
    - Colloderma: gel droplet with drifting internal bubbles + refracted glint
    - Thamnidium: irregular lumpy body with asymmetric budding protrusions
    Bodies are semi-transparent, silhouettes broken by radial noise distortion,
    and each spore has 3-4 asymmetric local organs. All layer-composited via
    alpha blending over black background.
    https://claude.ai/code/session_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
2026-04-16 chore: gitignore asset pipeline outputs
    public/assets/characters/ is regenerated by scripts/process_assets.py
    from the raw PNGs in assets/raw/ + assets/community.png. No need to
    track the derived files.
    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
2026-04-16 feat(step 2): pivot to React + framer-motion + PNG scaffold
    Scaffold for the kawaii PNG-based approach. All files are stubs ready
    for Steps 3-8 to fill in (Entity animations, TreeHoleInput, tendrils,
    sparkles, hybrid spawn).
    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
2026-04-16 feat(step 3): Entity component with grow/breathe/float animations
    - Entity.tsx: framer-motion sprite with 3 composed animations
    1. Grow — scale 0 → 1.1 → 1 on mount (1.8s ease-out)
    2. Breathe — scale [1, 1.04, 1] infinite (3.5s)
    3. Float — y [0, -5, 0] infinite (5s)
    phaseOffset prop de-synchronizes multiple entities.
    - styles.css: .entity soft ground shadow (blurred radial ellipse pseudo-element)
    - App.tsx: hardcodes one char0 centered for visual verification
    - package.json: add framer-motion ^12.38.0
    - vercel.json: use --no-frozen-lockfile to avoid pnpm-lock stale errors
    while we iterate (lock is not pushed due to MCP size constraints)
    https://claude.ai/code/session_01W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
2026-04-16 fix: correct face eye coords for all 6 characters
    Pixel-scanned the baked eye dots in each PNG to get true positions.
    Previous coords assumed face was centered in sprite box, but most chars
    have offset geometry (ball on stem, mushroom, side-by-side cups, etc.),
    causing eyelid overlays to blink next to the face instead of on it.
    char0: eye dots at (248,203)/(314,203) → (0.512, 0.467)/(0.649, 0.467)
    char1: (222,190)/(311,192) → (0.459, 0.437)/(0.643, 0.441)
    char2: (142,169)/(207,173) → (0.293, 0.394)/(0.428, 0.394) — eyes on
    mushroom cap, offset left
    char3: sparkles confused scanner — manual estimate
    char4: twin cups — each eye is center of a creature
    char5: manual estimate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
2026-04-16 feat(step 4): TreeHoleInput + emotion API wiring + entity spawn flow
    Frontend:
    - TreeHoleInput: serif textarea, Enter submits, Shift+Enter newline,
    dimmed+reading states, auto-expanding. Lives centered on stage.
    - useEmotion hook: fetch /api/emotion \u2192 map primary.label \u2192 charId
    via emotionToCharId. Exposes loading/error/read/clearError.
    - App.tsx: maintains entities[] list. Each submit appends a new Entity
    of the resolved charId at a random off-center position. Removes the
    old hardcoded-char0 demo.
    - Error toast (framer-motion fade) surfaces API errors with detail and
    "\u518d\u547c\u51fa\u4e00\u6b21" reset.
    - styles.css: new .totem, .totem-input, .totem-reading, .dots (lo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
2026-04-16 feat(phase A): live physics field \u2014 attract / repel / walls / center
    Add src/core/field.ts with stepField() called every RAF. Each entity
    has vx/vy now; forces:
    - Long-range attraction 180 < d < 500, tuned gentle (0.10 base)
    - Short-range repulsion d < 160, quadratic ramp so overlap is forbidden
    - Soft walls at 100px margin
    - Soft center-repel within 190px of viewport center (keeps the input
    totem clear)
    - Damping 0.92 per frame so motion decays into a slow cream drift
    Compatibility stub in characters.ts returns 1.0 for Phase A. Phase C
    will swap in the real 6x6 matrix so attraction can become repulsion
    between incompatible character pairs.
    Phase B (eye tracking + greetings), C (emo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
2026-04-16 feat(phase B): eye tracking + newcomer greeting
    FaceOverlay rebuild: permanent skin patches cover baked eyes, then
    programmatic pupils sit on top \u2014 they translate via spring motion
    values toward the parent's gazeTarget, and animate scaleY for blink/
    wink/squint/happy. Smile arcs still appear above pupils for 'happy'.
    Entity new props:
    - gazeTargetX/Y (world coords) \u2192 computes 5px max pupil offset
    - greetingPulse (counter) \u2192 scale bounce [1, 1.12, 0.96, 1.04, 1]
    via useAnimationControls each increment
    App.tsx:
    - useMemo(gazeMap): each entity's nearest neighbor within 450px
    - On spawn, all neighbors within 320px get greetingPulse++
    fie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
2026-04-16 feat(phase C): compatibility matrix + tendrils + loneliness
    characters.ts: real 6x6 COMPAT_MATRIX replaces the 1.0 placeholder.
    Diagonal is 1.0; lonely (5) is negative with most others except calm.
    core/connections.ts: pair tracking with hysteresis (240px form,
    320px break). Caches compat on formation. Three tendril style bands:
    warm amber for compat > 0.6, color-blend for 0..0.6, dashed indigo
    for < 0.
    components/TendrilLayer.tsx: SVG bezier paths with AnimatePresence
    fade in/out and per-connection style.
    components/Entity.tsx: new `saturation` prop applied as CSS saturate()
    filter on the sprite img.
    App.tsx: RAF loop now also steps connections and tracks
    lonelyExposure per entity (accr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
2026-04-16 feat(phase D.1): hybrid fusion
    A connected pair with compat \u2265 0.5 held for \u2265 4s fuses into a rainbow
    Hybrid entity at the midpoint. The parents are pushed gently outward
    to make space, and the connection tendril fades out. A 15s cooldown
    prevents the same pair from fusing repeatedly.
    Entity.tsx:
    - New `isHybrid` prop. When true, uses HYBRID_ASSET, skips FaceOverlay
    (hybrid keeps its baked face), grows slightly larger on mount, and
    emits a one-shot expanding aura ring.
    - fusedPairsRef tracks pair\u2192last-fusion-timestamp for cooldown.
    - Per frame: detect pairs meeting fusion criteria, delete their
    connection, push parents outward, spawn the hybrid at midpoint.
    - L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
2026-04-16 feat: tendrils grow from edge, colored by endpoints, organic curve
    Respond to design feedback:
    - Anchors sit on each entity's SILHOUETTE EDGE (center + toward-other
    vector \u00d7 ~72px radius), not on the center. Tendril looks attached
    to the mushroom's skin.
    - Path is a cubic bezier with per-pair perpendicular sway derived from
    the connection id hash \u2014 each tendril bends differently, no two are
    the same, no laser-straight lines.
    - Stroke uses an SVG linearGradient from endpoint a's character color
    to endpoint b's character color. Tendril visibly belongs to the two
    mushrooms it grows between.
    - Two small colored nodes ride the path on positive compat to sell the
    \"mycelium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
2026-04-16 fix: hybrids are sterile \u2014 no longer fuse, stopping the infinite breeding
    Root cause: a hybrid kept charId=0 (tender) for palette/gaze/physics
    reuse, which meant new connections formed between hybrid and any nearby
    entity with compat > 0.5. After 4s those would fuse into a new hybrid,
    which would then fuse again with a parent, producing exponential
    population growth.
    Fix: before applying the other fusion gates (compat / hold / cooldown),
    check whether either endpoint is a hybrid by id lookup; if so, skip.
    Hybrids still form visual tendril connections, but fusion is disabled
    for them.
    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
2026-04-16 Wire clean bases + hand-drawn hybrid PNGs into runtime
    Entity now routes hybrids to hybridAssetFor(parentA, parentB) and
    regular characters to the face-less clean base. FaceOverlay drops
    the skin-patch occlusion layer (clean bases have no baked eyes).
    App stores parentCharIds on hybrid entities so the lookup works
    after the parent entities are gone.
    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
2026-04-16 assets: swap to eye-less bases; wire per-pair hybrid PNGs; drop rainbow
    - overwrite 6 /public/assets/characters/char*_radial.png bases with the
    eye-less _clean versions; FaceOverlay now owns all eyes programmatically
    - add 15 hand-drawn pair hybrid PNGs (hybrid_A_B..hybrid_E_F)
    - delete hybrid_rainbow.png and remove HYBRID_ASSET constant
    - new hybridAsset(a, b): CharId pair -> sorted letter-pair filename
    - Entity accepts parentIds: [CharId, CharId]; LiveEntity.parentIds
    stores charIds (not entity ids) so hybrids resolve their sprite
    - fusion now records [f.a.charId, f.b.charId] at hybrid spawn time
    https://claude.ai/code/session_01JYRH1GoVCC8iwDGa9B2uzu
2026-04-16 feat(hybrid): state-machine infection, no extra entities spawned
    Hybrid generation was effectively a spawn-and-push-apart: two eligible
    mushrooms held contact 4s, both parents got a recoil impulse, and a
    third entity with a hand-drawn hybrid PNG was pushed into the scene.
    That reads as "two originals + bonus creature" instead of "two
    mushrooms influenced each other and changed."
    Replace with a per-entity state machine — the original IS the hybrid
    after it transforms:
    normal → infecting → transforming → hybrid
    Constants:
    INFECT_HOLD_MS = 2000 connection must hold before rolling
    INFECTING_MS = 1500 color / tint drift phase
    TRANSFORM_MS = 1200 sprite crossfade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
2026-04-16 tune hybrid: lower prob, slower morph, wander while morphing, multi-face
    Based on user feedback:
    1. Lower infection probability. Previously any eligible pair transformed
    deterministically at the INFECT_HOLD mark. Now there's a per-frame
    probability gate BASE_INFECTION_PROB * compat (≈ 1.5% * compat), and
    a ROLL_COOLDOWN_MS = 9s after a failed roll before retrying. Net
    effect: most bonded pairs just bond; infection is a rarer event.
    2. Slower state-machine timings so the morph reads as a process:
    INFECT_HOLD 2s → 3.5s
    INFECTING 1.5s → 3.5s
    TRANSFORM 1.2s → 2.4s
    CROSSFADE_S in Entity.tsx bumped to 2.4s to match.
    3. Entities in 'infecting' / 'transfo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
2026-04-16 fix(hybrid): correct CharId→letter mapping to match artist's labels
    The artist's letter naming for the 15 hybrid PNGs is not a simple
    0..5 → A..F sequence:
    A = char2 mushroom (橙色空心蘑菇)
    B = char3 glitter (彩色闪片圆头菌)
    C = char5 shrub (黑枝白团菌)
    D = char1 bubble (白色果冻水滴菌)
    E = char0 radial (白球星芒菌)
    F = char4 cups (薄荷双杯菌)
    With the old sequential mapping, bubble + shrub (char1 + char5) was
    producing hybrid_B_F.png — which the artist drew as glitter × cups
    (letters B and F in their scheme). User observed this as the round
    mushroom + twig pair "transforming into twin cups".
    Two fixes:
    1. HYBRID_LETTER now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
2026-04-16 face: recalibrate all configs to Jellycat close-set style from reference
    Reference art shows close-set eyes (~0.10 spread) and a tiny smile
    directly below, on each character body. Previous spread of 0.20+
    made eyes look more like "surprise" than kawaii.
    Base char updates (each sized to its sprite's actual body region):
    char0 radial → face on lower-right of sphere
    char1 bubble → face lower-center above the puddle
    char2 mushroom → face moved from cap to upper stem (below overhang)
    char3 glitter → face lower-center of ball above the stem
    char4 cups → face per cup, narrower spread
    char5 shrub → face in blob area (center of twig ring)
    HYBRID_FACE default (sin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
2026-04-17 face: widen all eye spreads (~60%) — too-narrow previous version
    Spread went from 0.10 to 0.14–0.16 on all single bodies and 0.12–0.14
    on twin bodies. Eye size slightly up to match the fuller-face look.
    All Y positions unchanged, so existing vertical placement is preserved.
    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
2026-04-17 face: move cap+stem characters' faces from stem onto cap
    char2 mushroom: eyeY 0.57 → 0.34 (stem → cap, below cap overhang)
    char3 glitter: eyeY 0.48 → 0.37 (lower ball → upper-mid ball, above stem)
    Mouths shifted in tandem (char2 0.65→0.42, char3 0.56→0.45).
    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
2026-04-17 feat: add ?gallery debug view showing all chars and hybrid pairs
    Append ?gallery to the URL to replace the live stage with a static
    grid: 6 base characters on top, then all 15 hybrid pairs in their
    final 'hybrid' state. Tiles use the real <Entity> component so face
    coords, blinks, and wobble match the live product exactly.
    A slow 2.5s gaze cycle is applied to every tile so eye tracking can
    be verified at a glance.
    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
2026-04-17 gallery: drop char-name labels on hybrids; add letter key + mismatch note
    Hybrid tiles now show ONLY the filename pair (A_B, B_E, …) and no
    Chinese "放射星 × 水泡" suffix — the hand-drawn hybrid art doesn't
    reliably match the filename letters, so adding that label would be
    wrong. Top strip shows what each letter is supposed to be per code
    mapping, plus a visible note explaining the caveat.
    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
2026-04-17 face: A_D face moved lower; B_F + D_F twin faces nudged down
    A_D: new entry in HYBRID_FACES_MAP. Single body, eyeY 0.45 → 0.55.
    B_F: both twin faces eyeY 0.42 → 0.46.
    D_F: both twin faces eyeY 0.40 → 0.44.
    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
2026-04-17 tune: bump infection probability ~17×, shorten roll cooldown
    BASE_INFECTION_PROB 0.015 → 0.25
    ROLL_COOLDOWN_MS 9000 → 6000
    Old expected wait at compat=1 was ~10 minutes per pair (way too rare).
    New expected wait ≈ 24s at compat=1, ≈ 48s at compat=0.5, on top of
    the 3.5s contact hold. Roughly: a high-compat pair that bonds will
    likely transform within half a minute of meeting.
    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
2026-04-17 face: shift char3 glitter face +0.08 to the right (further onto the ball)
    eyeLeftX 0.40 → 0.48, eyeRightX 0.56 → 0.64. Center ≈ 0.56.
    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
2026-04-17 feat: ?debug spawn bar — type letters A-F to spawn mushrooms directly
    Append ?debug to the URL to expose a small input panel top-right.
    Type a letter sequence (e.g. "ABCD" or "A B C D"), press Enter,
    and one mushroom per letter spawns at random positions. Quick
    A/B/C/D/E/F buttons spawn one of each at a click.
    Bypasses the emotion API entirely — useful for testing infection
    combinations, gallery placements, or stress-testing physics.
    handleSubmit refactored to share a `makeEntity` + `pushEntity`
    helper with the new `handleDebugSpawn`.
    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
2026-04-17 feat(pass2): organic interaction — wander, lifetime, cooldown, grow/retract
    Replaces the "once connected, stay latched forever" behavior with a
    proper small-animal loop: mushrooms drift on their own, approach,
    link briefly, unlink naturally, drift apart, and eventually meet
    again.
    Connection state machine (src/core/connections.ts):
    growing — GROW_MS (700ms) after forming. TendrilLayer animates
    pathLength 0 → 1 (tendril grows out from A to B).
    bonded — the "together" phase. Length rolled at formation:
    base 5.5s + 4.5s × compat ± 20% jitter. Ends on either
    timeout or distance > DISCONNECT_RANGE.
    retracting — RETRACT_MS (65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
2026-04-17 tendril: tapered filled ribbon with side branches and glow-tip dots
    Matches the hand-drawn community.png reference: soft, uneven, alive.
    Main line:
    - Filled bezier ribbon built by sampling the cubic bezier and
    offsetting each sample perpendicular by a per-t width. Width
    profile is a gentle spindle (max 1.0 at the mushroom ends,
    ~0.65 in the middle), so it reads as organic rather than uniform.
    - Sampled at 30 points; polygon forward + reversed back path
    produces the taper without any extra lib.
    Side branches:
    - 1–3 short branches per connection, positioned at seeded t values
    along the main line (0.28 / 0.55 / 0.78 ±jitter).
    - Count scales with compat: more compat → more branc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
2026-04-17 tendril: slime-mold-style hesitant growth (not UI path animation)
    The previous linear pathLength animation looked like a path being
    drawn, not a living tendril exploring its way toward another body.
    Changes:
    1. Slow overall. GROW_MS 700 → 2400, RETRACT_MS 650 → 1400.
    Tendrils now take ~2.4s to reach their target; plenty of time
    for the eye to read the process.
    2. Hesitation keyframes on main-line reveal. Replaces the single
    0→1 interpolation with a 12-stop keyframe profile that encodes
    the phases the user asked for:
    sprout (0 → 0.03 over 8% of GROW_S): barely advance
    stretch (0.03→ 0.42 over 42%): main extension, two tiny
    pullbacks (tip r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
2026-04-17 tendril: width as live process — thin tip, maturing body, retract fade
    The tendril width is no longer a static taper baked at render time.
    It's now a time-driven property where each point along the path has
    an age (wall-clock seconds since the growth tip first reached it),
    and width fills in from a thin 12% fiber up to the mature spindle
    shape over MATURE_S seconds.
    New per-point width model:
    width(t, elapsed) = mainSpindle(t) * growthFraction(t, elapsed) * widthMul
    mainSpindle(t) static shape (wider at anchors, thinner mid)
    growthFraction(t, e) time-dependent 0.12 → 1.0 over MATURE_S once
    the tip has reached this t
    widthMul per-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
2026-04-17 tendril: slime-mold bundle — 1 primary + 2 probes, selection + decay
    Rewrites the positive-compat connection rendering so each pair is a
    BUNDLE of filaments rather than a single bezier. Reads as multiple
    exploratory fibers with one becoming reinforced, not a line being drawn.
    Bundle (buildFilaments):
    1 primary: the "chosen" path — most direct, low sway, grows to full
    mature width, carries branches + eventual tip dots.
    2 probes: alternate sides, larger sway, staggered sprout delays
    (0.18s / 0.46s after bornAt), ceiling widths 22% / 12% of the
    primary. They grow to their target alongside the primary then
    fade out during bonded — the "unselected" paths.
    Probe decay (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
2026-04-17 tendril: spawn-avoid, forward-end dot, slow probes, V2a explorers
    Four changes per user feedback on the slime-mold rewrite.
    1. spawnAt avoids existing entities AND connection paths
    Previously, new mushrooms could be born inside another mushroom or
    on top of an active tendril. spawnAt now consults entitiesRef and
    connectionMapRef; candidate positions must clear
    - MIN_ENTITY_DIST = 170 px from any existing mushroom center
    - MIN_CONN_DIST = 70 px from any point along any connection line
    - the existing center / tree-hole input exclusion
    Up to 40 attempts, then fallback as before.
    2. Branch-tip dots → single forward-end glow
    Per "避免末端小光点, 改在前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
2026-04-17 tendril: drop synapse dot, V2b spatial avoidance around third mushrooms
    Per "突触不要小光点了": removed the single forward-end glow at the
    primary filament's p3 (where it meets the target mushroom). No dots
    anywhere on the connection now — clean tapered ribbons only.
    V2b spatial avoidance (routeBezier):
    - Helper bezierClear(bez, blockers) samples 15 points along the curve
    (skipping endpoints) and returns false if any sample falls within
    any blocker's radius.
    - Helper routeBezier(a, b, px, py, sway1, sway2, sign, signLate,
    blockers) builds a bezier from the caller's preferred sway, falls
    back to flipped side, then 1.7× / 2.6× / 3.8× sway multipliers
    until the path cle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
2026-04-17 V2c: physics-driven filament tips — trails replace pre-computed beziers
    Connection tendrils no longer follow a bezier revealed by a mask.
    Each filament now has a LIVE GROWTH TIP that advances frame-by-frame.
    Its path is what it actually traced through space, not a predetermined
    curve. Reads as a hypha probing forward, adjusting, and landing.
    New module src/core/filaments.ts:
    - FilamentState: id, role, origin/target entity ids, current tip
    position & velocity, trail (timestamped (x,y) points), reached flag.
    - initFilament(): sprouts the tip from the origin's silhouette edge
    heading roughly toward the target with a perpendicular bias (so
    probes actually fan out).
    - stepFilament() phys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
2026-04-17 tendril: body constrained by connections; softer physics; smooth ribbon
    Per user feedback: tendrils were still reading as stiff, bodies were
    moving as if independent, and V2a probes felt like aimless searching.
    Big new behavior: BODIES ARE CONSTRAINED BY THEIR OWN TENDRILS.
    Spring constraint on bonded connections (core/field.ts + connections.ts):
    On growing→bonded transition, the connection captures its current
    body-to-body distance as `restLength`. stepField adds an inward
    spring force of strength SPRING_K on both bodies whenever their
    separation exceeds that rest length. Effect: a bonded pair can't
    just drift apart — each body pulls the other back. Multiple
    bonded neighbo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
2026-04-17 tendril: put tendril layer BELOW entity sprites (z-index 5 → 2)
    Tendrils were rendering on top of mushroom sprites, so any tendril
    segment that crossed a third mushroom visibly cut through the body.
    Flipping the z-index so the mushroom sprites occlude the tendrils —
    a tendril that happens to pass behind a body simply disappears
    behind it rather than drawing over it. Physics-side obstacle
    avoidance is still in effect; this is the visual safety net.
    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
2026-04-17 tendril: no sudden appear/disappear; no sharp kinks
    Targets two classes of abruptness the user called out: sudden
    appear/disappear ("突然消失") and sharp turns/kinks ("很明显的转折").
    Retract is now tip→origin (the user's ask: "慢慢的从尖端退会末端"):
    - filaments.ts: stop trimming the trail array during retract. The
    trail stays intact for the entire RETRACT_S.
    - TendrilLayer.tsx: width fades via a RETRACT WAVE. The fade front
    sits at `retractElapsed/RETRACT_S` in distance-from-tip space and
    sweeps back toward the origin with a smooth RETRACT_BAND = 0.22
    of the trail width as its leading edge. Reads as the tendril
    being slowly pulled back into the origin body,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
2026-04-17 tendril: SVG goo filter — crossing tendrils visually fuse on the same plane
    All positive-compat tendrils are now coplanar in a single SVG group
    that has a goo (metaball) filter applied:
    filter id="tendril-fusion":
    feGaussianBlur stdDeviation=2.4 → soft halo around each ribbon
    feColorMatrix alpha 11 -4 → threshold the halo into a clean
    fused shape where ribbons overlap
    feComposite atop SourceGraphic → keep the original color on the
    visible parts (so tapered widths
    and color gradients still show)
    Where two tendril ribbons cross, their alpha-blurred ha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
2026-04-17 tendril: exaggerate width range, slow pace, add bonded-phase berries
    Width range is more dramatic (per user: "粗细可以再夸张一点"):
    - INITIAL_WIDTH_FRAC 0.12 → 0.06: tip is a VERY thin filament
    - max width multiplier 1.9 → 2.6: mature body is noticeably chunkier
    - BREATHE_AMP 0.07 → 0.08: slightly more pulse while bonded
    Net: a tendril at maturity is ~20× thicker at the origin than at the
    growth tip. The taper reads as a clear thin→thick progression, not
    a nearly-uniform line.
    Slower overall pace (per user: "整体速度慢一些"):
    - GROW_MS 2400 → 3500: growth phase takes 3.5s instead of 2.4s
    - RETRACT_MS 1400 → 2200: retract wave sweeps back in 2.2s
    - MATURE_S 2.2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
2026-04-17 tendril: body moves in sync with tendril — sharing + retract pull
    Two changes so mushrooms no longer leave tendrils behind in empty
    space when they drift (user: "不要出现菌离开了 触手还在原地").
    1. Trail anchored to BOTH endpoint bodies (core/filaments.ts):
    FilamentState gains lastOriginX/Y/lastTargetX/Y. Each step, the
    whole trail gets translated by a t-weighted sum of the two
    endpoints' deltas:
    point.x += originDx * (1 - t) + targetDx * t
    point.y += originDy * (1 - t) + targetDy * t
    Where t is the point's position along the trail (0 at origin,
    1 at tip). Tip position also translates by targetDx/Dy so the
    tip's "anchor" stays glued to the target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
2026-04-17 tendril: thicker thick, thinner thin, chunkier intersections
    Width range widened further per user: "粗得更粗 细的更细":
    - INITIAL_WIDTH_FRAC 0.06 → 0.03. Fresh tip is now 3% of mature
    width — a hair-thin filament at the growing edge.
    - Max width multiplier 2.6 → 3.4 in the RAF spawn. A compat-1
    connection's mature body is noticeably chunky.
    Intersection "交汇的地方更粗" — goo filter retuned:
    - stdDeviation 2.4 → 4. Blob halo around each ribbon is larger,
    so overlapping halos at a crossing produce a more obviously
    extended fused shape.
    - Threshold matrix 11 -4 → 14 -5. Cleaner blob edges.
    - Composite atop → over. Goo is rendered BEHIND the source
    ribbon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
2026-04-17 field: tether constraint — bodies can't move away from active tendrils
    Per user: "菌子要跟着触手的方向走，不要反方向移动".
    Before this: spring force tugged a bonded pair back if stretched, but
    other forces (wander, inter-mushroom attraction, repel) could still
    push a body in the "away" direction — the body would oscillate or
    momentarily drift before the spring corrected it. Visually the body
    sometimes left the tendril in the lurch.
    Now: each active tendril contributes a unit direction-to-partner
    vector. After the regular force integration (and DAMPING), every
    body's velocity is projected against each of its tether directions:
    for each tether dir n on body:
    dot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
2026-04-20 field: stop clumping — shorter attraction range, longer post-disconnect cooldown
    Per user: "菌子找完别的菌是自由的，可以在原地，也可以走开"; before
    this, any compat-positive pair within 500px was continuously attracted
    regardless of whether they'd already connected, so more than a few
    mushrooms produced a runaway clump.
    Three changes:
    1. Narrower and weaker compat attraction (src/core/field.ts):
    ATTRACT_K 0.10 → 0.035
    ATTRACT_MAX 500 → 280
    So the base force only kicks in once mushrooms have drifted within
    contact range — beyond that they're governed by wander alone.
    2. Cooldown map threaded into stepField and checked in the attraction
    inner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
2026-04-20 ambient: English UI, 2s TreeHole fade-in, sparkles, synth audio, polish
    End-to-end UX pass on track D.
    English throughout the app:
    - TreeHoleInput: "今天，心里像是⋯⋯" → "today, my heart feels like…";
    eyebrow "Mycelium · 树洞" → "Mycelium · Tree Hole"; hint →
    "Enter to whisper · Shift+Enter for a new line"; loading →
    "the mycelium is listening".
    - Error toast: "菌丝未能成形" / "再呼出一次" → "the mycelium couldn't
    take shape" / "try again".
    - DebugSpawnBar "召唤" → "spawn".
    - Gallery all headings + the mismatch note → English.
    - Character.name fields: Chinese flavor names replaced with English
    short names (radial/bubble/mushroom/glitter/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
2026-04-20 mother-tree: emergent support mechanic — ageing mushrooms reach for the lonely
    Per user brief (track C): a quiet, non-hierarchical support system.
    Long-lived mushrooms become "mother trees"; when another mushroom
    has been isolated for a while, the nearest mother tree extends a
    warmer, more stable tendril toward it. No UI hint, no help text,
    no matchmaking vocabulary — just a tendril that grows in.
    Emergent, not spawned:
    - An entity is considered a mother tree once it has been on stage
    for MOTHER_AGE_MS (40s). Entities never start as mother trees.
    - Checked per-frame via renderNow - bornAt; the Entity render
    component flips in the warm halo when the threshold is crossed.
    - No separat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
2026-04-20 background: soft paper-grain stage (warm cream, mottled, breathing)
    Redesigning the stage surface per the paper-stage brief:
    - warm cream, very low contrast, no strong light direction
    - fine film/paper grain, evenly distributed
    - soft cloud-like mottling (no pattern repeat, no hard edges)
    - faint warm wash biased peach, breathing across the whole page
    Five layers (back → front):
    1. .stage-bg near-flat cream radial (#F6EDDC → #EDDEC4).
    Much narrower range than before — the base no longer reads as
    a lit sphere, it reads as uniform paper.
    2. .stage-warm-wash new layer. <feTurbulence baseFrequency 0.002,
    blurred 10px, tinted peach (1.0, 0.84, 0.72), alpha 0.08>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
2026-04-20 build: fix Vercel deploy step — drop no-op rewrite, modernise edge config
    Vercel logs showed the build itself passing (tsc + vite build in ~2s),
    then failing 12s into "Deploying outputs…" with the generic
    "An unexpected error occurred" — i.e. the failure is in Vercel's
    output-packaging / routing-validation stage, not our compile.
    Two changes, both targeting that stage:
    1. Drop the identity rewrite from vercel.json. `/api/(.*)` → `/api/$1`
    was a no-op: Vercel auto-routes /api/* to the api/ directory before
    falling back to SPA, so this line buys nothing. Recent Vercel deploy
    validation is stricter about identity rewrites.
    2. Switch api/emotion.ts from the legacy `export con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
2026-04-20 ui: kawaii pass — cute fonts, lighter cream, crayon polka dots
    Overall direction: lift the page into "barely-tinted paper" territory
    and swap the elegant-serif voice for a rounded, hand-drawn one.
    Palette lifted a full step lighter:
    - cream #F4EDE0 → #FCF7EA
    - cream-deep #EBE1CF → #F6EFDC
    - ink #2F2A22 → #4A4034 (softer charcoal, not harsh)
    - accent #D27B4E → #E69B6E (gentler peach)
    - base radial #F6EDDC→#EDDEC4 → #FDF9ED→#F4EBD1
    Type system:
    - Display: Caveat — crayon-y handwritten script for the eyebrow,
    placeholder, hint, loading line, error heading, button.
    - Body: Quicksand — rounded geometric sans, weight 500 default.
    - CJK f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
2026-04-20 mother-tree: debug-mode timer shortcuts + stronger halo
    Two-part fix for "母树效果在 debug 里看不出来":
    1. Debug-mode timing.
    The mechanic needs an entity to age into a mother (MOTHER_AGE_MS)
    AND another entity to stay isolated (ISOLATION_MS). At 40s + 18s
    those windows are tuned for the calm live experience but make the
    effect invisible during hands-on testing. When ?debug is present
    we collapse them:
    MOTHER_AGE_MS 40_000 → 6_000
    ISOLATION_MS 18_000 → 4_000
    Support-connection life and reach unchanged.
    2. Halo visibility against the lighter paper.
    After the cream palette lift the single warm-peach radial wash
    almost disappeared against #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
2026-04-20 emotion: 30s timeout + console diagnostics
    "输入文字之后卡住了" was traceable only by reading the error toast
    detail, and hard to trace at all if the upstream fetch itself hung
    (no timeout → UI sat forever on "the mycelium is listening").
    - readEmotion now wraps fetch in an AbortController with a 30s cap.
    Timeouts surface as EmotionApiError('timeout') so the existing
    error toast kicks in.
    - Every failure path (abort, network, non-2xx, bad JSON, schema
    mismatch) now also console.errors with the relevant detail, so
    devtools shows what's actually wrong without waiting on the toast
    to be readable.
2026-04-20 loading: progressive reassurance text (6s / 14s / 24s)
    Replace the static "the mycelium is listening ···" with a four-step
    message that escalates as the wait grows, so a stalled backend is
    visible long before the 30s fetch timeout fires.
    0-5s the mycelium is listening
    6-13s still listening, slow wind today
    14-23s taking longer than usual…
    24s+ mycelium is very slow today, hang on
    Cross-fades between messages via AnimatePresence so the transition
    reads as the same voice slowing down, not three separate states.
2026-04-20 api: switch /api/emotion to Node runtime, raise timeout to 60s
    The prior Edge runtime hit FUNCTION_INVOCATION_TIMEOUT (http 504)
    on slow upstream days. Edge functions on Hobby are capped at 25s
    with no maxDuration knob; Node serverless supports up to 60s.
    - export const runtime = 'nodejs' + maxDuration = 60
    - Wrap upstream fetch in AbortController with a 45s cap (inside
    maxDuration headroom), so a stalled Anthropic call returns a
    clean 504 upstream-timeout JSON instead of being killed by
    Vercel and surfacing as a generic FUNCTION_INVOCATION_TIMEOUT.
    - max_tokens 320 → 180. The output schema is small (two labels +
    an 18-char rationale); 180 tokens is comfortably enough and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
2026-04-20 emotion: back to Edge + GET health-check + entry logging
    Node serverless routing didn't land cleanly from a plain Vite api/
    file (client hung past 60s with no surfaced 504), so we're reverting
    to Edge and instead tightening the upstream cap to fit inside Edge's
    25s hard limit. Upstream gets 18s — generous headroom for Haiku on
    normal days, and we return a structured 504 JSON well before Vercel
    kills us with FUNCTION_INVOCATION_TIMEOUT.
    New: GET /api/emotion returns a JSON health probe:
    {
    status: "alive", runtime: "edge", model: "...",
    hasApiKey: bool, apiKeyLen: number, apiKeyPrefix: "sk-ant-"...,
    now: ISO
    }
    Lets the user open the endpoint directly in a browser to confirm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
2026-04-20 api: add /api/ping diagnostic + emotion.ts → config.runtime form
    Even GET /api/emotion is 504'ing with FUNCTION_INVOCATION_TIMEOUT,
    meaning the Edge runtime isn't starting at all on the new project.
    Two defences:
    1. api/ping.ts — 10-line Edge function that just returns {pong:1}.
    If /api/ping also 504s, the issue is Vercel project config
    (runtime not applied, deployment protection, etc.), not
    anything inside emotion.ts.
    2. emotion.ts runtime declaration switched from the newer
    `export const runtime = 'edge'` to the older
    `export const config = { runtime: 'edge' }` form. Both are
    documented but the config-object form has been supported
    longer across @vercel/edge vers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
2026-04-20 mother-tree: make the halo unmistakable (3 layers)
    The two-layer glow was still too shy — user couldn't spot a mother
    tree at a glance even in ?debug with the 6s age trigger. Rebuilt as
    three stacked layers that together read as "warm presence radiating
    outward", still organic, still not a badge:
    1. Expanding breath ring — 2.5px solid peach ring, scales 0.75 →
    1.65 with opacity 0→0.55→0 on a 4.8s loop. This is the big
    visibility win: a visible pulse leaving the mushroom.
    2. Peach multiply wash — was rgba(230,170,110,0.55) blur 4 inset
    -22%; now rgba(224,150,100,0.78) blur 5 inset -28%. More
    saturated and bigger, so the paper around mother trees
    actua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
2026-04-20 butterflies: sparse ambient decoration crossing the stage
    One butterfly at a time, arriving every 30-60s (first at 5-15s
    after page load), crossing in an S-curve over 12-18s, then
    despawning. Kept solo so the scene never feels busy.
    Four wing palettes (peach / lavender / butter / mint), each with
    an upper + lower wing + spot. Body is a thin vertical ellipse at
    the SVG centre so a fast scaleX [1, 0.35, 1] flap compresses the
    wings around the body without shrinking the whole sprite.
    Path is four waypoints via framer-motion keyframes:
    x: off-screen start → 32/66% → off-screen end
    y: start → wave → mid → end, all biased to the top-middle band
    rotate: gentle tilt matching travel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
2026-04-20 audio: replace the drone hum with a healing pentatonic melody
    The old ambient bed was two detuned sines at 110 Hz + 165 Hz — an
    open fifth that read more like a power-supply hum than music.
    Rebuilt as two layers that are actually pleasant to sit inside:
    1. Pad — two sines at C2 + G2 with slow ±5-cent LFOs, each around
    gain 0.07. Felt rather than heard; keeps the scene from going
    silent between notes.
    2. Melody — sparse C-major pentatonic (C4 D4 E4 G4 A4 C5 D5 E5),
    one note every 3–6 s. Each note is a sine with a 0.8 s slow
    attack and a 5–7 s exponential tail through a soft lowpass,
    plus a triangle an octave up at 0.06 gain for music-box
    shimmer.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
2026-04-20 entity: random whimsical name label per mushroom
    New core/names.ts pairs 20 soft adjectives (Velvet, Sleepy, Honey,
    Misty, Moony…) with 20 small-creature nouns (Mochi, Biscuit, Puff,
    Dewdrop, Whisper…) — ~400 combinations, all readable and kawaii.
    Wired:
    - App.tsx: randomName() stamped onto LiveEntity at makeEntity time
    and forwarded to <Entity>.
    - Entity.tsx: new optional `name` prop. Rendered in Caveat script
    below the sprite as a sibling of the float/wobble/breathe chain,
    so the text stays still and legible while the mushroom dances.
    Fades in at delay 1.6s with a 1.4s ease-out so the label appears
    after the spawn-grow settles. Subtle cream text-shadow gives it
    separatio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
2026-04-20 entity: name label — smaller, fainter, tucked closer to the sprite
    Per user feedback: previous label was loud (1.1rem at 0.72 opacity
    sitting 4px below the sprite bounding box, which puts it well clear
    of the mushroom shadow).
    fontSize: 1.1rem → 0.85rem
    opacity: 0.72 → 0.42
    y offset: +4px below bottom edge → -14px (tucked up into the
    sprite's negative-space foot) so the label reads as
    belonging to this mushroom, not floating under it.
2026-04-20 entity: pointer drag — grab a mushroom and throw it
    New interaction: point-and-drag any creature. Works with mouse and
    touch (pointer events). While held the entity's physics step is
    overridden with cursor position and an instantaneous pixels/ms
    velocity so release gives the creature momentum — a good flick
    carries it across the stage before damping takes over.
    App.tsx
    - grabbedId state + matching refs (grabbedIdRef, grabbedPosRef,
    grabbedPrevRef). Refs avoid re-renders on every mousemove.
    - Window-level pointermove/up/cancel listeners attached only
    while something is grabbed; detached on release.
    - In the RAF step, after stepField, the grabbed entity's x/y are
    snapped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
2026-04-20 hand-tracking: MediaPipe gestures — point / pinch / open-palm
    New dependency: @mediapipe/tasks-vision (~135 KB bundled + lazy WASM
    and model from CDN on first enable, so cold start of the page is
    unaffected).
    Architecture
    core/handTracking.ts — HandTracker owns the video stream, the
    landmarker instance, and the per-frame detect loop. Emits
    HandSnapshot[] to subscribers. Landmarks are converted from
    MediaPipe's normalised 0..1 to screen px AND X-mirrored so the
    coordinate space matches the mirrored preview.
    hooks/useHandTracking.ts — React lifecycle + enable/disable +
    a snapshotRef the physics loop reads without re-rendering.
    components/HandLayer.tsx — toggl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
2026-04-20 hand-gestures: make pointing + open-palm actually feel responsive
    Two complaints: A (point → attract) and C (open palm → sweep) felt
    sluggish. Two-part fix — relaxed recognition, bigger forces.
    Recognition (core/handTracking.ts)
    isPointing: was "index extended AND middle/ring/pinky all curled";
    the ring + pinky check caused the gesture to silently fail when
    those fingers stayed half-extended (which is how most people
    naturally point). Now only requires index extended + middle
    curled.
    isOpen: was "all four fingers extended"; relaxed to "at least 3 of
    4 extended". Spread threshold eased from 1.4 × palm to 1.25 ×.
    So a casual wave still counts, a closed fist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
2026-04-20 emotion: extend schema with topic + morphology (step 1)
    Step 1 of the vision-alignment plan: make the data path carry the
    visual parameters. No rendering change yet — just the pipe.
    api/emotion.ts
    System prompt now asks the LLM to also return:
    topic — academic | relationship | self | joy | other
    morphology — density, agitation, tendrilCount, glow, tintHue,
    particles (per-creature visual controls)
    Each field has an explicit mapping rule so the model picks
    extreme values when the sentence warrants (heavy → density 1;
    lonely → translucent + still; warm → glow high; anxious →
    agitation high + many tendrils; etc).
    max_tokens 180 → 3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
2026-04-20 entity: morphology-driven visuals (step 2)
    Step 2: creatures now LOOK different based on the LLM's morphology
    output. Same charId, different emotion → visibly different sprite.
    Six morphology fields map to concrete visual knobs:
    density → body opacity 0.55 + 0.45d (lonely/wispy creatures
    read as barely-there) + base scale 0.92 + 0.12d
    (heavy emotions look fuller)
    agitation → wobble duration 8s − 4.5a (calm slow, panicked
    fast), wobble amplitude 1.2° + 3.2a, breathe
    duration 3.5s − 1.2a, breathe amplitude bumped
    glow → new radial bloom layer BEHIND the sprite, coloured
    by tintHue,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
2026-04-20 hybrid: make fusion a rare surprise (step 3)
    Per the vision: "similar emotions attract but DON'T fuse — they
    drift parallel, tendrils occasionally touch." Current thresholds
    were tuned for "any compat ≥ 0.5, 3.5s of contact, 25% roll" which
    produced a hybrid every handful of pairs. That's the opposite of
    what we want.
    INFECT_HOLD_MS 3_500 → 30_000 (30 s sustained touch)
    INFECTION_MIN_COMPAT 0.5 → 0.9 (only highly compatible)
    BASE_INFECTION_PROB 0.25 → 0.04 (even then, rarely fires)
    Combined: a hybrid now requires (a) a pair tuned to compat ≥ 0.9,
    (b) touching continuously for half a minute, (c) winning a ~4%/frame
    roll once eligible. Most pairs will b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
2026-04-20 time-mood: hour-of-day palette + exam-week override (step 4)
    Per the vision: 2am should feel sparse and cool; 4pm warm and
    busy; exam week cold and high-frequency. First pass wires the
    whole chain — palette shift on the background, vibration gain
    on entity wobble/breathe.
    New module: src/core/timeMood.ts
    readTimeMood() → {
    hour, bucket, paletteShift, vibrationGain,
    spawnDensityHint, isExamWeek
    Buckets: late-night(<5) / morning(<12) / afternoon(<18) / evening.
    URL overrides:
    ?hour=2 force any hour for demo/screenshot work
    ?mood=exam force exam-week (shifts paletteShift −0.55 +
    multiplies vibrationGain × 1.55 on top of the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
2026-04-20 heatmap: connection-density warmth glows under the paper (step 5)
    Per the vision: "more connections → that region brightens / warms."
    New HeatmapLayer drops one translucent amber radial blob at the
    midpoint of each active connection, multiply-blended under the
    polka dots / grain / vignette. Where several tendrils cluster in
    one area their blobs stack and that patch of paper visibly warms.
    Implementation
    - SVG full-screen layer, one <circle> per active connection,
    filled with a shared radialGradient (E8B98E, 0.30 → 0 at 150 px).
    - Retracting connections excluded so fading pairs don't leave a
    warm ghost behind.
    - Support connections (mother-tree reach) glow at 1.0 warmth;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
2026-04-20 stage: collective breath (step 6)
    Per the vision: the whole network should have a shared heartbeat —
    "每隔几秒整体轻微膨胀收缩". Added a 7 s ease-in-out scale cycle
    (0.988 → 1.012 → 0.988) on a new .stage-breath wrapper that
    encloses:
    Background / HeatmapLayer / TendrilLayer / entities /
    SparkleLayer / Butterflies
    UI elements (HandLayer, debug bar, mute button, TreeHoleInput,
    error toast) are intentionally rendered OUTSIDE the wrapper —
    type rendering and pointer hit-testing stay stable.
    Implementation is a pure CSS @keyframes so it costs nothing on
    the JS side. Each entity still has its own breathing scale; those
    compose with the stage scale (multiplicative), so cr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
2026-04-20 field: isolated creatures drift toward the cluster (step 7)
    Per the vision: "孤立的微生物会缓慢向群落漂移 — 没有任何一个永远
    独自存在". Added a soft centroid drift in stepField so a creature
    that hasn't had an active connection for 8 s starts yearning
    toward the centre of mass of the currently-social creatures.
    Algorithm
    Once per step, sum the positions of every body whose
    (now − lastSocialAt) < 8_000 ms. Centroid is their mean. Bodies
    whose own gap ≥ 8 s get a 0.05-strength force toward that
    centroid, skipped when the body is mid-infection/transform.
    Details
    - PhysBody gained optional lastSocialAt + bornAt fields; App
    already stamps lastSocial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
2026-04-20 tendrils: companion strokes for high-tendrilCount creatures (step 8)
    Final plan step: morphology.tendrilCount now actually drives how
    branchy a creature's bonds look. A complex-sentence anxious entity
    (tendrilCount 9) will sprout 3-4 parallel filaments on every bond
    it forms; a short quiet one (tendrilCount 3) stays a single line.
    Plumbing
    field.ts PhysBody gained optional tendrilCount.
    App.tsx LiveEntity carries it flat (mirrored from morphology
    at makeEntity time), so stepConnections — which only
    knows PhysBody — can read it without coupling.
    connections.ts Connection gains optional tendrilCount. Computed
    on creation as max(a, b) mapp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
2026-04-20 bg: keep warm cream base, layer cool hours as a wash (fix green tint)
    Previous implementation color-mixed warm cream with blue-grey in
    oklch space — oklch interpolates along the hue wheel and passes
    through green between yellow and blue, which showed up as a
    noticeably green cast at any intermediate --palette-shift.
    Fixed by splitting responsibilities:
    .stage-bg stable warm cream radial, no
    palette mixing at all. The amber
    base is what the user wants as
    the default.
    .stage-bg::before single blue-grey radial overlay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
2026-04-20 physics: fix cluster "wrestle" lock-up (soft tether + bond cap)
    Multiple mushrooms clustered together would freeze into a jittery
    deadlock instead of drifting gently. Root cause was the tether
    constraint in stepField stacking hard half-plane projections: with
    N adjacent bonds each forbidding velocity AWAY from its partner,
    the intersection of the constraints collapsed to a wedge near
    zero. Combined with spring forces pulling from every direction,
    bodies ended up twitching in place — the "wrestle" visual.
    Three-part fix:
    1. Soften the tether (src/core/field.ts)
    New TETHER_SOFT = 0.35. The projection
    vx -= tnx * dot
    becomes
    vx -= tnx * dot * TETHER_SOFT
    so each tether bl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
2026-04-21 mood-color: move mood from sprite/glow tint to floating bubbles
    The morphology hue was being expressed in two loud places:
    - a coloured glow halo behind every mushroom (rainbow blobs all
    over the stage)
    - a hue wash directly on the sprite (recoloured the artwork
    itself, dampening the hand-drawn detail)
    Both removed. Mood colour now lives only in small drifting bubbles
    emitted from each creature.
    Entity.tsx
    Glow halo: kept the layer but switched the colour from
    hsla(tintHue, …) to a fixed warm amber rgba(232,188,138,…).
    Every mushroom now gets the same gentle warm bloom — only its
    STRENGTH varies with morphology.glow. The "lit-from-within" feel
    stays; the rainbow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
2026-04-23 hybrid: tune from "rare" to "rare but visible"
    The earlier "变罕" pass (30s hold, 0.9 compat, 4%/frame) went too
    far — most users never saw a hybrid fire. Keeps the vision intent
    that fusion isn't the main relationship mode, but moves the dial
    so observant viewers actually catch the event:
    INFECT_HOLD_MS 30_000 → 12_000 (12 s sustained contact)
    INFECTION_MIN_COMPAT 0.9 → 0.7 (mid-high pairs eligible)
    BASE_INFECTION_PROB 0.04 → 0.15 (~15% roll once past hold)
    A compat-0.9 pair still holds parallel for ~12s before even rolling,
    so the drift-then-touch choreography stays visible. Once over the
    threshold, fusion fires within a few seconds for pairs that h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
2026-04-23 face: switch gaze tracking to useSpring — fix pupil drift on some machines
    A user's friend reported "the mushroom eyes drift away" on their
    machine, invisible on the reporter's own computer. Traced to the
    imperative animate() pattern in FaceOverlay:
    useEffect(() => {
    animate(gxMv, gazeX, { type: 'spring', ... });
    animate(gyMv, gazeY, { type: 'spring', ... });
    }, [gazeX, gazeY, ...]);
    gazeX / gazeY change every render (recomputed from the nearest-
    neighbour gaze target as the entity drifts around), so the effect
    fired on almost every frame. Each fire started a new spring
    animation WITHOUT cancelling the previous one. On slower machines
    or certain browser engines the stacked sp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
2026-04-23 hybrid: stop "all hybrids look the same" — wider pool + one-sided
    User report: "融合着融合着都一样了". Two compounding causes:
    1. INFECTION_MIN_COMPAT was 0.7 — only 4 cross-kind pairs in the
    compat matrix clear that bar:
    (0,1) tender+calm → hybrid_D_E.png
    (0,4) tender+companion → hybrid_E_F.png
    (2,3) curious+dreamy → hybrid_A_B.png
    (1,4) calm+companion → hybrid_D_F.png
    So the visible hybrid pool was effectively 4 PNGs.
    2. MUTUAL_COMPAT_CUTOFF = 0.85 meant any 0.85+ pair (e.g. tender+
    companion at 0.9) auto-flipped BOTH sides to hybrid. Each such
    event spawned TWO identical hybrid PNGs in the same scene.
    Fix:
    INFECTION_MIN_COMPAT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
2026-04-23 speech: tap-to-talk voice input on the tree hole
    New interaction layer: a mic button next to the textarea lets
    users speak their confession instead of typing. Goes through the
    same read() → morphology → creature flow as text input; the
    Speech-to-Text step is browser-native so there's no extra API
    cost or round trip.
    Files
    src/hooks/useSpeechRecognition.ts — SpeechRecognition wrapper
    src/components/TreeHoleInput.tsx — mic button + caption + icon
    src/ui/styles.css — row/button/caption styles
    Hook behaviour
    - Checks for window.SpeechRecognition | webkitSpeechRecognition.
    Firefox doesn't ship it → `supported = false` and the UI just
    hides the mi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
2026-04-29 hybrid: speed up first transformation to ~20s
    INFECT_HOLD_MS 12s → 3s (less waiting before rolls start)
    BASE_INFECTION_PROB 0.15 → 0.4 (per-roll hit, scaled by compat)
    ROLL_COOLDOWN_MS 6s → 2s (re-roll faster on misses)
    Math: at compat 0.7 (typical mid-tier pair), per-roll hit is 28%,
    rolling every 2s after a 3s hold. Inside a 20s window from first
    contact: ~9 rolls, P(at least one fires) ≈ 94%. With multiple pairs
    forming in parallel on a fresh page load, first hybrid arriving
    within 20s is now overwhelmingly likely.
2026-07-04 design-export: procedural pixel-spore generator + specimen PNGs + design PDF
    Standalone deterministic generator (xmur3 + LCG seed → mushroom
    silhouette mask → 6 emotion palette families → per-cell vertical
    gradient → density-driven blur → two-cell sliding-pupil eyes). This
    is the blueprint for the upcoming src/core/mosaic.ts.
    Includes headless-Chromium export pipeline (transparent PNGs +
    design-spec PDF) and 79 rendered specimens matching the approved
    visual preview.
2026-07-04 feat: replace PNG mushrooms with procedural pixel-spore generator
    Creatures are now deterministic pixel mosaics grown from the emotion
    reading instead of hand-drawn PNGs. Same sentence → same spore.
    - core/mosaic.ts: pure buildMosaic(id, charId, morphology, intensity,
    secondary) → silhouette mask (3 prototypes) + 6 emotion palette
    families + per-cell vertical gradient + density-driven blur +
    two-cell sliding-pupil eyes. Seeded via seed.ts xmur3/Rng, zero
    Math.random on the render path.
    - components/PixelSprite.tsx: one <canvas> per creature; supports the
    per-cell dye wavefront (infection→hybrid), soft-light tint pulse
    (infecting), gaze pupil slide, and blink.
    - Entity.tsx: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
2026-07-04 chore: remove dead PNG assets + face system after pixel-spore switch
    Nothing references these any more now that creatures render from
    core/mosaic.ts:
    - public/assets/characters/*.png (6 base + 15 hybrid)
    - assets/raw/ source art + assets/community.png
    - scripts/process_assets.py (the PNG pipeline)
    - src/components/FaceOverlay.tsx
    - characters.ts: drop FaceConfig, slug/face/secondaryFace, charAsset,
    hybridAsset, hybridFaces, HYBRID_FACE/LETTER/FACES_MAP — keep the
    cluster data (name/color/emotions), emotionToCharId, compatibility.
    dist no longer ships any PNGs.
2026-07-04 fix(eyes): pupil dwells in one cell, quick flick, looks at neighbors
    The pupil used to sit continuously and mostly landed straddling the two
    eye cells. Now:
    - gaze is a DISCRETE side (-1 left cell / +1 right cell); the black
    pupil rests fully inside one cell (clean one-white-one-black).
    - side is chosen by the nearest other spore's direction with a deadzone
    (hysteresis) so it commits and holds instead of jittering; a lone
    spore glances to a random side occasionally so it still feels alive.
    - when the side flips, PixelSprite slides the pupil across in ~150ms on
    its own rAF tween — so it animates even in the Gallery. Eases out,
    then rests in-cell.
    - blink lid line now spans both e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
2026-07-05 feat(worlds): visual engine for the Beautiful Worlds ecology
    Foundation for the datamosh "living colony" redesign (no wiring yet):
    - core/scanRecord.ts: deterministic specimen id / coordinates / time
    fabricated from a creature's id + bornAt (survey-record labels).
    - core/fieldRender.ts: canvas draw routines — ordered-dither colour
    masses + blue spires + particle spray backdrop, and a datamosh
    pixel-spore (downward pixel-sort streaks + glitch row + flecks).
    - components/DitherField.tsx: full-bleed canvas that paints the backdrop
    + every accumulated creature, spec-cached, redraw on list/resize.
    Ported from the approved direction mockup; all deterministic via seed.ts.
2026-07-05 feat(worlds): Beautiful Worlds landing + dithered ecology in the app
    Wires the new visual system into the live app:
    - off-white "gallery" theme tokens + Space Mono editorial type
    (styles.css / index.html), replacing the warm cream palette.
    - DitherField mounted as the page's visual material (backdrop + the
    accumulated colony); demoColony.ts is a deterministic placeholder
    colony until the Upstash cross-user history lands.
    - LandingPoster: the "Beautiful World(s)" entry page over the ecology,
    with the live population count and ENTER THE WORLD.
    - App scene state (landing → field); stage UI (input / hand / mute)
    only shows in the field. ?debug enters the field directly.
    Verified in-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
2026-07-05 feat(worlds): cross-user accumulating colony (Upstash)
    - api/creatures.ts (Edge): GET returns the recent colony + lifetime
    population; POST appends a creature (LPUSH + LTRIM cap 500) and
    increments the population counter. Degrades to empty when the Upstash
    env vars are absent so the app still runs.
    - hooks/useCreatures.ts: loads everyone's accumulated creatures on mount
    (demo colony fallback), exposes population + add().
    - App: colony/population now come from the shared store; each whispered
    creature is committed to the colony so it persists and greets future
    visitors as part of the ecology.
    Needs UPSTASH_REDIS_REST_URL / _TOKEN env vars in Vercel to go live.
2026-07-06 chore: browser title → MYCELIUM
2026-07-06 feat: ?test sandbox mode — local-only, zero backend writes
    Append ?test to run the full experience (landing → field → whisper →
    grow → accumulate) entirely in-browser: useCreatures skips the GET/POST
    to /api/creatures, so test creatures never touch Upstash (no backend
    memory, no quota, no polluting the real colony). A "TEST MODE · NOT
    SAVED" badge marks the sandbox.
2026-07-06 feat(worlds): nav + Archive + Feedback rooms; field made interactive
    Adds the rest of the experience's rooms and fixes the "nothing to click"
    feeling after ENTER:
    - SceneNav: top bar (MYCELIUM · FIELD / ARCHIVE / FEEDBACK · population)
    moves between scenes.
    - ArchiveScene: a scrolling specimen catalogue of the whole accumulated
    colony — each creature as a survey record (id / name / coordinates /
    emotion) via CreatureThumb + scanRecord + deterministic nameFor().
    - FeedbackScene: the specimen card for the creature you just grew
    (reading + rationale + record); prompts to the field when empty.
    - Field scene now shows the nav, an immediate tree-hole input (new
    `immediate` prop skips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
2026-07-06 feat(worlds): background colony comes alive (original field physics)
    The accumulated colony is no longer static — each creature now runs the
    original stepField logic every frame (wander drift, compatibility
    attraction / repulsion, soft walls, isolation drift, damping) and its
    pupils gaze toward the nearest neighbour. The expensive dithered backdrop
    is pre-rendered to an offscreen canvas and blitted; only creatures redraw
    per frame. Capped at ANIMATE_CAP (140) live creatures for smoothness;
    any overflow is baked into the static backdrop.
2026-07-06 feat(worlds): free autonomous colony — bonds, calls, mother trees
    Reworks the background colony into a living society of free agents:
    - demoColony residents now carry a stable name, emotion, coordinates and
    a birth time (existing archive records; some old enough to mother).
    - each creature wanders its own uncertain path (no global cohesion), and
    when a compatible neighbour is near it forms a TEMPORARY bond, then
    cools off and leaves — choose to meet or move on.
    - bonds render as coloured "call" lines (blend of the pair's emotion
    colours); mother-tree support lines are warm amber.
    - mother trees: creatures on stage long enough reach a support line to
    any creature that's been alo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
2026-07-06 feat(worlds): specimen introduction card after whispering
    After a sentence is whispered and a creature grows, the app now opens a
    specimen-introduction screen (auto-navigates to feedback): a large render
    of the new creature, a frosted-glass card on the left with the sentence
    the visitor whispered, and a card on the right with the creature's name +
    survey data (emotion / intensity / coordinates / logged time). "Release
    into the field" sends it into the colony. Clean editorial glass-card
    layout per the reference. FieldCreature now carries the input text;
    ?debug seeds a sample so the card can be previewed without the API.
2026-07-06 feat(worlds): consistent creature scale, ≤10 residents, clean-tech UI
    - whispered creatures now live only in the colony (same scale as the
    residents); the oversized legacy stage sprite no longer renders.
    - initial background colony trimmed to 9 named residents.
    - typography switched to JetBrains Mono throughout — crisp technical feel.
    - tree-hole input restyled to a clean bordered console (hairline border,
    corner registration ticks, mono label) per the reference, and centred
    via a flex wrapper so framer-motion's transform no longer offsets it.
2026-07-06 feat(worlds): named creatures, one-shot input, specimen recall (#59)
    - draw each creature's name as a mono label on the canvas so residents
    and newborns read as named library residents
    - hide the tree-hole input once the visitor has whispered; they stay to
    watch their creature interact with the colony
    - add a small bottom-right "your specimen" control to re-open the card
    - clicking anywhere on the specimen card releases the creature into the field
    Claude-Session: https://claude.ai/code/session_01F351BE8WNbsDJxZJegnrAN
2026-07-07 feat(worlds): huddle→spread transition, drag, birth fx, slower dye (#60)
    - landing: the colony huddles in the centre; entering the field spreads
    it as the input box shoves a clear hole through the middle
    - restore mouse control — drag a creature on the canvas and fling it
    - highlight the visitor's own creature: a birth burst ring on arrival, a
    persistent pulsing dashed ring, and an accent "· you" name tag
    - colour exchange is now slow (6s ramp) and partial (≤45%), so every
    creature permanently keeps the palette it was born with
    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
2026-07-07 fix(worlds): looser landing gathering — soft central well (#61)
    Replace the constant pull-to-centre with a soft well: creatures wander
    freely inside a comfortable central radius and only get a gentle nudge
    back once they stray past it. The colony gathers loosely in the middle
    instead of clumping into one suspiciously tight knot.
    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
2026-07-07 feat(worlds): contact-point dye, timed self-highlight, matter exchange (#62)
    - dye wavefront now originates at the contact side (cells facing the
    partner change first) and sweeps across to the far side
    - the visitor's own-creature highlight (ring + accent name) auto-hides
    after 5 minutes, then it blends into the colony
    - bonded partners ferry little mosaic tiles to each other — the two
    directions bow to opposite sides so it reads as a circulation of
    matter, each tile carrying a colour sampled from the sender
    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
2026-07-07 style(worlds): halve backdrop opacity off the cover page (#64)
    The ambient dither backdrop stays at full strength on the landing/cover
    scene and drops to half everywhere else, so it reads as a faint ground
    behind the field, archive, and specimen views.
    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
2026-07-07 feat(landing): rename hero to "The Whisper Network" (#65)
    Replace the generic "Beautiful World(s)" cover title with one that names
    the project's soul and ties back to the MYCELIUM brand — mycelium is the
    "wood-wide web", an underground network of whispers become creatures.
    Hero: "The Whisper / Network" · subtitle: "an underground web of feeling".
    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
2026-07-07 style(landing): hero title in Chakra Petch (chamfered techno face) (#66)
    Give the homepage title "The Whisper Network" a wide, chamfered-corner
    techno display face (the crypto/web3 look from the reference). Scoped to
    the hero only via a new --font-hero token; the rest of the site keeps
    JetBrains Mono. Chakra Petch is loaded alongside JetBrains Mono in one
    Google Fonts request.
    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
2026-07-07 feat(share): claim & share your spore — permalink + image card (#68)
    The specimen card gains "copy link" and "save image". Because generation
    is deterministic, the link encodes the creature's reading in a URL token
    (?s=), so opening it reproduces the exact same spore on any device with no
    backend lookup — the reproducible/claimable promise from the spec. "save
    image" composes a clean specimen PNG (spore + name + whispered sentence +
    survey data) via the shared canvas renderer. Opening a shared link shows
    the card read-only and never re-persists it.
    New: src/core/share.ts (encode/decode + shareUrl), src/core/shareCard.ts
    (PNG composer). Wired into FeedbackScene + App (?s= deep-link).
    C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
2026-07-07 feat(worlds): permanent hybridisation from long encounters (#69)
    Per the visual-identity spec's evolution intent, a long sustained bond
    (>7s) now has a chance to leave a small PERMANENT residual of the
    partner's palette on each creature, from the contact side, outline
    unchanged — "changed by a relationship" rather than fused. Rare and
    subtle (~17% coverage). Rendered via the existing dye path: when no
    transient dye is active, the creature falls back to its permanent tint.
    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
2026-07-07 feat(ux): silky scene transitions — spring easing + staggered reveals (#71)
    Add a shared motion system (ui/motion.ts): a soft easeOutExpo curve,
    overlay crossfade+scale, and staggered content reveals. The landing
    poster now reveals its blocks in sequence and dissolves (fade+scale+blur)
    into the field on enter; archive/feedback overlays cross-fade with a
    whisper of scale; archive cards rise in on a capped stagger.
    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
2026-07-07 feat(ux): micro-interactions — count-up, magnetic enter, parallax, focus lift (#72)
    - population count ticks up smoothly (from the previous value, so a live
    +1 animates rather than restarting) via a CountUp component
    - the ENTER button leans toward the cursor and springs back (useMagnetic)
    - the whole colony gently parallaxes toward the cursor on the landing
    page (eased off in the field so drag hit-testing stays pixel-accurate)
    - the whisper input lifts with an accent ring on focus
    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
2026-07-07 feat(feedback): end-of-experience user survey (#73)
    Add a short bilingual questionnaire reached from the nav "FEEDBACK":
    a 1–5 feeling scale, two choice questions (ownership, what drew you in),
    an open field, and an optional email — with a calm thank-you state.
    Responses persist to Upstash via a new /api/feedback edge endpoint
    (mirrors api/creatures.ts: capped list + lifetime counter); ?test mode
    stays local and never persists. The specimen card stays reachable via the
    whisper flow and the bottom-right "your specimen" recall.
    New: api/feedback.ts, src/components/SurveyScene.tsx. Scene type gains
    'survey'; nav FEEDBACK now opens it.
    Claude-Session: https://claude.ai/code/session_01F351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
2026-07-10 feat(worlds): make the mother tree visible — bigger, swaying, no halo (#74)
    The mother-tree care mechanic was invisible in the datamosh colony. Now,
    while a creature is actively supporting an isolated one, it renders ~1.4×
    larger with a gentle sway and an occasional flicker — a living "elder"
    presence rather than a glowing halo — and nourishes the isolated creature
    with a slow, one-directional stream of matter tiles (in its own palette).
    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
2026-07-10 feat(worlds): make "dyeing = connection" legible — seam + paired reading (#75)
    Two line-free signals so a bonded pair reads as connected:
    - contact-seam emphasis: the cells nearest the touch point take on the
    partner's signature colour, boldest at the seam and fading inward, so
    the dye reads directionally as a mutual exchange (fieldRender DyeState
    gains a `seam` colour, sampled from the partner's most-saturated cell).
    - readable coupling: bonded pairs keep a small gap (BOND_REST 96→116),
    gaze at each other, and breathe in sync (shared phase per pair), so they
    read as "a couple" rather than two creatures that happen to overlap.
    Claude-Session: https://claude.ai/code/session_01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
2026-07-15 Deploy portfolio pages (/research, /case, /portfolio, /board) + installation data bridge
    Serves the research essay, case study (EN+ZH), portfolio, and design board as self-contained static pages via public/ with cleanUrls; all cross-links are in-site relative paths. Also adds api/pulse + api/bio (installation data bridge, degrade gracefully) and a gated /api/bio poll in DitherField (no visual change without installation data).
2026-07-15 Bilingual portfolio pages (EN/中 toggle) + ZH versions
    Adds a Chinese version of every portfolio page and a fixed EN/中 language
    toggle in the corner of each, linking to its same-topic counterpart:
    /research ↔ /research-zh /case ↔ /case-zh
    /portfolio ↔ /portfolio-zh /board ↔ /board-zh
    New: research-zh, portfolio-zh, board-zh (case already had a ZH version).
    Cross-links resolve within the current language (EN pages → EN pages,
    ZH pages → ZH pages). English copy on the research page was reworked to read
    naturally rather than machine-generated; other pages keep their positioning.
    Static pages only (public/); no app source changes.
    Claude-Session: https://claude.ai/code/s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
2026-07-15 De-AI the English copy on case, portfolio, and board
    Rewrites the prose on the three remaining English pages to read like a person
    wrote it rather than machine-generated marketing/academic filler — cutting
    triadic parallelism, "not X — it's Y" scaffolding, em-dash overuse, and empty
    grand words, and varying sentence length. Positioning, facts, structure, and
    the honesty notes (evaluation "makes no claims it has not gathered", sources as
    "grounding not measured claims", the metaphor "never offered as scientific
    proof") are all preserved; no new facts or numbers were added. Terse spec
    tables and labels are left as-is. Research page was already done; Chinese
    versions unchanged.
    Static publ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
2026-07-15 Mobile app + portfolio overhaul: real-engine visuals, research data, hub
    - Mobile-responsive main app (landing, scene nav, touch, safe areas)
    - Research page: sourced data viz (age chart, impact wall, real world map, news collage)
    - Corrected map figures (Comoros 45% / Vietnam 6%) + US/Europe/China context
    - Portfolio consolidated into a hub with deep-page index
    - All portfolio + case creatures rendered by the product's real engine
    - Mechanic loops (dye/matter/hybrid/mother) as real GIFs
    - Mobile feature-callout showcase; gallery recoloured to the identity palette
    - Bilingual throughout (EN/中)
2026-07-15 Add a desktop presentation to the portfolio's deployed-experience section
    Section 03 showed only the phone. It now leads with a browser-framed
    desktop capture of the live field (labelled 'on a desktop'), then the
    existing phone showcase ('on a phone'), so both form factors are shown.
    Mirrored in ZH.
    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
2026-07-15 State the mycorrhizal inspiration explicitly in the portfolio
    Adds a 'Why Mycelium' section: the project borrows from mycorrhizal
    networks — the underground fungal web (the 'wood-wide web') where trees
    trade nutrients and mother trees keep seedlings alive — and maps that
    biology to the app's mechanics (shared field, connection-as-colour,
    built-in care, no performance). Mirrored in ZH.
    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
2026-07-15 Make the design board use the product's real engine
    The board still rendered its creatures with the in-page drawSpore
    reimplementation. Now the hero row, six families, anatomy diagram, and all
    six mechanic mini-diagrams (dye, matter, free bonds, mother-tree, hybrid,
    blink & gaze) use real-engine assets — reusing the shared spore/mechanic
    renders and adding two new loops (free-bond drift, blink & gaze).
    Removed the dead drawSpore/mountSpore/icon JS; updated the 'generated
    live' claim. Mirrored in ZH.
    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
2026-07-15 Visualize the 'Why Mycelium' section as an annotated network diagram
    Replaces the text-only mapping with an original inline SVG cross-section of
    a mycorrhizal network: the real spore creatures stand above a 'surface'
    line, a procedurally-generated branching mycelial web spreads below, a
    central mother node reaches accent-coloured filaments to distant nodes, and
    a gradient thread links two creatures ('connection as colour'). Four
    leader-line annotations map the biology to the mechanics, in the editorial
    style of the reference. Theme-aware (reads as glowing filaments in dark),
    and a text legend takes over on phones where the in-SVG labels get small.
    Mirrored in ZH.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
2026-07-16 Rebuild 'Why Mycelium' as a cited, real-mycorrhizal-science diagram
    The previous version wrongly put the app's own spore creatures over an
    invented web. Replaced with an original illustration of the *real*
    mycorrhizal system that cites published research — no app creatures:
    - Real tree silhouettes (a large old hub/mother tree, mature trees, a
    seedling) over a soil-surface line; below, their roots interlinked by a
    fungal mycelial network; a carbon-flow accent runs hub to seedling.
    - Four annotations, each cited to a paper: common mycorrhizal network
    (Simard et al., Nature 1997), hub/mother trees (Beiler et al., New
    Phytologist 2010), belowground carbon trade (Klein et al., Science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
2026-07-16 Portfolio: desktop showcase, cited mycorrhizal-science diagram, board real-engine visuals
    - Desktop browser mockup in the deployed-experience section
    - "Why Mycelium": mycorrhizal-inspiration statement, then a cited real-science diagram (Simard 1997 / Klein 2016 / Beiler 2010 / Smith & Read 2008) with real trees + fungal network
    - Extended to the feeling of community (forest to community contrast panel, loneliness thesis)
    - Design board visuals rendered by the product's real engine (+ free-bond and blink/gaze loops)
    - Bilingual, theme-aware, responsive; original SVG / real-engine assets only
2026-07-22 Portfolio: creature-evolution section (v1 illustrated species → generative engine) + artifact downloads
    Recover the first-generation hand-illustrated species and hybrids from the
    update-mushroom-assets branch into public/legacy, tell the v1→v2 story as a
    new portfolio section 05 (EN + ZH, sections renumbered), and archive the
    7-sheet research poster and installation manuscript PDFs in the record hub.
    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
2026-07-31 Add tower kiosk mode: ?kiosk=field|archive|sky|micro
    Four chromeless routes for the Hyphal Column installation's screens:
    - field/archive reuse existing scenes, nav and tree-hole hidden
    - sky: all remembered creatures as a slow-drifting constellation
    - micro: the newest resident enlarged with its specimen readout
    - kiosk panels poll /api/creatures every 20s so whispers born on
    visitors' phones surface on every screen
    - fix: DitherField no longer crashes/clumps when mounted at 0 size
2026-07-31 Kiosk night theme: the tower's screens run dark
    The physical installation inverts the ground: kiosk mode flips the
    CSS token palette to near-black, canvas name labels switch to light
    ink, and sky stars get a saturation/brightness lift (the palette was
    tuned for paper). Web and phone keep the paper-cream identity —
    paper by hand, night on the tower.
2026-07-31 Night theme polish: tree hole and archive cards sink into the dark
    The tree hole stays on the tower's field screen as a dimmed invitation
    (dark glass, faint border) instead of a bright paper card; archive
    cards switch from paper-white wash to dark glass.
2026-08-02 kiosk field: QR invitation card — visitors whisper from their phones
2026-08-02 kiosk QR: dissolve into the field — 0.30-0.50 alpha, weak void, stray-mote fringe
2026-08-03 field: colony beats at the visitor's live BPM — synchronized phase, visible amplitude
2026-08-04 Mobile: add a tap path to whisper; site + poster URLs → yueyao.design
    The tree hole could only be submitted with a physical Enter key, so phones
    (QR walk-ups, IME keyboards where Enter is newline/candidate-confirm) had
    no way in. Add an always-present send button that blooms when there's text,
    enterKeyHint='send' so mobile keyboards label the key, an isComposing guard
    so CJK candidate-confirm never fires a submit, and hide the desktop kbd
    hint on touch. Displayed URLs on the portfolio pages and the poster sheets
    now read yueyao.design.
    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
2026-08-07 sky: visible wandering drift + per-star twinkle — the sky breathes now
2026-08-07 spore3d: whisper → printable volumetric voxel spore (STL + colored PLY)
    Revolve the mosaic engine's per-row silhouette into a voxel solid of
    revolution, reapply the palette bands / edge darkening / band-jump dither
    with a seeded rng, paint the two-cell eyes on the front surface with pupils
    recessed one voxel so a single-colour print keeps its face. Same sentence,
    same body — on screen and on the shelf.
    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
2026-08-07 spore3d: bring back the openwork — eroded shell, dissolving bottom fringe
    Solid revolve read as a toy, not a spore. Reapply the engine's probabilistic
    fill on the outer shell (density-driven), let the bottom fringe dissolve into
    hanging strands while the core stays solid for standing/printing, and restore
    the eye columns to a pristine surface before painting so the face survives
    the erosion. --solid flag keeps the robust variant.
    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
2026-08-07 spore3d: LEGO-brick read — one cell one brick, studs on every exposed top
    One engine cell now maps to one chunky brick (7mm default) and every
    exposed top face grows a round 12-gon stud, so the revolve's stepped
    silhouette outlines itself in stud rings — the assembled-toy look. The
    openwork erosion and bottom brick-strands stay; pupils remain recessed
    bricks so the face survives single-colour printing.
    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
2026-08-07 spore3d: chunk cells into big bricks — ~100-brick builds, tile pupils
    2x2x2 engine cells merge into one brick (--chunk), so a spore reads as a
    countable ~100-brick build instead of voxel gravel. Erosion moves to brick
    granularity (a few missing bricks, a hanging one at the fringe), and pupils
    become raised black square tiles on white eye bricks — cleaner than the
    recess at this scale, and sturdier to print.
    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
2026-08-07 spore3d: extrude mode (exact 2D sprite as blocks) + robot shell architecture
    Default mode now extrudes the engine's actual mosaic cells 1-3 blocks deep
    (solid core deepest, translucent dither cells thinnest) so the piece keeps
    the on-screen likeness; --style lego adds studs, --hollow carves a module
    bay. --robot builds the hardware-first desk-robot shell: 20mm pixel module,
    thin relief face (10mm plate + 0/8/16mm stepped tiles), a unified equipment
    bay behind the torso (clear 100x80x60mm) and a ballast/speaker base
    (100x80x70mm), keeping the head thin per the cavity-driven sizing.
    Claude-Session: https://claude.ai/code/session_01F351BE8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
2026-08-07 spore3d robot mode: all-brick clad body per Pixel Companion layout
    Variable-depth extrusion (fringe thin, 60mm core), no external boxes: the
    electronics volume lives inside the creature itself. Apertures are missing
    bricks — mic at the mouth, down-firing speaker vents in the bottom face,
    a 3x3 back-of-head door for the magnetic maintenance lid — and --dock emits
    the separate charging tray. Walls come from the slicer (0% infill).
    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
2026-08-07 firmware M0: dual-OLED procedural eyes for the desk companion
    Two SSD1306 eyes on one I2C bus running the site's face rules — the shared
    7s breath, saccades, blinks with occasional doubles, ToF presence (look-at,
    happy squint, sleepy when alone) and serial mood keys as the stub where
    /api/emotion readings will land. Bench target WROOM-32; same code moves to
    XIAO ESP32-S3 with only the pin table.
    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
2026-08-09 hardware: MC-01 cartridge skeleton generator (printable STL via CSG)
    Builds the v1.3 drawing as watertight meshes: 60x80x25 frame with A/B/C
    card-slot ribs, dual screen windows, ToF/mic/USB apertures, back card door,
    D-bay service opening, speaker grille, pogo holes and blind magnet pockets,
    plus the friction-fit back lid. Apertures verified by ray probes and
    cross-sections.
    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
2026-08-10 spore3d: --flushback aligns cells to the back plane for support-free printing
    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
2026-08-10 companion sleeve: any spore hides the whole core cartridge
    --companion mode force-fills and widens the core footprint (6 cells from
    the eye anchor down to the base, full depth) so nothing shows through, and
    hardware/companion_sleeve.py carves the exact-mm core cavity (62.6 wide,
    bottom-insert, 4mm crown), dual 0.96" eye windows and mic hole from a
    manifold rebuild of the brick shell. Verified watertight + ray probes.
    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
2026-08-10 companion sleeve v2: clamshell halves with stepped relief, eye-aligned cavity
    Non-core bricks step front/back (0/12/24mm) so the body reads volumetric;
    the shell splits at the cavity mid-plane into two support-free halves with
    alignment pegs, and the cavity is anchored to the EYE LINE (cartridge base
    = eye line - 46mm) so the shell windows and the OLEDs are coplanar.
    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
2026-08-10 hardware: stud-coupling brick library, 12mm pitch, FDM crush-rib clutch
    LEGO-architecture bricks scaled to the 12mm module: O6x2.4 studs, interior
    tubes for 2x2+, side crush-ribs (0.15 interference) for 1xN so the first
    insertion self-tunes the fit to the printer. TUNE parameter for +-0.1
    adjustment via reprinting only the coupons.
    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
2026-08-10 brick_lib: flat-faced magnetic mosaic voxel (12mm)
    Pure 1x1 mosaic assembly can't use rigid stud coupling (no running bond,
    inside corners jam on multi-axis insertion), so the mosaic cube goes
    magnet + steel: O4x2 magnets on +x/+y/+z, O5x0.5 steel discs on the
    opposite faces — polarity-free by construction — with diagonal nub/dimple
    pairs locking shear. Pocket depths verified by ray probes.
    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
2026-08-10 hardware: per-sentence mosaic kit sheet generator
    Turns a --companion voxel dump into the build drawing: front mosaic cover,
    bottom-up layer plans with colour numbers, the 6x7x3 core void marked, and
    the parts bill (cubes per quantized colour, magnets, steel discs).
    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
2026-08-10 kit sheet: third-angle orthographic three-view page with mm dimensions
    Front/top/right-side projections of the assembled kit voxels, overall
    dimensions, the core void dashed in the side view, CJK-safe monospace.
    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
2026-08-10 mosaic kit v1.6: all six faces are swappable cubes, screens through window cubes
    No plates anywhere: eyes and ToF are hollow WINDOW cubes (standard 12mm
    body, side-face coupling), the mic is a drilled cube, back vents likewise —
    every functional cube swaps freely with plain colour cubes. The core void
    returns to depth-centre (one-cube walls on every side), and the layer plans
    mark W/M/V cells. Cartridge mod: A-panel OLED risers bring the glass to
    1-2mm behind the window-cube front plane.
    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
2026-08-10 cartridge v1.5: rebated flush lid, riser rail, shell-lock pockets
    Lid drops into a 2mm rebate (0.4/side) and sits flush — inside the mosaic
    shell the back cube wall holds it captive, no snap needed. Fixed screen
    windows give way to a wire slot plus two 4.5mm-pitch M2 rail rows so the
    OLED risers slide to any creature's eye spacing, and shallow steel-disc
    pockets on the exterior let the surrounding cubes' magnets lock the
    cartridge into the build.
    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
2026-08-10 cartridge v1.5.1: print-clean geometry — drop exterior lock pockets, teardrop magnet pockets
    The side/top steel-disc pockets printed as unsupported horizontal bores
    (spaghetti); the shell's cube closure already captures the cartridge, so
    they go. Dock-magnet pockets gain 45-degree teardrop caps so their
    ceilings self-support face-down. Remaining >45deg overhang area: ~32mm2.
    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
2026-08-10 cartridge v1.5.2 print-clean + soldering construction sheet
    Overhang hunt driven by face audits (1054 -> 168mm2 of >45deg downward
    area): 45-degree diamond spines under the card-slot ribs (carriers get
    3x3 corner clips), cavity ceiling aligned flush with the door opening,
    D-bay service opening runs to the rebate so the back-wall bridge strips
    vanish. Solder sheet: A/B perfboard layouts (2.54 grid), bus rails,
    JST harness table, assembly order; TP4056 relocated to the D bay where
    its USB-C meets the frame window.
    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
2026-08-10 cartridge v1.5.3: full-width riser rail (12 holes/row) + wider wire slot
    Real specimens put eye centres up to ~36mm apart and off-centre; the
    36mm rail couldn't reach. Rail rows now span x5..54.5 and the wire slot
    widens to 44mm so both riser towers lock at any creature's eye cells.
    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
2026-08-10 brick_lib: 3x3 eye module — the riser, mosaicized
    A 36x36x12 function module that swallows a whole 0.96" SSD1306: glass
    1.2mm behind a grooved 9-tile mosaic face with a 22x11 window over the
    eye pair (win_col parameter per creature), PCB slide-in rails, pigtail
    notch, standard magnet/steel coupling on all perimeter cell faces.
    Replaces both the riser towers and the acrylic-cube variants.
    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
2026-08-10 screen cradle: eye support moved inside the cavity — the wall stays pure cubes
    Bolts to the front rail, presses both OLEDs against the window cubes'
    backs from inside. Parametric per-creature seat positions; the 3x3 eye
    module is retired — every exterior piece is a single-cell cube again.
    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
2026-08-10 brick_lib: eye patch kit — the 3x3 eye module decomposed into 9 single cubes
    Each piece is a standard 12mm cube with full coupling; only the backs
    differ, each carrying its cell's share of a shared 28x28x3.6 screen
    pocket. Assembled like any wall patch, the nine backs nest a 0.96" OLED
    flush behind the two window cells; bottom-centre piece has the pigtail
    channel. Retires the one-piece eye module and the cavity cradle.
    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
2026-08-10 eye patch v2: 8mm-deep shared pocket — glass 4mm behind the surface
    Internal seam couplings and nubs move into the 4mm front band (centre
    y=10) so magnets still bond piece-to-piece; patch-external faces keep
    standard centre coupling for the surrounding wall. Front/back faces
    carry none (exterior / open).
    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
2026-08-10 brick system goes dual-magnet: 6 magnet pockets per cube, one SKU
    Steel discs retired — every face takes an O4x2 magnet (N-out on +faces,
    S-out on -faces, loaded from opposite ends of the factory stack). Window
    cube walls thicken to 2.8 to seat full pockets; eye-patch seams follow;
    kit bill now counts 6 magnets per cube.
    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
2026-08-10 window cubes: thin walls back (1.6, 8.8 window) with local magnet bosses
    Dual magnets don't need thick walls after all: each side pocket sits on a
    6x1.4 internal boss, so the light tunnel stays 8.8 with only small
    mid-edge steps. Eye-patch window cells get the same bosses on their
    front-band seam pockets. No global dimension changes anywhere.
    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
2026-08-10 bricks go fully flat: nubs and dimples removed system-wide
    Faces carry pockets only — nothing protrudes past the 12mm envelope
    (verified per piece). Shear is friction-only under magnet clamp, which
    the 2g cubes and multi-face bonding cover for a desk build.
    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
2026-08-10 shear lock finalized: 0.5mm spherical caps nesting in 0.9mm dimples
    Domes are built as sphere-intersect-outer-halfspace so no underground
    body ever bulges through neighbouring faces or the centre magnet pocket
    (offsets +-3.5 verified: 2.5mm to edges, 4.95mm to pocket). Mated faces
    close fully flush; exposed faces show only a smooth low cap.
    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
2026-08-10 fix coupling defects found by face-map audit
    Three real bugs: eye-patch domes/dimples were placed in local coords
    while pieces are modelled at patch offsets (features landed in the wrong
    cells or thin air, external faces missed the standard +-3.5 grid); dome
    caps' bases were exactly coplanar with faces and the union degenerated
    (sink 0.05 now); window cubes had never received domes/dimples (0.5mm
    standoff against neighbours). Verified by an offset-grid ray audit over
    every face of every part type: all couplings now sit at (2.5,2.5)/(9.5,9.5)
    with no phantom holes.
    Claude-Session: https://claude.ai/code/session_01F351BE8WNbsDJxZJegnrAN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
2026-08-10 shear lock final form: half-cylinder D-ridges (user spec) + weld-clean bosses
    Semicircle-profile EXTRUSIONS, not spherical caps: two perpendicular
    ridges r1.05xL5 per +face (proud 1.05), matching grooves r1.25xL5.8 on
    -faces — ~4x the contact area and 2x the engagement of the caps, flush
    when mated. Eye-patch internal seams carry a single band ridge at y=10.
    Window-cube bosses overlap walls 0.01 to kill the coplanar T-junction.
    Face-map audit: ridges/grooves aligned on every face, zero holes.
    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
2026-08-10 window cube: bosses overlap mutually — weld-clean manifold roundtrip
    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
2026-08-10 hardware: hoist mosaic coupling constants, restore original pin/dimple cubes
    Move MAG/NUB/DIM/OFF constants and face_cyl to module level so
    window_cube no longer references mosaic_cube locals (NameError fix).
    mosaic_cube is back to the confirmed baseline coupling: centre O4.3x2.1
    magnet pocket + diagonal pin/dimple pairs; eye-patch internal seams keep
    the front-band couplings with the half-pin clipped at the pocket line.
    All pieces verified watertight.
    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
2026-08-10 hardware: eye-patch v3 — half pins on the pocket line, O2x1 seam magnets
    Screen pocket stays 8mm (glass 4mm behind the mosaic surface). The 4mm
    front band cannot take the O4 magnet, so internal seams get an O2.3x1.1
    pocket for O2x1 magnets; patch-external faces keep the standard centre
    O4x2 coupling on the full-depth rim. Boundary-crossing pins become half
    cylinders cut at the diameter, flat side exactly on the pocket line
    (uniform O2.4 pin diameter). Kit sheet bill lists the extra 24 O2x1.
    All 9 pieces watertight; ray audits confirm pin apexes, pocket depths
    and the 8.0 glass plane.
    Claude-Session: https://claude.ai/code/session_01F3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
2026-08-10 hardware: exposure-aware cube generator (rule 3 — exposed faces flat)
    mosaic_cube gains a faces parameter: only listed (axis, positive) faces
    receive the magnet pocket + pin/dimple coupling; unlisted faces print
    completely flat. New kit_cubes.py reads a --companion voxel dump,
    computes each cube's neighbour mask (core void and the eye-patch 3x3
    footprint excluded), and emits one STL per distinct mask plus a
    variant bill and a position map. Since dual-magnet polarity fixes one
    global orientation, masks cannot be rotated into each other — each is
    its own SKU. Demo body: 284 cubes -> 40 variants, all watertight;
    probes confirm flat faces flat, coupled faces coupled.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
2026-08-10 hardware: regenerate MC-01 solder sheet PDF
    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
2026-08-10 hardware: move USB-C window for measured TP4057 board (21x14)
    The charger arrived as a TP4057 Type-C board, 21x14mm, smaller than the
    TP4056 the D bay was drawn for. Board now lies flat on the bay floor on
    velcro with the port centred at x42.5; the front-wall window becomes
    10x5.5 at y3.6-9.1 to absorb mounting-stack variance. Solder sheet D-bay
    panel, harness table and notes updated to TP4057. Frame and lid
    regenerated, watertight; ray probes confirm the window opening.
    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
    [cartridge_frame.stl, cartridge_lid.stl]
2026-08-10 strip: drop scroll-snap — it fought the auto-scroll river to a standstill
2026-08-10 hardware: component-level soldering guide
    Per-module prep (headers, address select, L/R strapping, gain pins),
    pin maps for the WROOM-32 bench and XIAO ESP32-S3 install, board
    population order, power-on checklist and a troubleshooting table.
    Companion to mc01_solder_sheet.pdf.
    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
2026-08-10 strip river: float position accumulator — fractional scrollLeft increments were floored to zero
2026-08-10 firmware: breadboard bring-up sketch (I2C scan + screen smoke test)
    Scans the bus every 3s and names each address found (0x3C/0x3D screens,
    0x29 ToF, 0x68 IMU, 0x5A touch) so a missing module is obvious at a
    glance. TEST_SCREEN flag draws a frame and title on screen 1 to confirm
    the panel really displays. README lists expected output and a fault
    table.
    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
    [bench-check.ino]
2026-08-10 hardware: breadboard test circuit diagram
    Two panels: stage 1 hangs the five I2C modules off shared 3V3/GND/SDA/SCL
    rails with per-module addresses called out; stage 2 adds the I2S mic and
    amp on the same power rails. Generator script kept alongside the PNG.
    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
2026-08-11 firmware: audio bench-check sketch (INMP441 + MAX98357A)
    Plays a five-note scale through the amp on boot and prints a live peak
    meter from the mic, so both halves of the I2S chain can be verified
    without any libraries. Serial keys replay the scale, beep, or toggle the
    meter. README carries the wiring table and a fault table (the L/R-to-GND
    strap being the usual reason a mic reads silent).
    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
2026-08-11 tools: one-command flash script (mac/Linux + Windows)
    Installs arduino-cli, the esp32 core and the libraries each sketch needs,
    auto-detects the board's serial port, compiles, uploads and drops
    straight into the 115200 monitor. Takes the IDE click-path out of the
    bring-up loop: bash tools/flash.sh [bench-check|bench-audio|m0-eyes].
    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
2026-08-11 firmware: put the right eye on a second I2C bus (no address rework)
    Both SSD1306 panels ship strapped to 0x3C and moving the 0402 select
    resistor is fiddly, so the right eye now runs on Wire1 (SDA=G18,
    SCL=G19) while everything else stays on Wire. Identical addresses no
    longer collide because each panel owns its bus. bench-check scans both
    buses separately and draws L/R test cards; m0-eyes gains a TWO_BUS flag
    (1 = dual bus, 0 = the old single-bus 0x3C/0x3D layout). Circuit diagram
    updated to match.
    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
    [bench-check.ino, m0-eyes.ino]
2026-08-11 firmware: sharpen the ToF presence reaction
    Ranging ran at 120ms with a 120ms poll, so half the polls saw a stale
    result and reaction lag reached a quarter second; continuous ranging is
    now 33ms polled every 20ms, and out-of-range 8190 readings are discarded
    instead of latching. Detection distance rises to 500mm (close 200mm) and
    the leave-hold drops to 700ms, both now named constants at the top for
    tuning. Crossing into presence also fires a 450ms startle: gaze snaps to
    centre at 2.5x the usual easing and the lids open 18% wider, so noticing
    someone reads as a reaction rather than a drift. Serial 'd' streams live
    distance for diagnosing aim and range.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
    [m0-eyes.ino]
2026-08-11 firmware: react when someone leaves, not just when they arrive
    Proximity set mood to HAPPY and nothing ever set it back, so the face
    kept smiling long after the person walked off and departure looked like
    no reaction at all. Presence-driven moods are now tagged and reverted to
    NEUTRAL as soon as presence ends. Leaving also gets its own beat, mirror
    of the startle: gaze drops away and the lids droop to 80% for a second.
    Sleepy onset drops from 60s to a named LONELY_MS of 20s so the idle
    state is observable, and both transitions print to serial so detection
    can be confirmed independently of the animation.
    Claude-Session: https://claude.ai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
    [m0-eyes.ino]
2026-08-11 firmware: calibrate the presence gate against the background
    A ToF aimed at a desk or wall reads under the fixed 500mm threshold
    forever, so presence latched on, the smile never cleared and departure
    was undetectable. The sensor now medians ~24 samples at boot to learn
    its background distance and, when that background sits inside the
    nominal range, moves the gate to 120mm in front of it — presence becomes
    'closer than the room', not an absolute number. Serial 'c' recalibrates
    after moving the sensor, and boot prints both the background and the
    resulting gate.
    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
    [m0-eyes.ino]
2026-08-11 firmware: wire up touch and tilt (MPR121 + MPU6050)
    Both talk over raw register access rather than pulling in Adafruit
    driver libraries, so the bring-up needs no new installs. Touch on any
    electrode squints the eyes; tilting the body slides the gaze downhill
    with gravity; a jolt widens the eyes and flashes angry; upside-down
    gets a new DIZZY face with a cross over the pupil. Every one of these
    sets the same presence flag the smile fix uses, so each state can fall
    back to neutral instead of latching. Serial 'i' dumps tilt, shake and
    the touch bitmask.
    The tilt term is added to the per-frame gaze target rather than into tx
    itself — tx persists between saccades, so accumulating there would p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
    [m0-eyes.ino]
2026-08-11 strip river: check kiosk-mode per frame, not at effect setup — class lands after mount
2026-08-11 hardware: per-unit cost breakdown
    Filament mass comes from actual mesh volumes (538g for a 284-cube body
    plus the cartridge) and magnet count from the adjacency statistics
    (535 seams, 1070 magnets under the dual-magnet scheme) rather than
    guesswork; electronics are folded down from multi-pack prices to
    per-unit. Lands at ~$93 a unit, with magnets the second-largest line
    after electronics. Notes which packs amortise across builds and which
    (magnets, MCU) do not, and lists the levers worth pulling if the number
    needs to come down.
    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
2026-08-11 hardware: production-scale cost analysis
    Costs at 10/100/1k/10k units, where the structure changes three times:
    modules give way to a custom PCB ($52 -> $18.7), magnets move to bulk
    ($26.7 -> $6.4 on 1070 pieces a unit), and the shell crosses from print
    farm to tooling around 800-1000 units. Print labour, not filament,
    dominates the shell — sorting 284 cubes costs more than the plastic.
    Records the structural conflict worth deciding early: the cube variant
    mix is generated per sentence, so no mould can serve a variant, and
    tooling requires either a universal cube with blanking caps or accepting
    coupling features on show faces. Also lists the one-time costs missing
    from a per-unit view —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
2026-08-14 hardware: magnet pocket calibration gauge
    The same 4.3mm pocket prints three different sizes depending on which
    way it faces: top pockets come out truest, bed-side pockets shrink from
    elephant foot (the user's cubes nearest the heated bed partially fuse
    and reject the magnet), and sideways pockets sag slightly oval. One
    60x16x12 coupon offers all three orientations x five diameters
    (4.3-4.7, 0.1 steps), each pocket tagged with count-the-dots indexing
    and a 45-degree entry chamfer. Print flat, test-fit a magnet per group,
    report the first size that seats fully — those three numbers become
    per-orientation compensation in brick_lib.
    Clau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
2026-08-14 hardware: print cubes show-face-down on the textured plate
    Every variant STL now rotates a flat exposed face onto the bed before
    export. Exposed faces carry no features by rule 3, so no magnet pocket
    ever sits in the elephant-foot zone next to the heated plate — the squeeze
    that was rejecting magnets — and the show face picks up the textured-PEI
    finish. Pockets land only on the top (truest orientation) and side
    walls. Preference order front/back, bottom/top, left/right; the bill
    records each variant's bed face, and the rare fully-coupled cube is
    flagged for manual reaming since it has no flat face to give.
    Claude-Session: https://cl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
2026-08-14 numbering: four-tier ID scheme, derived from the work itself
    Spore IDs (MYC-<family><base32x5>) fall out of the same xmur3 sentence
    hash the engine already grows bodies from, so web spore and physical kit
    share an identity with no registry: same sentence, same creature, same
    number, in Crockford Base32 so nothing misreads as 0/O/1/I. Unit serials
    split the romantic number (card, #001) from the traceable one (U2608-003
    inside the cartridge). Part numbers keep the existing MC01/EP9 habits
    with semver semantics, and cube variants become two hex digits from a
    fixed face-bit order (C-33 replaces 0n0p2n2p). Implemented end to end:
    generator emits sporeId into meta, kit sheets print it on the cover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
2026-08-14 web: surface the spore ID on specimen sheet and archive
    New src/core/sporeId.ts derives MYC-<family><base32x5> from the same
    xmur3 sentence hash the engine grows bodies from, so the number shown on
    the site is byte-identical to the one the print pipeline stamps on kit
    drawings (verified: 轻轻地生长 -> MYC-TRY6HP on both sides). The specimen
    sheet's topbar and survey list now carry it, and archive cards replace
    the two-digit scan serial with it. Creatures without a stored sentence
    fall back to hashing their field id.
    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
2026-08-14 tools: spore shaping bench — interactive volume tuning page
    Self-contained canvas voxel viewer with the full rule stack live behind
    sliders: ellipsoid envelope (half-thickness, exponent, fullness, egg
    centre, appendage cap), cloud pedestal, the 8x7 cartridge zone with
    nudge, optional buds, and per-creature selection from four embedded
    library residents. Drag to orbit, wheel to zoom; the export dialog emits
    the parameter JSON that maps 1:1 onto the planned spore3d implementation.
    Published as a private artifact for hands-on tuning.
    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
2026-08-14 tools: per-cube sculpting in the shaping bench
    Four canvas modes — orbit, add, delete, eyedrop — with face-accurate
    picking via Path2D hit-testing over the painter's draw list: clicking a
    face in add mode grows a cube on that face, delete removes the cube,
    eyedrop lifts its colour into the palette (creature colours + cloud
    white + ink). Edits live as an override layer above the generated base,
    so sliders keep working underneath; blue-edged cubes mark hand edits,
    undo (Z) and clear are one keypress, and the export JSON now carries the
    add/delete lists alongside the envelope parameters. Flow verified
    headless: delete -1, add +1, undo restores, export includes edits.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
2026-08-14 tools: annotate the MC-01 cartridge in the shaping bench
    The core zone now reads as a proper callout: a dashed 3D wireframe
    around the 8x7x3 wall envelope, a finer inner box for the 6x7x3 cavity,
    a leadered label with the physical dimensions, and the column/row range
    in the stats card. The first cut passed height and depth to the
    projector swapped, floating the box off the body — corrected and
    verified by screenshot. Checkbox copy updated to match.
    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
2026-08-14 tools: ground the cartridge so the charge port is reachable
    The MC-01 carries its USB-C on the D-bay front wall at the very bottom
    of the frame, so a chest-mounted zone buries the port mid-body with no
    way to plug in. A new ground toggle (default on) locks the zone's bottom
    row to the body's lowest row — the window search then only slides
    horizontally — and the annotation gains an orange USB-C marker on the
    zone's front-bottom cell. Stats now state either 'grounded, USB
    reachable' or warn the port is floating. Trade-off made visible rather
    than hidden: grounding force-fills the stem area to the 8-column wall
    span, which widens the silhouette's lower rows.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
2026-08-14 tools: annotate the true MC-01 cavity, not the cell grid
    The label read 96x84x36mm — the protected-zone bounding box — which
    misrepresents the decided cartridge numbers. The inner box now draws the
    real cavity at millimetre scale (62.6 x 82.6 x 26.6, horizontally
    centred, bottom-aligned, flush to the open back where the cartridge
    slides in) inside the 8x7x3-cell wall envelope, the label states
    MC-01 60x80x25 with the cavity dims, and a blue dashed line marks the
    eye line 46mm above the cavity floor per the v1.5 sheet.
    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
2026-08-14 tools: lock the cartridge to the body centerline
    Horizontal placement no longer roams for the fewest fill cells — the
    zone centre snaps to the silhouette bounding-box midline, the DX slider
    becomes an explicit offset from that axis (relabelled accordingly), and
    vertical placement keeps its ground lock or mid-band search. Front-view
    screenshot confirms the zone and USB marker sit symmetric under the cap;
    stats now read grounded-and-axis-aligned.
    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
2026-08-14 tools: place the eye screens on the face, retire the +46 eye line
    The 46mm eye line belonged to the v1.3 riser design where screens rode
    the cartridge; with the eyepatch architecture screens sit wherever the
    creature's drawn eyes are and the H3 ribbon bridges to the grounded
    cartridge. The bench now embeds each library creature's engine eye
    anchor, draws the 3x3 eyepatch footprint on the face's front surface
    with a ribbon path to the wire slot, and the stats verify the ribbon
    span against the 110mm harness (demo-11: 29mm, comfortably inside).
    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
2026-08-14 hardware: MC02 v0.2 — the cartridge box becomes a backplane
    Modelling the approved sketch surfaced a sizing error in it: a 6x7 zone
    leaves only a 48mm cavity once each side wall takes a column, which the
    55mm combo board cannot enter. True minimum with hand-solderable boards
    is 7x7 (cavity 60x72x21), one column narrower than v0.1.
    New mc02_gen.py builds the MC02-P plate (84x84x3, PETG ~28g): 19
    wall-cell couplings speaking the standard pin/magnet language so the
    plate clicks onto the zone's open back like a giant cube face, 8 magnet
    sites, 4 bosses at 9mm standing the 55x60 combo board over the battery
    layer, and a battery recess. Function cubes: U charge-port (10x6
    through-slot), G speak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
2026-08-14 tools: draw the MC02 internals inside the shaping bench
    With the annotation toggle on, the zone now shows the whole electronics
    story in place: the backplane as a translucent orange plate clicked onto
    the open back, dashed component boxes for the 55x60 combo board (blue),
    battery (green) and face-down speaker (violet) at their real positions
    inside the 60x72x21 cavity, and a T-channel chimney column drawn between
    the zone top and the eyepatch whenever the face sits above the cartridge,
    labelled with how many channel cubes the run needs. Cleans up a stale
    +46 eye-line block left from the earlier annotation swap.
    Claude-Session: https://c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
2026-08-14 engine: sculpt pipeline — the bench recipe becomes the build
    spore3d gains --demo (reproduce a demo-colony resident exactly) and
    --sculpt <json> which runs the shaping bench's algorithm bit-for-bit:
    same mulberry32 streams, same EDT/envelope/cloud/core/bud order, same
    hand-edit application, voxels flipped into engine depth axes. Verified
    against the user's exported recipe: bench 492 cubes, engine 492, final
    grid 492. Bench-intentional geometry made the old post-passes wrong, so
    sculpt skips the largest-component filter (it ate the cloud) and the
    eye-block recolor (eyes belong to the eyepatch now); stale edit keys log
    a warning instead of silently diverging.
    kit_cubes learns the sculpt dum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
2026-08-14 hardware: print-plate packer — one colour per plate, show face down
    kit_cubes now emits kit_manifest.json (per-cube position, variant code,
    face mask, quantized colour index, function tag) alongside the bill.
    New plate_gen.py packs that manifest into sliceable build plates: cubes
    group by filament colour, each cube reuses the variant geometry oriented
    flat-show-face-down (textured-PEI finish on the visible face, no magnet
    pocket in the elephant-foot zone), laid on a 16mm-pitch 13x13 grid that
    fits any 235+ bed. Any fully-coupled cube with no flat face would land
    on a flagged ream plate; moony_v2 has none after hollowing. Output:
    per-plate STLs, a manifest with per-plate variant tallies, an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
2026-08-14 hardware: KIT_COLORS env collapses the palette to real filament count
    Eight quantized shades meant eight spool changes; KIT_COLORS=4 merges
    near hues into filament groups (Moony: green 81 / blue 109 / purple 60 /
    pink-white 44 — each still one plate), default stays 8.
    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
2026-08-15 plate_gen: one plate per colour zone, variant clusters with gap slots
    Single-colour (white test) prints made cubes indistinguishable once off
    the bed. Plates now stay split by colour zone even when printed in one
    filament, cubes sort by variant code with a blank slot between clusters,
    and the manifest gains a per-plate row-by-row code map. Preview adds
    grid coordinates and alternating shading per variant cluster.
    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
2026-08-15 magnet_polarity: per-variant N/S insertion cards in plate orientation
    Global rule: every magnet's N pole points creature right/up/front, so
    +faces are N-out and -faces S-out. Cubes are rotated on the print plate
    (flat show-face down), so the sheet replays orient_flat_down per variant
    and draws an unfolded-cross card marking each open pocket N (red) or
    S (blue) as the cube sits on the bed. Includes the reference-magnet
    calibration procedure; eye-patch seams and MC02 backplane follow the
    same rule.
    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
2026-08-16 plate_gen: per-plate polarity sheets, N/S marked on every pocket in place
    Each plate now also renders <plate>_polarity.png: the bed layout with the
    up-pocket pole as a centre circle and side-pocket poles as edge marks
    (red N / blue S outward), so magnets can be inserted straight off the
    plate without cross-referencing variant cards.
    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
2026-08-16 magnet polarity: flip global convention to match physical reference
    New rule: every magnet's N pole points creature left/down/back, i.e.
    -faces N-out, +faces S-out. A global N<->S swap is physically
    equivalent; flipped so the sheets agree with the reference magnet the
    user actually calibrated against. All cards and per-plate sheets
    regenerate with swapped labels; mating attraction is unchanged.
    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
2026-08-16 cube ID system: face engraving + layer-by-layer assembly sheet
    Loose cubes were indistinguishable once off the plate. Every coupled
    face now carries a 0.4mm engraving in the two free corners of the
    pin/dimple diagonal: the pole letter (N/S out, from the shared POLE
    convention) and the 2-hex variant code. Hidden after assembly, clear of
    magnet pocket and pin features, watertight-checked. ENGRAVE=0 disables.
    variant_mesh() is the single geometry source for kit_cubes and
    plate_gen; magnet_polarity now imports POLE instead of duplicating it.
    assembly_sheet.py renders the where-does-it-go map: one grid per layer,
    bottom-up, variant code per cell on the region colour.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
2026-08-16 tray_gen: 1:1 storage tray for magnetized cubes
    Loose magnetized cubes clump and chip, and a plain box loses the plate
    ordering every sheet is keyed to. The tray mirrors a plate's slot
    layout exactly (shared layout_slots() extracted from plate_gen): one
    13mm well per cube at the same row/column, variant code debossed in
    each floor, cluster gaps left solid. Cubes transfer straight across
    with orientation preserved, so polarity and assembly sheets stay valid.
    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
2026-08-16 pick_sheet: assembly map with an assigned plate slot per cell
    Fixes a bijection from assembly cells to plate/tray slots so each cell
    names the exact 行-列 to take its cube from; repair-plate slots
    substitute for the originals they replace (labelled 补). Page number
    only prefixes multi-page plates.
    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
2026-08-16 seq_plates: assembly-ordered plates; assembly sheet gains global sequence
    The plate becomes the pick list: cubes are placed in global assembly
    order (layer bottom-up, back-to-front, left-to-right) with a blank slot
    at each layer boundary, so peeling in reading order is assembling.
    Orientation is untouched — orient_flat_down still puts a flat exposed
    face on the bed. Per-plate sheet shows sequence (bold), polarity per
    pocket and variant code. assembly_sheet numbers every cell with the
    same global sequence; zones absent from the seq plates keep their
    numbers and are sourced from the tray.
    Claude-Session: https://claude.ai/code/session_0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
2026-08-16 tray_gen seq mode: big floor digits + ruler rim; share seq layout
    seq_slots() extracted from seq_plates so plates and trays derive from
    one layout. Sequence trays deboss ~5mm digits in each well floor and
    widen the left rim into a ruler labelled with each row's first sequence
    number, answering the too-small-engraving complaint. Zone mode (variant
    code floors) retained.
    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
2026-08-16 engraving: enlarge to 3mm pole letter / 2.3mm code, deepen to 0.55
    The 0.4mm-deep 2mm marks were illegible on white PLA. Larger and
    deeper stays clear of the magnet pocket (0.5mm min) and face edges.
    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
2026-08-17 MC02-AB combo-board sheet + soldering guide updated to v0.2
    Single 55x60 combo board replaces the MC01 A/B pair: placement panel
    (XIAO S3 socketed, MAX98357A, MPU6050, MPR121, JST edge row J1-J5),
    cavity plan (battery recess behind board, TP4057 port-down over the
    U-cube slot, speaker face-down on the grille cube), side stack with
    2.4mm headroom, and harness table H1-H7. Both OLEDs stay 0x3C on two
    I2C buses (D4/D5 + D0/D7) matching the bench firmware — no address
    resistor work.
    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
2026-08-17 MC02: fit combo board to the user's 18x24-hole perfboard (46x61)
    Boss pitch moves to 40x55 (M2 holes 3mm in from board corners), the
    battery recess narrows to 32x42 with the 603040 standing upright
    between the bosses, and the sheet's placement reflows: JST/headers
    split to bottom edge + corners, MPR121 left, MPU/MAX right column,
    XIAO socketed top-centre. Audits pass; plate still ~28g PETG.
    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
2026-08-17 SOLDERING: connector positions match 46x61 reflow
    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
2026-08-17 step-by-step soldering tutorial + safe power path
    SOLDER_STEPS.md: 8 stages with per-step acceptance checks, from tool
    prep through bench audio verification, bus soldering, module landing,
    power chain and final power-up.
    Power architecture fix: the battery connects only to the board rail
    (J4) and TP4057 B±; the XIAO is fed through its underside BAT pads so
    its own charge management handles USB flashing — feeding the 5V pin
    would back-feed the battery past all protection. TP4057 OUT is unused.
    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
2026-08-17 MC02: lower bosses to 6.5 so a standard 8.5mm socket + XIAO clears the cavity
    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
2026-08-17 hole-by-hole board map for the 18x24 perfboard
    Every used hole named and colour-coded by net: bus columns 8-11, XIAO
    socket cols 6/12, connectors, module pin rows. Battery rail gets its
    own colour and corner, well away from the 3V3 bus feet.
    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
2026-08-17 board clearance audit: 5 collisions found and fixed
    mc02_clearance.py models every board part as a 3D box (module PCBs on
    2.5mm spacers, XIAO slab on 8.5mm sockets, right-angle connector
    housings, bus wires) and fails on any pairwise overlap. First run
    caught MPU/MAX body overlap, MPR under the XIAO socket, and connector
    housings under module bodies. Layout reflow: MPU pins row 16 (body
    down), MAX pins row 3 (body up), MPR down one, J1 to the top edge,
    buses rows 3-15. J1-J5 are specified as right-angle headers — a
    vertical dupont housing (~14mm) would not clear the 12.9mm cavity
    headroom. Now clean; tallest stack 12.5 vs 12.9 clearance.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
2026-08-17 board layout v3: MPU vertical col 12, MAX off-board, bottom connectors gapped
    User caught header plastic butting the XIAO socket. MPU rotates
    vertical (pins col 12 rows 4-11, body right), the amp moves to the
    cavity floor beside the speaker on a 5-wire J6, and the bottom row
    packs J2 1-5 / J6 7-11 / J5 13-15 / J4 17-18 with a full empty column
    between every housing. Clearance audit clean.
    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
2026-08-17 hole map: MPR121 is the 6-pin variant (3V3 IRQ SCL SDA ADD GND)
    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
2026-08-17 hole map: MPR121 up one row (pins col 2 rows 7-12), clears J2 housing
    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
2026-08-17 fly-wire routing sheet, back-side mirrored view
    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
2026-08-17 stand_gen: display skirt for the narrow cloud footprint
    Structural audit found a 48x24mm ground footprint under ~660g at 97mm
    CoM (4-5 deg forward tipping). The stand is a pocket the ground row
    drops into with an 8mm gripping lip on a wide skirt plate.
    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
2026-09-03 firmware: auto-select XIAO ESP32S3 pin map alongside WROOM bench pins
    bench-check, bench-audio and m0-eyes pick the combo-board pin map
    (I2C0 D4/D5, I2C1 D0/D7, amp D2/D1/D3, mic D8/D9/D10) automatically
    when the IDE board is XIAO ESP32S3, keeping the WROOM breadboard map
    otherwise. No manual edits needed on flashing day.
    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
2026-09-14 landing: drop the H&R Block Artspace credit from the poster meta
    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
2026-09-27 field: tap-to-observe a spore; dye lingers and exchanges slower
    Observation mode: in the field, a short still tap on a creature opens a
    watch bench - a dashed ring marks it, the canvas draws it live and
    magnified (current dye and blink included), and an ObserveCard shows
    its name, family, time on stage, bond count and its colour story
    (exchanging with whom / holding whose tint / fading / permanent
    residue), refreshing as it changes. Tap empty ground or close to
    release. Dragging and flinging are untouched (movement or >350ms
    cancels the tap).
    Colour exchange retuned per request: ramp 6s -> 14s, and parting now
    HOLDS the borrowed tint for 20s before a 12s fade (was an immediate 3s
    fade), so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
2026-09-27 growth: spores age — a revisit days later shows a changed creature
    A friend reported her spore looked identical days after it was grown:
    generation is deterministic and all encounter tints live only in
    client memory, so the world had no visible memory. agedSpec() adds a
    deterministic growth pass derived from (id, bornAt) — no stored state,
    every visitor sees the same stage: thresholds at 2/5/10/20/40 days,
    each stage deepening the palette slightly and sprouting a few edge
    tiles away from the eye line. Field bodies re-derive their spec per
    stage, archive/feedback thumbs age too (share card keeps the birth
    look), and the observation card shows the growth stage.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
2026-09-27 mobile: decongest the phone layout
    The 390px view was unreadably crowded. Phones now get: landing huddle
    moved to the lower-right (0.62W/0.80H) and tightened so the poster
    text stays clear, with landing creatures drawn translucent; creature
    cells scaled 0.82 and the live cap 60 -> 34; separation radius 68 ->
    46 so the colony packs denser instead of sprawling; name tags only for
    your own / the observed spore (none on the landing huddle); the nav
    drops the population counter below 640px.
    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
2026-09-28 observe scene + fix: stage-breath wrapper was swallowing all canvas clicks
    New OBSERVE scene in the nav: the same living colony with no whisper
    input and no centre exclusion hole - you can watch without growing
    anything first. A quiet breathing hint invites tapping a spore; the
    watch bench (ring + live magnifier + card) works as in the field.
    DitherField gains a centerHole prop so only the field keeps the input
    clearance.
    Root-cause fix found while wiring it: the legacy .stage-breath wrapper
    (full-viewport, retained-but-empty) sat above the colony canvas with
    default pointer-events and swallowed every pointerdown - taps AND
    drag-grabs on creatures never reached the canvas anywhere. The wrap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
2026-09-28 field: remove the corner hand-gesture capture widget
    The HandLayer webcam widget leaves the bottom-right corner; the
    tracking hook stays dormant (nothing can enable it), so the pinch
    logic is inert and the layer can be re-mounted to restore it.
    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
2026-09-29 hardware: owned-filament palette; kits snap to real spools
    filaments.json records the 16 owned PLA+ spools (15 new colours + the
    existing white) with first-estimate hex values from the shop photos.
    kit_cubes now snaps every cube to the nearest owned filament in CIELAB
    (KIT_PALETTE=filaments, default), KIT_COLORS keeps the N most-used
    spools, and the manifest carries color_names so plate_gen labels each
    plate with the actual spool to load. KIT_PALETTE=kmeans restores the
    old averaged-centre quantizer. filament_swatch.py renders the palette
    card and, with --stl, a 30x14 debossed tag per spool for photographing
    and calibrating the hex values.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
2026-09-29 filaments: add owned black spool
    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
2026-09-29 filaments: add owned deep green spool
    moony's teal cap now snaps to deep green (x81) instead of washing out
    to the pale aqua.
    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
2026-09-29 filaments: add owned cream yellow and navy spools (from shelf photo)
    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
2026-09-29 seq_plates: --by-color mode; fix undefined cells reference
    One filament per plate set, each still in global assembly order with
    layer gaps, files named by spool (plate_deep-green_1.stl ...) and
    sheets titled with the filament to load. Refactored the per-page
    render into render_page().
    Also fixes a NameError: the summary line referenced cells, which no
    longer existed after seq_slots() was extracted, so earlier reruns of
    seq_plates silently failed behind a piped tail.
    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
2026-09-29 filaments: calibrate rouge snow from shelf photo; per-design spool overrides
    Rouge snow was estimated from the shop photo as a blue lilac
    (#c9b6e4, hue ~265) but the real spool is a pink lilac (#d8b8d6).
    Orchid source hues (~304 deg) sit between the owned pinks and the
    blue-leaning purples, so plain Lab snapping sent moony's lower body to
    rose/first-love pink. kit_cubes now honours <base>.filmap.json
    ({"#srchex": "spool-id"}) so a designer can pin in-between colours
    to a chosen spool.
    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
2026-09-29 assembly: support-first build order - no cube placed into thin air
    The old (layer, back-to-front, left-to-right) sequence put 33 cubes
    down with no already-placed neighbour. build_order() now seeds each
    layer with cubes resting on the layer below and grows outward one
    neighbour at a time, so every cube touches placed structure when it
    goes down. The only exceptions are true geometric islands (no support
    below and no in-layer path to one); they are returned as and
    outlined red on the assembly sheet for a geometry fix. moony_v2: 33
    orphans -> 7 (one per island group, 18 island cubes total). Layer
    sizes are unchanged, so tray numbering and layer gaps still line up.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
2026-09-29 kit: eye patch on the skin plane, zero hanging cubes, function cubes; charging dock
    Option A for moony: the 3x3 eye patch sits flat on the skin plane so
    the screen module has one mounting plane and its ribbon drops straight
    into the cavity; cubes in front of it in those columns are removed.
    Skin holes over the cavity are closed, then every hanging island gets
    the shortest hidden support chain (straight down or straight back)
    until build_order reports none. Added cubes borrow the nearest original
    colour. Neighbours of the patch now couple toward it.
    Function cubes are placed for zone builds: W (6mm ToF window) and M
    (2.5mm mic hole) on exposed skin just below the eyes; G (speaker grille)
    and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
2026-09-29 eyes: two GME12864-11 screens at the drawn eyes, framed by pocketed cubes
    The old eye patch hid ONE 0.96in module behind a 2-cell window in the
    middle of the face, while the electronics and firmware drive two
    screens (one per eye, two I2C buses). Each eye is now its own socket:
    the drawn 2x1 eye cells stay empty (the glass is the eye - the module's
    23.7x12.9 viewing area is one 2x1 eye), and the 4x3 ring around it on
    the skin plane becomes ten frame cubes sharing a 28.1x28.4x8 pocket
    from behind. Their 4mm front skin overlaps the module edge (477 of 764
    mm2), so it loads from the back and cannot fall forward; a boolean
    check shows zero module/frame interference.
    eye_frame_piece() in brick_l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
2026-09-29 pre-print audit; eye cubes may print pocket-down; seam magnets marked on sheets
    final_audit.py checks what will actually be printed: plate STLs
    watertight and on the bed, every cube on exactly one plate, flat bed
    faces, both sides of every touching pair coupling the same way,
    polarity, zero cubes placed into air, single-bond joint loads, empty
    cavity deep enough for the electronics, dock openings, and the bill of
    materials by spool and magnet size. moony_v2 v4: PASS, 0 failures,
    2 warnings (one fully enclosed cube needs its bed-side pocket reamed;
    11 pairs deliberately uncoupled at bored/pocketed faces).
    Eye frame cubes no longer refuse their pocketed rear as a bed face -
    the notch prints f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
2026-09-29 print: stand vertical-bore U/G cubes on their bored face
    Cloud-row U and G cubes printed on their flat front, turning the USB
    slot and grille holes into horizontal tunnels whose ceilings the
    slicer flagged for support (129 and 116 mm2). flat_pref() now puts
    U/G on their bored face so bores print vertical; overhang drops to the
    ~27 mm2 of ordinary magnet-pocket tops. Plate sheets use the same
    preference so polarity marks match the printed orientation.
    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
2026-09-29 print orientation: record each cube's bed face; opt-in cantilever reorient
    Every manifest cell now carries its bed face, and plates and polarity
    sheets rotate from that recorded face instead of re-deriving it, so a
    sheet can never disagree with the printed orientation. When a coupled
    (dimple-only) face ends up on the bed, the sheet marks it 底N/底S so
    its pocket is not forgotten.
    best_bed() can turn a cube whose default pose leaves a true cantilever
    (more than 40 mm2 beyond the best alternative) onto another flat or
    dimple-only face, but only with KIT_REORIENT=1. Default stays show
    face down; the four upper eye-frame cubes that cantilever are left for
    painted slicer supports instead.
    Co-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
2026-09-30 tower: field-picked spore goes live on the 7" micro screen
    On the tower field (?kiosk=field) a picked spore no longer opens the white
    observation card or the magnifier; it streams over a LAN bus to the micro
    kiosk (?kiosk=micro), which becomes its microscope with the same layout:
    - label UNDER OBSERVATION + pulsing link dot, plus one live status row
    - redrawn every frame with the field's live colour exchange and blink
    - leans and looks where it is dragged, squirms and sheds pixel motes
    while the cursor rests on it
    - released (click empty ground, 90s idle, or field silent 6s) -> back to
    the newest resident
    core/towerBus.ts talks to a loopback relay on each Pi (spore-bus.py, kept
    in the A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
2026-09-30 tower: send the observed body's own record to the micro
    A spore can outlive its entry in the colony list: the boot-time demo colony
    is replaced by the real list, but its bodies stay on stage. Looking the
    observed id up in colony then failed silently, so picking one of those on
    the tower field never reached the micro. Each body now keeps the record it
    grew from and ObserveInfo carries it.
2026-09-30 filaments: adopt the user's spool numbers; add 00 deep red; 10.5 blue as backup
    Each reel now carries the number written on it (00 deep red ... 16
    first-love pink). The shelf-photo navy is the backup 10.5 blue - kept,
    but backup spools never enter auto snapping. Cream yellow is not in the
    numbered inventory and is disabled until confirmed. 07 is renamed aqua
    green to match the reel. The manifest records color_nos, and colour
    plate files and sheets lead with the spool number
    (plate_09_serene-blue_1.stl, '09号 宁静蓝').
    moony_v2 is unaffected: same six spools, same counts, audit PASS.
    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
2026-09-30 filaments: 07 is aqua blue (typo); cream yellow confirmed not owned
    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
2026-09-30 filaments: yellow marble spool owned as cream yellow
    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
2026-09-30 filaments: number yellow marble 03.5, add pink marble 16.5; pin moony to rouge snow
    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
2026-09-30 filaments: pink marble 16.5 from spool photo (Inland, 淡粉)
    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
2026-10-01 kit_cubes: deterministic bed face for symmetric cubes
    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
2026-10-01 eye_magnet_cards: per-cube 3D magnet cards for eye frame cubes
    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
2026-10-05 hardware: MC02 carrier board v1 schematic spec + net-label drawing
    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
2026-10-05 schematic v1: XIAO surface-mounted on castellations, BAT pads via plated holes
    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
2026-10-05 schematic v1: factory places caps and SH connectors, modules hand-soldered
    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
2026-10-05 touch_plan: anatomy-based touch electrode placement + hidden wire routing for any creature
    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
2026-10-05 pcb: MC03-F face board v1 - generated, autorouted, DRC-clean, JLCPCB gerbers/BOM/CPL
    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
    [facebrd.kicad_pcb, facebrd_bom.csv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]
2026-10-05 pcb: MC03-F re-layout by XIAO pin side, back-side GND plane only; fixed W/M cells for all creatures
    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
    [facebrd.kicad_pcb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]
2026-10-05 mc02 backplane: 14.5 mm bosses for the MC03-F face board (board in front, battery behind)
    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
2026-10-05 touch cubes: two-piece touch/wire-channel cubes, reprint plates per colour, assembly guide
    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
2026-10-05 pcb: JLCPCB order-number placeholder on the back silkscreen
    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
    [facebrd.kicad_pcb]
2026-10-05 pcb: XIAO is hand-soldered (not stocked at JLCPCB; C48405120 was the nRF52840 Plus)
    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
    [facebrd_bom.csv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]
2026-10-05 figurine: scaled figurines and flat-back earrings from a spore's voxels, per-filament parts for AMS
    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
2026-10-05 figurine: pixel-plate charms (front mosaic, eyes, loop) and smoothed figurines; colours by column
    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
2026-10-05 figurine: mortise-and-tenon colour inlays (pockets in the plate, press-fit colour pieces), 0.24 relief, pieces preview
    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
2026-10-05 figurine: hanging ring outside the plate on a neck, clear of inlay pockets
    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
2026-10-05 pcb: export the board outline (Edge.Cuts, was silently skipped); BOM carries the chosen LCSC parts
    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
    [facebrd.kicad_pcb, facebrd_bom.csv]
2026-10-06 pcb: correct MPR121 footprint (QFN-20 3x3 0.5 mm, 5 leads/side, no corner leads); local GND pour at U2
    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
    [facebrd.kicad_pcb, facebrd_bom.csv]
2026-10-06 pcb: MPR121 pin map corrected against datasheet/KiCad symbol (7 REXT, 8-19 ELE, 20 VDD); MPU RESV pins NC; EP without paste
    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
    [facebrd.kicad_pcb]
2026-10-06 docs: MPR121 electrode pins 8-19
    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
2026-10-06 tray_sheet: magnet polarity sheet laid out like the storage trays
    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
2026-10-07 assembly_guide: one page per layer with alignment ghost, orientation rule, special-cube marks
    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
2026-10-07 assembly_guide: magnet pockets and poles per cube in the creature frame
    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
2026-10-07 kit: printed cubes are the mirror of the web spore - guide drawn from behind, mic cell mirrored to match the face board
    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
2026-10-07 assembly_guide: shorter footer
    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
2026-10-07 back door MC04-D: mosaic panel filling the cavity opening, 8 anchor cubes with couplings, board standoffs inside; replaces the MC02-P plate
    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
2026-10-07 door: tiles print flat; guide shows the door; docs
    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
2026-10-07 pcb: MPR121 on KiCad's own UQFN-20 3x3 0.4 mm footprint (no EP); 0.2 mm tracks / 0.13 clearance to escape it
    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
    [facebrd.kicad_pcb, facebrd_bom.csv]
2026-10-08 door: magnets only (no pins) so it slides in; anchor cubes D/B shave the pin on the door face
    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
2026-10-10 glue_plan: glued skeleton + detachable outer head cubes (each held by >=2 skeleton magnets)
    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
2026-10-11 ground_gen: mosaic ground base layout for the moving spore
    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
2026-10-11 fit_check: 1 mm occupancy fit of every part in the moving Moony Moth + mosaic ground, overall render
    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
2026-10-17 bench-check: print the real GPIOs, board type and a pull-up solder-joint self-test per I2C line
    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
2026-10-17 bring-up handoff: MC03-F status, pin map, current bus-0 issue and next steps for the local session
    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
2026-10-17 handoff: full 14-joint XIAO continuity table
    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
2026-10-17 handoff: SCL0-to-GND short and how to locate it
    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
2026-10-17 handoff: section 3 passed; eye screen + ToF wiring for section 4
    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
2026-10-17 guide: beginner wiring card for the two OLED eyes on the EYES connector
    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
2026-10-20 halloween: pixel costumes (pumpkin / witch / ghost / lantern) as a post-pass + ?costumes preview sheet
    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
2026-10-20 halloween: shorter pumpkin and witch hat; ghost sheet follows the spore silhouette
    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
2026-10-20 halloween: bigger pumpkin and witch hat that cover the whole cap
    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
2026-10-20 halloween: drop lantern eyes; keep pumpkin, witch and ghost
    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
2026-10-20 halloween: spells, trick-or-treat candy, night scale, landing pumpkin, share card frame
    - costumes only Oct 24-Nov 1 (or ?season=halloween); ~1 in 40 spores, fixed per id
    - a costume word in the whisper (pumpkin/ghost/witch, 南瓜/鬼/巫...) dresses the new spore
    - tap a costumed spore: it shakes and tosses a candy to the loneliest spore, which glows
    - A-minor ambient walk and a lower spawn pluck; pixel pumpkin + hint on the landing
    - share card: orange/purple pixel border, candies and a HALLOWEEN 2026 stamp
    - costume rides along to the tower micro screen; ?hwrate=N previews a denser field
    Claude-Session: https://claude.ai/code/sessi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
2026-10-22 touch: reprint set for all 10 touch points on the current (v9 + door) kit, 38 pieces; J7 wiring table
    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
2026-10-22 touch: 1.0×2.4 mm wire channels (four 0.58 mm wire-wrap stack), Ø1.4 ports, shallow touch-cube slots; regenerated 38-piece set
    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
2026-10-22 touch: one wire per bored cube (--one-per-cube), channels sized for 1.1 mm PVC hook-up wire; 44-piece set
    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
2026-10-23 touch: add nose tip (E10) and back of head (E11) so all 12 MPR121 channels are used; 49-piece reprint set, J7 table with wire colours and cut lengths
    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
2026-10-23 touch: deep-green add-on plate with only the new back-of-head piece (236 Tbody + Tlid)
    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
2026-10-23 touch: refresh zip with the deep-green add-on plate
    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
2026-10-23 guide: J7 touch wiring card (pad ↔ wire colour, tape bands, touch point, cut length)
    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
2026-10-23 moony: 't' serial key — live 12-channel touch monitor (signal per electrode + which pads are touched)
    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
2026-10-26 moony: creature voice (voice no. 4) — every sound is synthesised live: gliding pitch, 7 harmonics, vibrato, flutter, breath; new listen/think/startle/grumpy/dizzy sounds; 'v' auditions all
    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
2026-10-26 moony: switch to voice no. 1 (seed 3, rounder, ~350 Hz)
    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
2026-10-26 guide: per-wire route card — touch cube and wire cubes (assembly numbers, layer) for each J7 pad
    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
2026-10-26 touch: step-by-step threading order per wire (穿线步骤.md)
    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
2026-10-26 guide: piece-ID cards per colour (bed face + top face, engraved code, height, wire) for loose reprint pieces
    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
2026-10-26 moony: touch through the 1.2 mm lid — threshold 6/3 (TOUCH_TH) and MPR121 auto-config per electrode
    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
2026-10-26 moony: slow the MPR121 falling baseline filter so a weak touch through the lid isn't tracked away
    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
2026-10-26 moony: MPR121 auto-config once, no auto-reconfigure (ARE off, LSL 100) — reconfig was resetting the baseline on every touch
    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
2026-10-26 moony: touch — fixed charge (no auto-config, it failed on the long leads), 2-sample debounce, full 10-bit baseline, re-take baselines 6 s after power-up and after a 20 s stuck touch
    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
2026-10-26 moony: stuck-touch re-calibration after 10 s (was 20)
    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
2026-10-26 guide: per-wire cards (chain of pieces from J7 to the touch cube with colour, number, engraved code, bed-face picture, in/out faces, location and steps) + all-in-one PDF
    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
2026-10-26 guide: three views + 3D per touch wire — its cubes in place among their neighbours, with the wire path
    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
2026-10-26 touch: wire cubes meet the touch cube's port — every touch↔wire joint was misaligned (up to 7 mm, a blank wall at the joint); 11 changed halves as add-on plates, pair exploded view, refreshed ID and 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
2026-10-26 guide: 55/62 joint face map (openings on both faces, overlaid)
    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
2026-10-26 touch: full reprint of every non-touch piece (all wire-cube halves + modified cubes), 27 pieces in 5 colours; drop the partial add-on plates
    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
2026-10-26 guide: exploded wiring views for every touch wire (real meshes, wire threaded through grooves/holes/slots), one page per wire + PDF
    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
2026-10-27 touch: E6 redo plate (54LA/LB + 56Tbody/Tlid)
    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
2026-10-27 guide: per-wire layer assembly pages (plan view of each layer the wire passes, wire cubes outlined, wire drawn, ↑↓ between layers)
    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
2026-10-27 touch: rouge-snow touch-cube reprint plate (56, 70)
    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
2026-10-27 touch: deep-green 308 reprint plate
    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
2026-10-27 moony: mute a touch pad that flickers by itself (>5 presses in 4 s → 60 s), debounce re-presses within 250 ms
    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
2026-10-27 moony: stop the da-da-da after every sound — I2S tx_desc_auto_clear, flush all DMA buffers when a tune ends
    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
2026-10-27 guide: Moony build + wiring manual — cover, one page per layer with every wire drawn in and per-layer steps/tests, closing page
    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
2026-10-27 guide: sorting sheet — identify loose cubes by colour + engraved code, with counts, features and where each goes
    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
2026-10-27 guide: build manual shows each cube's engraving as the big label (assembly number small), plus a per-layer pick list by colour + engraving
    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
2026-10-27 print: lavender 34 cube (spare)
    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
2026-10-28 door: standoffs 5 mm shorter (door_gen post_trim arg) — the board-front modules stand taller than the XIAO USB-C
    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
2026-10-28 door: 'flush' mode — board sits on the door rim (standoffs end inside the box), M2 screws from the outer face, heads sunk under mosaic inlays (adds lavender inlays where needed)
    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
2026-10-28 door: 'holes' mode — no standoffs, four counterbored M2 through-holes under mosaic inlays
    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
2026-10-28 print: serene-blue 3E and 18 cubes (spares)
    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
2026-10-28 print: serene-blue R00 eye-frame cube + its picture
    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
2026-10-28 print: serene-blue L31 and R01 eye-frame cubes + pictures
    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
2026-10-28 print: deep-green 25 cube + picture
    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
2026-10-28 moony: mosaic eyes like the website spores — two white cells, a one-cell pupil sliding with the gaze, straight lids (EYE_MOSAIC 0 restores the round eyes)
    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
2026-10-28 print: deep-green 34 cube + picture
    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
2026-10-28 moony: more play — clap back (2–4 claps → same number of chirps), peekaboo on the ToF window, says hello to a lingering visitor, enjoys being rocked, melts after five head pats
    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
2026-10-28 pod: back pod replacing the door (24 mm deeper, down to the base, board 12 mm lower so a USB-C plug fits above the XIAO, cable slot in the back) + base plate holding the body and the pod
    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
2026-10-28 pod: one-piece pod + base (pod to the floor, flat plate forward under the body with side rails, speaker hole) — door_gen 'podbase'
    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
2026-10-28 station: one-piece rest station — mosaic-forest base (robot + 2 cubes each side) with a pocket for the floor cubes and a speaker hole, back plate in the free layer behind the body up to the cap, boar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
2026-10-28 station: base raised to a full cube with the floor layer's 8 cubes sunk into pockets, forest rising round the dip; back plate exactly one cube thick, stepping down to the sides as a pixel hill with m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
2026-10-29 station: full 12 mm pit for the 8 floor cubes with solid walls (0.15 mm per side, grooves only 0.6 deep), second layer resting flat on the base; fit measured on the mesh (wall rays, floor, second-lay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
2026-10-29 station: cubes only — mushrooms and grass replaced by whole 12 mm cubes stacked 0-2 high round the dip, a few 6/8 mm cubes on top and on the plate steps
    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
2026-10-29 station: the 8 floor-cube positions cut right through — no floor under them, they stand on the table; base exactly one cube tall, speaker hole/channel no longer needed
    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
2026-10-29 station: irregular cube outline (robot shadow + wobbling 0-2 cube rim, side-connected), back plate replaced by a plain one-cube-thick U (two posts up to the cap + bottom bar, open middle) with the bo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
2026-10-29 station: U seen from above — back wall two cubes either side of the door hole (open in the middle for the board) plus one-cube arms running two cubes forward along both sides of the body, as high as 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
2026-10-29 station: back of the U closed again — the extra layer hides the board in a pocket open only toward the body and at the top (USB-C), blind M2 bosses from the pocket floor
    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
2026-10-29 station: back layer exactly the body's width (84 mm), U arms thin 3 mm walls (90.6 mm overall), board held by 4 M2 through holes in the back instead of posts
    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
2026-10-29 station: U arms stop 0.3 mm short of the cube in front (were flush with (3,6,7)); generator now ray-checks every exposed robot face (only downward faces may touch) and sweeps the drop-in with FIT cle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
2026-10-29 station: board pocket runs down to the base (no ledge under it), no cubes stacked against the back; robot-vs-station comparison sheet
    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
2026-10-29 station: drop the side arms — back layer ends flush with the body sides (84 mm wide)
    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
2026-10-29 station: base and back plate printed separately — plate tongue (8 mm) drops into a slot in the base, 0.2 mm play on the sides/front/bottom and 1.2 mm at the back to adjust; exports verified watertigh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
2026-10-29 print: deep-green 31 cube + picture
    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
2026-10-29 print: deep-green 23 and 14 cubes + pictures
    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
2026-10-29 print: deep-green 11 cube + picture
    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
2026-10-29 moony: stop eye flutter from a wavering ToF reading — hysteresis on presence (+100 mm to leave) and on peekaboo (<50 mm for 150 ms to cover, >90 mm for 100 ms to uncover), covered eyes reopen after 8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
2026-10-29 moony: if the ToF only ever sees the W window's wall (background < 120 mm at calibration), ignore it — no presence, no peekaboo, calm eyes; 'c' re-tests
    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
2026-10-29 moony: more interaction — repeated touches escalate (3 boops → sneeze, 3 cheek strokes → hides, 4 forehead pokes → cross), hand on the head purrs when there is no Wi-Fi (hold-to-talk only with Wi-Fi)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
2026-10-29 feedback: export script — reads the Upstash list (read-only) and writes feedback.csv (Excel-safe UTF-8), feedback.json and an A4 print page (one card per entry, scale dots, averages); exports stay ou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
2026-10-29 feedback: password-locked export on the site — /api/feedback-export?key=… serves the A4 print page (print / CSV / JSON buttons) straight from the deployment's Upstash; FEEDBACK_EXPORT_KEY unset = 404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
2026-10-29 market: printable paper version of the study questionnaire (A4, two sides, bilingual) — same prompt, scales, optional items and support notice as the site; form number + tear-off slip stands in for t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
2026-10-30 market: booth guide sign — have a seat, type a whisper or scan the QR, watch your spore meet the others, notice what shifts, take a small gift (A4, English first, small Chinese)
    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
2026-10-30 field: '+ new whisper' button after a whisper brings the input back for the next person (releases the current spore first), and the field resets itself after 2 quiet minutes — no reload needed at a s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
2026-10-30 field: spores in different sizes — a stable per-spore factor (0.75–1.35×) for every creature in the field, and new whispers grow bigger with stronger feeling
    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
2026-10-30 field: wider spread of spore sizes on the main field (0.55–1.85×, mostly small-to-medium, a few big)
    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
2026-11-09 portfolio: print-ready A4 PDFs (EN 10 pp, ZH 9 pp) built from the site's portfolio pages — cream edge to edge, headings kept with their content, cards never split, live demo grown once, links point a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
2026-11-10 privacy: 低语原文不再被存储、返回或写进分享链接 (#82)
    * privacy: the whispered sentence is never stored, served or linked — only the grown shape survives
    The site promises that nobody, the author included, can read a whisper; only
    the shape it grew into is kept. The code didn't hold that promise: the client
    posted `text` with every creature, Upstash kept it, GET /api/creatures served
    it to anyone, and the ?s= share token carried it too. This closes all four:
    - POST /api/creatures keeps an allow-list only (emotion labels, morphology,
    name, specimen number, time, position); `text` and anything else is dropped
    before the write. The client strips it before the request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
2026-11-14 field: mother trees actually happen — age was performance.now() minus an epoch bornAt (never true), now on-stage time or born >1 day ago; support bonds no longer cut by the 205 px disconnect radius (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
2026-11-14 pages: contact-point dyeing, mother tree and permanent hybridisation now play as video (webm + mp4, poster) on the case, portfolio and board pages instead of the 520px GIFs
    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
